justr0st/TempCtl-Duo/claude/tempctl-duo-spec.md

# TempCtl Duo — specification and working notes

Status: 2026-09-28 (third revision — all design decisions made). The first revision was written at the
end of the conversation that built TempCtl 1.2. Revisions 2–3 add everything agreed with Rost in a
claude.ai chat: the Duo goals and program model (9), the hardware — ESP32-S3 + 4.0" ST7796 as main
target and the CYD as second device (2, 2a, 2b), colours (6), the Web-GUI based on the 9.3 simulator
(7, `claude/web-sim/`), serial console (7a) and the Web Serial page / local app (7b). Every open point
was decided one by one; what is left is only for later (GitHub Pages — replaced by Cloudflare, 7b / 9.13 —,
SD logging, "Convert to Timeline") and hardware checks during bring-up (9.10).
2026-09-30: **steps 1–4 of 9.10 implemented** (S3 bring-up, per-board headers, three CYD variants,
identity; channel interface, two Modbus channels on one bus, `/duo/settings.json`; local channels
with thermocouple, SSR, PID and safety; autotune). All four envs compile and link in the cloud container.
Commits (Rost pushes): `7c34d2e` 1.0.0 = steps 1–3, then 1.0.1 = step 4. State: 9.10.1–9.10.4. **The 4" display
and the PMA controller are still being delivered** (Rost): their checks are deferred until each part
arrives; meanwhile test what the bare S3 board and the CYD allow. Next: step 5 (program types
Sequence + Timeline, one run engine for both channels).

Read this file first, then `README.md` (TempCtl hardware, wiring, PMA register background, build, web
API) and `ui/README.md`. Sections 3–8 describe the **TempCtl 1.2 code base that Duo starts from**; the
parts that change for Duo are marked "Duo:".

## 0. Isolation rules (read first)

TempCtl Duo is a copy of TempCtl (made 2026-09-28 from TempCtl commit `47995c9`, first own commit
`7c15cd0` "Start TempCtl Duo as a copy of TempCtl"). The original must stay untouched.

| | TempCtl (original — do not touch) | TempCtl Duo (work here) |
|---|---|---|
| Local clone on Rost's PC | `D:\Share\GitHub\TempCtl` | `D:\Share\GitHub\TempCtl-Duo` |
| In the Cowork device VM | `$HOME/mnt/Share/GitHub/TempCtl` | `$HOME/mnt/Share/GitHub/TempCtl-Duo` |
| GitHub | `justr0st/TempCtl` | `justr0st/TempCtl-Duo` (origin is set; Rost creates the empty repo and pushes) |
| Claude project notes | `claude/tempctl-firmware-notes.md` (original's history) | this file (+ copy `claude/tempctl-duo-spec.md` in the project) |

- Only read, edit, build-check and commit inside `TempCtl-Duo`. Never write to `TempCtl`, never commit
  there, never change its remote.
- Before any file transfer, check the target path contains `TempCtl-Duo`.
- Temporary transfer archives go to `D:\Share\claude-xfer-duo-*.tgz` and are deleted afterwards.
- Firmware name/version: `src/config.h` still says `FW_VERSION "1.2.0"` and the device calls itself
  "TempCtl" (web page title, AP name `TempCtl-XXXX`, host name `tempctl`). **Identity and versioning
  are decided (9.8)**: "TempCtl Duo", host `tempctl-duo`, AP `TempCtl-Duo-XXXX`, version starts at
  **1.0.0** and the patch number goes up with every commit that is pushed.

## 1. Working with Rost (user preferences and environment)

- User: Rost (GitHub `justr0st`, commit email `50486502+justr0st@users.noreply.github.com`).
- Answers short and direct; Rost usually tests on hardware and reports back ("works", a log, a photo).
- Ask before large design decisions (AskUserQuestion); otherwise make the reasonable choice and say so.
- Commit only when Rost asks. Commit messages: mention only the most significant changes. Leave
  `.vscode/settings.json` (his local editor settings) out unless he says otherwise. Rost pushes.
- This document (`claude/tempctl-duo-spec.md` in the repo) is the source of truth, updated with every commit
  (`docs/SPEC.md` only points to it). The claude.ai project copy is no longer updated (since 2026-11-02).
  Old untracked files go to `.old/` (ignored).
- Rost runs the LVGL Pro Editor and the GitHub side (secrets, Pages settings) himself.

### Tools and file handling (since 2026-11-02: Claude Code on Rost's PC)
Until 1.0.66 Claude worked from claude.ai through the Cowork device VM and a cloud container (file transfer
by tgz, `GIT_OPTIONAL_LOCKS=0`, no serial port, no `pio`). Since 2026-11-02 Claude Code runs directly on
Rost's Windows PC in the clone `D:\Share\GitHub\TempCtl-Duo`; the project instructions are in `CLAUDE.md`.
- Files are edited in place; `.gitattributes` (1.0.29) stores LF and checks out CRLF — no conversions.
- Firmware: PlatformIO on Windows (`pio run -e <env>`, section 8). Linux-only tools run in WSL (Debian).
- Serial ports on Rost's PC: S3 "UART" port (flash + log) COM4, S3 native "USB" port (serial console, `api`
  mode) COM9, CYD COM11 (`upload_port` / `monitor_port` in `platformio.ini`). **Flashing and the log monitor go
  through the board's USB port labelled "UART"** (USB-to-UART bridge → UART0). Claude may flash
  (`pio run -e <env> -t upload`) after asking Rost each time (Rost, 2026-11-02).
- Reading a log: not the interactive monitor, but a short pyserial script (PlatformIO's `penv`) with a time
  limit, port opened with DTR and RTS off (no CYD reset). Rost's monitor has `esp32_exception_decoder`;
  a backtrace from a script: `xtensa-*-elf-addr2line -pfiaC -e .pio/build/<env>/firmware.elf <addresses>`
  (the ELF must be the flashed build).
- The in-app browser may be used for web pages (design references, datasheets, the release page).

## 2. What the device is

TempCtl (the original) runs on an ESP32-2432S028R "Cheap Yellow Display" (ESP32, ILI9341 320×240,
XPT2046 resistive touch, RS485 on UART2 RX 35 / TX 22 / DE+RE 27). **Duo supports two boards**
(Rost, 2026-09-28): the new **ESP32-S3 board (main target)** below, and the **CYD as a second supported
device** (section 2b). Main target:

| Part | Duo hardware |
|---|---|
| MCU board | **ESP32-S3-DevKitC-1 v1.0, N16R8** (ESP32-S3-WROOM-1-N16R8: 16 MB quad flash, 8 MB octal PSRAM). v1.0 = on-board WS2812 on **GPIO48** (v1.1 has it on GPIO38). Rost believes his board is v1.0; **work on the assumption WS2812 = GPIO48** until he has tested it with `neopixelWrite(48, 0, 0, 40)` (blue = v1.0). |
| Display | **4.0" capacitive SPI module MSP4031** (lcdwiki "4.0inch Capacitive SPI Module ST7796"): ST7796S, 320×480 (used as 480×320 landscape, confirmed), 4-wire SPI, on-board level shifters (3.3 V logic OK), VCC 5 V recommended (backlight ≈ 103 mA), micro-SD slot on the same SPI bus, 14-pin header. |
| Touch | **FT6336U** capacitive controller on the display module, I²C (address 0x38), with CTP_RST and CTP_INT. |
| Bus | RS485 transceiver on UART1, **3.3 V part** (MAX3485 / SP3485); a 5 V MAX485 module would put 5 V on the RX pin. |
| Local channels | Thermocouple amplifiers **MAX31855** (preferred: fault bits, cold-junction readout) **or MAX6675** (selectable per channel), SSRs driven from GPIO through an NPN/logic MOSFET from 5 V. |

- Duo controls **two heaters of a BGA rework station: bottom (preheater underneath) and top**.
- Each channel is either a **Modbus RTU controller** (PMA KS 40-1 / 41-1 / 42-1 or generic register map;
  the controller does the PID, the ESP32 is the ramp/soak programmer) or a **local channel**
  (thermocouple + SSR, PID on the ESP32). See 9.
- Touch UI (LVGL 9.6) and a web UI (JSON API) with the same functions ("full parity").
- Example program for the BGA use case: "GPU desolder (LeadFree)" — 160 °C (ramp 60 s, hold 30 s),
  190 °C (40/40), 225 °C (30/20), 245 °C (20/40), total 4:40 (`programExample()` in
  `src/program_store.cpp`). Duo: three two-channel examples (9.9).

## 2a. Pinout (ESP32-S3-DevKitC-1 v1.0 N16R8) — agreed 2026-09-28

Unusable / kept free:
- **GPIO 35, 36, 37**: used by the octal PSRAM on N16R8 (not available).
- **GPIO 19 / 20** (native USB D−/D+ — the **control port**, 7a/7b) and **43 / 44** (UART0,
  USB-to-UART bridge port — flashing and log): kept free so
  **both USB ports stay usable** (Rost's requirement).
- **Strapping pins 0, 45, 46**: not used (GPIO45 high at boot selects 1.8 V flash voltage). GPIO 3 (strap
  only for the JTAG source when an eFuse selects it, not on these modules) is the monitor channel's CS
  since 1.0.60 (9.15).
- GPIO 26–32: flash/PSRAM, not on the headers.

| Function | GPIO | Header | Notes |
|---|---|---|---|
| Display SCK | 12 | J1 | FSPI IO_MUX pins (10–13) → high SPI clock possible |
| Display SDI (MOSI) | 11 | J1 | |
| Display SDO (MISO) | 13 | J1 | shared with the SD card |
| LCD_CS | 10 | J1 | |
| LCD_RS (D/C) | 9 | J1 | |
| LCD_RST | 14 | J1 | |
| LED (backlight) | 8 | J1 | LEDC PWM, dimming |
| SD_CS | 18 | J1 | driven high (card deselected); SD use optional (logs) |
| CTP_SDA | 16 | J1 | I²C 400 kHz |
| CTP_SCL | 15 | J1 | |
| CTP_RST | 17 | J1 | |
| CTP_INT | 7 | J1 | optional (skip I²C reads when not touched) |
| RS485 TX → DI | 1 | J3 | UART1 |
| RS485 RX ← RO | 2 | J3 | |
| RS485 DE + /RE | 42 | J3 | |
| Thermocouple SCK | 41 | J3 | own slow SPI bus (not the display bus) |
| Thermocouple SO (MISO) | 40 | J3 | |
| TC CS bottom | 39 | J3 | 10 kΩ pull-up |
| TC CS top | 38 | J3 | 10 kΩ pull-up; **on a v1.1 board swap 38 ↔ 48** |
| SSR bottom | 21 | J3 | 10 kΩ pull-down (off during reset/flash) |
| SSR top | 47 | J3 | 10 kΩ pull-down |
| Status LED (on-board WS2812) | 48 | — | status colours, see below |
| SSR supply relay | 4 | J1 | +5 V common of both SSR inputs; active-high DC SSR driven directly (1.0.38) |
| E-stop input | 5 | J1 | NC contact to GND, internal pull-up; `safety.estop`, off by default (1.0.38) |
| Alarm buzzer | 6 | J1 | LEDC channel 6, 2.7 kHz; `safety.sound` (1.0.38) |
| TC CS monitor channel | 3 | J1-13 | optional third converter, 10 kΩ pull-up; measured only (1.0.60, 9.15) |

**Status LED (decided)**: green = idle · blue = running · amber blinking = waiting for bottom / program
pause / action required · red blinking = fault · purple = AP mode. Priority when several apply: fault >
amber > purple > blue > green. Low brightness (≈ 20 %). **CYD: the on-board RGB LED (external WS2812 on IO17 in `cyd-2xlocal-2x485`) with the same
colours** (Rost, 2026-09-29; replaces "blue LED only"): PWM on LEDC channels 1–3, active low.

Wiring picture: `claude/wiring/s3-wiring.png` (2026-09-30; display pins drawn in J1 order, VCC on 5 V;
1.0.38: relay / E-stop / buzzer on J1-4/5/6 as net labels, SSR "+" inputs on "5V relay"). Generator:
`/home/claude/wire/gen_s3.py` (cloud only; render with `node shot.js <svg>`).
**SSR supply relay (decided 2026-10-13, Rost): only an active-high DC solid-state relay driven directly by
GPIO4** (input + = GPIO4, − = GND; output 5 V → OUT+, OUT− → both SSR "+" inputs; input ≤ 20 mA at 3.3 V,
output ≥ 0.5 A DC). No relay modules, no level setting, no optional (DNP) parts: the relay-variant sheet
`s3-relay-wiring.png`, `relay.activeLow` (settings, touch, serial, web) and the RGND / E-stop RC options
were removed. GPIO4 is an output, low, from `localCtrlEarlyInit()`.
Setting `safety.relay` (decided 2026-10-13, Rost; default on): a switch in web Settings › Safety (the note
block on the Channels page was removed), touch System, serial `safety.relay`. Off = no relay fitted: GPIO4
stays low, no relay state in live / info, no "SSR supply relay off" events (`localCtrlRelayEnable`,
`localCtrlRelayUsed`).
Schematic (2026-10-13): `hardware/s3-schematic/` — KiCad 7 project (A3, one sheet: DevKitC-1 with J1/J3 pin
numbers, display, RS485 + PMA terminals (RGND not connected), 2 × MAX31855 + CS pull-ups, 2 × BC337 SSR
drivers + SSRs, K1 DC SSR supply relay, E-stop SW1, buzzer BZ1 with R7 100 Ω), net labels between the
blocks, PDF / PNG. Written by a Python generator (`hardware/gen/`: no KiCad in the cloud — hand-written KiCad 7
file format, checked by reading it back with `verify.py`; ERC to be run in KiCad by Rost).
CYD schematics (2026-10-13): `hardware/cyd-schematic/` — one KiCad project per env (`TempCtl-Duo-CYD-A/B/C`
= `cyd-1xlocal-1x485` / `cyd-2xlocal` / `cyd-2xlocal-2x485`), same generator (`hardware/gen/make.py`). The
CYD is one symbol with its connectors (pin numbers P3-n, CN1-n, SD-n via the micro-SD breakout, P4-n, P1-n,
LED-R/G/B pads on C); RS485 + PMA (A, C), MAX31855s (C: 10 k pull-up on the IO4 CS), BC337 SSR drivers, SSR
+ inputs on 5 V from P1-1 VIN, speaker LS1 on P4 (all), WS2812 status LED on IO17 from 3V3 (C). No E-stop,
no supply relay. The CYD wiring pictures show the P4 speaker too.
Display on J1, all process I/O on J3 (separate cable bundles). All pins become `#define`s in the
per-board header (`src/board_s3.h`, section 3) — one place to change for a v1.1 board or a different
wiring.

## 2b. Second supported device: CYD (ESP32-2432S028R) — agreed 2026-09-28

The CYD stays supported with the same firmware features (two channels, both program types, web GUI),
built from the same sources with its own envs `cyd-1xlocal-1x485` / `cyd-2xlocal` / `cyd-2xlocal-2x485` (below).

- ESP32 (no PSRAM, 4 MB flash, ≈ 520 kB SRAM), ILI9341 **320×240**, XPT2046 **resistive** touch, RGB
  LED (active low: R 4, G 16, B 17), backlight GPIO21, SD slot on VSPI (CS 5, SCK 18, MISO 19,
  MOSI 23), RS485 unchanged: RX 35, TX 22, DE/RE 27 (UART2).
- **Free GPIOs** (checked 2026-09-29 against the schematic ESP32-2432S028 V0.1 and the
  randomnerdtutorials CYD pinout): connectors P3 = GND, IO35 (input only), IO22, IO21 (backlight, not
  usable); CN1 = GND, IO22, IO27 (10 k pull-up R18), 3V3 (IO22 on CN1 pin 3 is missing in schematic
  V0.1 but present on the board — checked by Rost); P1 = VIN, IO1/IO3 (UART0, shared with the
  CH340). **IO6–IO11 are not usable**: they are the WROOM-32 module's internal SPI flash; the empty U4
  footprint on the CYD is only an optional second flash chip on the same lines. **Only IO22, IO27, IO35 are free on connectors — RS485 uses all three.** Taken: IO0 BOOT
  button, IO4/16/17 RGB LED (status), IO26 speaker amplifier (SC8002B, P4), IO34 LDR, display
  2/12/13/14/15 (LCD reset = EN), touch 25/32/33/36/39, IO21 backlight (AO3402, pull-down). The SD slot
  pins IO5/18/19/23 are free (SD not used), reachable with a micro-SD breakout ("sniffer") adapter;
  they have 10 k pull-ups (R13, RN2) except IO18 (CLK) per the schematic — to be measured.
- **Three CYD variants, one env each (decided by Rost, 2026-09-29)** — the RGB LED is the status LED,
  so the old SSR pins 4/16 are gone, and there are too few pins for RS485 + two local channels.
  Pins fixed at compile time in `board_cyd.h` (`-D CYD_1XLOCAL_1X485` / `-D CYD_2XLOCAL` /
  `-D CYD_2XLOCAL_2X485`, with
  `HAS_RS485`, `LOCAL_CHANNELS_MAX`, `BOARD_VARIANT`); pictures `claude/wiring/cyd-wiring-a.png` / `-b.png` / `-c.png`:

  | Env | Channels | Pins |
  |---|---|---|
  | `cyd-1xlocal-1x485` (wiring A, Rost's preferred) | RS485 (one or two Modbus controllers on the bus) + **one** local channel, bottom or top | RS485 TX 22 (P3-2), RX 35 (P3-3), DE+/RE 27 (CN1-2); TC SCK 23, SO 19, CS 5 (`PIN_TC_CS_LOCAL`); SSR 18 (`PIN_SSR_LOCAL`) — SD slot pins |
  | `cyd-2xlocal` (wiring B) | two local channels, **no RS485** (Modbus not selectable) | TC SCK 23, SO 19; bottom CS 5 / SSR 18 (SD slot); top CS 27 (CN1-2) / SSR 22 (P3-2); IO35 free (input) |
  | `cyd-2xlocal-2x485` (wiring C, added 2026-09-29) | RS485 + two local channels — every channel local or Modbus. **On-board RGB LED removed** (frees IO4/16/17) | RS485 as in wiring A; TC SCK 23, SO 19; bottom CS 5 / SSR 18; top CS 4 (LED pad R, **external 10 k pull-up**, floating at boot) / SSR 16 (LED pad G); **status LED = external WS2812 on IO17** (LED pad B, powered from 3V3 so the 3.3 V data level is in spec) |

  SD slot pins through a micro-SD breakout adapter, no card inserted. IO18 has no pull-up (SSR off at
  boot); IO5/IO23/IO19 have 10 k pull-ups (fine for CS / SCK / SO); IO27's pull-up keeps CS high.
  Settings (step 2/3) must refuse channel types the variant can't wire (more local channels than
  `LOCAL_CHANNELS_MAX`, Modbus without `HAS_RS485`). The step-1 firmware of `cyd-2xlocal` still has the
  single-channel Modbus code: without RS485 every request fails at once ("no answer", LED red).
- Limits to respect: no PSRAM → chart history, web page buffers and LVGL buffers must fit in internal
  RAM (TempCtl 1.2 left 97 kB free with one channel; measure after adding the second channel);
  `huge_app.csv` (3 MB app) — the web page and fonts must fit next to the firmware.
- Touch UI: its **own set of 320×240 screens** next to the 480×320 set (see 6).

## 3. Build and toolchain

TempCtl 1.2 (current state of the Duo repo):
- PlatformIO, `espressif32@6.9.0` (Arduino-ESP32 2.0.17), board `esp32dev`, `huge_app.csv`
  partitions, env `cyd`.
- Libraries: `lvgl/lvgl@9.6.0`, `symlink://ui` (the exported UI code as a library, `ui/library.json`),
  TFT_eSPI 2.5.43 (configured by build flags), XPT2046_Touchscreen (git), ArduinoJson 7.
- Build flags: `-D LV_CONF_INCLUDE_SIMPLE -D LV_LVGL_H_INCLUDE_SIMPLE -I include`,
  `-D DISABLE_ALL_LIBRARY_WARNINGS=1` (TFT_eSPI TOUCH_CS warning), TFT pins/frequencies.
- `include/lv_conf.h`: from the LVGL 9.6 template; CLIB malloc/string/sprintf, 30 ms refresh,
  `LV_USE_OBJ_NAME`, `LV_USE_TRANSLATION`, printf log, dark default theme without grow, Montserrat
  12 + 14, asserts on with `include/lv_assert_custom.h` (`LV_ASSERT_HANDLER abort();` instead of
  LVGL's silent `while(1)`).
- `src/main.cpp`: loop task stack 16 kB on both boards since 1.0.55 (S3 was 24; `SET_LOOP_TASK_STACK_SIZE`), after setup
  `esp_task_wdt_init(15, true)` + `enableLoopWDT()` (a stuck loop restarts the board with a backtrace;
  the longest intended wait in the loop is a 5 s bus request from the touch UI).
- Measured on the CYD (1.2 on LVGL 9.6): flash ≈ 1.36 MB (before the web redesign, which
  added ≈ 17 kB); free heap 249 kB before UI, 158 kB after UI,
  97 kB after net/web/control (largest block 51 kB); loop stack ≈ 3 kB used in setup.

**Duo: planned build changes** (decided unless noted):
- New env `s3`: board `esp32-s3-devkitc-1`, stay on `espressif32@6.9.0` / Arduino 2.0.17 (same core as
  TempCtl), `board_build.arduino.memory_type = qio_opi`, `board_build.flash_size = 16MB`,
  `board_upload.flash_size = 16MB`, a 16 MB partition table (e.g. `default_16MB.csv` or a custom one
  with a larger LittleFS), `-D BOARD_HAS_PSRAM`.
- **CYD envs `cyd-1xlocal-1x485`, `cyd-2xlocal`, `cyd-2xlocal-2x485`** (2b; replace env `cyd`, share the section `[cyd]`
  in `platformio.ini`; the CYD is a second supported device). Board differences live in
  per-board headers (**decided**: `src/board_s3.h`, `src/board_cyd.h`, selected by the build flag
  `-D BOARD_S3` / `-D BOARD_CYD` in the env) — pins, display/touch driver, resolution, LED type, memory sizes;
  the rest of the code is shared.
- Upload and log monitor (decided): the **"UART" USB port** (USB-to-UART bridge, auto-reset via
  DTR/RTS). `ARDUINO_USB_CDC_ON_BOOT=0` → `Serial` = UART0 (GPIO 43/44), log + exception decoder.
- **Control port on the S3 = the native "USB" port** (Rost, 2026-09-28): the serial console (7a) and
  the Web Serial page (7b) use it, so opening it never resets the board. **Decided**: USB-OTG mode with
  TinyUSB CDC (`ARDUINO_USB_MODE=0`, `USBSerial` / `USBCDC`) and **`enableReboot(false)`**, so no
  DTR/RTS pattern or 1200-baud touch can restart the chip; flashing stays on the UART port. (The default
  USB Serial/JTAG mode can itself reset the chip on certain DTR/RTS states — avoid it for this port;
  verify on hardware.)
- **Drivers per board** (decided): S3 — display through LVGL's ST7796 driver (below), touch through
  our own FT6336U driver. CYD — display through **LVGL's ILI9341 driver** with the same SPI/DMA glue
  (so TFT_eSPI can be removed from both envs), touch keeps **XPT2046_Touchscreen** (resistive, with the
  existing calibration/mapping).
- **S3: no TFT_eSPI / XPT2046.** Display through **LVGL's own ST7796 driver**
  (`LV_USE_ST7796`, `lv_st7796_create()` with send-cmd / send-color callbacks on the ESP-IDF
  `spi_master` with DMA; `lv_display_flush_ready()` from the post-transaction callback; RGB565 byte swap
  with `lv_draw_sw_rgb565_swap()`; rotation via `lv_display_set_rotation()` → MADCTL).
  Draw buffers in internal DMA-capable RAM; large allocations (LVGL heap, chart history) may go to PSRAM.
- **Touch: own FT6336U driver** (Rost chose this, not a third-party library). LVGL has no built-in
  driver for I²C touch controllers on MCUs — only the `lv_indev` read callback. Plan
  (`src/touch_ft6336.*`, ≈ 40 lines + indev glue): reset pulse on CTP_RST (low ≥ 5 ms, then wait
  ≈ 300 ms), `Wire` on SDA 16 / SCL 15 at 400 kHz, read registers 0x02–0x06 in one transfer
  (0x02 TD_STATUS low nibble = touch count; 0x03 P1_XH bits 7:6 event flag, bits 3:0 X[11:8];
  0x04 P1_XL; 0x05 P1_YH bits 3:0 Y[11:8]; 0x06 P1_YL), map coordinates to the display rotation,
  optional CTP_INT to skip reads when not touched, **any I²C error → report "released"** (no stuck
  presses). Verify register details against the FT6336U datasheet / register table on lcdwiki.
- Verification toolchain in the cloud container must change to **xtensa-esp32s3** gcc + the S3 variant
  of arduino-esp32 2.0.17 (section 8).

## 4. Source layout (TempCtl 1.2 base)

| File | Role |
|---|---|
| `src/config.h` | pins, FW_VERSION, chart size (CHART_N 300, 1 s live samples) |
| `src/modbus_frame.h`, `modbus_rtu.*` | RTU framing/CRC, half-duplex bus with DE pin |
| `src/controller.*` | register access via the RegMap, value flags (sensor errors, off value) |
| `src/program.*` | pure C++ ramp/soak engine (`ProgramEngine`), host-testable |
| `src/program_store.*` | LittleFS `/progN.bin` (N = 0..9), header magic "PRG1", name 24 bytes |
| `src/settings.*` | `Settings` struct in NVS (namespace `tempctl`, key `cfg`), **version 4**; v3 and v2 migrated |
| `src/app_state.*` | shared state (`gSettings`, `gLive`, `gHist`, `gPrograms`, lock `Guard`), control task on core 0 (Modbus + engine, command queue `sendCmd`, `busRequest` for Tools) |
| `src/net.*` | Wi-Fi STA with AP fallback after 20 s, mDNS, asynchronous scan for the touch UI |
| `src/web.*`, `web_page.h` | WebServer + JSON API; single-page UI in PROGMEM |
| `src/ui.*` | touch UI logic (LVGL), binds to the exported widgets by name |
| `src/ui_gen.c/.h` | C bridge to the exported UI code (see 6) |
| `ui/` | LVGL Pro Editor project (XML) + exported C (`*_gen.c/.h`, `tempctl_ui*.c/.h`, `fonts/*_data.c`) |
| `test/host_test.cpp` | host tests for CRC and the engine: `g++ -std=c++17 -I../src host_test.cpp ../src/program.cpp` |

Data model: 10 programs × 100 steps; step = target (°C, float), rampSec, holdSec (uint32, max
9999 min); name ≤ 23 chars (`PROG_NAME_LEN` 24 is part of the file header). Run states
Idle/Running/Paused/Finished/Aborted ("stopped" in the API), phases Ramp/Hold.

Duo: new files planned — `src/channel.*` (channel interface + Modbus and local backends),
`src/tc_sensor.*` (MAX31855/MAX6675), `src/pid.*` + `src/autotune.*` (host-testable like
`program.cpp`), `src/board_s3.h` / `src/board_cyd.h`, `src/touch_ft6336.*` (S3), display glue for
ST7796 (S3) and ILI9341 (CYD), `src/console.*` (serial console + `api` mode, 7a/7b). `app_state` gets two channels and the
two-channel run engine (9.3).

## 5. Behaviour (TempCtl 1.2, per channel in Duo)

- **Program run**: the first ramp starts at the PV measured at start. Ramp mode "ESP32 writes setpoint
  steps" (min. step and min. seconds between writes, to spare the PMA EEPROM) or "controller ramps"
  (writes target + r.SP gradient). Optional guaranteed soak (hold time counts only inside ±band) —
  **removed in Duo** (9.3). End/stop action: keep SP, set end SP, or outputs off (C.Off). Front panel lock while running
  (L-R). Pause after link loss (s). Setpoint limits spMin/spMax.
  Duo: phases and timing follow 9.3; the Modbus-only options (ramp mode, C.Off, L-R) apply to Modbus
  channels; a local channel always
  follows the engine's setpoint directly (its PID gets the SP every cycle) and "outputs off" = SSR off.
- **Manual setpoint**: on/off switch. On = write SP and switch the outputs on (C.Off = 0); off =
  outputs off (C.Off = 1). Starting a program ends manual mode. Duo: one per channel, and a run ends
  manual mode only on channels that have phases/steps in the program (9.4).
- **Chart**: idle = rolling 5-min window, PV scrolls right-to-left, the selected program is shown
  dashed as a preview on its own time scale across the full width. Running = fixed axis over program
  total + max(10 %, 30 s); plan and PV grow from the left. Solid = active, dashed = not active. Series
  order PV, SP, program (LVGL draws the first series last → PV on top). Duo: two channels on one chart
  and one plan curve per channel (layout open, 9.7).
- **Step times** are stored in seconds; editors offer min or s per value.
- **Web UI parity**: Status (Main), Programs, System, Controller, Tools on both UIs.
- PMA KS 4x-1 register defaults ("1dP" column, value = register/10, DP1 offset in `settings.cpp`):
  PV 13294, SP.EF 13293, Ypid 13295, St.Cntr 5100, St.Ala 250, SP 11372, SP.LO 11292, SP.Hi 11293,
  r.SP 11295, C.Off 1086, L-R 1080; read fn 3, write fn 6, off raw −32000.

## 6. Touch UI (LVGL 9.6 + LVGL Pro Editor)

> **Changed 2026-10-02 (Rost, step 6): the new screens are hand-written LVGL C code** (`src/tui_*.cpp`),
> not LVGL Pro XML — the exporter can't run in the cloud, and C is leaner (helps the CYD's RAM). Previews
> are rendered on the PC (`test/ui_host`) for Rost's review. Order: **S3 first** (done in 1.0.19), then the
> lean 320×240 set for the CYD (done in 1.0.21; the exported TempCtl 1.2 screens below are no longer built,
> and **removed in 1.0.28**: `ui/`, `src/ui.cpp`, `src/ui_gen.*`, `src/program.*` — the text below about
> them is history).
> Look = the web page (Barlow / Barlow Semi Condensed via `tools/lv_font_gen.py`, the web palette, accent-
> derived channel colours, dark / light from the touch setting). The rest of this section describes the
> old exported UI (still used on the CYD).

- LVGL 9.5+ has no open-source XML loader; the UI is **C code exported by LVGL Pro Editor** from the
  XML in `ui/` ("Export C code", `project.xml` `lvgl_version="9.5.0"` — the editor offers at most 9.5;
  the export compiles fine with 9.6). XML and exported files are committed together. After XML changes
  Rost exports; simple string/number changes may be patched in both XML and `*_gen.c` by hand (a
  re-export produces the same).
- Duo: **two sets of screens** (Rost, 2026-09-28) — 480×320 (S3) and 320×240 (CYD, second supported
  device), as separate XML screens in the LVGL Pro project that share components, styles, fonts,
  translations and **the same widget names**, so `ui.cpp` binds to either set without changes (a widget
  that exists only in one set is looked up optionally). The build includes only the set of its board
  (per-board source filter or a flag in `ui_gen.c`), so the CYD doesn't carry the 480×320 screens.
  During hardware bring-up the old 320×240 UI may simply run in a corner of the 480×320 screen.
- `ui.cpp` must **not include the generated headers** (they pull `lvgl_private.h`, whose FT81x macros
  like `CMD_START` clash with `CmdType`). `src/ui_gen.c` includes them and forwards: `uiGenInit()`
  (fonts + `tempctl_ui_init("")` + palette, returns the permanent screen `gui`), popup create wrappers
  (`uiGenDialog/NumEditor/TextEditor/WifiList/WifiItem`), colours/palettes. A new component used from
  C needs a wrapper there.
- Fonts: `font_12/14/20/24/32/48` (Roboto / Roboto Slab, ranges incl. German, Cyrillic and °), `fontM_*`
  (Montserrat Medium), `font_icons_14` (Font Awesome). Exported font data is const (flash), so
  `UI_FONT_WITH_FALLBACK` makes RAM copies with LVGL's Montserrat as fallback (symbols) before init.
- Texts: all in `ui/translations.xml` ("en" only), `translation_tag` in XML, `T(tag)` / `trf(buf, n,
  tag, a1, a2, a3)` with `%1..%3` in C. Never braces in XML attribute values (the editor treats `{…}` as
  an expression). An empty text must be `" "` (the export turns `""` into "missing" → the tag shows).
- Widgets are found **by name** (`main_*`, `prog_*`, `chart*`, `sys_*`, `ctl_*`, popup names
  `num_*`, `text_*`, `dlg_*`, `scan_title/scan_list/scan_spinner/scan_cancel`, `wifi_item`); event
  handlers are attached in C (`UI_EVENTS`), none in XML. Popups are created on `lv_layer_top()` each time
  they open.
- **Colours — TempCtl 1.2 base**: 6 palettes (Default, Dracula, Solarized, Gruvbox, Catppuccin, One)
  × dark/light, stored in Settings (`themePalette`, `themeDark`); `color_*` in `ui/globals.xml` =
  Default dark = the editor preview, the others are constants `<palette>_<dark|light>_<role>` (14 roles:
  bg panel border text muted accent accent2 row_selected danger pv sp plan ok warn); `src/ui_gen.c`
  builds them (`PAL()`, `paletteLoad()`, `PALETTE_NAMES`) and recolours the styles listed in
  `STYLE_COLORS`; `ui.cpp` `applyTheme()` re-inits the LVGL default theme and sets chart series and
  table colours. **Rule: widgets get colours only through named styles**, never `style_…_color` on the
  widget.
- **Duo: no colour palettes any more — only the accent colour is selectable** (Rost, 2026-09-28).
  - One fixed base palette (the `color_*` constants in `globals.xml`); remove the other palette
    constants, `PAL()`/`paletteLoad()`/`PALETTE_NAMES`, the palette dropdown in Setup › System and
    `themePalette` / `themes[]` in settings and API.
  - The user picks the **accent colour** (Setup › System and web System page); **stored as an RGB
    value** (`accentColor`, decided) — the UI offers the 6 presets now, and a free colour picker can be
    added later without a settings change. The channel colours are always computed from the stored RGB
    (split-complementary + contrast rule, below), so any accent works. Applying it: recolour the named styles that use the accent role
    (`style_text_accent`, `style_border_accent`, … — the `STYLE_COLORS` mechanism reduced to the accent
    role) and pass it as the primary colour to `lv_theme_default_init()`, so switch/slider indicators,
    checkboxes and focus outlines follow the accent too.
  - Channel colours: each channel has its own PV / SP / plan colour roles (e.g. `pv_b sp_b plan_b`,
    `pv_t sp_t plan_t`), all derived from the accent (below).
  - **Accent = preset list** of the 6 former palette accents (decided). **Channel PV colours are
    split-complementary to the accent (agreed 2026-09-28, replaces "PV = complement")**: bottom PV =
    accent hue − 150°, top PV = accent hue + 150°, same HSL saturation/lightness as the accent (base
    values before the per-theme contrast adjustment below), computed in C when the accent is applied
    and by the same rule in the web page:

    | Accent | Hex | Bottom PV | Top PV |
    |---|---|---|---|
    | Blue | 2196F3 | F3E721 (57°) | F3212D (357°) |
    | Pink | D1449B | 44D1C0 (173°) | 55D144 (113°) |
    | Violet | 6C71C4 | 9DC46C (87°) | C4936C (27°) |
    | Orange | D65D0E | 0E23D6 (234°) | 0ED6C1 (174°) |
    | Mauve | 8839EF | 45EF39 (116°) | EFE339 (56°) |
    | Green | 50A14F | A14F79 (329°) | 774FA1 (269°) |

    The PV/SP roles therefore become accent-driven (recolour the PV/SP named styles, chart series and
    table colours with the accent). Known closeness to status colours (Rost accepted it after seeing the
    samples): Blue → bottom yellow / top red, Pink → top green, Violet → top orange, Mauve → green /
    yellow; Orange and Green are clean. Check on hardware; status colours may be adjusted if it confuses.
  - **SP colours (agreed): same hue as the channel's PV, lighter** — one hue per channel.
  - **Light theme uses darker variants (agreed)** for readability. Rule (agreed; same code on device
    and web): keep the hue and saturation, darken the lightness until the colour reaches a minimum
    contrast against the panel colour — **PV ≥ 4.5:1, SP ≥ 3:1** (WCAG luminance ratio); SP starts
    0.12 lighter than its PV. On the dark theme a colour is only lightened if it is below the same
    minimums. Computed once when the accent or the theme changes.
  - **Theme (decided)**: the touch UI keeps a **Dark / Light setting** (Setup › System, stored in
    Settings). The web page **follows the system theme** by default and has its own Dark / Light / Auto
    switch that the browser remembers (localStorage) — it does not follow the device setting.
  - **The same palette drives the Web-GUI** (Rost, 2026-09-28): accent, PV and SP colours of both
    channels are identical on touch and web (the settings API delivers them; section 7).
  - The rule "colours only through named styles" stays.
- Wi-Fi scan: the list popup opens immediately with a spinner until `netScanResult()` is ready; Cancel
  works during the scan.
- LVGL Pro Editor gotchas: no `.woff` fonts (use `.ttf`); avoid `send_draw_task_events` / `update_mode`
  in XML (table draw events are set in C); scale numbers + labels in one component abort the preview →
  `label_show="false"` in XML, switched on in C; a component with a 100 % root needs
  `<previews><preview width height/>`; local style props with part selectors are ignored → named styles
  with `selector=`; `#` at the start of a text is read as a constant; the editor reformats files it saves.
- Known harmless logs: two "Deprecated: lv_obj_set_flag/remove_flag" warnings at boot (the 9.5-style
  export), "LittleFS … progN.bin does not exist" (LittleFS.exists() in core 2.0.x).

## 7. Web UI

- **Look (decided 2026-10-14, Rost; version 1.0.40): frosted glass after his NVBHarvester tool**, worked out on a
  concept page (claude.ai artifact "TempCtl Duo Glass Concept") and moved into `web/index.html` as one CSS block at
  the end of the style (`html:root …` rules = class specificity, no class needed: the device / launcher copies
  rewrite the exact `<html lang="en">` tag) plus a few scripts. Layout, Barlow, accent and channel colours stay.
  - Backdrop: mesh gradient tinted by the accent + SVG grain (fixed, painted once). Sidebar and panels: translucent
    glass, `backdrop-filter: blur(22px) saturate(1.25)`, 18 px radius; only these blur (controls on them are plain
    translucent fills). `prefers-reduced-transparency: reduce` → no blur. Buttons and fields: pills / 12 px.
  - Logo (new colours from `logo/TempCtl.svg`, Rost 2026-10-13: light blue square #86C9FF, gear #0062D3,
    thermometer #FF5555): `web/icons/logo.svg`, `favicon.ico` (16/32/48), `apple-touch-icon.png` (180, square);
    54 px in the sidebar, no frame, soft blue glow.
  - Title bar: stays on top; behind it a copy of the backdrop (blurred), faded out at its bottom edge; its opacity
    follows the scroll (`--tf`: 0 at the top of the page, 1 when the first card reaches the top).
  - Channel cards: the channel colour as a glowing strip on the top edge. The "Manual" switch on the cards looks
    like the sidebar's power button (CSS only; off glass, on channel colour).
  - Output on (manual or program, live `outOn`): the card turns into the channel colour — 20 % tint over the glass,
    4 px edge in the lit channel colour, soft glow, no top strip; back to normal when the output is off (Rost,
    2026-10-14).
  - The backdrop's lower-left gradient follows the accent in dark mode too (was a fixed teal).
  - Channel colours: same rule (split-complementary, 4.5:1), now against the frosted card colour (#E4EBEF light,
    #1A2329 dark). Extra "lit" colours `--vB` / `--vT` (same hue, full saturation, only 1.6:1 in light mode) for
    strips, glows, meters, the tab arc and the sidebar dots, so the yellow stays vivid in light mode; text and
    chart lines keep the contrast-fitted colour.
  - Channels page tabs: css-tip "rounded tab" shapes (`shapeTabs()`): first tab flush with the card's left edge
    (".left" variant), the others curve out into the card's top edge; the inactive tab tucks under the selected
    one's foot, its fill lighter (dark) / darker (light), the card's top line runs on under it. The selected tab
    and the card share one frosted background (`.tabbg`, clipped to the union of both shapes: no seam); outlines
    are 1 px paths on the card border's pixel grid; the card's top edge is open under the selected tab
    (`--g0` / `--g1`). Reshaped on tab change, resize, fonts ready and card size changes (ResizeObserver).
  - Dropdown lists: solid theme colour for the options (the translucent field colour made them light).
- **Chart: every reading (decided 2026-10-14, Rost; version 1.0.41)**: the web chart draws each PV reading of the
  polling (250 ms … 10 s) instead of the 1-s / per-bin slots, live view and run chart. Device (`src/raw_hist.h`,
  host-tested): per channel a ring of (millis, PV) pairs, 2 words each (32-bit access: the CYD keeps it in its IRAM
  heap), one entry per poll that brought a new value (`ChannelLive.lastOkMs` changed; two Modbus controllers are
  read in turns), a gap entry (PV −32768) when a channel has no valid reading. S3 2 MB PSRAM = 131 072 per channel
  (36 h at 1 s, 9 h at 250 ms), CYD 600 per channel (10 min at 1 s; allocated before the live history, which gets
  that much less of the IRAM heap). Run time against millis: `RunAnchors` (start, pause, continue, jumps; linear in
  between), sent with the run chart (`ra`, `rn`). `GET /api/raw?a0=&a1=&win=&max=` (binary, see README). Page:
  `rawPull()` each poll (only readings after the newest it has; the whole window again when the window grows, e.g.
  a longer live period), `applyRaw()` puts them on the chart (live: seconds before the chart's `ms`; run: run time
  from the anchors, after a finished run nothing), older than the first kept reading the slots as before. More
  points than pixels: per pixel column first / lowest / highest / last (`thin()`), so no peak is lost; zoomed in,
  every reading. Over USB (Web Serial) the slots as before. Touch chart unchanged (slots). Tested in the mock:
  12 h at 250 ms = 167 000 readings, 19 requests, 52 ms to place and draw.
  - Cost: about +5 kB gzipped page (70 kB); no RAM or CPU change on the device; the blur is GPU work in the
    browser.
- `src/web_page.h` (≈ 54 kB, one PROGMEM raw string `R"HTML(…)HTML"` — must not contain `)HTML"`).
  Self-contained (works in AP mode): inline CSS/JS/SVG icons, system fonts, always dark.
- Look (after MoldControl by servomold / HMI Project, iF Design 2025): dark panels, pale cyan controls
  (`--acc #9FD9D5`), yellow for the active step (`--hi #F3C335`); sidebar with the page tiles in one
  column (always visible ≥ 860 px, slide-in panel with a menu button on phones) and link status, network
  info, clock and log download in its footer; top bar with title and jump buttons to the cards.
- Status page: chart with step boxes above it (active phase yellow + time marker), run bar (program
  select, Start/Resume, Pause, Next phase, Stop) under the chart, facts row whose **state cell is
  coloured by state** (running green, paused yellow, finished cyan, stopped red, manual orange), right
  column PV / SP / output (level meter) / **manual setpoint tile (stepper + switch, dark orange while
  manual is on)**. In-page `ask()` dialogs instead of `confirm()`; boolean settings are switches.
- API (`src/web.cpp`): GET `/`, `/api/status`, `/api/history`, `/api/log.csv`, `/api/programs`,
  `/api/program?i=`, `/api/settings`, `/api/mb/read`, `/api/params`; POST `/api/program`, `/api/select`,
  `/api/manual`, `/api/cmd` (start/pause/resume/stop/skip), `/api/settings`, `/api/wifi`,
  `/api/mb/write`, `/api/mb/findsp`, `/api/params`, `/api/action`. Settings JSON includes
  `themePalette`, `themeDark`, `themes[]` (Duo: replaced by the accent colour, see 6).
- **Duo: new Web-GUI design — the 9.3 run simulator is the starting point** (Rost, 2026-09-28). The
  MoldControl look described above is the TempCtl 1.2 page; Duo's page takes over the simulator's
  look and structure instead: `claude/web-sim/tempctl-duo-93-sim.html` in the repo (copy of the
  published simulator, ≈ 81 kB, ≈ 24 kB gzipped).
  - Taken over: light/dark following the system setting (theme tokens on `:root`), panels on a calm
    background, Barlow / Barlow Semi Condensed with tabular numbers; run panel with the state badge,
    run clock and remaining time, Start / Pause-Continue / Stop / Next phase; the chart with the two
    state lanes, phase labels + end times, pause markers, forecast (dashed), drag handles (target /
    ramp end / hold end), zoom / scroll; channel cards (PV, SP, output bar, status line, target ±1/±5
    + Set, Extend hold +10 s/+30 s/+1 min, manual switch + SP for a channel without phases); program
    editor (sequence table / phone cards, two timeline tables), Save / Discard / Undo / Redo; the
    "Action required" overlay; event log; the save-after-run dialog.
  - Dropped (simulation only): speed selector, Reset, the thermal model, the forecast of PV, the
    "How this reads 9.3" notes. The forecast of the setpoints stays (computed from the program as in
    the firmware engine).
  - Must change for the device:
    - **Works without internet (AP mode)**: no Google Fonts — the Barlow fonts are served by the
      device (woff2 subsets from LittleFS/PROGMEM, gzip, long cache) with a system-font fallback.
    - Data from the JSON API instead of the in-page engine; edits are sent as commands (run edits go
      to the control task, 9.3.4). The browser keeps only view state (zoom, drafts until saved,
      undo/redo stack) — Save writes the program to the device.
    - Served gzipped (`Content-Encoding: gzip`). Size: no problem on the S3 (16 MB flash); on the
      **CYD** (3 MB app partition, no PSRAM) page + Barlow subsets (≈ 24 kB + fonts) must fit next to
      the firmware and be served from flash without large RAM buffers — measure.
    - The other pages (Programs list, Channels/Controller, System, Tools — full parity with the touch
      UI) are added in the same visual language.
  - **Navigation: sidebar as in TempCtl 1.2** (Rost): page tiles in one column, always visible
    ≥ 860 px, slide-in panel with a menu button on phones; link status, network info, clock and log
    download in its footer — restyled in the simulator's look.
  - **One colour palette for touch and web** (Rost): accent and the PV/SP colours of both channels
    come from the device's palette (section 6: accent preset, split-complementary PV colours, lighter SP, contrast rule per theme). The web
    page reads the palette from the settings API and sets its CSS colour tokens from it, so a change of
    the accent on either UI shows on both. The simulator's fixed bottom blue / top orange are only
    placeholders.
- Duo: the API gets a channel dimension (status/history per channel, `/api/manual` and the skip command
  with a channel, program type (Sequence/Timeline), Sequence phases (Bottom/Top/Both, bottom Idle, "wait for bottom") or
  Timeline step lists, run edits (extend hold, 9.3.4), channel settings,
  PID/autotune/calibration endpoints). `/api/select` stays one program for the run. Status page layout: 9.7.

## 7a. Serial console (Duo, requested by Rost 2026-09-28)

Control over the serial port, on both boards (**S3: the native "USB" port** — control only, the log
stays on the "UART" port; **CYD: its only USB serial**, shared with the log),
**115200 8N1** (decided; same as the monitor in `platformio.ini`). Scope: **manual temperature
control, Wi-Fi setup, help** (Rost); status is added because the manual commands need feedback.

**Behaviour (decided — all serial proposals accepted by Rost, 2026-09-28):**
- **On boot** the device prints a short banner (name, FW version, board) and the **help text**, then a
  prompt `> `, on the control port (S3: also a one-line banner on the UART log port). `help` prints it
  again. Because the S3's USB CDC port only exists once the host has opened it, the S3 also prints the
  banner + help when a terminal opens the port (DTR goes active) — so the user always sees it.
- Line based: a command ends with CR or LF; commands and keys are case-insensitive, values are not.
  The device echoes typed characters and handles Backspace, so it works in PlatformIO's monitor and
  in a plain terminal. Parameters are `key=value`; a value with spaces is quoted: `s="My Net"`.
- Log output shares the port: a log line that arrives while the user is typing is printed on its own
  line and the prompt with the typed text is shown again.
- **Passwords are never echoed, logged or printed**: the password prompt shows `*` per character; an
  empty password means an open network (station) / is rejected for an AP (WPA2 needs 8–63 chars).
  A `pw=` given on the command line is not echoed back either.
- The reader is non-blocking in the loop task; waiting for a Wi-Fi connection does not block the loop
  (watchdog 15 s) — the result is printed when it arrives. Commands use the same code paths as the
  touch UI and the web page (`net.*`, `sendCmd`), so all three stay consistent.
- Errors are one line starting with `error:` (unknown command, missing parameter, value out of the
  setpoint limits, channel is running a program, …).

**Commands:**

| Command | Result |
|---|---|
| `help` | the command list below |
| `status` | per channel: PV, SP, output %, state (idle / manual / program phase); run state; Wi-Fi state |
| `manual b on sp=180` · `manual t sp=200` · `manual b off` | manual setpoint per channel (`b` = bottom, `t` = top): `on` = write SP and switch the outputs on, `sp=` alone changes the SP (turns manual on if needed), `off` = outputs off. Same rules as the touch/web manual switch: not allowed for a channel that is part of the running program (`error: bottom is running a program`) |
| `wifi scan` | numbered list of networks, strongest first: `1  MyNet  -52 dBm  WPA2  ch 6`; the list is kept for `n=` |
| `wifi connect s=<SSID> [pw=<PASSWORD>]` · `wifi connect n=<number> [pw=<PASSWORD>]` | without `pw=` the device asks `Password:` (masked). Then `Connecting to "MyNet"…` and the result: `connected, IP 192.168.1.23, RSSI -55 dBm` or `failed: wrong password / network not found / timeout`. On success the credentials are saved like on the touch/web Wi-Fi page |
| `wifi ap=<AP SSID> [pw=<PASSWORD>]` | without `pw=` the device asks `Password:` (masked, 8–63 chars). Starts the access point and prints `AP "TempCtl-Duo" started, IP 192.168.4.1`; saved as the AP settings |
| `wifi status` | mode (station / AP / off), SSID, IP, RSSI |
| `programs` | numbered list of the stored programs with type (sequence / timeline) and total time; the selected one is marked |
| `program n=<number>` | select a program for the next run |
| `show` | the selected (or running) program printed read-only: phases / steps with their values. **No editing of the program over serial** (Rost) |
| `start` · `pause` · `resume` · `stop` | run control, as the run bar on touch / web |
| `next` | next phase (Sequence only; `error:` for a Timeline, where it is disabled) |
| `continue` | continue after a program pause ("Action required"); `stop` ends the run instead |
| `resume run` | resume from the interrupted phase after "Run interrupted by a reset" (9.3.5) |
| `extend b\|t +<s>` · `target b\|t <C>` | the run edits of the touch status screen: extend the current hold, change the current (or kept) target — same rules as 9.3.4 (not table editing) |

- **Run events are printed** as they happen: phase changes, "waiting for bottom", end of run, faults.
  A program pause with the "Action required" option prints a highlighted block
  (`*** ACTION REQUIRED — phase 2: Place the IR head — type "continue" or "stop" ***`, with the
  pause's custom text if it has one), repeated every 30 s.
- After a run with changes the device asks on all interfaces; over serial: `run changed the program —
  type "save" or "discard"`.

**Help text printed on boot (draft):**
```
TempCtl Duo 1.0.0 (esp32-s3) - serial commands:
  help                         this list
  status                       temperatures, setpoints, outputs, run and Wi-Fi state
  manual b|t on sp=<C>         manual setpoint on (b = bottom, t = top)
  manual b|t sp=<C>            change the manual setpoint
  manual b|t off               outputs off
  wifi scan                    list networks (numbered)
  wifi connect s=<SSID> [pw=<PASSWORD>]
  wifi connect n=<number> [pw=<PASSWORD>]
  wifi ap=<SSID> [pw=<PASSWORD>]   start an access point
  wifi status                  current Wi-Fi state
  programs | program n=<n> | show   list, select, show programs
  api on | api off              machine (JSON lines) mode for the web page (7b)
  start | pause | resume | stop | next | continue   run control
  extend b|t +<s> | target b|t <C>   extend the running hold, change a target
  resume run                   resume after "Run interrupted by a reset"
Without pw= the password is asked for (hidden).
```

**Program control over serial: agreed (Rost), editing of program tables: not over serial.**

## 7b. Desktop page without install — Web Serial (agreed 2026-09-28)

A **static web page, no installation** (Rost), working in **Chrome / Edge** on the desktop (the Web
Serial API is not available in Firefox / Safari). Delivered for now by a portable launcher that
contains a tiny `localhost` server (below) — nothing is installed and no separate server program is
needed.

- **Two ways to connect:**
  1. **IP**: the user enters the device's address (or `tempctl-duo.local`) and the page simply **opens
     the device's own Web-GUI** (`http://<address>/`, new tab or same tab). Nothing else — the device
     serves its page, so no API check is needed.
  2. **Serial (Web Serial API)**: the page itself shows **the same Web-GUI** (look and functions of
     the device page, section 7) and talks to the device over the serial port. Only this path needs the
     **API compatibility check**.
- **One GUI source**: the device page and the serial page are built from the same source; all API
  access goes through one small JS transport layer (`fetch` on the device, serial JSON lines here).
- **How the page is delivered** — Web Serial needs a secure context: https, or `http://localhost`.
  **Now: the local app (2). GitHub Pages (1) is a planned feature for later** (Rost, 2026-09-28) —
  keep the page buildable as plain static files so it can be published there without changes.
  1. **GitHub Pages** (https) — *planned, later*. GitHub Free: Pages only from **public** repositories; from a private
     repository it needs GitHub Pro (personal account) or Team/Enterprise, and even then **the published
     site itself is public** (only Enterprise Cloud can restrict access). Options: make `TempCtl-Duo`
     public, get Pro, or (proposal) publish only the built page from a small **separate public repo**
     (e.g. `justr0st/tempctl-duo-web`, updated by a script/Action from the firmware repo) while the
     firmware repo stays private. The page contains no secrets — access to a device still needs the
     local serial-port permission or the device's own address. Optionally cached for offline use.
     **Alternative: Cloudflare Pages** (asked 2026-10-13, not decided): free plan, its Git integration
     also builds from a **private** GitHub repo (or Direct Upload of the built folder with `wrangler`);
     build command `python3 tools/build_site.py <out>`. Same limit as GitHub Pages: an https page reaches
     a device only via Web Serial (the device's http API is mixed content).
     **Chosen (Rost, 2026-10-14; 1.0.45, b16a94b): Cloudflare Workers static assets** (the dashboard's "Create application"
     now leads to Workers; Pages only via a side link). `wrangler.jsonc` (name `tempctl-duo`, assets `dist/`),
     Workers Builds on push to `main`: build `python3 tools/build_site.py dist --web` (no shell.html, `_headers`:
     nosniff, no-referrer, DENY framing, Permissions-Policy serial=(self); `/f/*` cached a year), deploy
     `npx wrangler deploy` → `https://tempctl-duo.<account subdomain>.workers.dev`. No device search / tabs there.
     Live since 2026-10-14: https://tempctl-duo.just-r0st.workers.dev/ (checked: page = repo's index.html, connect screen,
     fonts load, headers as in `_headers`, HTML / icons revalidated, fonts cached a year, shell.html not deployed).
     Rost (2026-10-14): Web Serial from the hosted page works.
     **Since 1.0.52** deployed by GitHub Actions together with the release files (9.13); Workers Builds is switched off.
  2. **Local app, no installation** — *the delivery for now*. **Decided: one Go executable**
     (`tempctl-duo.exe`, ≈ 6 MB, Windows first; macOS/Linux builds possible from the same source) with
     the page files embedded (`embed`), serving them on **`http://localhost:8765`** (fixed) and opening
     Edge or Chrome as an app window; if the port is taken it tells the user (a second instance just
     opens the window). Built by a script in the repo from the same page files as the device page;
     carries the project version (9.8). In short: a small portable launcher (one file, no runtime needed) that serves
     the same page on **`http://localhost:<fixed port>`** and opens it in Chrome/Edge as an app window
     (`--app=`). localhost counts as a secure context, and the **fixed port** keeps the origin the same,
     so the granted serial port is remembered and automatic reconnect works. Built from the same page
     files as the Pages version. (Opening the page straight from a file, `file://`, is not reliable for
     Web Serial and its remembered permissions — not the recommended way.)
  - Serial permissions belong to the origin: the Pages version and the local app each ask once.
  - Opening the device's `http://` page from the https page is a plain navigation, so there is no
    mixed-content problem.

**Serial session:**
- **Connect** (button → browser port picker): open the port at 115200 8N1, then send **`api on`**. The
  device answers with a hello line: `{"t":"hello","api":1,"fw":"1.0.12","board":"s3","name":"…"}`. The
  page compares `api` with the versions it supports; if incompatible it says so (and which firmware /
  page version is needed) and does not control the device. Then it loads the full state (status,
  programs, settings, chart history) and follows the status/event stream.
- **Disconnect** (UI button): send **`api off`**, then close the port. The device returns to the human
  console (7a).
- **Automatic reconnect without touching the run**: if the cable is unplugged, the tab is closed or
  the browser crashes, **the device keeps running the program**; losing the serial client never changes
  the run. The page reopens a previously granted port automatically — on page load
  (`navigator.serial.getPorts()`, matching USB vendor/product id) and when the device is plugged in
  again (`navigator.serial` `connect` event) — sends `api on` again, re-reads the full state and continues
  where the run is now. An "Action required" pause or a pending "save run changes?" question is shown
  again after reconnecting.
- **Device side of `api` mode**: JSON lines, one object per line — requests with an `id`
  (`{"id":7,"m":"GET","p":"/api/status"}`), responses with the same `id`, pushed messages with a type
  (`status` ~1/s, `event`, `log`); the same endpoints and JSON as the HTTP API (7). Plain log output is
  wrapped as `{"t":"log",…}` while in api mode. If no request arrives for **15 s** (decided; the page sends a
  keep-alive **every 5 s**), the device drops back to the console by itself — so a closed page never
  leaves the port stuck in api mode, and the next `api on` just starts a new session.
- **Auto-reset** (decided): **S3 → the page uses the native USB port** (control port, section 3;
  TinyUSB CDC with reboot disabled), so opening the port cannot reset the board. **CYD → as described**:
  its only USB serial has the DTR/RTS auto-reset circuit; the page sets `dataTerminalReady` /
  `requestToSend` to the non-reset state right after opening (`port.setSignals`) — test during
  bring-up; if the CYD still resets on open, a hardware change (disable auto-reset during operation)
  is the fallback. In any case the device reports **"run interrupted by a reset"** (9.3.5).

## 8. Verification approach (Rost's PC: PlatformIO on Windows + WSL)

Commands and the WSL setup: `docs/wiki/Development.md`. (Until 1.0.66 the checks ran in a cloud container
without `pio`: own `build-check.py` with the toolchains from GitHub, all rebuilt in `/tmp` after a reset.)
- **Firmware**: `pio run -e <env>` for `s3`, `cyd-1xlocal-1x485`, `cyd-2xlocal`, `cyd-2xlocal-2x485` (all four
  after changes in shared code). An incremental build only recompiles changed files: for a warning check of
  everything, `pio run -e <env> -t clean` first. Report the CYD app slot use (`Flash:` line).
- **Host tests** (WSL Debian): `test/host_test.cpp` with `-fsanitize=address,undefined` — programs, run
  engine, settings, PID, autotune (first-order + dead-time heater model), runaway, thermocouple frames
  (MAX31855 fault bits, MAX6675 open bit), calibration, Modbus framing, image check, release manifest.
  New pure logic gets tests here.
- **Serial console**: `test/console_host` (`conhost` CYD, `conhost_s3`), ASan/UBSan.
- **Touch UI**: `test/ui_host` — LVGL 9.6 on the PC with the project's `lv_conf.h` and shims; screenshots of
  every screen, 480×320 (`uihost`) and 320×240 (`uihost_cyd`), dark and light (`UIHOST_THEME=light`); modes
  `monkey` (random taps, ASan), `stepper`, `chan`, `lowmem`; `MEM=1` heap per screen. For heap checks use
  `GLIBC_TUNABLES=glibc.malloc.tcache_count=0`. Lesson: host tests get zeroed stack memory —
  uninitialised-variable bugs only show on hardware.
- **Web page**: Playwright (headless Chromium) against the browser demo (`tools/build_site.py <dir> --web`,
  :8790): `test/web_*.js`; desktop 1366×820 and phone 390×844, no page errors, look at the screenshots.
- **Hardware**: Rost tests on the boards; say what was checked on the PC and what he needs to test.

Baseline 2026-11-02 (1.0.66, first run on Rost's PC): all four envs build without any warning; flash S3
33.8 %, CYD 93.6 % (`cyd-1xlocal-1x485`, `cyd-2xlocal`) / 94.1 % (`cyd-2xlocal-2x485`) of the app slot;
host_test, both console hosts and the UI host (both sizes, both themes, monkey 2000, stepper, chan, lowmem)
pass with ASan/UBSan. Playwright and the demo (wasi-sdk) are not set up in WSL yet.

## 9. TempCtl Duo — goals (agreed with Rost 2026-09-28)

### 9.1 Channels
- Two temperature channels: **Bottom** (preheater underneath) and **Top** (top heater).
- For **each channel** Rost selects the type in the settings:
  - **A. Modbus**: one Modbus RTU controller per channel (PMA KS 4x-1 preset or generic register map),
    each with its own slave address and register map. Both Modbus channels share the one RS485 bus
    (common baud/parity); the control task polls them alternately.
  - **B. Local**: thermocouple (MAX31855 or MAX6675, selectable) + SSR output on the ESP32, **PID on the
    ESP32**, with **calibration**.
- Any combination is allowed (Modbus + Modbus, local + local, mixed).
- Engine, chart, UI and web API talk to a common channel interface (read PV/SP/output/status, write SP,
  outputs on/off, fault state); they don't care about the backend.

### 9.2 Local channel details
- Sensor: MAX31855 (32-bit frame, 0.25 °C, fault bits OC/SCG/SCV, cold-junction temperature) or MAX6675
  (16-bit, 0.25 °C, open-input bit D2, ≥ 220 ms between conversions → read every 250 ms).
- Calibration: two-point (offset + gain), e.g. two reference points raw → true; defaults 0 / 1.
- PID: manual parameters (Kp, Ki, Kd; anti-windup; output 0–100 %, optional max output limit) **plus
  autotune** (relay method around a user setpoint with hysteresis, result as proposed Kp/Ki/Kd that
  the user accepts or discards). **Tuning rule: Tyreus–Luyben** for both heaters (decided after
  comparing it with Ziegler–Nichols in simulation: no overshoot, ZN overshot 9–13 °C):
  Kp = Ku / 2.2, Ti = 2.2 · Pu, Td = Pu / 6.3 (Ku = 4d / (π·a) from the relay swing). Relay 0 / 100 %
  output, hysteresis ±0.5 °C, several cycles; details (amplitude limit, max test time) in
  implementation.
- Output: time-proportional SSR drive — the SSR is on for the output share of every **window**
  (e.g. 40 % of 1 s = 0.4 s on, 0.6 s off). **Default window 1 s for both channels, settable per
  channel** (decided). With a zero-cross SSR on 50 Hz mains that gives 1 % steps (100 half-waves per
  second).
- **Max temperature (SSR cut-off) default: 400 °C for both channels** (decided; settable per channel).
  The setpoint limits (spMax) are kept at least 10 °C below the cut-off (enforced when saving settings).
- Safety (**agreed**): SSR off on sensor fault or stale reading, above a configurable max temperature,
  when the control task stops updating the output, during boot (pin low until control starts; hardware
  10 kΩ pull-down), after a watchdog reset.
- **Thermal runaway detection (agreed)**: available per channel with an enable switch; it is only active
  for the channel's **selected type**, and each type has its own runaway settings (switching a channel
  between Modbus and Local uses that type's settings):
  - Local: uses the ESP32's own PID output and PV; on a fault the SSR goes off.
  - Modbus: uses the controller's output (Ypid, register 13295 on the PMA) and PV; on a fault the ESP32
    switches the controller's outputs off (C.Off = 1).
  - Checks (decided, like 3D-printer firmware): *heating failed* — output ≥ X % for T s but PV rose
    less than ΔT; *runaway while holding* — PV leaves SP ± band for longer than T s after it was
    reached.
  - **All values incl. the timing are settings in the firmware** (Rost), per channel and per channel
    type, editable on touch and web (Channels page) and stored in Settings: min output %, heating
    period s, min rise °C, hold band °C, hold period s, enable.
  - **Defaults (decided)**: heating failed = output ≥ 80 % for **120 s** (**bottom channel 300 s**)
    with less than **5 °C** rise; runaway while holding = PV more than **±15 °C** from SP for **60 s**;
    enabled.
  - Bottom SP jumps (9.3) keep the bottom output at 100 % for a long time while the board heats
    slowly → generous "heating failed" defaults for the bottom channel. The local PID must avoid
    derivative kick and windup on setpoint jumps (derivative on measurement, clamped integrator).
  - A runaway fault stops the run (both channels, end action "outputs off" on the faulted channel),
    shows an alarm on screen and web, and must be acknowledged.

### 9.2a Protections (decided 2026-10-13, Rost picked from a list; version 1.0.38)
CFG = a setting, on by default unless noted. Channel ones live in the channel's Protection subsection
(web Channels, touch Channels, serial `b./t.<type>.runaway.*`), general ones on the Settings page
(web Settings › Safety, touch System, serial `safety.*`).
- **Heating while off** (stuck SSR / controller), CFG, `runaway.offEnable/offRise/offSec`, default 10 °C
  in 60 s: outputs off but the PV rises offRise within offSec (rise counted from the lowest reading; a new
  window after offSec). Starts 120 s after the outputs went off (heat still flowing) and pauses while the
  other channel heats (its heat reaches this sensor — e.g. the top TC on the board while the bottom
  heats). Modbus: only after this device wrote "outputs off" (`offKnown_`). Fault `FAULT_OFFHEAT`
  (latched; local: SSR relay off).
- **Reading frozen**, CFG, `runaway.frozenEnable/frozenSec`, default 120 s: outputs on and the unfiltered
  reading (local: converter value before the median; Modbus: PV) did not change at all. `FAULT_FROZEN`.
- **Converter too hot** (local, MAX31855 cold junction), CFG `local.cjEnable/cjMax`, default 70 °C:
  latched while heating (`FAULT_CJHOT`); outputs can't be switched on above it; Acknowledge refused until
  5 °C below.
- **Forgotten manual mode**, CFG off by default, `safety.manualIdle/manualIdleMin` (30 min): manual mode
  ends after that long without user activity (touch press, web POST, serial command, any `sendCmd`
  except the settings notification); counted from the later of activity and manual-on (also the kept
  setpoint after a run); a message + "action" beeps 1 min before.
- **Start temperature**: warning only (no setting): at Start, a used channel within 10 °C of (or above)
  its first target → "Warning: <ch> starts at X °C, near or above its first target Y °C".
- **E-stop input**, CFG off by default, `safety.estop`, S3 GPIO5, NC contact to GND (pull-up), read every
  50 ms (active after 2 readings, released after 10). Active: SSR timer and local task force the SSRs
  off, relay off ("SSR supply relay off: E-stop"), control task stops the run (no end action), manual /
  autotune off, Modbus outputs off; start / resume / manual / autotune refused while open. Not a latched
  fault: released = "Emergency stop released", outputs stay off until switched on again. Web: banner on
  the Dashboard + channel badges; touch: tile text + blinking badge. CYD: none (no free pin).
- **Alarm sound**, CFG `safety.sound`: S3 GPIO6, CYD IO26 (speaker amplifier P4 — Rost asked for IO35,
  which is input only). LEDC channel 6 (timer 3), 2.7 kHz, esp_timer 50 ms patterns: fault / E-stop 3
  long beeps every 3 s; "Action required" pause + manual-idle warning 2 short beeps every 10 s; run
  finished 3 short beeps once. Any user activity mutes the current level until it clears or a higher one
  comes. Test beep: `POST /api/beep`, touch switch on.
- **Chip temperature** (S3 only), CFG `safety.chipWarn/chipMaxC` (80 °C): `temperatureRead()` every 30 s
  (only while enabled), warning event above, "back to" 5 °C below; live `safety.chipC`.
- Module `safety.*` (E-stop, buzzer, activity, chip temperature); `GuardMonitor` in `runaway.*` (host
  tested: testGuard).

### 9.3 Programs — two program types (agreed 2026-09-28)
Replaces two earlier drafts ("one program per channel from a shared pool" and "parallel channel
sequences with 'wait for previous phases' barriers"). Chosen after comparing the models on charts.

- **One program drives both channels.** All programs are in one pool; the program list shows the type
  next to the name. The run uses one program.
- **Limits (decided), the same on both boards** so programs can move between S3 and CYD: **20
  programs**, up to **100 phases** (Sequence) or **100 steps per channel** (Timeline), **names up to 31
  characters** (JSON files, 9.3.5: typically 1–3 kB per program, ≤ ≈ 250 kB for 20 maximal programs —
  fits the CYD's LittleFS partition too).
- **Two program types**: **Sequence** (9.3.1) and **Timeline** (9.3.2).

#### 9.3.1 Sequence
- **Phases run strictly one after another.** Each phase has a **channel selector**:

  | Phase type | Bottom | Top | Phase duration |
  |---|---|---|---|
  | `Bottom` | target, ramp, hold | keeps its previous state | bottom ramp + hold (+ wait, below) |
  | `Top` | keeps its previous state | target, ramp, hold | top ramp + hold |
  | `Both` | **target only — the SP jumps** at the phase start (the PCB's thermal mass smooths it), **or `Idle`** | target, ramp, hold | (wait, below +) top ramp + hold |
  | `Pause` | keeps its previous state | keeps its previous state | until Continue (below) |

  - "Keeps its previous state" = holds its last target, or stays off if it has none yet or was set Idle.
  - `Idle` = the channel's outputs are off (SSR off / C.Off = 1) until a later phase gives it a target.
    Only the bottom can be Idle inside a `Both` phase (top Idle + bottom target is just a `Bottom`
    phase).
  - A `Bottom` phase with ramp 0 is a jump too.
  - **`Pause` phase** (agreed): both channels keep their setpoints from the previous phase; timers stop
    and the program waits for **Continue**. Option per phase: **show a big "Action required" message**
    on the device screen (and the web page) with a **Continue program** and a **Stop program** button.
    **Optional custom text per pause** (decided), up to **40 characters**, shown under the "Action
    required" title (e.g. "Place the IR head", "Check flux"); also printed over serial and shown in the
    event log. Available for Pause steps in Timelines too.
    Without the message the pause shows in the status ("Program pause") and the run bar's button reads
    Continue. "Next phase" = Continue. Kept setpoints can still be changed during the pause (9.3.4).
- **"Wait for bottom to reach target"** — per-phase switch, available in `Bottom` and `Both` phases
  (not in `Top` phases; add later if the top heater turns out to lag):
  - `Bottom` phase: the bottom SP ramps as programmed; after the ramp the **hold timer starts only when
    the bottom PV is within the band** of the target.
  - `Both` phase: the bottom SP jumps; the **top ramp starts only when the bottom PV is within the
    band** (meanwhile the top keeps its previous state).
  - Band: **one global setting** ("bottom reached" band, **default ±5 °C**, decided); phases only have
    the on/off switch.
  - While waiting, status and chart show "Waiting for bottom"; "Next phase" skips the wait (see below).
- **"Next phase"** (decided, replaces the per-channel skip chosen for the parallel draft): one button
  that moves **one stage further — ramp → hold → next phase — and never stops at a "wait for bottom"**:
  - `Bottom` phase with wait: during the ramp → straight to the hold (the wait is skipped); during the
    wait → the hold starts.
  - `Both` phase with wait: during the wait → the top ramp starts; during the top ramp → hold.
  - During a hold → next phase. In a `Pause` phase, Next = Continue.

#### 9.3.2 Timeline
- **Two independent step lists, one per channel, started at the same time.** Each channel has its own
  steps (target, ramp, hold — as in TempCtl), so ramps and holds of the two channels happen at
  independent points in time (e.g. the bottom runs ahead into its next step while the top is still in
  an earlier one).
- Purely time-based: **no "wait for bottom"** (it would shift only one channel and break the time
  alignment between the channels, which is the point of a Timeline).
- **`Idle` steps** (outputs off for a given time) are available in both step lists (agreed).
- Up to 100 steps per channel. A channel with no steps is controlled manually (9.3.5).
- **`Pause` steps** (agreed) are available in both step lists: when a channel reaches one, the **whole
  run pauses** (both channels' timers stop, both keep their setpoints — a channel in the middle of a
  ramp holds its current SP) until Continue; same "Action required" option as in Sequences. Continue
  moves past all pause steps reached at that moment.
- **"Next phase" is disabled** for Timeline programs (Rost). Pause / Resume / Stop act on both channels.
- The run ends when both step lists are done; **a channel that finishes earlier keeps its last target
  until then** (decided) — to switch it off earlier, the program ends that channel's list with an
  explicit `Idle` step. Then both apply their end actions.

#### 9.3.3 Editors
- **Device (touch)**: table editing for both types.
  - Sequence: one row per phase with the type selector, the fields of that type and the wait switch.
  - Timeline: **two separate tables next to each other (Bottom | Top) with a visible separation**
    (not tabs). On 480×320 each table gets ≈ 230 px — compact columns (#, target, ramp, hold; times as
    m:ss), details in the number editor popup.
  - **CYD 320×240 (decided)**: Timeline = **one table with a Bottom / Top switch**; Sequence = compact
    one-line summary per phase, **tap → phase edit popup** with all fields.
- **Web**: the same tables **plus a graphical editor for both types** on the chart. This is a
  deliberate exception to "full parity": the device can edit everything, but only the web has the
  graphical editor.
  - **Three kinds of handles on the chart, for both program types** (agreed):
    - **hold end** (circle) — drag left/right: changes that hold time (Sequence: bottom hold in a
      `Bottom` phase, top hold in `Top` and `Both` phases);
    - **ramp end** (diamond) — drag left/right: changes that ramp time;
    - **target** (square, in the middle of the hold / plateau) — drag up/down: changes that target
      temperature (also the bottom jump target of a `Both` phase).
    Snapping to whole seconds and °C; later phases/steps move in time but keep their values. Where
    handles would overlap (hold 0), the target and hold-end handles are drawn offset with a leader line.
    The table next to the chart updates live, and table edits update the chart.
  - The preview uses the programmed times and treats every "wait for bottom" as satisfied at once, so
    outside a run a hold can be dragged back to the end of its ramp. **When no program is
    running, the channels are edited independently** — moving a point of one channel moves only that
    channel's later steps (agreed); during a run see 9.3.4.
- **"Convert to Timeline"** (web; done in 1.0.32): one way only, with a **warning that the conversion
  can't be reversed**. Decided 2026-10-12 (Rost): Sequences **with** "wait for bottom" convert too — the
  waits are dropped (the warning lists the phases; the Timeline runs on the programmed times, as the
  preview does); the dialog asks each time **Replace this program** (the draft in the same slot, Undo
  brings the Sequence back until saved) or **Create a new program** (first empty slot, "… (Timeline)",
  unsaved draft). Mapping: one clock phase by phase; a channel that keeps its state gets its last hold
  (or Idle) lengthened to the next phase that gives it a target; a Both phase's bottom jump = ramp-0
  step (Idle = idle step); a Pause phase = pause step in the bottom list (top if the bottom is unused).
- **Starting a run with unsaved changes** (decided): Start asks **"Save and start" / "Start without
  saving" / "Cancel"**. "Start without saving" sends the draft to the device as the run's copy; after the
  run the usual "save the run's changes?" question comes (9.3.4). Same on touch and web.
- **Outside a run, edits (table or chart) go to a draft** of the program (agreed): **Save program** and
  **Discard changes** buttons appear/enable as soon as anything changed; the program list marks programs
  with unsaved changes. **Undo / Redo** (buttons, and Ctrl+Z / Ctrl+Y on the web) cover all edits
  outside a run, including Discard. During a run these buttons are disabled (run edits go to the running
  copy and are offered for saving after the run, 9.3.4). Starting a run uses the draft as shown.
- **The table/editor panel resizes with the number of phases/steps** (no fixed height).
- **Phase end times on the chart** (agreed): each phase boundary is labelled with its time (Sequence:
  phase number + start time of the next phase; Timeline: the end time of each step next to the curve),
  plus the program end. Past boundaries show actual times, future ones the forecast; they update live
  during the run (waits, pauses, edits).
- **Pauses on the chart**: a thick vertical line with a pause symbol where the program pauses; while a
  pause lasted, the area is lightly hatched.
- **Chart zoom and scroll** (web, agreed): the chart always fits the screen width (no sideways page
  scrolling on phones). Zoom − / + / Fit buttons, a scroll slider when zoomed, Ctrl + mouse wheel zoom
  at the cursor, Shift + wheel or horizontal swipe to scroll, drag on the chart background to scroll,
  pinch to zoom on touch screens. During a run a zoomed view follows the current time. Handles keep
  working when zoomed.
- **Compact editor**: narrow table (one "Option" column for wait / "Action required", ✕ delete
  buttons); on narrow screens (< 720 px) each phase becomes a small card instead of a table row.

#### 9.3.4 Editing during a run
- The graphical editor (and the tables) can be **activated during a program run**, e.g. to **extend the
  current phase's hold when the solder joints are not liquid yet** or to **raise a target temperature**. **Later phases stay untouched** —
  their parameters don't change, they only move later in time.
- Rules:
  - Only the current and later phases/steps can be changed; finished ones are locked, except for a
    target the channel still keeps (below) (decided).
  - A hold cannot be shortened below the time already elapsed; dragging it to "now" ends the hold at
    once (decided). **Chart drags take effect only when the user releases the handle** (decided) —
    while dragging, only a preview (ghost line + value) is shown; nothing is sent to the device.
  - Timeline **during a run**: when one channel's timing changes (hold, ramp, or a ramp time that
    changes because of a target change), the other channel is shifted by the same time **only through
    its holds** (agreed): the first hold/idle at or after that moment gets longer, or holds/idles at or
    after it get shorter. Its ramps are never changed or paused. If it has no hold left, nothing is
    shifted. Outside a run the channels are edited independently (9.3.3).
  - During a run the current and finished ramps have no ramp-time handle / field (locked, confirmed by
    Rost — dragging would change the slope of a running ramp); future ramps can be changed.
  - Changes go to the control task as commands (not written directly into the running engine).
  - Changes apply to the **running copy** of the program; after the run the device/web asks whether to
    save them into the stored program (agreed).
- **Touch equivalent (agreed)**: "Extend hold" buttons (e.g. +10 s / +30 s / +1 min) on the device
  status screen while a hold is active, so extending doesn't depend on the web. Same rules as above.
- **Target temperatures can be changed during a run too (agreed)** — in the web tables, by dragging a
  point vertically in the graphical editor, and on the device. **Slopes are kept, times adapt** (agreed):
  - The **slope of a ramp** = |target − start value| / ramp time as the ramp starts (start value =
    previous target, or the measured PV for a first ramp / after Idle). A ramp time of 0 = a jump.
  - Current phase/step **in a ramp**: the ramp continues from the current SP to the new target **with
    the same slope**; the remaining ramp time is recalculated (if the new target is below the current SP
    of a rising ramp, it ramps down with the same slope).
  - Current phase/step **in a hold**: the SP **ramps to the new target with the slope set for this
    step** (a jump if the step had ramp 0); the **hold timer keeps running** meanwhile, so the ramp uses
    up part of the remaining hold (agreed).
  - `Both` phase (bottom jump): the bottom SP jumps to the new bottom target; a running "wait for bottom"
    uses the new target (agreed).
  - **Later phases/steps keep their targets**; the ramp that follows the changed target **keeps its
    slope and its duration is adjusted** (agreed), so later phases/steps move in time.
  - Timeline: a temperature change on one channel doesn't change the other channel's targets or ramps
    (agreed); a resulting **ramp-time change shifts both channels' later steps** by the same amount
    (longer ramp → both later, shorter → both earlier), like "extend hold", so the time alignment is kept
    (agreed).
  - **Kept targets are adjustable (agreed)**: a channel that keeps the target of an earlier phase (e.g.
    the bottom during `Top` phases), or a Timeline channel whose steps are done and which keeps its last
    target, can still get a new target. The SP moves there with the slope of the phase/step that set
    it (a jump for a bottom jump target); the change is stored in that phase/step of the running copy.
  - Setpoint limits (spMin/spMax) apply; Idle phases/steps have no temperature to change (agreed).
  - The recalculated ramp times are part of the running copy and are saved with it if Rost chooses to
    save the run's changes.
  - Touch: target control on the main screen tile (9.7: 480×320 stepper, 320×240 SP button → number
    editor) for the current (or kept) target.

#### 9.3.5 Common rules
- **Start values**: a channel's first ramp — and the first ramp after it was Idle — starts at the PV
  measured at that moment; later ramps start at the channel's previous target.
- **Idle at the start of the run**: a channel with no target yet has its **outputs off** (agreed).
- **"Run interrupted by a reset"** (agreed): the run state (program, phase/step, run time, running
  copy changed yes/no) is kept in RTC memory while a program runs and cleared when it ends normally.
  If the board restarts during a run (watchdog, brown-out, crash, a serial auto-reset …), it starts
  with **all outputs off** and shows **"Run interrupted by a reset"** with the reset reason, program,
  phase and time on touch, web and serial (the event log keeps it). **Never an automatic resume;
  instead a "Resume from the interrupted phase" button** (decided; touch, web, serial `resume run`):
  - Sequence: the interrupted phase starts again from its beginning (ramps from the measured PV as
    after Idle, full hold, "wait for bottom" as programmed).
  - Timeline (decided): both channels continue at the run time of the interruption — a channel that
    was in a ramp ramps from its measured PV to the step's target in the remaining ramp time, holds
    continue with their remaining time.
  - The running copy (with edits) is kept for this: written to flash (`/duo/run.json`) at start
    and after each run edit, so it survives a reset or power loss.
  - The offer stays until the user resumes, dismisses it, or starts/edits something else.
  A normal power-off/power-on during a run is reported and offered the same way when it can be
  detected (`/duo/run.json` still present at boot).
- **Channel without any phase/step** in the program: **controlled manually** during the run (manual
  switch and SP stay available on touch and web). A program needs at least one phase/step to start.
- **Guaranteed soak is removed** (Rost, 2026-09-28): hold times are plain times; "wait for bottom" in
  Sequences is the only PV-dependent timing.
- **Run control**: Start / Pause / Resume / Stop act on the whole run; "Next phase" see 9.3.1 / 9.3.2.
- **End**: after the program each channel applies its own end action (keep SP / end SP / outputs off).
  **Decided**: run control (Start / Pause / Resume / Stop / Next) and end actions don't touch a manually
  controlled channel; a runaway or sensor fault on it still switches its outputs off and stops the run.
- **Timing / chart preview**: total time and per-channel plan curves come from the programmed times and
  are exact, except for "wait for bottom" phases, pauses and edits during the run (the preview assumes
  no wait and no pause time; the time axis and the remaining time adjust during the run; the total is
  shown as "… + waits").
- **Implementation (decided)**: **one pure C++ run engine for both types** (replaces the single-channel
  `ProgramEngine`, host-testable). Internally both types become per-channel segment lists (ramp / hold /
  idle) plus **sync points**: a Timeline has none, a Sequence has one at every phase boundary, and
  "wait for bottom" is a sync point with a PV condition. Run edits = changing a hold duration and
  shifting later segments.
- **Program files: JSON** (decided, Rost): one file per program, **`/duo/progN.json`** (N = 0–19) on
  LittleFS, the **same JSON as the web API** uses for programs (so export/import and the web editor
  need no conversion). Sketch:
  ```json
  {"fmt":1,"name":"Lead-free BGA","type":"seq","phases":[
    {"kind":"B","wait":true,"b":{"t":150,"r":60,"h":60}},
    {"kind":"P","msg":true,"text":"Place the IR head"},
    {"kind":"BT","wait":true,"b":{"t":160},"t":{"t":150,"r":60,"h":20}},
    {"kind":"BT","b":{"idle":true},"t":{"t":150,"r":40,"h":0}}]}
  ```
  Timeline: `{"fmt":1,"name":…,"type":"tl","B":[{"t":150,"r":60,"h":150},{"idle":true,"h":60}],
  "T":[{"pause":true,"msg":true,"text":"…"},…]}`. `fmt` = file format version (for later changes);
  unknown keys are ignored, missing keys take defaults. **Safe save**: write `progN.tmp`, then rename.
  Size: typical program 1–3 kB, worst case (100 phases) ≈ 12 kB; parsing with ArduinoJson 7 needs a
  similar amount of RAM for a moment (check on the CYD, no PSRAM). The running copy is stored the same
  way (`/duo/run.json`).

### 9.4 Manual mode
- Manual setpoint switch **per channel** (as in TempCtl: on = SP + outputs on, off = outputs off).
  Starting a run ends manual mode only on channels that have phases in the program; a channel without
  phases stays manually controllable during the run (9.3).

### 9.5 Storage — clean start
- **Settings: JSON file `/duo/settings.json`** (decided, Rost) — the same JSON as the web API's
  settings, with a `fmt` version field; unknown keys ignored, missing keys take defaults (so new
  settings need no migration); safe save (temp file + rename). Programs: `/duo/progN.json` (9.3.5).
  Nothing from TempCtl (NVS namespace `tempctl`, `/progN.bin`) is read or migrated.
- **Wi-Fi passwords** are stored in the settings file but **never returned by the API** or printed
  (the API only reports "set / not set").
- The "run interrupted" data lives in `/duo/run.json` (exists only while a run is active) plus RTC
  memory for the reset reason.
- **Settings content (decided)**: common (RS485 baud/parity, Wi-Fi + AP, accent colour (RGB), touch
  theme, "bottom reached" band; no guaranteed-soak settings) + per channel (**name**, type, end action,
  setpoint limits; Modbus: address + register map (PMA preset or custom) + ramp options; local: sensor
  type, calibration, PID, SSR window, max output, max temperature (cut-off); runaway enable + limits
  stored per channel type).
- **Fixed IP (Rost, 2026-10-01)**: optional static address for the station (IP, mask, gateway, DNS) in
  the Wi-Fi settings, web and touch.
- **Polling interval (Rost, 2026-10-01; lower limit 2026-10-21, see 1.0.58)**: the polling interval (`bus.pollMs`,
  100 or 250–10000 ms by the channels: `pollMinMs`, default
  1000 ms) is a normal device setting, **editable on the touch UI and on the web GUI** (not only through
  `/api/config`). It sets how often the control task polls the channels (Modbus round robin; local
  channels every cycle) and so how often PV / SP / output are refreshed for the displays. Touch: Setup
  (step 6); web: settings page (step 7c). Show a hint that with two Modbus controllers each one is
  polled every 2 × the interval.
- **Channel names (decided)**: a free name per channel, **shown on all screens instead of
  "Bottom" / "Top"** (touch, web, serial output, program editor headings); defaults "Bottom" and "Top",
  up to 16 characters. The roles stay fixed: channel 1 is the lower heater that "wait for bottom" and
  the bottom jump in `Both` phases refer to (the UI uses the name there too, e.g. "Wait for
  Preheater"); serial commands keep `b` / `t` as short channel keys.

### 9.6 Hardware
- ESP32-S3-DevKitC-1 v1.0 N16R8 (WS2812 on GPIO48 and the touch confirmed by Rost), 4.0" ST7796 + FT6336U
  module, pinout in 2a; both USB ports usable: flashing + log monitor via the "UART" port, control
  (serial console, Web Serial page) via the native "USB" port.
- **CYD stays supported as a second device** (2b): envs `cyd-1xlocal-1x485` / `cyd-2xlocal` / `cyd-2xlocal-2x485`, 320×240, resistive touch, same features.
- Display through LVGL's ST7796 driver, touch through our own FT6336U driver (section 3).

### 9.7 Layout
- Orientation: **landscape 480×320** (S3) — confirmed by Rost; the CYD set is landscape 320×240 as in
  TempCtl.
- **Touch main screen shows both channels** (Rost): both PV/SP/output readouts, the chart with both
  channels + plans, and the per-channel manual controls on the main screen (both screen sets).
  First mockups (Design canvas "TempCtl Duo main screen", 2026-09-28): header with program, phase,
  state and time; full-width chart with both channels; two channel tiles (PV, SP, output bar, status,
  target control, Manual switch). 480×320: run buttons in the header, target as **− value + stepper;
  tapping the value opens the number entry popup** (decided).
  **320×240 (Rost): no ± buttons and no separate SP readout — one SP button showing the current SP
  that opens the numeric input popup (as in TempCtl 1.2)**; run buttons + menu in a bottom bar.
  Final pixel details are settled in the LVGL Pro Editor.
- **Web Status page (decided)**: the simulator's layout (run panel with chart and zoom bar, the two
  channel cards, program editor, event log) plus the sidebar (7) — no separate mockup.
- Channel colours: split-complementary to the accent, lighter SP, contrast rule per theme (section 6,
  agreed) — no fixed colours for channel 2.

### 9.8 Identity and versioning (decided 2026-09-28)
- Product name **"TempCtl Duo"** (screen, web title, serial banner), host name **`tempctl-duo`**
  (mDNS `tempctl-duo.local`), AP name **`TempCtl-Duo-XXXX`** (last MAC digits). LVGL Pro project name
  stays `tempctl_ui` (no churn in the exported file names).
- **Version: the whole TempCtl Duo project starts at 1.0.0** (Rost) — firmware, web page / local app
  share one version number. **Every commit that is pushed increases the patch number** (1.0.0 → 1.0.1
  → …); minor/major only when Rost says so. Kept in one place (**decided: `src/version.h`**, used by the
  firmware, the web page build and the local app) and bumped in the commit itself.
- The **API version** (`api` in the hello line, 7b) is a separate integer, raised only when the serial /
  HTTP API changes incompatibly.

### 9.9 Other points
- **Example programs on first start (decided): three**, taken from the 9.3 simulator (target °C /
  ramp s / hold s; created only when no program exists):
  1. **Lead-free BGA (Sequence)**: Bottom 150/60/60 + wait · Pause ("Action required") · Both: bottom
     160 (jump), top 150/60/20 + wait · Top 190/40/40 · Top 225/30/20 · Top 245/20/30 · Both: bottom Idle,
     top 150/40/0.
  2. **Leaded BGA (Sequence)**: Bottom 130/40/60 + wait · Both: bottom 140, top 130/50/20 + wait ·
     Top 170/40/30 · Top 205/30/20 · Top 220/15/30 · Both: bottom Idle, top 120/40/0.
  3. **Lead-free BGA (Timeline)**: bottom 150/60/150 · 165/30/150 · Idle 60; top Idle 120 · 150/40/20 ·
     190/40/30 · 225/30/20 · 245/20/30 · 150/40/0.
  Values are starting points, to be tuned on the real station.
- **SD run logs (S3, 1.0.32; decided 2026-10-12)**: one CSV per program run in `/runs` on the card,
  **every 1 s, full detail** (time_utc, run_s, where, per channel pv / sp / prog / out / state) plus a row
  per event during the run (kind, event); **web list on the System page** (Download / Delete) + the card
  in a PC. The CYD has none (its SD pins carry the thermocouples). Shared SPI bus: the screen check frees
  the bus every second, so the card is mounted only while used, under `lcdBusLock()` (the check skips
  that second: "busy (SD card)").

### 9.10 Proposed implementation order
1. **Bring-up on the S3**: new env, per-board headers (S3 + CYD), ST7796 via LVGL + DMA, own FT6336U
   driver, RS485 on UART1, WS2812 status; existing single-channel TempCtl UI running (in a corner) so
   the board, display, touch, Wi-Fi/web and Modbus can be tested on hardware first. The `cyd` env must
   keep building (ILI9341 via LVGL, XPT2046) — Rost tests both boards.
2. Channel interface; Modbus backend for two channels on one bus; settings in `/duo/settings.json`.
3. Local backend: thermocouple reading + calibration, SSR time-proportional output, safety cutoffs.
4. PID + autotune (host-tested first).
5. Program types Sequence + Timeline, program format + one run engine (9.3), host tests for phase
   timing, jumps, Idle, "wait for bottom" and run edits.
6. Touch UI redesign for 480×320 / two channels (XML in LVGL Pro Editor, Rost exports).
7. Web UI and API for two channels, starting from the 9.3 simulator page (7), including the graphical
   program editor for both types and editing during a run (9.3.3, 9.3.4).
8. Serial console (7a) — can come early (after step 2), it helps with bring-up and Wi-Fi setup;
   then the `api` mode and the Web Serial page (7b). Test the DTR/RTS auto-reset behaviour early.
9. Identity (9.8) — can be done in step 1 already (name, host, AP, version 1.0.0).
10. Later / planned: the page on GitHub Pages (7b, option 1) — done on Cloudflare instead (1.0.45), with the
    release files since 1.0.52 (9.13). (SD run logs and Convert to Timeline: done in 1.0.32.)

#### 9.10.1 State of step 1 (2026-09-29)
Implemented (both envs compile and link without warnings in our files; host tests pass):
- `platformio.ini`: envs `s3` (default; `esp32-s3-devkitc-1`, qio_opi, 16 MB, `default_16MB.csv`,
  `BOARD_HAS_PSRAM`, `board_build.extra_flags` = board flags with `ARDUINO_USB_MODE=0`,
  `ARDUINO_USB_CDC_ON_BOOT=0`) and `cyd`; TFT_eSPI removed, XPT2046 only in `cyd`. Both on COM6 (ask).
- `src/version.h` (PRODUCT_NAME, FW_VERSION 1.0.0, DEFAULT_HOSTNAME `tempctl-duo`, AP_NAME_PREFIX
  `TempCtl-Duo`, API_VERSION 1); `src/config.h` includes `board_s3.h` / `board_cyd.h` by `BOARD_S3` /
  `BOARD_CYD` (all pins of 2a / 2b, incl. the later TC/SSR pins, not used yet).
- `src/lcd.*`: LVGL `lv_st7796_create` / `lv_ili9341_create` on native portrait resolution with
  `LV_LCD_FLAG_MIRROR_Y` (+BGR), rotation 90° / 270° → MADCTL `MV|BGR` / `MV|MX|MY|BGR` = TFT_eSPI
  rotations 1 / 3. SPI2 via `spi_master`: commands polling, pixels one queued DMA transfer,
  `lv_display_flush_ready()` in `post_cb`, `lv_draw_rgb565_swap()` (the `_sw_` name is deprecated in
  9.6). Two draw buffers in internal DMA RAM (S3 480×32 lines = 30 kB each — an S3 SPI transfer is
  ≤ 32 kB; CYD 320×20). After LVGL's init a fix-up command list: ST7796 `B6 80 02 3B` (LVGL sets SS=1
  = mirrored), CYD the TFT_eSPI `ILI9341_2_DRIVER` power/VCOM/gamma/`B6 08 82 27` values. 40 MHz
  SPI on both. Backlight LEDC channel 0, switched on after the first frame. `LCD_INVERT 0` (MSP4031 is
  a TN panel per lcdwiki).
- `src/touch.h`, `touch_ft6336.cpp` (reset pulse, `Wire` 400 kHz with 20 ms timeout, regs 0x02–0x06,
  G_MODE 0, chip id 0xA3 printed at boot, I²C error → released; mapping `TOUCH_SWAP_XY 1`,
  `TOUCH_INVERT_Y 1` = x = raw y, y = 319 − raw x, derived for MADCTL MV with the panel's portrait
  touch axes — **unverified**; CTP_INT not used yet (`TOUCH_USE_INT 0`)), `touch_xpt2046.cpp` (old code).
- `src/status_led.*`: WS2812 via `neopixelWrite` (level 40/255) / CYD RGB LED via LEDC PWM (level
  120/255, 2026-09-29), colours and priority of 2a, called from the control task every 10 ms (fault = no Modbus answer, wait = paused, AP =
  `netApActive()`, running = program or manual).
- RS485 via `RS485_SERIAL` (Serial1 on 1/2/42 on the S3, Serial2 on the CYD).
- Identity: boot banner, web title/brand, `/api/status` `board`, AP name, host name default; NVS
  namespace `tempctl-duo` (clean start, no migration; step 2 replaces NVS by `/duo/settings.json`).
- S3 screen: the 320×240 tabview is resized to the top left corner; right of it a bring-up panel
  (version, board, heap, largest block, free PSRAM, touch up/down, raw and mapped coordinates) and a
  red dot on `lv_layer_sys()` at the touched point. Popups still use the full 480×320 layer.
- README updated (boards, pins, envs, identity); `docs/SPEC.md` is still the old first revision.

Without a display the S3 firmware runs normally (SPI writes go nowhere); a FT6336 that is missing at
boot is not accessed again (no I²C error log every 2 s; connect the display with the power off).
The status LED runs in its own small task (`statusled`, 20 ms) — in the control task the blinking was
irregular because Modbus timeouts without a controller block it for seconds.

**S3 bare board tested by Rost (2026-09-29, COM4)**: boots, PSRAM 8 386 279 bytes, free heap 287 kB
at start / 148 kB before net / 96 kB after (largest block 86 kB), no `ARDUINO_USB_MODE`
redefinition warnings, AP works (still the TempCtl 1.2 web page), FT6336 not found (expected), LED
blinked irregularly (fixed as above, re-test). Boot line "mode:DIO" is the ROM header, normal.

**Hardware checks — deferred per part (ask Rost for the serial log / a photo when each part arrives):**
- *Now — bare S3 board (no display, no PMA):* boots on the "UART" port with banner `TempCtl Duo
  1.0.0 (ESP32-S3)` and PSRAM ≈ 8 MB; `[lcd] 480x320 …`; `[touch] FT6336 NOT FOUND` (expected);
  WS2812 on GPIO48 blinks red (no Modbus answer — expected; confirms v1.0 board); Wi-Fi / AP
  `TempCtl-Duo-XXXX`, web page at `tempctl-duo.local`; free heap numbers in `[mem]`; no
  `ARDUINO_USB_MODE` redefinition warnings in the PlatformIO build.
- *Now — CYD:* picture not mirrored and colours right (ILI9341 fix-up list), touch as before,
  RGB LED blinking red without PMA (purple in AP mode), web page / identity; measure IO18 → 3.3 V
  (no pull-up expected) before wiring an SSR; free heap vs. TempCtl 1.2 (97 kB).
- *When the 4" display (MSP4031) arrives:* picture orientation (MADCTL), colours (`LCD_INVERT`, BGR),
  40 MHz SPI stable, backlight PWM; FT6336 chip id; touch mapping with the bring-up panel
  (`TOUCH_SWAP_XY` / `TOUCH_INVERT_*`), 180° rotation of picture and touch; then try CTP_INT
  (`TOUCH_USE_INT 1`).
- *When the thermocouple converters (MAX31855 / MAX6675) arrive* (not delivered yet, 2026-09-30):
  the step-3 test in 9.10.3 — readings and cold junction, calibration, PID + SSR duty on an LED, fault
  on a pulled thermocouple and `/api/ack`; later autotune (step 4) on the real heaters.
- *When the PMA controller arrives:* RS485 on UART1 (GPIO 1/2/42) with the PMA on both boards, LED
  turns green/blue, program run + manual setpoint as in TempCtl 1.2.

#### 9.10.2 State of step 2 (2026-09-29)
Decided with Rost: (a) until steps 5–7 the old single-channel touch UI, web page, program engine and
chart work on the **bottom channel** (`ENGINE_CH`); the top channel is polled, shown in `/api/status`
(`channels`) and the serial log, and configured through `/api/config`; (b) **channel type `off`**
(not used, not polled, no fault) in addition to `modbus` / `local`.
- `src/settings.h/.cpp` (pure C++, host-tested): `Settings` = common (bus, run, wifi, display, tools,
  selProgram) + `ChannelSettings ch[2]` (name, type, end action, SP limits, manual SP, `mb`: address,
  profile, RegMap, ramp options, lock, runaway; `loc`: sensor, calOffset/calGain, kp/ki/kd, window,
  maxOut, maxTemp, runaway). `settingsDefaults(s, BoardLimits)`: bottom Modbus addr 1, top Off
  (no RS485: both local); spMax 390; runaway defaults of 9.2 (bottom heatSec 300). `settingsValidate`:
  ranges, channel types the variant can't wire -> Off + message, same Modbus address on both channels ->
  error, local spMax <= maxTemp - 10. JSON: `settingsToJson(s, obj, forApi)` / `settingsFromJson` (merge,
  unknown keys ignored, wrong types rejected with the path, a new profile loads its register map;
  register addresses -1 = unused; enums as strings: type off/modbus/local, endAction keep/sp/off,
  profile pma/generic, rampMode host/controller, sensor max31855/max6675; accent "#RRGGBB";
  themeDark null = first-start default). Guaranteed soak (`run.guaranteedSoak/soakBand`) and
  `display.themePalette` are still in the file for the old engine/UI; they go with steps 5/6.
- `src/settings_store.*`: `/duo/settings.json` (pretty JSON, temp file + rename; unreadable file ->
  kept as `/duo/settings.bad`, defaults), `boardLimits()`, `serialConfigFor()`. NVS is no longer used.
  `storageBegin()` (program_store) mounts LittleFS and creates `/duo`.
- `src/channel.*`: `Channel` interface (poll, writeSp, setOutputs, canSwitchOff, spConfigured,
  modbus()); `ModbusChannel` (a `Controller` = slave address + RegMap on the shared `ModbusMaster`),
  `LocalChannel` stub ("not implemented yet (step 3)", outputs stay off), `OffChannel`; `ChannelSlot`
  picks the backend by type. `ChannelLive` = published values per channel.
- Control task (`app_state.cpp`): one bus (`modbusBusBegin`), local/off channels polled every cycle, the
  Modbus channels **round robin, one per cycle** (each every 2 x pollMs when both are Modbus); manual
  mode per channel (`CMD_MANUAL_*` with arg = channel, `setManualSp(v, ch)`); the engine + end action +
  controller ramp / lock on the bottom channel (Modbus extras only if it is Modbus); a channel type change
  switches that channel's manual mode off and stops a running program on the bottom channel. Link
  changes are logged once (`[ch] Top (modbus): link ok` / `... PV read: no response (timeout)`). Status
  LED fault = any channel that isn't Off without link. `gLive` keeps the TempCtl 1.2 flat fields as a
  mirror of the bottom channel + `ch[2]`.
- Web: `GET/POST /api/config` (whole document, passwords only as `passSet`/`apPassSet`), `channels` in
  `/api/status`, `ch` in `/api/manual` and in the bus tools / PMA parameters (`?ch=1` or `"ch":1`); the
  old `/api/settings` edits bottom + common and is validated.
- Host tests: settings defaults per variant, JSON round trip (file and API form), partial merge,
  error paths, variant rules; `-fsanitize=address,undefined` clean. All four envs build without
  warnings in our files.
- To test on the bare S3: boot log `[settings] no /duo/settings.json - defaults`, `channel 1: Bottom,
  modbus`, `channel 2: Top, off`, `[ch] Bottom (modbus): PV read: no response (timeout)` once;
  `http://tempctl-duo.local/api/config`; POST `{"channels":[null,{"type":"modbus"}]}` -> top polled too
  (address 2), second log line. **POST bodies need `Content-Type: application/json`**: curl's `-d`
  alone sends form encoding and the ESP32 WebServer then has no `plain` body ("Invalid JSON"). On Rost's
  Windows PC: PowerShell `Invoke-RestMethod -Method Post -Uri http://tempctl-duo.local/api/config
  -ContentType 'application/json' -Body '{"channels":[null,{"type":"modbus"}]}'`, or in cmd.exe
  `curl -X POST -H "Content-Type: application/json" -d "{\"channels\":[null,{\"type\":\"modbus\"}]}" URL`
  (PowerShell mangles the `\"` quoting of the cmd form).

#### 9.10.3 State of step 3 (2026-09-30)
- **The PID moved into step 3** (a local channel can't heat without it); step 4 is now autotune only.
- `src/tc_sensor.*` (pure, host-tested): `tcDecode31855` (14-bit TC 0.25 degC, 12-bit cold junction,
  OC/SCG/SCV) and `tcDecode6675` (12-bit, open bit D2); **no device** = frame all 0 / all 1 or reserved
  bits set (31855 D17/D3, 6675 D15/D1). SO has a pull-up, so a missing converter reads all ones.
- `src/pid.*` (pure): derivative on the measurement, low-pass Td/8 (>= 1 s) against the 0.25 degC steps,
  integrator clamped 0..outMax and frozen while saturated in the error's direction. Host test on a
  first-order + dead-time heater (gain 3 degC/%, tau 120 s, dead 8 s, quantised readings): kp 3, ki 0.03,
  kd 20 reaches 200 degC with < 1 degC overshoot. (kd 60 oscillated — autotune must keep Td sane.)
- `src/runaway.*` (pure): `RunawayMonitor` — heating failed (out >= minOut for heatSec with < minRise;
  the window restarts whenever the PV rose minRise) and hold runaway (only after a steady SP was reached,
  |PV - SP| <= min(2, holdBand); a SP move > 0.5 degC resets it); `ChannelFault` codes
  sensor / over temperature / heating failed / hold.
- `src/local_ctrl.*`: `localCtrlEarlyInit()` first in `setup()` (SSR pins low, TC CS high, SCK low, SO
  pull-up); task "local" (core 0, priority 4 above the control task, 250 ms): bit-banged frames (~4 us per
  bit) on the board's TC bus, calibration, faults latched **only while the outputs are on** (3 bad reads
  = sensor fault; PV > maxTemp = over temperature; runaway), PID, SSR duty; esp_timer 10 ms switches the
  SSR pins per window (`now % window < duty * window`) and turns them off if the duty isn't refreshed for
  1.5 s. Switching on is refused while faulted or above maxTemp. Ack refused without a fresh reading or
  above maxTemp - 5; after an ack the outputs stay off. Pins: S3 / CYD 2x variants per channel, CYD
  1x485 the one "LOCAL" pin set for whichever channel is local.
- Channels: `fault()` / `ack()` in the interface; `LocalChannel` = view of the local task (PV only when
  fresh, spEff = SP while on, out = PID %, coldC); `ModbusChannel` runs the same runaway check with Ypid
  (SP = SP.EF, else the last written SP) while its outputs are on and writes C.Off = 1 on a fault.
- Control task: a new fault is logged (`[ch] Bottom: FAULT heating failed - outputs off`), switches that
  channel's manual mode off and stops a running program (end action for the program's channel runs,
  a faulted channel's outputs stay off); manual on / program start are refused while a fault is latched;
  `CMD_ACK_FAULT`. Host SP stepping without minStep / minWriteSec on a local channel. LED fault also for a
  latched fault. `runMsg` 128 chars.
- Web: `channels[].fault` (text, "" = none) and `cold` (local), `POST /api/ack {"ch":n}`.
- Host tests added for thermocouple frames, PID, runaway; all envs build without warnings.
- To test (needs a MAX31855 / MAX6675 + thermocouple, an SSR driver or just an LED on the SSR pin):
  set a channel local (`{"channels":[null,{"type":"local"}]}` on the S3), check `channels[1].pv` and
  `cold`, manual on with `/api/manual {"ch":1,"on":true,"sp":50}`, watch the LED duty; pull the
  thermocouple -> `fault` "thermocouple open", `/api/ack` refused until it is back.

#### 9.10.4 State of step 4 (2026-09-30, version 1.0.1)
- `src/autotune.*` (pure, host-tested): `RelayAutotune` — heat-up at outMax until PV > sp + h, then relay
  bias +/- d with hysteresis h = 0.5 degC; after every cycle the bias is re-centred (Marlin) from the
  high/low times (bias limited to 10..90 % of outMax, d = distance to the nearer limit); 2 settling cycles,
  then 5 counted cycles, and a bias correction >= 2 % of outMax restarts the counting. Fails on period
  spread > 30 %, amplitude <= 1.2 h, time limit (30 min), PV > sp + maxOver, no reading, stop.
  Ku = 4d / (pi sqrt(a^2 - h^2)); Tyreus–Luyben: kp = Ku/2.2, ki = kp/(2.2 Pu), kd = kp Pu/6.3.
  Simulated heaters (gain 1.5–8 degC/%, tau 60–600 s, dead 3–40 s, 60–350 degC): all converge; the
  proposed PID reaches the SP from ambient with <= 0.1 degC overshoot (2.3 degC at 60 degC).
- `local_ctrl`: `localCtrlTuneStart/Stop/Get/Clear`; while tuning the relay drives the SSR (limited to
  maxOut), runaway only "heating failed" (hold check off), sensor / over-temperature faults latch and end
  the tune; "outputs off" ends it; start refused on a fault, without a reading, unless sp > PV + 10 and
  sp <= maxTemp - 15 (maxOver = min(40, maxTemp - sp - 5)).
- Control task: `CMD_TUNE_START` (local only, not while the program runs on that channel; switches its
  manual mode off), `CMD_TUNE_STOP`; manual on / program start refused while tuning; the end is logged
  (`[tune] Top: done: Ku 6.08, Pu 34 s -> kp ... (accept or discard)`); LED "running" while tuning.
- Web: `POST /api/autotune` start / stop / accept (kp/ki/kd -> settings, saved) / discard;
  `channels[].autotune` {state, sp, cycle, elapsed, msg, kp, ki, kd, ku, pu} in `/api/status`.
- To test with hardware (thermocouple + SSR + heater): `{"ch":1,"cmd":"start","sp":150}`, watch
  `channels[1].autotune`, then accept; afterwards a manual SP should settle without overshoot.

#### 9.10.5 State of step 5 (2026-09-30, version 1.0.2)
Decided with Rost before the step: the **old touch / web program editors become read-only** ("run
control only") until the new UIs; **order of the next steps: 5 → 7 → 6** (web page before touch UI).
- `src/duo_program.*` (pure, host-tested): `DuoProgram` (name 32, type, Sequence `SeqPhase ph[100]`
  {kind B/T/BT/P, wait, bIdle, msg, text, Seg b, Seg t} or Timeline `TlStep st[2][100]` {kind target /
  idle / pause, msg, text, Seg} in a union; Seg = {t, r, h}, times uint32 s <= 599940) ≈ 3.9 kB. Pause
  texts in a pool of **16 different texts per program** (40 characters each; decided by me, enough for
  real programs, keeps the struct small). JSON codec exactly as sketched in 9.3.5 (`fmt` 1; unknown keys
  ignored; r/h/wait/msg default; a missing target, wrong kind, > 100 phases / steps, name > 31 or text > 40
  bytes, fmt > 1 are errors with "Phase 3: Top target missing"-style messages using the channel names);
  `progCheckLimits` (spMin/spMax per channel); the three examples of 9.9.
- `src/run_engine.*` (pure, host-tested) replaces `ProgramEngine`. Per channel a setpoint generator
  (from → to over dur, or Idle = outputs off; slope kept for edits); Sequence stages Ramp → [Wait] → Hold,
  Pause; Timeline lanes Ramp → Hold, Idle, Pause, Done. Time advances **event by event** inside `tick()`,
  so results don't depend on the tick length (tested with 0.25 / 1 / 7.3 s). Program pause freezes the
  stage timers and the ramps that belong to a running stage; user pause freezes everything. Outputs per
  channel `ChOut` {inProgram, idle, moving, sp, target, rampLeft, gen}. Run edits `setHold` / `extendHold`
  / `setRamp` / `setTarget` (idx -1 = current / kept target) follow 9.3.4; Timeline shifts use the **old
  end time of the changed ramp/hold as "that moment"** (my reading of 9.3.4: things of the other channel
  before the change point stay aligned). `forecast()` runs a copy to the end (waits satisfied, pauses 0 s)
  and emits plan segments; `programPreview()` does the same from the start.
- `src/program_store.*`: `/duo/progN.json`, N = 0–19, safe save (`progN.tmp` + rename), summaries
  (name, type, items, uses, waits, planned total) kept in RAM; the examples are created when no program
  file exists. Nothing from TempCtl `/progN.bin` is read (9.5).
- Control task: one `RunEngine` drives both channels; per channel: outputs off while idle / on when it
  gets a target, host stepping or controller ramp (Modbus RAMP_CONTROLLER, per channel), end action per
  program channel (a faulted channel is skipped), ramp-register restore and front lock per Modbus channel;
  comm watchdog on the program's channels; manual mode and autotune refused only on the program's
  channels. Start checks: program not empty, used channels not Off / tuning / without SP register /
  without PV, setpoint limits, controller SP.LO/SP.HI. The running copy lives in the control task (web
  reads it under gLock); `CMD_RUN_EDIT` (sub hold / extend / ramp / target), `CMD_NEXT` (Continue in a
  program pause), `CMD_CONTINUE`, `CMD_SAVE_RUN` (writes the running copy into its slot). History and
  plan for both channels; the run chart doubles its span when the run gets longer than planned; the
  plan = the run's setpoints so far + the forecast.
- Settings: `guaranteedSoak` / `soakBand` removed (the old touch "soak band" field and the old page's
  `soakBand` now edit `bottomBand`).
- Web: `/api/programs` (20 slots), `/api/program` GET (Duo JSON + legacy `steps` view) / POST
  (`{"i":n,"program":{…}}` or `{"i":n,"delete":true}`), `/api/run` GET (run state + running copy) / POST
  (extend, hold, ramp, target, save, next, continue), `/api/status` `run` extended, `/api/history?both=1`,
  CSV with both channels. Old page: program editor locked with a note, "Next phase" becomes "Continue" in
  a program pause. Old touch UI: Program tab read-only (bottom channel as steps), Next = Continue.
- Done later: "Run interrupted by a reset" (1.0.18, see 9.10.8) and "Start without saving" (start from a
  draft sent by the web page).
- To test now (bare S3): `/api/programs` shows the 3 examples; `/api/program?i=0` returns the JSON;
  POST a changed program back (and a wrong one → error message); Start program 1 → "Cannot start: …
  uses Top, which is off" (default top = Off), with top set to `local` → "no valid temperature from …".
  Runs need a PV on the program's channels, so run tests wait for the thermocouple converters / PMA:
  then watch `/api/status` `run` (phase, stage, `progPause` after phase 1 → `{"cmd":"continue"}` on
  `/api/cmd`), `POST /api/run {"cmd":"extend","ch":0,"sec":30}` during a hold, `GET /api/run`.

#### 9.10.6 State of step 7a (2026-09-30, version 1.0.3)
Decided with Rost: **step 7 in sub-steps with a commit each** — 7a page base + Status page, 7b program
editor (tables + chart handles, drafts, undo/redo, run edits, start without saving), 7c the other pages
(Programs, Channels, System, Tools), 7d "run interrupted by a reset"; **the TempCtl 1.2 page stays at
`/old`** until 7c covers it, then it is removed.
- `web/index.html` = the new page (one file), built from the 9.3 simulator: sidebar (Status, links to
  `/old`, link status, network, clock, CSV download, theme Auto/Dark/Light in localStorage), run panel,
  chart (both channels: PV thick, SP thin, state lanes, phase lines + times, Timeline hold-end times, pause
  marks, forecast dashed, End; zoom/scroll/pinch as in the simulator; "Live" = the chosen period of the live history), channel cards
  (target ±1/±5 + Set, Extend hold +10 s/+30 s/+1 min, manual switch + SP when the channel isn't in the
  running program, fault + Acknowledge, "why" line), Action required overlay, save-after-run dialog,
  event log. Palette in JS by the spec 6 rule from `accent` (split-complementary ±150°, SP +0.12 L,
  contrast PV 4.5 / SP 3 against the panel; the accent itself ≥ 3:1).
- Preview of a stored program (no run shown) is computed in the page (`planProgram`, same rules as the
  firmware preview); during a run the forecast comes from the device (`/api/chart?v=run` → `fc`).
- Fonts: Barlow 400/500/600 + Barlow Semi Condensed 600 from google/fonts (OFL), subset with fontTools to
  Latin + Latin-1 + Latin Ext-A + a few symbols, woff2 (≈ 22 kB each, 90 kB in all).
- `tools/web_embed.py` (PlatformIO pre-script) → `src/web_assets.h` (gitignored): page gzip ≈ 17 kB.
  Flash: S3 30 %, CYD ≈ 64 % of the app partition. Static RAM +7 kB (event log 48 × 96 chars).
- Firmware: `RunEngine` reports transitions (`PlanEv`: phase / step start, ramp end, hold end, pause,
  continue, end, stop) during the run and in `forecast()`; `chState()` (off / ramp / hold / wait / jump /
  keep / halt / pause / done), `canExtend()`; forecast segments carry `src` and a ramp flag. Control task:
  run events and per-bin state lanes in the history, an engine copy for the web (forecast under gLock),
  **event log** (`logEvent`, ring of 48, also `[event]` on serial; every run message goes there).
  API: `/api/live`, `/api/chart?v=run|live`, `/api/log?since=`; `/` = new page, `/old` = old page,
  `/f/*.woff2` fonts.
- Tested: host tests (events, chState), page with a host mock of the API (engine-generated data):
  desktop/phone, dark/light, Sequence / Timeline / idle preview. Not on hardware yet.
- **1.0.4 (2026-10-01)**: Rost connected MAX31855 #1 + thermocouple to the S3 (bottom channel set to
  `local`): readings work, but the numbers were missing in the channel cards — **fix**: `setNum()` in
  `web.cpp` took a `JsonVariant`, and a `doc["key"]` proxy converted to `JsonVariant` does not create the
  member (ArduinoJson 7), so every number set that way was dropped (`/api/live`, `/api/status`, also on
  the old page); now it assigns through the proxy. The PV showed single-reading spikes of a few °C:
  **median of the last 3 readings** in the local task (≤ 250 ms delay); hardware hint: 10 nF across
  T+/T− at the converter, twisted thermocouple leads away from mains wiring. Event log: boot entry with
  the reset reason, channel link changes and autotune results go to the log too.

#### 9.10.7 State of step 7b (2026-10-01, version 1.0.5)
- Program editor on the Status page (from the simulator): Sequence table (wide) / cards (< 720 px) with
  type, targets, ramps, holds, bottom Idle, "Wait for <bottom name>", pause "Action required" + text;
  Timeline two tables (step / idle / pause); name field; Add / ✕; empty slot → New sequence / New
  timeline. Chart handles (target square, ramp-end diamond, hold-end circle; lifted with a leader line
  where they overlap; ghost + value while dragging, applied on release).
- Drafts per slot in the browser (normalised form, compared as device JSON), Save (`POST /api/program`,
  device validates incl. setpoint limits) / Discard / Undo / Redo (+ Ctrl+Z / Y), "– unsaved" in the
  program list. **Drafts live only in the page** (lost on reload) — enough for now.
- Start with unsaved changes: Save and start / **Start without saving** (`POST /api/run {"cmd":"start",
  "i":n,"program":…}` → control task `CMD_START` sub 1 starts that content; the slot stays as stored, run
  edits can be saved into it after the run) / Cancel.
- During a run the tables and handles edit the running copy through `/api/run` (target / ramp / hold);
  type, wait, pause options, add / delete are locked during a run (the engine has no structural edits).
- Status LED: fault breathing magenta was tried and taken back (1.0.6): red blinking again.
- 1.0.7: build fix for ArduinoJson 7.4 (its `MemberProxy` cannot be copied: helpers that write into
  `doc["x"]` take it by reference and use `.set()`). Checked with ArduinoJson 7.2.1 and 7.4.3.

#### 9.10.8 State of step 7c (2026-10-01, version 1.0.8)
- **The TempCtl 1.2 page (`/old`, `src/web_page.h`) and `/api/settings` are removed** (flash −44 kB in all on
  the S3); `/api/program` no longer sends the legacy `steps` view. `/api/status` stays (`/api/history` removed in 1.0.15)
  for scripts.
- The other pages are in the same page file, chosen by the address (`#/programs`, `#/channels`,
  `#/system`, `#/tools`, anything else = Status; my choice: one file keeps the drafts while switching
  pages and needs no extra request). Polling continues on every page (sidebar link, "Action required"
  overlay); the chart is only fetched / drawn on the Status page.
- **Programs**: list of the slots (type, channels in their colours, phases / steps, time, Selected /
  Running / unsaved badges); Open (selects the slot, opens the Status editor), Duplicate (stored version
  into the first empty slot, name + " (copy)"), Export (the program JSON = file format 9.3.5), Delete;
  empty slots collapsed into one row ("Show all slots") with New sequence / New timeline / Import into the
  first empty slot. During a run only the running program can be opened and nothing new created.
- **Channels**: card "Polling and bus" (`bus.pollMs` — 9.5 — with the 2 × hint, link-loss pause,
  "bottom reached" band, RS485 when the board has it); per channel (tabs with the channel names) one form:
  name, type, end action / end SP, SP limits; Modbus: address, controller type, "Load register defaults"
  (`"modbus":{"loadDefaults":true}` in `POST /api/config`), ramp mode (min step / min write time only for
  ESP32 steps), front lock, register map (collapsible); local: converter, calibration offset / gain with a
  **two-point helper** ("Now" takes the raw reading = (PV − offset) / gain; one point = offset only;
  points ≥ 5 °C apart), PID, SSR window, max. output, max. temperature; runaway limits of the selected type.
  Below: PID autotune (local; start / stop, progress, proposed vs current values, Accept / Discard) or
  the PMA parameter table + actions (Modbus). Changing the type during a run asks first.
- **Settings forms**: fields bound to `/api/config` paths; changed fields marked, out-of-range numbers
  block Save; Save posts only the changed keys and reports values the device adjusted; Revert; the save
  bar sticks to the bottom of the window while a channel form has changes. `cfgGen` in `/api/live`
  reloads the forms (unchanged ones) when the settings change elsewhere (touch, another browser).
- **System**: device info, Restart (`POST /api/restart`, refused during a run), Wi-Fi (network scan via
  `GET /api/wifiscan`, password "empty = keep", AP password, host name), display (accent presets, touch
  theme, brightness, rotation). The web theme stays the browser's own (sidebar).
- **Tools**: Modbus tools for a Modbus channel (find the SP address → "Use … as setpoint address", read,
  write); backup: settings download / restore (without passwords and `limits`), all programs as one file
  (`{"kind":"tempctl-duo-programs","programs":[{"i","program"}]}`) / restore into the same slots.
- `/api/config` GET has `limits` {rs485, localMax}; `/api/live` channels carry the full `autotune` object.
- Tested with the host mock (Playwright): every action posts what it should (partial config bodies,
  load defaults, params / actions with `ch`, Wi-Fi, restore), calibration maths, deep links, phone width.
  Page gzip ≈ 40 kB (was ≈ 24 kB); flash S3 29.6 %, CYD ≈ 63 % of the app partition. Not on hardware yet.
- **1.0.9 (Rost's first test of 1.0.8)**: (a) the program dropdown showed "(empty)" for slots not
  opened yet (labels came only from loaded drafts) → labels from the program list; (b) a shorter polling
  interval did not speed up the page → `/api/live` has `pollMs`, the page polls every
  clamp(pollMs, 250, 1000) ms and draws the newest PV on the chart (line from the last history point to
  a dot at "now"; the Live window moves smoothly, in a run the time marker follows `run.el`); the chart
  history itself is still fetched every 2 s (1 s bins live); (c) Wi-Fi: a new network/password was only
  joined after a restart — `WiFi.begin()` right after `WiFi.disconnect()` is cancelled by the late
  "assoc leave" disconnect event, which the Arduino core does not retry → `netApplyWifi()` disconnects
  and `netLoop()` calls `begin()` 1 s later; a station that stays disconnected is retried every 30 s
  (not during a scan).
- **1.0.10 (Rost)**: **fixed IP address** for the station: settings `wifi.staticIp`, `ip`, `subnet`,
  `gateway`, `dns1`, `dns2` (strings "a.b.c.d", "" = none; DNS empty = the gateway). Validation rejects a
  missing address, an invalid mask, network / broadcast address and a gateway outside the subnet (and
  falls back to DHCP) so a typo cannot lock the device out. Applied with `WiFi.config()` before every
  `WiFi.begin()` (DHCP = config with 0.0.0.0). Web System page: switch + fields (pre-filled from the
  current address), "Save and connect" posts them with the host name, then `/api/wifi`. **Show / hide
  button** (eye) inside both password fields. Touch Setup gets the same in step 6 (parity).
  ArduinoJson pinned to `^7.3.0` (before 7.3 a `const char*` was stored by pointer — found by the
  sanitizer in a new host test; Rost builds with 7.4.3, the cloud build now too).
- **1.0.11**: logo from `logo/` (Rost) as favicon (`/favicon.svg`, `/favicon.ico` 16/32/48,
  `/apple-touch-icon.png` 180 px, square for iOS) and next to the name in the sidebar; files in
  `web/icons/`, embedded by `tools/web_embed.py`. (The touch UI could show it in step 6.)
- **1.0.12 (Rost)**: icons regenerated from the edited logo; chart: state-lane names in the channel
  colours, a separator line under the lanes and more space above the temperature axis.
- **1.0.13 (Rost)**: light / dark **switch** (pill, knob with sun → moon icon, no glow / shadow /
  gradient) instead of the Auto / Dark / Light list — web theme in the sidebar (follows the system until
  switched; switching back to the system's mode returns to "follow") and the touch screen theme on the
  System page; theme changes **fade** (0.4 s colour transition, the chart keeps its elements);
  **thick brightness slider** (accent fill, value in %); **masonry tiles**: `.cards` grids give each
  tile a row span from its height (4 px rows), so short tiles move up next to tall ones (one column:
  normal flow).
- **1.0.14 (Rost)**: the Display settings apply **at once** (no Save / Revert): each change posts the
  changed key to `/api/config`; the brightness slider previews on the touch screen while dragged
  (`POST /api/brightness`, not saved, ≤ 1 per 120 ms) and saves on release. The UI loop already picks up
  brightness / rotation / theme changes from the settings.
- **1.0.15 — CYD out of memory at boot (Rost)**: 1.0.14 on `cyd-1xlocal-1x485` aborted in `webBegin()`
  (`operator new` failed while registering the routes); with `[mem]` logging the next try got to the end of
  `setup()` (49 kB free) but the RS485 UART driver could not be installed by the control task (it ran
  while the first screen was drawn and Wi-Fi was busy). Measured (1.0.15 diag): 242 kB at boot, 201 kB
  after settings/programs, 115 kB after the UI, 63 kB after Wi-Fi, 58 kB after web (TempCtl 1.2: 158 kB
  after UI, 97 kB at the end). Fixes: **control task (UART driver) starts right after `appInit()`**,
  before UI / Wi-Fi; CYD draw buffers 20 → 10 lines (−12.8 kB); chart history and the touch chart copy
  stored as **0.1 °C int16** (`Tenth`, −7.2 kB heap, −3.6 kB static); **`/api/history` removed** (old
  page only; −7.3 kB static). `[mem]` lines at boot stay (free, largest block, minimum).
  Second CYD try: boots (65 kB free at the end of `setup()`), but the page did not load: the "/"
  response stalled (`WiFiClient write(): errno 11` once per second) and the loop watchdog restarted the
  board. Now: assets are sent in 1436-byte pieces straight on the socket (non-blocking, a connection
  without progress for 5 s is dropped and logged with the heap numbers; no watchdog reset), Wi-Fi
  modem sleep off (`WiFi.setSleep(false)`), CYD: `[mem] running` once a minute.
  Third try: still stalled, now in the JSON answers (the open browser tab polls right after boot;
  `WiFiClient::write` again), touch dead while the loop hangs, watchdog reset. Now **every** response
  body uses the same non-blocking sender (`sendBody`), plus Wi-Fi events (connected / IP / RSSI,
  disconnect reason, AP start) and the RSSI once a minute in the log. Open question: why TCP sends
  stall on the CYD (memory, Wi-Fi link, or something on the board); the log of the next try decides.
  Fourth try (CYD runs its own AP, a PC joined it): no crash any more, but even the first bytes of a
  small answer (`/api/live`, headers) cannot be sent (EAGAIN from the start, 50 kB heap free at that
  moment) — TCP sends on the CYD's AP do not get out. Responses are now written completely on the socket
  (status line + headers too; `extraHeaders`), so nothing blocks the loop for more than 5 s.
  **Touch bug found**: the touch drivers report screen coordinates, but LVGL 9 rotates pointer input by
  the display rotation itself → rotated twice, off screen (`Y is 269 which is greater than ver. res`).
  `ui.cpp` now converts to the panel's native orientation first (`touchToNative`, checked for 0/90/180/
  270°). The same applies to the S3 (its touch tested by Rost 2026-10-28: works).
  Fifth try (touch works): Wi-Fi scan from the touch screen → LVGL "No memory" for a 320-byte glyph
  buffer → abort; joining Rost's network → `disconnected (reason 202)` (auth failed) again and again.
  **Finding: the `[mem]` numbers were misleading** — `ESP.getFreeHeap()` / `getMaxAllocHeap()` count the
  IRAM heap too (`MALLOC_CAP_INTERNAL`), which only takes 32-bit data and is useless for Wi-Fi, lwIP,
  LVGL; the "largest block 47092" that never changed is that IRAM block. Real DRAM left after `setup()`
  was only ≈ 18 kB, so Wi-Fi (TX/handshake), lwIP and LVGL ran out — the stalls, the scan crash and
  probably the auth failures. Now: `[mem]` shows DRAM (8-bit internal) free / largest / minimum and the
  IRAM free size, plus loop / control task stack reserve once a minute; **chart history values in the
  IRAM heap** on boards without PSRAM (`Tenth` = int32, accessed word by word only, no memset/memmove;
  −7.2 kB DRAM); the program buffer of the loop task (web, UI) is allocated per request
  (`ScratchProg`, −3.9 kB) and the "start without saving" buffer is freed after the start.
  S3: same code paths (PSRAM: history in normal RAM); worked as AP and on Rost's network with 1.0.14.
  Sixth try: boots, joins Rost's network at once, AP works. Real DRAM: 172 kB after settings, 86 kB
  after the UI (the TempCtl 1.2 touch UI takes 86 kB), 34–37 kB after Wi-Fi, 29–32 kB after web. Loading
  the page (4 font downloads of 22 kB in parallel, plus the API) drove DRAM down to < 1 kB → stalls, and a
  Wi-Fi scan list then crashed LVGL (out of memory). Measured stack use: loop ≈ 7.5 kB of 24, control
  ≈ 3 kB of 8. Now, on boards without PSRAM: loop stack 16 kB (−8 kB), control task 6 kB (−2 kB), one
  LVGL draw buffer instead of two (−6.4 kB), event log 32 entries (−1.7 kB), the selected program's
  preview loaded into a temporary buffer only when it has to be recomputed (selection / stored program
  changed, start PV moved ≥ 1 °C, or every 10 s; −3.9 kB on all boards; since 1.0.48: S3 keeps the parsed
  program in PSRAM and recomputes on a 1 °C move, CYD on a 5 °C move, no 10 s timer), and **the page without web fonts**
  (`/` = a variant without `@font-face` built by `tools/web_embed.py`, font routes not registered;
  system fonts). Step 6 should give the CYD a lean touch UI (the old one is the biggest user).
  **Result (Rost, 2026-10-02): CYD and S3 work** (page, page switching, touch, AP and Rost's network).
  CYD DRAM: 55 kB free after `setup()`, lowest seen 13 kB while the page was used; stack reserve loop
  8.9 kB of 16, control 3.1 kB of 6. Still tight: watch the `[mem] running` minimum; the lean CYD touch
  UI in step 6 is the real fix. Some `disconnected (reason 202)` while joining with the AP running.
  Committed as 1.0.15.
- **1.0.16 (Rost, video from the S3)**: the dot (newest reading, every poll) jumped up and down, the line
  did not show those peaks — a chart slot (live 1 s, run bins) kept only the reading at the moment it
  closed. Now every reading counts: lowest and highest per slot (`liveLo/liveHi`, `runLo/runHi`, in the
  IRAM block on the CYD; run compression keeps min / max), sent as `dlo` / `dhi` (0.1 °C below / above
  `pv`, 0 = none, keeps `/api/chart` small); the page draws each slot through both extremes (nearer one
  first). The visible dips are thermocouple noise (median-of-3 already in the local task): hardware hint
  stays 10 nF across T+/T−, twisted leads away from mains wiring.
- **1.0.17 (Rost: period setting, long history, export, auto scale)**: live history ring in RAM (lost on
  restart, no flash wear), one slot per second, 12 bytes for both channels: PV (last reading) and SP as
  int16 tenths, lowest / highest reading as one byte each below / above PV (0.1 °C up to 19.9 °C, then
  2 °C steps up to 130 °C, rounded outwards). No median of N: it would hide the peaks 1.0.16 made
  visible; last + min + max keeps them and is as compact. Size: S3 24 h (1 MB PSRAM); CYD only the
  IRAM-only heap (iram0.text ends at 0x400941DC → ~48 kB, the run rows take 14 kB; the old "IRAM free"
  also counted the D/IRAM part, which is DRAM): as many 5-min steps up to 1 h as leave 8 kB free —
  about 30 min (boot log `[hist] live history N min`; `[mem]` now prints IRAM-only free). The CYD has
  no cached view rows (computed from the ring per request); the S3 keeps 4 view rows, rebuilt once per
  slot. `display.liveMin` (5…1440, clamped to the history) = Live period for web and touch; the view is
  300 bins of k = period / 300 slots aligned to the slot count (complete bins don't change), newest
  partial (`sh`). Page: Period select (5, 10, 15, 30 min, 1, 2, 4, 8, 12, 24 h up to the history, plus
  the whole history), "N recorded" / "memory holds N", Export CSV; Live Y axis always 0 … highest value
  in view (incl. the newest reading) on a round step. `/api/history.csv` streams (no Content-Length,
  ends with the connection; ~4 MB / 86400 rows on the S3) time_s, uptime_s, per channel pv, min, max,
  sp; `/api/log.csv` without a run = the same.
- **1.0.18 = step 7d "Run interrupted by a reset"** (9.3.5). Engine: `RunPos position()` (run time;
  Sequence phase + stage; Timeline step, stage and seconds left per channel) and `resumeAt()` (host-tested):
  Sequence = the phase from its beginning, channels the phase starts begin at the measured PV, the other
  channel gets the target of the phases before it **at once** (jump; decided by me, Rost may change it);
  Timeline = at the run time, ramp from the measured PV in the time left, hold / idle with the time left,
  a pause asks for Continue again, a finished lane keeps its last target. Firmware: `/duo/run.json`
  (slot, run id, edited, saved controller gradients, running copy) at the start and after each run edit /
  save; `/duo/runpos.json` on every phase / step / stage change and every 60 s; RTC_NOINIT record (magic,
  run id, position, checksum) every cycle — exact after a reset, the flash position after a power loss
  ("about"). Files and record removed when the run ends. Boot: offer + log entry with the reset reason;
  outputs-off written to the program's channels. Resume (`POST /api/run {"cmd":"recover"}`) runs the
  start checks ("Cannot resume: …"), keeps the saved gradient to restore at the end; Dismiss
  (`"dismiss"`) = outputs off, gradient and front lock restored. Starting another program ends the offer
  (after a confirmation on the page; the old gradients carry over to the channels the new run takes).
  `/api/live` `run.intr`; the page shows a banner in the run panel (Resume from phase N / Resume at
  m:ss, Dismiss). Chart after a resume: history before the resume is gone (RAM), lanes empty there.
  Not yet: touch Resume / Dismiss buttons (step 6; the touch message line shows the offer), serial
  `resume run` (step 8).
  Rost's S3 test (2026-10-02): offer and "about" after a power loss OK; the page's event log missed the
  boot / interruption entries (it asked for entries after the old sequence number, the device had started
  again at 1) → the page now notices a restart (`logSeq` or `up` went back), marks it and reloads the log.
  Also in 1.0.18 (Rost): the history records a setpoint only while it is active (Modbus: run, manual,
  kept / set by the end action, until manual off or a fault; local: while the output is on); the Live
  legend switches PV / SP per channel (chart, Y scale, export; localStorage `lvis`); Export CSV =
  `/api/history.csv?pv=<mask>&sp=<mask>` (only those columns, rows without values left out).
- **1.0.19 = step 6 for the S3** (new touch UI, `src/tui_*.cpp`, see section 6 note): main screen as in
  the agreed mockup (header with program / phase / state / time and run buttons, chart of both channels
  with program ↔ live on tap, two channel tiles with PV, SP, output, status, target stepper (run target
  or manual SP, sent 0.7 s after the last tap), manual switch, "+ Hold" (+10 s / +30 s / +1 min / +5 min),
  Acknowledge), overlays on every screen ("Action required", "Run interrupted by a reset" with Resume /
  Later / Dismiss, "Save the run's changes?", messages), menu with Programs (list + table editor: Sequence
  one table, Timeline two tables; undo, save, start / start without saving, rename, delete; during a run
  run edits of targets and times), Channels (general, Modbus, thermocouple, PID + autotune, runaway, RS485
  bus; registers and two-point calibration stay web-only), Network (scan, password with eye, AP password,
  host name, fixed IP), Display (brightness, dark, accent presets, rotation, live period), System (polling
  interval, band, info, restart), Event log. `chartSnapshot(d, live)` gives the live view during a run too;
  `runProgramCopy()` for the editor. Montserrat 16 / 20 enabled (symbols). Host harness: 28 screenshots,
  random-tap test (ASan / UBSan clean). The old exported UI is not built on the S3 (`UI_V2`).
  Rost's review of the previews (2026-10-06): chart without a tile (on the screen background), the
  program / forecast curves dashed in the SP colour at 50 % opacity (even dashes along the whole curve);
  setting rows without tiles and closer together; accent ring no longer clipped; "Manual" label removed,
  the manual switch is now an on / off button (power symbol) filled with the channel's PV colour while on.
  First test on the S3 (2026-10-08): the screen stayed dark on Rost's clone DevKitC, whose 5 V pin sits
  behind a diode (the display's 5 V supply too low); bridged, the screen works. The touch chart lost points
  while moving (1.45 px per point, every 2nd point skipped, so peaks / noise changed from second to
  second): now gathered per pixel column (first / lowest / highest / last value), and the PV of each point
  carries its lowest / highest reading (`ChartData.lo/hi`, S3 only), so short peaks show like on the web.
- 1.0.18 + 1.0.19 tested on the S3 and CYD (2026-10-09, mostly OK; committed as 1.0.19). **Modbus is a beta
  feature from now on**: Rost has no Modbus controller, so everything Modbus / RS485 stays in the firmware but
  is labelled "beta" (touch: channel type, Modbus heading, RS485 tab; web: type, sections, Modbus tools) and is
  left out of the test lists until a controller is available.
- **1.0.20** (Rost's test results):
  - End action "keep setpoint" / "end setpoint": the channel goes on in **manual mode** with that setpoint
    (manual button on, stepper shows it; the button switches the outputs off).
  - Resume after a reset: ramps keep their **planned speed** = |target − previous target| / ramp time
    (first ramp: the speed saved with the position, `RunPos.slope`, runpos.json 4th value), from the measured
    temperature. Sequence: the ramp takes as long as that needs. Timeline: the hold after it takes up the
    difference (`Lane.hold0`), so later steps keep their run time and the channels stay in step (Rost's choice).
  - Restart reason: a requested restart (touch / web) leaves a note in RTC memory, the next boot logs
    "restart on the touch screen / from the web page"; the restart itself is orderly (outputs off, no more
    drawing, backlight off, 0.4 s, then restart). A panic now logs "crash, rst N" (ROM reset code). Rost saw
    "crash" after every restart on the S3: if it stays "crash while restarting", the serial log just before the
    ROM banner has the panic.
  - Touch: the header shows the selected program once another one is chosen after a run; stepper − / + held
    longer than 3 s steps by 5 °C (round values), back to 1 °C after release; the "Run interrupted" dialog
    closes when resumed / dismissed on the web page; messages on the main screen sit over the lower edge of
    the chart (the tile controls stay free), elsewhere at the bottom; tile status "Autotune 200 °C" /
    "Autotune done"; the keyboard has a close button (no change); the Display screen follows changes made on
    the web page.
  - Charts (web and touch): SP lines at 50 % with the area below them filled at 20 % (Rost: fill under SP,
    not PV); live periods 1 min … 24 h
    (`LIVE_PERIODS`, at most what the history holds: the CYD's "whole history" 35 min entry is gone, 30 min is
    its longest); display.liveMin 1…1440.
  - S3 internal RAM went down to about 3 kB free (Rost, touch System info): LVGL allocated every object,
    style and label text with malloc(), which keeps blocks under 4 kB in internal RAM, and the touch screens
    stay created once visited. LVGL now allocates in PSRAM (`LV_STDLIB_CUSTOM`, src/lv_mem_psram.c; internal
    only when PSRAM is full), the touch chart's snapshot too (6 kB). The live history and chart rows were in
    PSRAM already. The S3 also logs `[mem] running` once a minute now (+ PSRAM free).
  - Missing files are checked with stat() (no "does not exist, no permits for creation" errors at boot).
  - Open: CYD "[mem] running" minimum went down to 2.3 kB with the page open and weak Wi-Fi (free stays
    about 43 kB, so no leak); watch it, a lower peak for /api/chart may be needed. The old CYD screens log two
    LVGL "deprecated flag" warnings at boot (generated code, goes with step 6 for the CYD).
- 1.0.20 committed (2adf575, 2026-10-09). Rost: open / untested points (Modbus, run tests on the CYD, 1.0.20
  items) are revisited later; development goes on.
- **1.0.21 = step 6 for the CYD** (2026-10-09): the CYD runs the new touch UI too (`UI_V2` in board_cyd.h);
  one code for both sizes, `TUI_SMALL` (SCREEN_W < 400) in tui.h with size constants (`T_HDR`, `T_BTN`,
  `T_DLG_W`). 320×240 set as decided (9.7, 9.3.3):
  - main: header (program / where, badge, time; tap: program picker), chart 76 px, two tiles (name, status,
    PV, **one SP button** = the setpoint in force (ramping: the moving one) in the SP colour, else the one
    that would be applied; tap: number pad for the run target or the manual setpoint; output bar, "Out x %",
    manual button / + Hold / Acknowledge), **bottom bar: Menu, Run, Stop, Next**; messages over the chart.
  - editor: **Sequence = one line per phase** (# | type | "150° 1:00 / 1:00", "B 160° · T 150° …" | option),
    tap → the phase menu with its values first ("Preheater target: 150 °C" → number pad), then type, wait,
    insert / move / delete; during a run only the values. **Timeline = one table + channel switch** (buttons
    "Preheater · 3" / "IR head · 6").
  - popups, pages, lists, channel settings, network, display, system, log: compact sizes.
  - RAM: only the main screen stays; other screens are built when opened and deleted when left (with the
    editor's draft and undo steps, `progEditRelease()`); undo 2 steps on the CYD (a program is ~3.9 kB).
    The touch chart's copy has no lo/hi on the CYD (`CHART_LOHI` only with PSRAM, 2.4 kB). PC measurement
    (64-bit, so ESP32 needs less): main screen 43 kB, biggest other screen +73 kB (channels), back on main
    +23 kB (allocator / caches, not growing; malloc tracking shows no leak).
  - System info: "RAM x kB free (lowest y)" = the internal byte-addressable heap (was ESP.getFreeHeap(),
    which counts the CYD's IRAM-only heap too).
  - CYD flash image 1.77 MB (56 %, was 65 %: the old exported screens and their fonts are no longer linked).
    `ui/`, `src/ui.cpp`, `src/ui_gen.c` are not built any more (to be removed once Rost has the new UI
    running on the CYD).
- 1.0.21 tested by Rost on the CYD and committed (db87cbc, 2026-10-09): screens fine; lowest free RAM
  14 kB after adding steps to a program without saving and scrolling through the Channels screen.
- **1.0.22 = step 8, part 1: the serial console (7a)** (2026-10-09), `src/console.cpp`:
  - S3: native USB port, TinyUSB CDC (`USBCDC`, ARDUINO_USB_MODE=0), product name "TempCtl Duo"; banner +
    help when a terminal raises DTR, one line on the UART log ("serial console on the USB port"); writes
    only while DTR is set (tx timeout 20 ms, never stalls the loop). CYD: `Serial`, shared with the log.
  - All log output goes through `LogSerial` (`Serial.print*` replaced): on the shared port a log line first
    clears the typed line (`\r ESC[K`), the console shows "> " + the typed text again afterwards.
  - Commands as in 7a, with these choices: **`wifi ap [pw=]`** (the AP name is fixed, `TempCtl-Duo-XXXX`
    per 9.8, so no `ap=<SSID>`; a given `ap=` gets a note); `wifi connect` keeps the new network only
    after it connected (then saved), on failure the previous SSID / password are restored; results:
    wrong password (auth fail / handshake timeouts / MIC failure), network not found (2 × NO_AP_FOUND),
    timeout (25 s); scan list `n  SSID  rssi dBm  auth  ch n` (net.cpp keeps the details of the last scan,
    `netScanDetail`). Added **`dismiss run`** next to `resume run`, and `save` / `discard` answer the
    "run changed the program" question. `start` refuses while an interrupted run is offered (resume /
    dismiss first). `reboot` (also `restart`; refused during a run, like touch / web; logs "Restart
    requested from the serial console"). `api on|off` comes with 7b.
  - Events: S3 prints new event-log entries on the console port (the CYD's log already shows them);
    "Action required" block every 30 s; interrupted run once (again for a newly opened terminal).
  - RAM: command snapshot (LiveData + Settings) on the heap only while a command runs; scan list (800 B)
    from the first scan on. CYD static RAM +0.5 kB; S3 +12 kB (TinyUSB).
  - Fixed on the way: `millis() | 1` as "non-zero now" can be 1 ms ahead, so `millis() - t` wrapped (the
    requested restart sometimes skipped its 0.4 s; touch UI timers fired early) → explicit `if (!t) t = 1`
    / `tTickNow()`.
  - PC test `test/console_host` (shims for Print / Stream / WiFi, stubs for the app layer): scripted typing.
- CYD colours (Rost's photo, 2026-10-09): every colour had red and blue swapped (pink accent shown violet,
  blue as orange, the swatch row in the wrong colours; neutrals unaffected, so the old UI hid it too) →
  `LCD_BGR 0` in board_cyd.h (this panel is RGB; other CYD revisions may need 1). In 1.0.22.
- 1.0.22 tested by Rost (CYD colours fixed, console fine) and committed (bf9a2b3, 2026-10-09).
- **1.0.23 = more console commands** (2026-10-09, help previewed and agreed with Rost):
  - `help` in sections (STATUS, MANUAL CONTROL, PROGRAMS AND RUNS, AUTOTUNE, WI-FI, SETTINGS, DEVICE);
    `help <section>` prints one; `help settings` (also `help set` / `help get`) the full settings page:
    every key with its range / choices, one `e.g.` line per section. Unknown section → error + the list.
  - `watch` (one status line per second, any key stops), `info` (firmware, board, uptime, internal RAM
    free / lowest / largest block, PSRAM, live history length, network, web URL, programs), `log [n]`
    (last n event-log entries, default 20), `ack b|t` (CMD_ACK_FAULT).
  - `tune b|t start temp=<C>` (local channel, 50 … maxTemp − 20, not during a run, no fault), `stop`,
    `accept` (kp / ki / kd into the channel settings, saved) / `discard`; `tune b|t` prints its state;
    `status` shows the autotune state of a local channel.
  - `get [prefix]` / `set k=v …` (up to 8): the web API keys (settingsToJson / settingsFromJson /
    settingsValidate), `b.` / `t.` = channels[0/1], sections bus / run / wifi / display. Value checked per
    type first (number range, int, on/off, choice, IP, register address or empty, accent preset name or
    #RRGGBB, parity none|even|odd); any error → "nothing changed". Applied to a copy, validated, then
    taken over; each key is reported as stored, or "(adjusted: it depends on other settings)", e.g.
    spMax after a lower maxTemp. Saved + notified at once; Wi-Fi keys re-apply Wi-Fi. Modbus / bus keys
    hidden on boards without RS485 (except pollMs). Allowed during a run (like touch / web).
  - `factory reset yes`: settingsDefaults (Wi-Fi included, programs kept), save, restart; refused during
    a run; without `yes` only a warning.
  - `touch cal` (CYD only): overlay on the top layer with 4 crosses 24 px from the corners; the raw
    XPT2046 values are averaged while pressed; result extrapolated to the screen edges (clamped 0..4095),
    rejected if a raw span < 300; 60 s timeout; any key on the console cancels; saved + used at once
    (`touchSetCal`). UI harness: simulated taps give x 199 … 3850, y 3700 … 301 (expected 200 … 3850,
    3700 … 300).
  - `wifi forget`: clears SSID / password, saved, access point only (its name printed).
  - Builds: S3 flash 1.83 MB, static RAM 92.1 kB; CYD 57.5–57.8 % of the app partition, 79.0–79.5 kB.
  - Rost's test on CYD + S3 (2026-10-09): touch cal, set (spMax adjusted), info, factory reset, help
    settings, static IP fine. Fixed: `watch` stopped at once with a CR LF terminal (the LF counted as
    "any key"; the LF of CR LF is now dropped before the watch / calibration key checks); `set set k=v`
    ignored the stray word (now an error, also more than 8 pairs); Wi-Fi re-applied after the `set`
    report (its log lines no longer cut into it); the restart reason was cut to 19 characters ("factory
    res"; RTC note 48 now, magic RST2, reason worked out once); `factory reset` names the real AP;
    "access point started" logged once (mode + softAP both fire AP_START).
- 1.0.23 committed (5430930, 2026-10-09) after Rost's test.
- **1.0.24** (2026-10-09, Rost's requests):
  - Custom accent colour. Web: a 7th "Custom" choice whose circle holds an `<input type=color>` (rainbow
    circle until a custom colour is used, then that colour; the "Custom" text opens the picker too); saved
    on the picker's `change`. Touch: a 7th circle with a pen (outlined; filled with the colour when a
    custom one is active) opens "Custom colour": swatch + #RRGGBB, sliders Hue (scale of 6 two-colour
    gradient segments under a knob-only slider), Saturation, Brightness (20 … 100; darker is no usable
    accent), Cancel / OK. The colour stays exact if no slider is moved (HSV round trip is not exact).
    S3 setting hints now wrap (were cut at 280 px).
  - Screen restart without a device restart: web System → "Restart screen" (`POST /api/screen/restart`),
    serial `screen restart` (also `screen reset`). Done in the UI task: touch controller (FT6336: I2C bus
    recovery = up to 9 SCL clocks + STOP, reset pin, Wire set up again, chip id read; XPT2046: SPI + IRQ
    set up again), pending press dropped (`lv_indev_reset`), display controller: hardware reset (S3 pin
    14; CYD none) and LVGL's whole init sequence sent by a short-lived second LVGL display on the same SPI
    device, PANEL_FIXUP + invert, rotation set again (MADCTL), everything redrawn, brightness again. The
    console reports "display set up / touch controller answers / does NOT answer", or after 5 s "the
    screen task does not respond". Not on the touch screen itself.
  - Console: Up / Down keys recall the last commands (20, 1 kB ring; lines with `pw=` and password
    entries not kept; ESC [ A/B and ESC O A/B). A key that stops `watch` / cancels `touch cal` is used up
    whole (an arrow's sequence does not recall). A `pw=` value stays masked when the line is shown again
    after a log line (was shown in clear).
  - Builds: S3 static RAM 93.2 kB; CYD 80.1–80.6 kB (+1.1 kB: history).
- 1.0.24 committed (7ec0973, 2026-10-09, before Rost's test; he asked to commit).
- **1.0.25 = automatic screen check** (2026-10-09, Rost: "is it possible to detect an unresponsive screen?"):
  - Setting `display.screenCheck` (default on; web Display switch, touch Display row "Screen check",
    `set display.screenCheck=`). Every second in the UI task (`screenWatch`, tui.cpp; was 5 s).
  - Display: LCD MISO now used (S3 GPIO13 shared with the unused SD card; CYD GPIO12). `lcdCheck()` reads
    0Ah (power: bits 4 sleep out + 2 display on), 0Bh MADCTL (bits MY MX MV BGR vs the driver's
    madctl_reg), 0Ch (bits 2..0 = 5). Reads at 4 MHz half duplex: the display's SPI device is removed,
    a slow one (command phase 8 bits + 8 bits in, same CS) added for the reads, then the display's added
    again (devCfg kept). ILI9341: index register D9h = 10h before each read (TFT_eSPI readcommand8).
    The first read right after the init decides whether the status reads back at all (all three as set
    up); otherwise the display part stays off ("[lcd] status: ... check off").
  - Touch: FT6336 chip id read (`touchCheck`), must match the id found at boot; not found at boot = no
    check. XPT2046: -1 (cannot be asked).
  - Stuck press (both): pressed and moved <= 3 px for 60 s → touch restart (3 tries until a release).
  - Two failed checks in a row → restart of that part (display failure: display, plus touch if that
    failed too); max one automatic restart per 30 s; 3 in a row without a passing check → event "restarting
    did not help", stops until a check passes. Each restart: event "Screen restarted automatically: ...".
  - Console `screen check`: display values (power / MADCTL / format), touch state, on/off, automatic
    restarts so far. On the hardware: check the boot line "[lcd] status: ..." — if it says "check off",
    the read needs adjusting (dummy clock / D9 index quirk).
  - Rost's S3 boot log: "power 0xBC, MADCTL 0x78 (0x28 expected), pixel format 0xFF" = value | value << 1
    for all three (0x9C, 0x28, 0x55): the panel answers correctly, the hardware SPI sampled each bit while
    the line already changed to the next. → The status is read in software (~60 kHz): device removed,
    bus freed (spi_bus_free), pins as GPIOs, reads, then spi_bus_initialize + add device again. Sampling
    point chosen at boot from two (late in the high phase / late in the low phase): the one that reads
    the setup back; the boot line then shows "OK (sample n), check on" or both raw sets for diagnosis.
  - Verified on the hardware (Rost, 2026-10-09): S3 "power 9C, MADCTL 28, format 55: OK (sample 1)";
    CYD "power 9C, MADCTL 20, format 05: OK (sample 0)" (ILI9341 with the D9h index read works; its
    format reads 05). The two panels need different sampling points, so the boot-time choice stays.
  - Hidden serial command `screen check test` (not in the help): DISPOFF (28h) + SLPIN (10h) to the
    panel, resets the automatic-restart limits; refused when the check is off or the status is not
    readable. Expected: two failed checks → "Screen restarted automatically: display lost its setup".
  - Tested by Rost on S3 and CYD (2026-10-09): `screen check test` → power 08 → restarted, screen back.
    Then the interval 5 s → 1 s (Rost; cost ~1–2 ms per check: software read + SPI bus set up again,
    one I2C read; a hanging display is noticed after ~2 s).
- 1.0.25 committed (858126d, 2026-10-09) after Rost's test on both boards.
- **Step 8 part 2 = 7b, in three commits** (Rost: "continue with the development", 2026-10-09):
  1. **1.0.26 device `api` mode** — 2. 1.0.27 the page (connect screen + serial transport, same
  index.html) — 3. 1.0.28 the Go launcher. Simplification against 7b: no pushed `status`; the page
  polls `/api/live` over serial exactly as over HTTP (same page code; the polling is the keep-alive).
  - 1.0.26: console.cpp `api on` → `{"t":"hello","api":1,"fw","name","board","variant","host"}`; request
    lines `{"id","m":GET|POST|PING,"p":"/api/...?q","b":{}}` → `webApiRequest()` (web.cpp): SerialReq
    context, `reqHas/reqArg/parseBody/reqUri` read from it, `sendBody/sendStream` answer as JSON lines
    (`{"id","code","body":<raw JSON>}`; text: `{"id","code","type","chunk"}`… `{"id","end":true}`, 1 kB
    pieces with `apiFlush(8192)`); one route table (`ROUTES`) for HTTP and serial. Output queue (heap,
    grows, freed after big answers) written as the port takes it (`availableForWrite`); mutex because
    log lines come from other tasks. CYD: log lines in api mode → `{"t":"log","m"}` (dropped while
    > 8 kB queued, then "(n log lines dropped)"); S3: the log stays on the UART. `api off` or 15 s
    without a request → `{"t":"bye","why"}` and the human console. Request lines up to 16 kB (buffer
    grows, freed after). Buffers: S3 USB CDC RX 4 kB; CYD Serial RX 4 kB / TX 2 kB (was 256 / 0).
  - **Page (part 2)**: web/index.html gets a transport layer: `api()` uses `serReq()` when connected
    over USB (JSON lines; text answers assembled from chunks; per-request timeout ≥ 15 s, re-armed per
    chunk). Off the device (no `data-device` mark — web_embed.py marks the device's copy; the launcher
    marks its copy `data-launcher`) the page shows a connect screen: USB cable (`requestPort`, open
    115200 with DTR + RTS on: no CYD auto-reset, S3 sends only with DTR) or Wi-Fi (address → the
    device's page; remembered). "api on" up to 5 × (CYD may reset on open), hello's `api` checked
    against `API_OK = [1]`. Auto-connect on load to the remembered port (USB ids, until "Disconnect
    USB"); `navigator.serial` `connect` → reload (fresh state, also after a device restart); a non-JSON
    line while connected (CYD restarted) → "api on" again; a `bye` not asked for → "api on" again.
    PING every 5 s when idle. CSV links fetched over USB and saved as files. Playwright test with a
    simulated port answering from the mock server (mock/ser.js).
  - **Launcher (part 3)**: tools/launcher (Go, no dependencies): embeds the site (tools/build_site.py:
    device URL layout), serves `http://localhost:8765` (127.0.0.1 + ::1), `/launcher/id`,
    `/launcher/alive` (the page calls it every 5 s; ends 30 s after the last one, or 2 min without
    any), `/api/*` → 404. Port taken: our launcher → just open a window; else a message box. Opens
    Chrome (Program Files / LocalAppData) or Edge with `--app=`, else the default browser. build.sh:
    version from src/version.h, Windows exe with `-H windowsgui` (6.6 MB), `all` also macOS / Linux.
  - Rost's test (2026-10-09): console api OK (live, chart, CSV chunks, POST); launcher over USB "works
    perfectly". Added: `help api` (also `help json`): how to use the api mode, with examples. Device
    search (Rost chose it for "firewall prompt for network access"): launcher discover.go — legacy
    unicast mDNS PTR queries for `_tempctl._tcp` + `_http._tcp` from a UDP socket bound to each IPv4
    address (Windows asks once: "Allow access"), answers checked via GET /api/live (fw + run present),
    devices kept 30 s; `/launcher/devices` → {devices:[{host,ip,port,fw,board,variant,net}],searching};
    the connect screen (launcher only) lists them every 3 s, a click opens http://ip/. Firmware
    announces `_tempctl._tcp` port 80 with TXT fw / board / api (net.cpp). Tested with a fake responder.
  - Tabs (Rost, 2026-10-09, look of Windows Terminal tabs): web/shell.html = the launcher window at `/`
    (tab bar: icon USB / Wi-Fi / logo + status dot ok/lost, title, ×, middle click closes, "+" new tab;
    active tab in the page colour, separators between inactive ones; light / dark by the system).
    Each tab an iframe (`allow="serial"`): `/app?tab=<id>` (the page; USB session of its own, per-tab
    storage keys `tcd.usb.<id>` / `tcd.auto.<id>`) or the device's own page over Wi-Fi (checked first
    with a no-cors fetch; "does not answer" note, retried every 5 s). The pages report to the shell
    by postMessage `{tcd:1, open|usb|disconnect|state}`; the shell sends `{close}` (USB: api off).
    Tabs saved (`tcd.tabs`) and restored. A device's page shown in a tab has **Disconnect** (bottom
    left) → the tab goes back to the connect screen. Auto-connect tries all granted ports with the
    tab's USB ids (another tab may hold one). Keyboard shortcuts left out (Ctrl+T/W belong to the
    browser). Tested with Playwright: found device opened, USB tab, Disconnect, restore, close.
- Committed 2026-10-10: **1.0.26** (99410ae) serial api mode + help api; **1.0.27** (6e04872) Web Serial
  page, launcher, device search, tabs. Next 1.0.28. (Delete permission per session is needed for git.)
- **1.0.28 = old touch UI removed** (Rost chose it, 2026-10-10): `ui/` (LVGL Pro project, 3 MB), `src/ui.cpp`,
  `src/ui_gen.c/.h`, `src/program.*` (legacy TempCtl step view; its host test and `loadLegacyView` too),
  the `UI_V2` switch (board headers, `#ifdef` around tui_*), the old palette API (`uiPaletteNames/Count`),
  `symlink://ui` in platformio.ini, the ui/ lines in .gitignore, README 4a "old touch UI" and the layout
  lines. Kept: the legacy fields of `/api/status` (published API) and `Settings::themePalette` (in the
  JSON, unused). Flash and RAM unchanged (the linker had dropped the old UI already).
- 1.0.28 committed (23960da, 2026-10-10). Line endings: the repo mixes CRLF and LF files; writing a CRLF
  file back with LF shows it as fully rewritten (happened unnoticed in 1.0.22-1.0.25 for settings.cpp,
  lcd.cpp, tui_menu.cpp, web.cpp, index.html, app_state.cpp, console.cpp, net.cpp, tui.cpp, README;
  fixed before the 1.0.28 commit by amending).
- **1.0.29** (a8d0237, 2026-10-10, Rost agreed): `.gitattributes` — `* text=auto` (stored LF; Git for Windows
  checks out CRLF with its default core.autocrlf=true), `*.sh text eol=lf`, png / ico / woff2 / ttf / exe
  binary; 36 CRLF files renormalized (content unchanged: the diff ignoring CR is only .gitattributes and
  version.h). Since then line endings of written files no longer matter for commits. Note: some files
  in "Claude outputs/" are tracked (the wiring PNGs).
- Rost's retest (2026-10-11): OK — 1-min chart period, stepper acceleration, restart reason, end action →
  manual mode; the Wi-Fi "Scanning…" freeze (section 10) never seen since the fix → closed. Still to
  retest: resume keeps the ramp speed, dialog auto-close / toast position, autotune status; program runs
  on the CYD; CYD memory peak with the page open (2.3 kB once); Modbus (no controller yet).
- Rost (2026-10-11): dialogs / toasts OK. Found: manual screen restarts not logged; the **S3** showed a blank
  white screen in the morning with nothing in the log (manual restart from the web helped); wants a full
  scrollable, colour-coded log on the System page. Decided with Rost: the log holds **everything**
  (events + technical serial lines); **events survive restarts** (flash).
- **1.0.30** (2026-10-11):
  - src/syslog.*: kinds (0 technical, 1 event, 2 run, 3 warning, 4 error; `logClassify` by words);
    byte ring of all lines [len, kind, uptime, epoch, text] (S3 256 kB PSRAM ≈ 7000 lines, CYD 4 kB
    ≈ 50); LogPort::write tees every serial log line (logEvent's "[event]" lines are stored by logEvent
    with their kind); boot number in /duo/boot.txt; events saved to /duo/events.txt ("boot\tepoch\tup\t
    kind\ttext", from the event ring, at most every 30 s and before a requested restart; > 40 kB →
    newest 300 kept). Wall clock: NTP once on Wi-Fi (configTime UTC), else the page POSTs /api/time.
    Host test of the ring (eviction, order, cut at 199, byte limit, tee).
  - LogEntry + kind + epoch, LOG_LEN 96 → 120; `logRun()` for phase / step / end; say() → run if the text
    is about the program / run, else event. Touch Event log and serial `log` show the kinds (colours /
    "ERROR:" "warning:"). /api/log adds kind + epoch; /api/syslog, /api/eventlog.txt, POST /api/time;
    live: sysSeq, boot, time.
  - Web System page: Log panel (filters per kind, search, download; earlier starts from the file as
    sections; time = local wall time when known, else +uptime); Status page event log coloured.
  - Screen: manual restart (web / serial) → event "Screen restarted from … - before: display OK (regs
    9C 28 55 00), touch OK" (to learn what the white screen was); display check reads 0Dh too and
    compares 0Ah (all mode bits incl. booster), 0Ch, 0Dh with the values right after the init (MADCTL
    with the driver's current value) — a panel with the booster off (white, setup intact) is caught now.
  - RAM: CYD static +1.6 kB (LOG_LEN), heap −4 kB (ring); S3 ring in PSRAM.
  - Fix after Rost's test: the System log showed one text on every line (or "�"). ArduinoJson ≥ 7.3 keeps a
    `const char[]` as a pointer (taken for a string literal); syslogRead reuses (and frees) one SysLine,
    so all lines pointed to the last text / freed memory. Now `x.add(JsonString(l.text))` (copied). Rule:
    texts from reused or freed buffers go in as JsonString / String. Also: log texts cut to fit (120 / 199
    bytes, long serial lines split by the tee) no longer end in half a UTF-8 character (`utf8Fit`).
  - Rost's S3 showed "check off": the automatic screen check was switched off there, which is why the
    white screen was not restarted (System → Display "Restart a hanging screen by itself").
- **1.0.31** (2026-10-12): channel outputs on → highlighted tile. ChannelLive.outOn (Modbus: outputsOn_,
  local: PID on or autotune), /api/live + /api/channels `outOn`. Touch main screen: style tileOn[ch] —
  border 4 px in the PV colour, background lv_color_mix(PV, panel, 20 %), padding 3 px less so the content
  stays in place (LVGL counts the border into the content area). Web channel card `.chan.on`: 4 px border,
  color-mix 20 % background, padding 14/11/11. Checked: UI harness shots (both boards, dark / light),
  Playwright (card content at the same x on / off).
  Then: the orange inset ring of a manual card (.chan.man) is removed (the outputs-on style shows it);
  the web manual switch turns manual off at once (no "Switch off?" question), like the touch button.
- **1.0.32** (2026-10-12): Convert to Timeline (web, `seqToTl` in index.html) and SD run logs (S3).
  - Convert: checked against the page's preview model (400 random Sequences: same per-channel curves,
    same pause times, codec round trip) and the device's run engine (300 random Sequences without
    waits, both types simulated side by side: same setpoints / idle every 0.5 s, same end time); UI
    test: dialog, Replace + Undo, Create a new program.
  - src/sdlog.*: PSRAM double buffer 2 × 64 kB (≈ 15 min of rows if the card is not written),
    writer task flushes every 30 s / at the run end / at half full; IDF sdspi + FAT on SPI2_HOST
    (`esp_vfs_fat_sdspi_mount` with the display's bus; unmount removes only the SD device; CS driven high
    again), never formats; file names `YYYY-MM-DD_HHMMSS_<program>.csv` (UTC) or
    `start<N>_run<M>_<program>.csv`, `_2` … if taken. Web: `/api/sd`, `/api/sd/file?name=` (≤ 4 MB,
    copied to PSRAM first so the bus is free while it is sent), `POST /api/sd/delete`; live `sd`.
    Host test of the logger with a folder as the card (names, CSV widths / quoting, no card, list, load,
    delete, the running file protected, dropped rows reported). Static RAM: S3 +0.4 kB, CYD +0.1 kB.
  - To watch on the hardware: the SD card on the display's MISO (the screen check reads the display
    on the same line), UI stutter while the card is written (sdspi holds the bus during busy waits),
    a run start without a card (the probe takes the bus for a moment).
- **1.0.33** (2026-10-12, Rost's video): (1) "Run changed" was not closed on the touch screen when
  answered on the web — the web's "Keep the stored program" only closed its own dialog. New
  `CMD_DISCARD_RUN` (`/api/run {"cmd":"discard"}`, touch Discard, serial `discard`) marks the question
  answered (event "Run changes not saved …"); touch closes its dialog when `runEdited` goes false (or a
  run starts), the web closes `saveDlg` the same way, serial drops its pending question. (2) The chart's SP
  fill moved only with the history (every 2 s / one run bin): `chartHead()` now also takes the active SP
  from each `/api/live` poll (`headSp`: controller SP, else program / manual SP while the outputs are on)
  and extends the SP line + fill to it, like the PV head; the join distance is max(8 s, 2.5 bins).
- **1.0.34** (2026-10-12): Rost's S3 restarted by a watchdog when he stopped a run (1.0.33; no backtrace
  available, the RAM log is lost with the reset). Likely the new SD writer: the SDK's task watchdog also
  watches IDLE on core 0, the writer task had no core affinity (priority 1 > idle), and the sdspi driver
  waits for the card in polling loops without yielding (esp_timer); with no card the MISO line floats
  and noise can look like answers -> long busy retries. Fixes: writer pinned to core 1; internal
  pull-up on MISO before each mount (no card -> 0xFF -> fails at once); mount done step by step
  (sdspi_host_init_device, sdmmc_card_init, ff_diskio_register_sdmmc, esp_vfs_fat_register, f_mount) so
  every failure removes the SD device from the bus again (a device left on the bus would make the screen
  check's spi_bus_free fail); readRegs checks spi_bus_free and puts the LCD device back if another
  device is still there; the control task no longer writes the card (a run start waits up to 2 s for
  the writer to close the previous log). Diagnosis: src/crumbs.* - stage codes of the loop (UI, screen
  check, LVGL, LCD SPI wait, console, web + request path), the control task (cmd n, request, poll, cycle,
  waiting) and the SD card (bus wait, mount, read/write, unmount) in RTC memory; after a watchdog / crash
  the boot logs an Error event "task watchdog - loop: LCD SPI wait 15.0s; control: waiting 0.0s; SD:
  mount 15.2s". Reset reasons now "task watchdog" / "interrupt watchdog" / "watchdog".
- **1.0.35** (2026-10-13): the breadcrumbs caught it: "crash, rst 12 - loop: web /api/sd 0.1s; SD: mount
  0.1s" — the reset at the end of a run was the **web handler mounting the card in the loop task**
  (System page: the SD panel reloads its list when a run starts / ends; most likely a stack overflow:
  FATFS with long names + the SD driver on top of the loop's web / LVGL stack). Rost's files also showed
  rows lost: 1.0.33 file cut mid-row (reset during a write), 1.0.34 file row 0 then 32 s+ (the write at
  30 s failed and the swapped buffer was already gone). Now: **all card work in the SD task** (12 kB stack,
  core 1): web list / load / delete are requests to it (the web waits up to 8 s, "SD card busy - try
  again" otherwise; an abandoned request is cleaned up by the SD task); rows go from the double buffer
  into `pend` (192 kB PSRAM) which is emptied only when the card took it — a failed write is retried
  every 5 s (warning event once "SD card: writing the run log failed (…) - trying again", a warning row in
  the file if pend overflowed), at the run end 3 tries 1 s apart, then "SD card: the end of the run log
  could not be written". Mount: one retry when a card answered but failed; SD clock 10 MHz (shared lines
  with the display). Host test: failed write in the middle -> all 61 rows in order + one warning row;
  web requests through the SD task; end with a failing card gives up with the event.
- **1.0.36** (2026-10-13): 1.0.35 confirmed by Rost (runs logged completely, no crash at stop). Time zone
  (decided: CSV times **local without offset**, zone **from the browser + setting**): `Settings.tzName`
  ("Europe/Berlin" / "UTC+02:00" / "" = UTC; only the name is stored, `tzLookup()` gives the POSIX rule —
  75 zones with summer time rules in settings.cpp, plus UTC±hh[:mm] fixed); applied by `syslogLoop`
  (setenv TZ + tzset when it changes). Auto: the page POSTs `/api/time {zone, fixed}` once while
  `live.tz` is "" (the device takes it only while unset; event "Time zone set from the browser").
  Setting: web System › Clock (select from `/api/timezones` + the browser's offset), touch System › Time
  zone (two steps: region, then place; tChoice now up to 40 rows), serial `set time.zone=…`, `help time`
  lists the zones. SD CSV: column `time` = "2026-10-13 01:05:35" (local), file names local; the web shows
  file times as written. Host test: offsets of Berlin / London / Kyiv / New York / Sydney / Kolkata /
  fixed, the Berlin change on 25.10.2026, every list rule parsed by glibc, settings JSON. Static RAM:
  CYD +0.7 kB (tzName in ~10 Settings copies, the touch lists).
- **1.0.37** (2026-10-13, Rost's list): web pages **Settings** (was System, cog icon; `#/system` still
  works) and **Log** (SD run logs + system log); "RS485 bus" with the yellow beta badge (form groups take
  `beta:true`); title bar 60 px on every page, the jump buttons only when the Status page is one column
  (≤ 1100 px); after a run: **Export CSV** (`/api/log.csv`) + **Back to preview**; sidebar section on
  every page (program, state · time, play/pause + stop = the run bar's buttons; per channel PV · state and
  a manual on/off button; SSR relay state) between the pages and the footer, thin lines between; the two
  CSV links removed from the footer. Fault waiting for Acknowledge: blinking red warning badge on the top
  edge of the channel card (web) and tile (touch, 500 ms). **SSR supply relay** (decided: S3 GPIO 4,
  level selectable `relay.activeLow`, S3 only): local task, after each 250 ms step: on = some enabled
  local channel has outputs on / autotune, and no local channel has a fault; off at once on a fault
  (event "SSR supply relay off: <fault>"); the pin stays an input until the settings set the level
  (then level first, output second). Settings: web Channels › SSR supply relay, touch System, serial
  `set relay.activeLow=on`; live `relay`, config `limits.relay`.
- **1.0.38** (2026-10-13): protections of 9.2a; web **Dashboard** (was Status; `#/dashboard` works),
  Settings page jump buttons (Device / Wi-Fi / Safety / Display / Clock, one column only; a second row
  below the title on phones) and a Safety tile; Channels page: "All channels" tile (polling, link-loss
  pause, bottom band, SSR relay), the channel tile with **page tabs** (name, colour dot, type) attached
  to it, subsections apart with a thin line (`.seps`), PID autotune inside "PID control", the RS485 bus
  inside the tile of a Modbus channel (one shared bus), "Protection" subsection. Touch: Channels rows for
  the new checks, System rows (manual timeout, E-stop, sound, chip warning) and info (E-stop contact,
  chip temperature). Serial: `safety.*` keys, `info` safety line. SSR supply relay: only an active-high
  DC SSR on GPIO4 (`relay.activeLow` removed; the pin is low from the first line of setup); the S3
  schematic in `hardware/s3-schematic/`. Static RAM CYD 84.6 kB.
- **1.0.39** (2026-10-13): firmware update without USB (9.11): web upload (S3 + CYD), SD card (S3),
  image check, rollback; CYD OTA partition table; each board embeds only its own web page. CYD wiring pictures with
  the P4 speaker, CYD KiCad schematics (`hardware/cyd-schematic/`, generator moved to `hardware/gen/`).
  Door / lid switch and 5 V supply check dropped for good (Rost, 2026-10-13: not planned anymore).
  Web: drag and drop of firmware.bin; SSR supply relay switch `safety.relay` in Settings › Safety (the note
  block on the Channels page removed).
- **1.0.40** (2026-10-14): web page in the frosted-glass look (section 7, "Look"), new logo colours (web icons). Dashboard cards
  in the channel colour while the output is on. Touch menu: Programs, Channels, System and Event log use the web
  sidebar's line icons (`src/tui_icons.c`: A8 alpha maps, 24 px, drawn in the accent via the image recolour of
  `S_.acc`); Network and Display keep their LVGL symbols.
- **1.0.41** (2026-10-14): the web chart draws every reading of the polling (section 7, "Chart: every reading").
- **1.0.42** (2026-10-14, c083734): backup of settings + programs on the SD card (9.12); tested by Rost.
- Rost's hardware results (2026-10-14): S3 4" display 180° rotation of picture and touch OK; web firmware upload on
  the S3 OK (CYD not tried yet); touch menu icons OK on the S3; a run without an SD card runs normally (a couple of
  touch hiccups at the start = the card probe). **Open**: (1) with a card inserted, the touch stutters about once a
  second during a run — a held stepper never reaches the 5 °C steps (the press seems to be released each second);
  (2) "Check the SD card" for firmware.bin answers "SD card busy - try again" (likely: reading the whole 1.9 MB
  file through the image scanner takes longer than the 8 s the web / touch / serial wait).
- **1.0.43** (2026-10-14, 4e4510c, tested by Rost: SD check 0.5 s, gaps bridged): Rost: the stutter is only in the **bottom-left corner** of the
  panel, with or without card (probably the panel). (a) The SD firmware check runs in the SD task in the background
  (`sdlogFirmwareCheckStart` / `sdlogFirmwareCheckResult`; 16 kB DMA-RAM reads with open/read; log "[sd] firmware.bin
  checked: n kB in x s"); web `GET /api/ota/sd?start=1` then polls (`{"busy":true}`), touch toast + lv_timer poll,
  serial `fw sd` prints when done (`fwPoll`). (b) Touch drop-out statistics (release + press within 150 ms, by reason
  lift-up / no point / I2C error; logged once a minute, totals in serial `screen check`). (c) `TOUCH_USE_INT 1` on the S3
  with a run-time check (every 25th read regardless; 3 touches found with the line high → polling again). (d) KiCad 10
  ERC (Rost's reports): the only error "Output and Output connected" = the two MAX31855 SO pins on one line → SO and
  the display's SDO are `tri_state` now; the "doesn't match copy in library 'power'" warnings → the power symbols are
  in the project library (`TempCtlDuo:GND` …). `.gitignore`: KiCad `.history/`, backups, `.kicad_prl`, `*.rpt`.
- Rost (2026-10-14): ERC 0 errors / 0 warnings; INT line works; SD install and rollback (power pulled during the
  30 s probation) work; the SD check took ~30 s (whole file, display slow meanwhile). Touch log: only "no point"
  drop-outs (no lift-up, no I2C errors), all over the panel, most bottom-left → (e) gaps of up to 2 reads (~60 ms)
  are bridged (press kept at its last point; lift-up releases at once), stats now "bridged by length / longer";
  log wording avoids "error" (the line was classified as an Error). (f) `OTA_IMAGE_ID` in `.rodata_custom_desc`
  (right after esp_app_desc: address +0x100, file offset 288); the SD check stops at the first 16 kB block that
  has it, size = file size (`ImageScanner::setSize`); older images: whole file. Causes of the gaps to test:
  backlight PWM (5 kHz LEDC; brightness 100 % = steady), USB supply noise / no earth, SPI display traffic.
  Rost's check: 31 bridged gaps per minute at 50 % brightness, 19 at 100 % (none longer): the backlight PWM adds
  some, the rest is the panel / supply. Bridged fine. **1.0.46: backlight PWM 20 kHz** (`LEDC_PWM_HZ` in config.h;
  the CYD's RGB status LED shares channel 0's timer, so the same). Rost (20 kHz): 50 % 2–20 gaps / min (was 31); 100 %
  (255, steady) once 83–144, minutes later 1–5 → sporadic, supply / environment dependent; all bridged, none longer.
  SD card writes during a run: no screen hiccups (Rost).
- **1.0.44** (2026-10-14, 46bae3a, tested by Rost): **slide off to cancel** on the touch screen (Rost, 2026-10-14): a press released more than
  10 px (CYD 6 px) outside the widget it started on does nothing; `slideOffCancels()` in tui.cpp is an event
  callback on the touch indev (its events come before the widget's): RELEASED outside → `lv_indev_reset` (widget gets
  only INDEV_RESET: no RELEASED / CLICKED, so no switch toggle either); LONG_PRESSED(_REPEAT) outside →
  `lv_indev_stop_processing` (stepper repeats pause). Not for sliders, button matrix (keyboard / number pad),
  keyboard, text areas; scrolls cancel clicks already. UI host test `slide()`: slid away = no backup, 5 px = click.
- **1.0.45** (2026-10-14, b16a94b): hosted page on Cloudflare Workers static assets (7b, "Chosen").
- **1.0.46** (2026-10-14, 2811e83): backlight PWM 5 → 20 kHz; `docs/SPEC.md` = pointer to `claude/tempctl-duo-spec.md` (the repo
  copy of this document, updated with each commit); old untracked files moved to `.old/` (ignored).
- **1.0.47** (2026-10-14, e0450f7): web Settings › Display brightness label: 10 (the lowest) = "1 %", linear up to "99 %", "100 %"
  only at 255 (fully on, no PWM) — Rost; "100 %" at 254 had hidden that the backlight still switched.
- **1.0.48** (2026-10-15, 24b3add): fixes from the code review (Claude Docs "TempCtl Duo code review",
  b16a94b; Rost picked the order):
  - **Fix 2, atomic saves**: programs, run.json / runpos.json and settings rename the `.tmp` file over the old one
    (remove + rename only if that fails); at boot a `.tmp` that parses is renamed into place when its file is
    missing (`fsRecoverTmp`, log "[fs] … restored from … (a save was cut off)"), otherwise removed.
  - **Fix 1a, POST header**: every POST needs `X-TempCtl: 1` (403 otherwise; the page's `api()` and the
    firmware upload send it). Cross-site pages can't send it without a CORS preflight, which the device never
    answers. Scripts must add it (README §5). Serial api path unchanged.
  - **Fix 1b, Host check** (lenient, `src/host_check.h`, host-tested): empty, IPv4 / IPv6 literal, the host name,
    the Wi-Fi host name, or one of them + a local suffix (.local, .lan, .home, .home.arpa, .localdomain,
    .internal, .fritz.box, .box, .router, .intranet, .private); otherwise 403, each refused name logged once.
  - **Fix 3, watchdog**: `busRequest` waits in 1 s slices feeding the task watchdog; find-SP scans at most 20 s
    and answers `stoppedAt` (the page continues from there). `handleGetParams` still waits per parameter.
  - **P1** page clock text set once a minute; **P2** polling stops while the tab is hidden (visibilitychange);
    **P4** preview (above); **P8** local task copies only sensor type + CS under the lock; **P9** the top
    channel's SSR window is offset by half a window (no common switch-on instant).
  - **P10 / P5, CYD RAM** (≈ 5.9 kB less static DRAM): the main screen reads the UI tick's snapshot
    (`tuiLive()` / `tuiSettings()`) instead of own copies; program editor keeps only channel names + limits;
    `/api/config` GET/POST, `saveSettingsQuiet` use a heap copy for the time of the call (`ScratchSettings`);
    `/api/live` copies gLive to the heap and only the 9 settings it needs. Left: tui_chan `E`, tui_menu `nEdit`,
    control task `s` / `prev`, the snapshot.
  - **P5** `/api/chart`: numbers through a stack buffer (`jInt` / `jUns`; 0.1 °C from the integer, `jTenth`,
    same text as before, checked for −30000…30000 °C); live view: the rows are taken in one pass under gLock
    (4.8 kB heap, 503 when there is none) and formatted after it. Run view: still formatted under gLock
    (the forecast needs the engine; copying the rows would need ~10 kB on the CYD). Static fields in
    `/api/live` are not gated on cfgGen (small gain, page changes).
  - **P3** S3 live view kept incrementally: a new slot recomputes the newest bin, new bins shift the rows,
    bins reaching past the ring's oldest slot are recomputed (checked against a full rebuild in a host
    simulation: ring wrap, period changes, gaps). CYD: one pass over the history for all rows (was 8–12).
  - **P7** syslog: read cursor kept between calls, at most 64 records walked per critical section; ring copies
    with two memcpy; the serial tee takes its lock once per line. Host-simulated against a reference.
  - **R8** host test: increment before the call, missing initialisers; builds with `-Wall -Wextra` (README).
    **R9** `.vscode/settings.json` untracked (.gitignore), old `Claude outputs/*` moved to `.old/`.
- **1.0.49** (2026-10-15): the rest of the code review (Rost: "go on with the fixes"; his
  scripts don't POST to the device, so the X-TempCtl header needs nothing more):
  - **P10**: the channel settings field table (getters / setters were lambdas: with C++11 the table was built
    in RAM at start, 1.9 kB on the CYD) uses named functions now and stays in flash. Left: the touch edit
    copies `E` (tui_chan) and `nEdit` (tui_menu), 664 B each, kept for simplicity.
  - **P2**: `/api/live?a0=&a1=` also answers the new PV readings (up to 32 per channel, else `rawMore`); the
    page asks `/api/raw` only to fill the start and to catch up (e.g. after a hidden tab): one request per
    poll instead of two.
  - **P1**: the web chart's svg stays; its three parts (axes, run lanes / events, data) are replaced only when
    their text changed (a preview: nothing per poll; live: axes + data; run: data).
  - **Fix 3 (full)**: find-SP and reading the PMA parameters run as background jobs in the loop task
    (`busStart` / `busCheck`, web `job`, moved on in `webLoop`): POST /api/mb/findsp starts, GET asks;
    GET /api/params answers busy with progress until all are read; the page polls. Touch / console tools
    (`busRequest`) say "Bus tool busy" at once while a job holds the bus.
  - **P6**: Modbus waits for an answer with `vTaskDelay(1)` instead of busy-waiting; PV, SP.EF and output
    are read in one request when they lie within 8 registers (PMA 13293..13295); a controller answering that
    with an exception is read register by register from then on (until the settings change).
  - **R2**: the LiveData mirror of the bottom channel and the legacy run view are gone; `/api/status`
    computes its flat fields (same names and values) from `ch[ENGINE_CH]`, `seq` / `lane`, `run[]`.
    `run_engine.h` included once.
  - **R3**: log entries get their kind from the caller (`logEvent`, `logRun`, `logWarn`, `logError`,
    `logKind`, `say(kind, ...)`), no longer guessed from the text (a program called "Fault test" was an
    error); refusals ("Cannot start: ...") are warnings. The word list stays for serial log lines and
    reset reasons (`logAuto`).
  - **R7**: `include/lv_conf.h` holds only the settings that differ from LVGL's defaults (51 lines instead of
    2655); checked: all 636 LV_ macros evaluate the same for both boards, firmware sizes identical.
  - **Bug found by Rost in 1.0.48** (web Channels page full of JSON fragments as names and texts): ArduinoJson
    7.3+ keeps a `const char[]` - which a text field of a const struct is - as a pointer, like a string
    literal. 1.0.48's `/api/config` freed its settings copy before the answer was written, so the names
    pointed into reused memory. Fixed where documents are built (`settingsToJson`, `progToJson`, web
    answers): texts go in as `JsonString(...)` (copied). The same cause made **SD backups since 1.0.42 name
    every program like the last one** (`backupCreate` loads all programs through one buffer); the settings
    in them were fine. Host test `testJsonCopies` (a use-after-free without the fix).
  - Still open from the review: Fix 1 PIN (optional), P5 run-view chart under gLock / static live fields,
    R1 (split app_state.cpp), R4 (console command table), R5 (split the page), R6 (history comments).
  - Rost's tests of 1.0.48 / the 1.0.49 work (2026-10-15): live and run charts on the web smooth (also after
    switching tabs); log colours right; channel names on the touch fine (only the web showed the junk); SD
    backup redone and restored: works; Modbus "Controller type" loads its register defaults; reading the PMA
    parameters without a controller: the touch screen slows down a little while a request waits, fine after.
  - **Touch +/- setpoint jumped back** (Rost): after the value was sent, the tile showed the snapshot's old
    value until the control task took the new one over (next cycle), and a + / - in that time went on from
    the old value, so the new one was lost. Now the tile keeps showing (and stepping from) the value sent
    until the device reports it, at most 3 s (`Tile::sent`). UI host scenario `./uihost stepper` (device takes
    the value over 600 ms late): before the fix the old value showed 15 times and the second press was lost.
  - **Web "Last run" button** (Rost): on the Dashboard chart's program preview, when the device still has the
    selected program's last run (finished / stopped, until a restart or the next run): shows that run again
    (the counterpart of "Back to preview").
- **1.0.50** (2026-10-15, 890a207; Rost's list after 1.0.49, 1f8464a):
  - Web Channels page: the sticky Save / Revert bar reaches the card's edges in the glass style too (its
    padding is 16 / 18 px there, the bar's negative margins were for the plain style's 14 px).
  - Touch Channels screen: a save elsewhere (web, serial) shows within a second while nothing is being edited
    here and no keyboard / list is open (`eGen` = `settingsGen()` of the edit copy); with unsaved touch edits
    the copy is kept (Save then writes the touch values for the channels).
  - Touch Channels screen: the RS485 tab only while a channel is (as edited) a Modbus channel; on it when
    the last one is switched away: back to the first tab.
  - Touch Channels screen: rebuilt after every change, it keeps its scroll position now (opening the screen
    or switching tabs: from the top).
  - SD card: the mount is tried once more after any failure (before: only when the card had answered),
    serial "[sd] ... - trying once more" / "the card answered the second time" to see how often it helps.
  - UI host `./uihost chan`: reload after a web save, RS485 tab, scroll kept (without the fix: 564 -> 0).
- **1.0.51** (2026-10-19, 9a147d0; Rost):
  - Local channels, new settings (web Channels › Thermocouple / PID control, touch Channels, serial
    `b.local.*`): **`readMs`** thermocouple read interval 100 … 1000 ms (default 250; MAX6675 at least 250, its
    conversion time; clamped when saved); **`median`** on / off and **`medianN`** 3 / 5 / 7 / 9 readings (default on,
    3 = the earlier fixed filter); **`tuneMaxMin`** autotune time limit 10 … 240 min (default 70 = Rost's
    `maxSec = 4200` in autotune.h, which stays the struct default).
  - Local task: a 50 ms tick, each channel reads when its interval is due (own dt for PID / autotune / checks);
    "no reading" fault still after 3 bad readings but at least 750 ms of them; a reading counts as current
    for 1 s or 2.5 intervals. The control task, the displays and the history still take the value at the
    polling interval (`bus.pollMs`, 250 … 1000 ms), so a shorter read interval feeds the PID and the median
    filter, not more chart points.
  - Web channel card: the state badge says "Autotune" / "Autotune done" (it said "Idle"; the touch screen and
    the sidebar were right); during an autotune the channel's SP is its test temperature (web, touch, chart).
  - Web live chart: the time marks are times before now counted from the right edge ("now", −0:30, …), so they
    stay put while the curves move (they moved with the curves for up to 2 s and jumped back at each chart
    refresh); solid vertical grid lines at the marks, spaced by `tickStep()` (≥ 64 px, 5 s … 24 h steps) for the
    period and the width.
  - Tests: host (defaults, JSON, clamps), median of 3 … 9 against a sort (100 000 cases), UI host `chan`
    (+ shots 24c / 24d), mock: badge, fields, static marks at 1360 / 420 px and 5 / 60 min.
  - Rost's checks (2026-10-19): MAX31855 at 100 ms steady; the time limit ends the autotune ("time limit
    reached"); the web badge shows "Autotune". His history CSV: the bottom thermocouple (median off) jumps
    by up to 4 °C within a second (per-second spread median 0.4, p90 1.9 °C), the top one by 0.1 / 0.3 °C on
    the same board, also with the heater off: pick-up on the bottom sensor's wiring, not the converter.
    Hints given: 10 nF across T+ / T− at the MAX31855, twisted (shielded) leads away from mains / SSR / heater
    wiring, an insulated (ungrounded) junction, the shield grounded at the converter only. The autotune
    already uses the filtered PV (median when on).
  - Same round (1.0.51), web: **autotune controls** on the Dashboard channel card (a row
    "Autotune" with Stop autotune / Review the result… / Clear) and in the sidebar (the channel's button
    becomes stop ■ / review ✓ / clear ✕ while an autotune exists; the sidebar text: "Autotune" only while it
    runs, "Autotune done", else Idle / Manual). A finished autotune opens a **dialog** once per result while
    the Dashboard is shown: current and new Kp / Ki / Kd, Accept (`cmd accept`), Edit… (inputs; Save these
    values = POST /api/config with the values + `cmd discard`), Dismiss (`discard`), Later.
  - **Live view first** (web `view = 'live'`, touch `chartLive = true`); a run starting, opening a program
    (Programs page) or choosing one (Dashboard select, touch picker) switch to the program view.
  - **Hover** on the Dashboard chart: dotted line, a dot per curve, a box (live: clock time + time before now;
    run: run time; preview: plan values); mouse / pen, a finger on the live chart; the hover layer takes no
    pointer events (the program chart's handles stay draggable).
  - **CSV replay** page (third in the menu, `#/replay`): opens the device's CSVs (history / last run, SD run
    logs: time / time_s / run_s, `<ch>_pv/_sp/_min/_max/_plan/_prog/_out`, SD events as dotted marks) from a
    file, a drop, "Device history", "Last run" or Log › Replay; zoom (wheel, pinch, buttons, Shift + drag
    range, double click = all), pan, hover, legend toggles, Crop to view, Save CSV (the original lines of the
    range). CYD flash 92.1 % after this (the page grew ~9 kB).
- **1.0.52** (2026-10-20; Rost): **releases + online update** (9.13), more free internal RAM on the S3.
  - Rost's answers (2026-10-20): the autotune uses the channel's own filter settings — already so (it gets
    the same median-filtered, calibrated PV as the PID; nothing changed, README says it now). The S3's
    WS2812 on GPIO48 and its touch were confirmed by Rost earlier (9.6 updated). The hosted page stays on
    Cloudflare Workers (7b; GitHub Pages dropped). The desktop app gets release builds.
  - Decisions (Rost picked the proposals): install from the release page through the **web page on both
    boards** (the browser downloads, the normal upload installs) and **on the S3 also from the device
    itself** (touch, serial; the CYD has no RAM for TLS); builds on **GitHub Actions**; **every push to main**
    is a release; desktop app for **Windows, macOS and Linux**.
  - **Internal RAM on the S3** (Rost, 2026-10-20, after the TLS "Memory allocation failed" at 76 kB free; he picked
    the moves from Claude's list, not the loop-stack reduction):
    - `src/psram.h` `PSRAM_VAR(T, name)`: on PSRAM boards a reference to a zero-filled PSRAM block (constructor
      run for non-trivial types; arrays keep `sizeof`), elsewhere a plain static. Moved: event log ring (6.7 kB),
      the static Settings copies (control task's `prev`, backup ×3, touch snapshot / Channels edit / Network edit),
      touch LiveData snapshot, program summary lists (store, web, touch ×2), touch popup item lists, Wi-Fi scan
      lists (web, touch), console history. Not moved (hot or tiny): the control task's settings copy `s`, channel
      slots, `loc`, run anchors, gLive / gSettings. S3 static RAM 98.3 → 75.1 kB.
    - `heap_caps_malloc_extmem_enable(256)` first in setup (S3): malloc ≥ 256 B → PSRAM first (core: 4 kB). Safe
      because no IRAM ISR of ours touches heap memory; Wi-Fi, FreeRTOS, stacks, DMA ask for internal RAM
      explicitly; flash writes from PSRAM buffers (Update's 4 kB buffer, upload buffer) are bounced by the IDF.
    - Display draw buffers 2 × 32 → 2 × 20 lines (board_s3.h `LCD_BUF_LINES`): 2 × 18.75 kB (−22.5 kB). They stay
      in internal DMA RAM (SPI DMA from PSRAM would need a bounce copy).
    - Result (Rost): `[mem] running: DRAM free 149536, largest 139252, min 147980` (before: ~76 kB free, largest
      67 kB). Touch drawing still smooth; web upload and SD backup work.
  - Rost's tests: `tools/release_local.sh --no-app` (deployed with his wrangler login; Go not installed yet), the
    CYD's web page found and installed 1.0.52; the S3 first failed ("SSL - Memory allocation failed", fixed with
    mbedTLS in PSRAM, 9.13), then found and installed 1.0.52 from the touch screen.
- **1.0.53** (2026-10-20, 4f75037; after 1.0.52 = 703ccf4): `wrangler deploy --tag v<version> --message <commit subject, ≤ 100>`
  (workflow) / `"<version> local build from <commit>[ + uncommitted changes]"` (release_local.sh), so Cloudflare's
  deployment list no longer says only "Manually deployed" (Rost). The version is read with `tr -d '\r'` (a CRLF
  version.h on Windows; also in tools/launcher/build.sh).
- **1.0.54** (2026-10-20; Rost asked whether drawing can be faster, picked steps 1–3 now, the
  second core for drawing and a shorter refresh period next): 
  - **Frame rate meter** (lcd.cpp `lcdPerf`; ui.h `uiPerf`; serial `perf on|off`, touch Display › Frame rate meter,
    not saved): own measurement instead of LVGL's perf monitor (that one is created with every display, and
    `lcdReinit`'s short-lived second display would leave its timer behind): display events RENDER_START/READY
    (frame time), FLUSH_WAIT_START/FINISH (waiting for SPI), SPI busy time from queueing to the post callback,
    bytes sent, `lv_timer_get_idle()`; label on the system layer (bottom right, Montserrat 12) + `[perf]` line
    every second.
  - **SPI clock setting** `display.spiMhz` 20 / 40 / 80 (default 40; validate snaps < 30 → 20, < 60 → 40, else
    80): `lcdSetSpiMhz` removes and adds the SPI device with the new clock (fallback to the old one on an error),
    redraws; applied by the UI tick (tui.cpp) when the setting differs (a failed clock is not retried until the
    setting changes). Web Settings › Display select, touch Display › Display SPI clock (choice), serial
    `display.spiMhz=20|40|80`. Host test (default, JSON, snapping).
  - **No swap pass**: display colour format `LV_COLOR_FORMAT_RGB565_SWAPPED`; `sendColor` no longer calls
    `lv_draw_rgb565_swap` (LVGL's SW renderer blends straight into big-endian RGB565).
  - Tests: host, console host (perf, spiMhz set / refused value), UI host shots 12e/12f (both boards), Playwright
    `mock/spi.js` (select, POST), S3 + CYD builds.
  - **Rost's measurement (S3, 2026-10-20)**, `[perf]` lines:
    | state | SPI | FPS | LVGL CPU | frame (draw / wait) | SPI busy | data |
    |---|---|---|---|---|---|---|
    | Dashboard, nothing touched | 80 | 5 | 14–17 % | 17–22 ms (all draw) | 1–2 % | 160–210 kB/s |
    | still screen | 80 / 40 | 1 | 0 % | 8–10 ms | 0 % | ~20 kB/s |
    | busy (near full-screen redraws, ~250 kB per frame) | 80 | 14–15 | 94–95 % | 60–68 ms (draw 60–68, wait 0–1) | 36–41 % | 3.4–3.9 MB/s |
    | the same | 40 | 12–14 | 95–96 % | 68–73 ms (draw 66–70, wait 1–2) | 66–72 % | 3.2–3.5 MB/s |
    **Finding: the drawing (CPU) is the limit, not the SPI**: waiting for the transfer is ≤ 2 ms per frame even
    at 40 MHz, and 80 MHz gives only 13 → 14–15 FPS on busy screens (it halves the SPI load, which also leaves
    more of the bus to the SD card). LVGL draws ~3.7 MB/s; a 30 ms refresh period is far from reached (frames
    take 60–70 ms), so a shorter period would not help yet. 80 MHz ran without wrong pixels on Rost's wiring.
    Next candidates: drawing on both cores (LVGL OS = FreeRTOS, 2 SW draw units), the ESP32-S3 SIMD blend
    routines (esp_lvgl_port's assembly fill / blend for RGB565), cheaper styles on large areas (gradients,
    shadows, opacity). The idle Dashboard redraws 5 × per second (~35 kB each: the values, the live chart).
  - Seen in the same log: one "Screen restarted automatically: touch controller does not answer" while the
    LVGL loop was at 84–95 % CPU (the touch is I2C, not on the display SPI); to watch whether it comes back.
    `[mem] stack free: loop 18108` of 24 kB (S3): the loop uses ~6 kB.
  - **Faster drawing, round 2** (Rost picked: both cores, the S3 SIMD routines, the chart as a cached picture):
    - **Both cores** (S3, include/lv_conf.h): `LV_USE_OS LV_OS_FREERTOS`, `LV_DRAW_SW_DRAW_UNIT_CNT 2`,
      `LV_DRAW_THREAD_PRIO 1` (= tskIDLE + 1, the loop task's priority: below control 3 / local 4), stacks 2 × 8 kB.
      All LVGL calls stay in the loop task (other tasks only set flags: screen restart, OTA overlay); the draw
      threads only render during a refresh, which the loop waits for. CYD: unchanged (one unit, no OS).
    - **Chart cache** (S3, tui_chart.cpp `CHART_CACHE`): the chart is an `lv_canvas` with an RGB565 draw buffer
      (lv_malloc = PSRAM, 472 × 132 × 2 = 124 kB); `chartUpdate` (once a second) hashes (FNV-1a) the snapshot,
      view, size and theme colours and draws only when that changed: buffer filled with the screen background,
      `lv_canvas_init_layer` → the old drawing code (`render(layer, area)`) → `lv_canvas_finish_layer` (draws,
      waits, invalidates). On the screen only the picture is copied. A rebuilt main screen gets the buffer again
      (`cObj`); a new size makes a new buffer. CYD: drawn directly as before (no PSRAM).
    - **Back to RGB565 little endian + the swap in sendColor** (reverts the 1.0.54 "no swap pass"): the ESP32-S3
      SIMD fill / blend routines (next step) and the chart picture copy work on RGB565; the swap is ~0.1 ms per
      20-line part, measured frames take 60–70 ms.
    - **Rost's measurement** (S3, 80 MHz): idle Dashboard 12–15 ms per frame (before 17–22: the chart cache
      works); busy screens **slower**: 2–9 FPS, frames 74–107 ms (before 14–15 FPS, 60–68 ms), several seconds
      with frame times ~100 ms at 0 % LVGL CPU, touch and scrolling sluggish ("stops all the time").
      → **Both cores reverted** (LV_USE_OS none again): a frame is thousands of small draw tasks (glyph runs,
      fills, chart pieces); with draw threads every task is handed over and its completion signalled between
      tasks, which costs more than the drawing (and both cores then compete for PSRAM, where LVGL's objects
      and styles are). Kept: the chart cache, RGB565 + swap.
    - The same log again had "Screen restarted automatically: touch controller does not answer" (also seen in
      the first measurement, without the draw threads): to look into separately.
    - **Rost's measurement after the revert** (S3, 80 MHz, chart cache, one draw thread; "better now, no rapid CPU
      spikes, smoother"):
      | state | FPS | LVGL CPU | frame | SPI busy | data |
      |---|---|---|---|---|---|
      | Dashboard idle | 5 | **4–5 %** (before the cache 14–17 %) | **12–13 ms** (17–22) | 1–2 % | ~160 kB/s |
      | still screen | 1 | 0 % | 5–9 ms | 0 % | ~20 kB/s |
      | busy (near full-screen redraws) | 12–13 | 88–95 % | 55–74 ms | 29–36 % | 2.8–3.5 MB/s |
      | between (smaller redraws) | 2–8 | 0–60 % | 25–60 ms | 3–23 % | 0.3–2 MB/s |
      Busy screens are as before the cache (CPU-bound, ~13 FPS): the next step there is the SIMD fill / blend
      code. Some seconds show long frames (up to 132 ms) at "0 %" LVGL CPU: LVGL's idle figure is measured over
      its own 500 ms windows and read once a second here, so it is coarse for short bursts (not a stall: the
      UI felt smooth). RAM steady: DRAM 149.5 kB free (largest block 139 kB), PSRAM 4.36 MB free (the chart
      picture took ~124 kB), loop stack 17.8 kB unused. No touch restart in this log (2 short gaps bridged).
      The S3's own release check worked in the same run (`[ota] release page: 1.0.53 (2121 kB)`).
    - **Rost: a longer chart costs a lot of CPU**: idle Dashboard 2 FPS, frames 22–30 ms, but "LVGL CPU 81 %"; 0 %
      on a still screen, ~7 % with a static program chart. The CPU went into drawing the chart picture (inside
      an LVGL timer, not part of a display frame): LVGL made thousands of small draw tasks (round-ended line
      pieces, a 1 px rectangle per area column) and blended them into the picture in PSRAM column by column
      (each pixel another cache line): ~0.8 s per second. **Fix: own raster for the chart's data** (S3,
      tui_chart.cpp): pass 1 = grid + labels through LVGL into the picture (few tasks), pass 2 = areas, curves,
      "now" and plan-end lines straight into the RGB565 pixels: per curve the centre line's vertical extent in
      each column (all pieces), then one span per column widened by the line width (neighbour columns: steep
      parts keep their width), anti-aliased top / bottom, alpha blend (5-bit, 32-bit lane trick); dashes as
      before (standalone dashed lines: each dash stroked by itself); areas row by row (sequential memory).
      Looks as before (UI host shots compared), slightly cleaner joints (no doubled 50 % pieces). UI host
      `./uihost chartbench` (x86 -O2): 6.4 ms (all LVGL) → 0.31 ms (raster) per drawing of the live chart.
      The frame rate meter now adds "chart n x t ms" (drawings of the picture per second, `lcdPerfChart`).
    - **SIMD routines** (Rost cloned espressif/esp-bsp into `.old/esp-bsp`, commit f259a6a; esp_lvgl_port 2.9.0,
      Apache-2.0): `src/simd/` = `lv_color_blend_to_rgb565_esp32s3.S`, `lv_color_blend_to_argb8888_esp32s3.S`,
      `lv_rgb565_blend_normal_to_rgb565_esp32s3.S`, `lv_macro_memcpy.S` (unchanged but a `#if defined(BOARD_S3)`
      guard: empty objects on the CYD), their `LICENSE`, a README (origin, changes). esp_lvgl_port builds them
      only for LVGL 9.1 (its wrapper uses 9.1's `_lv_draw_sw_blend_*_dsc_t`): our own wrapper
      `src/simd/lv_blend_esp32s3.c` maps LVGL 9.6's `lv_draw_sw_blend_fill_dsc_t` / `..._image_dsc_t` to the
      assembly's `asm_dsc_t` (opa, dst_buf, dst_w, dst_h, dst_stride, src_buf, src_stride, mask_buf,
      mask_stride; fills pass `&dsc->color`, read as one aligned 32-bit word: static asserts for the offset and
      `lv_color_t` = blue, green, red). Hooks in `include/lv_blend_esp32s3.h` (`LV_DRAW_SW_ASM_CUSTOM_INCLUDE`,
      lv_conf.h, S3 only): `LV_DRAW_SW_COLOR_BLEND_TO_RGB565`, `..._TO_ARGB8888`,
      `LV_DRAW_SW_RGB565_BLEND_NORMAL_TO_RGB565`; LVGL calls them only without mask and at full opacity. The
      assembly checks alignment itself (16-byte stores, else 4-byte / byte paths; widths < 16 / < 8: plain
      code) and returns LV_RESULT_OK. Run-time switch `lvSimdOn` (serial `perf simd on|off`, ui.h `uiSimd`;
      the screen is drawn again) for comparing with the frame rate meter. Not runnable on the PC (Xtensa PIE):
      checked by the S3 build (symbols linked, `lv_draw_sw_blend_color_to_rgb565` calls `lvSimdFillRgb565`);
      Rost to compare `[perf]` with SIMD on / off and look for wrong pixels.
    - **Rost's measurement with SIMD** (S3, 80 MHz, chart raster; the log does not mark `perf simd on/off`):
      | state | FPS | LVGL CPU | frame | chart picture |
      |---|---|---|---|---|
      | Dashboard, long live chart | 5 | 4–11 % (before the raster 81 %) | 11–16 ms | 1 × 9.3–15 ms per second (grows as the chart fills) |
      | still screen | 1 | 0 % | 7–11 ms | – |
      | busy (near full-screen redraws) | 11–15 | 89–95 % | 61–74 ms | – |
      Busy screens are as before SIMD (12–15 FPS, 55–74 ms): solid fills and copies are not what costs on them —
      text (A4 glyphs blended), rounded corners / borders (masks) and anti-aliasing stay in LVGL's C code. No wrong
      pixels reported. RAM: DRAM 144.5 kB free (largest 131 kB; −5 kB: the raster's column arrays), PSRAM 4.36 MB.
      The chart raster works: "chart 1 x ~10–15 ms" instead of ~800 ms of CPU per second.
- **1.0.55** (2026-10-21; after 1.0.54 = 03a215f): **S3 loop task stack 24 → 16 kB** (Rost):
  his logs showed at most ~6 kB used (`[mem] stack free: loop 18436`); frees 8 kB of internal RAM. It stays
  in internal RAM (a PSRAM stack is not allowed by this core's sdkconfig, and the loop writes flash, when
  PSRAM cannot be read). New: an event "Loop task stack nearly used up: n bytes were left at the lowest"
  (once per start) when the minute's high-water mark is below 2 kB.
  Rost's check: `setup done: DRAM free 158332` (before 150416: +8 kB); after a minute `loop 10352` bytes
  free (~6 kB used), after scrolling, web use, SD reads and an online update check `loop 9664` (~6.7 kB used,
  9.4 kB margin); DRAM running 145–148.5 kB free (lowest 130 kB, largest block 123–127 kB), PSRAM 4.3 MB.
- **1.0.56 README rewrite** (2026-10-21; after 1.0.55 = 440468b; Rost: "edit or rewrite it
  according to the current development state"): README.md reordered and brought up to date — intro (two
  boards, channel types local / Modbus beta / off, status), 1 Hardware, 2 Build and flash (+ full image from the
  release page at 0x0), 3 Touch UI, 4 Serial console, 5 Web page, 6 USB / local app, 7 Releases, 8 Channels,
  programs and runs (manual setpoint written for both channel types; pause / end / reset), 9 Modbus controllers
  (beta: PMA interface, ramp modes, other controllers), 10 Web API, 11 Project layout (new files: simd,
  lv_mem_psram, raw_hist, syslog, crumbs, net, ca_roots, release_local.sh …), 12 Safety, Status. Dropped: the
  step notes and TempCtl 1.2 remarks, the bring-up panel, "(later)" pins, the setpoint-write counter; touch
  paths now "Menu › …"; CYD image 1.83 MB (93 %); the touch calibration note moved to the CYD hardware part.
- **1.0.57 wiki** (2026-10-21; after 1.0.56 = 12edb9e; Rost: "a structured Wiki with description / instructions /
  wiring illustrations and simulated screenshots for the Web-UI and touch interface, available from the Cloudflare
  page and the README"; decided: Markdown in the repo, pictures scripted and committed, new wiring diagrams,
  English only): see 9.14.
- **Channel tiles and program editor, layout "A"** (2026-10-21, for 1.0.58; after 1.0.57 = eea0e5f; Rost picked
  option A of three mockups, with changes): web page only.
  - Channel tab content (tabs and "All channels" unchanged): `mkForm(…, {cards:true})` renders one **card per group**
    (`.ccards` 2 columns, 1 below 900 px; group `c` = edge / title colour, `sub` = subtitle, `full`, `c2` = rows in
    two columns, `det` = collapsible full-width card) and **one row per setting** (`.crow`: name left, value right;
    the hint behind an (i) button, `.ci-i`, toggles a `.ch` line; the title attribute shows it on hover). Field extras:
    `j` joins the previous row, `pre` text before the input, `rl` row label, `rh` row hint, `btn` html after the input,
    `sent` sentence row (switch, bold name, values as a sentence). updForm hides a row when all its fields are hidden
    and marks it `chg`. The field model (keys, fill / read / dirty / partial save) is unchanged.
  - Cards: General (setpoint range lo … hi in one row), Modbus controller, RS485 bus (full, 2 columns), Register
    addresses (collapsible), Thermocouple (calibration × gain + offset in one row, *Two-point…* opens the helper
    below), PID control (Kp · Ki · Kd in one row), PID autotune (new group: time limit, test temperature, state,
    Start / Stop, result), Protection (full width, sentences: runaway as two lines under one switch — the firmware
    has one enable —, heating while off, reading frozen, converter too hot). New colour `--violet` (autotune).
  - Program editor: the values that can be changed are darker fields (radius 8, inset shadow; light theme: the
    light field colour), the step / phase type a dropdown (`select.k`, Idle muted, Pause amber), headers "Step
    type" (Timeline) / "Phase type" (Sequence); ramp and hold as **m:ss** text fields (`timeIn`, `parseT`: m:ss,
    h:mm:ss or seconds; invalid input is reset); new read-only **Ends** column (cumulative, waits / pauses
    not counted); delete × faint until the row is hovered (hover devices); tighter cells so the Sequence table
    fits 1280 px. Page +2.6 kB gzip; CYD 93.4 %.
  - Tests: Playwright on the wiki demo device (m:ss / seconds / h:mm:ss / invalid, type change, Timeline hold + Ends,
    channel save posts only the changed key, runaway off hides its rows, type off leaves General; phone 390 px no
    sideways scroll), the older mock tests itest / itest3 / itest4 pass. Wiki web pictures regenerated.
  - Rost (phone): *Save* of "All channels" stayed off after changes — the polling interval was 100 ms (min 250), but
    the out-of-range mark never showed (the glass input style and the amber "changed" rule were more specific than
    `.fld.bad input`). Now red with higher specificity (also the label / the card row), and the form's message names
    the values and their ranges ("Not saved — outside the allowed range: Polling interval: 250 … 10000 ms."); it goes
    away when they are fixed. All forms (also the auto-saving ones).
  - **Polling interval lower limit by the channels** (Rost: "limited by the lowest possible value for the current
    configuration"): `pollMinMs(s)` (settings.cpp) = 100 ms when every channel in use is local with a MAX31855
    (or off), else 250 ms (a MAX6675: up to 220 ms conversion; Modbus: bus time). `settingsValidate` raises
    `pollMs` to it without an error (so a channel change never fails because of it). Web: the field's min follows the
    saved channels (`pollMin()`, getter), a channel save that raised it says "The polling interval was raised to
    250 ms …"; touch: the number pad's lower limit, Channels save toast "Polling interval raised to 250 ms."; serial:
    `bus.pollMs` 100 … 10000, a `set` that raises it prints "bus.pollMs=250 (raised: …)". The control task's cycle
    follows it (100 ms works: 10 ms task delay); the web page still refreshes at 250 ms at most, the chart
    history stays per second, the raw PV history fills faster (3.6 h at 100 ms). Host test + console host test.
  - **Connect screen** (hosted page, local app; Rost: the wiki line was too subtle): own card "Manual and wiring"
    between Wi-Fi and Downloads (one line, quick links Getting started / Wiring S3 / Wiring CYD / Troubleshooting as
    pills, button "Open the wiki ↗", all to https://tempctl-duo.just-r0st.workers.dev/wiki/…, new tab) instead of the
    hint line; every card title has a line icon in the accent colour (USB, Wi-Fi waves, book, download arrow; the
    sidebar's stroke style). Wiki web pictures regenerated (all 44), Desktop-app.md mentions the two cards.
- **Touch "does not answer" restarts** (2026-10-22, for 1.0.59; after 1.0.58 = 391c840): Rost saw "Screen restarted
  automatically: touch controller does not answer" twice while the screen drew hard (LVGL 84–95 % CPU, SPI busy). The
  check read the chip id (0xA3) once a second and restarted after 2 failed seconds — one bad read per second was
  enough. Likely cause: the FT6336's I2C (400 kHz, module pull-ups) next to the display's SPI wires (40–80 MHz) in the
  same ribbon; only Wire uses I2C, all in the loop task, so no concurrency. Now (touch_ft6336.cpp): up to 3 reads 2 ms
  apart per check; a touch read that worked in the last 1.5 s also counts as an answer; every failed read is logged
  with its reason from Wire (`[touch] chip id check: …`: address / register not acknowledged, bus error, timeout,
  short read, wrong chip id) and counted (`screen check`: "chip id checks n: x needed a retry, y answered by a touch
  read, z no answer; failed reads: …"); the restart event names the reason ("touch controller does not answer
  (timeout)"). If the log shows many retries, next step: I2C at 100 kHz and / or shorter / separated wires.
- **Browser demo** (2026-10-22, for 1.0.59): Rost: a button on the hosted page for a demo in the browser, a simulated
  1100 W bottom + 450 W top heater warming a medium GPU board; start heaters and programs, edit programs, channel
  settings, accent colour, light / dark. Decisions (Rost): the firmware's own code as WebAssembly (not a JS mock);
  real time with speed-up 2× / 5× / 10×; settings and programs kept in the browser + "Reset demo"; web page only
  (no touch screen). Done: `demo/` (README.md there): `sim.cpp` = the board (clock, the tasks stepped every 10 ms,
  pins incl. MAX31855 / MAX6675 frames bit by bit, E-stop, relay, buzzer, LittleFS in memory, 4-body heat model:
  emitters, board, GPU zone; thermocouples bottom on the board, top on the GPU), `stubs.cpp` (Wi-Fi, display, SD,
  OTA, LED, console), `shim/` (Arduino, FreeRTOS one-thread stand-ins, ESP-IDF, LittleFS, WebServer),
  `board_demo.h` (`BOARD_DEMO`, no RS485). Firmware hooks without effect on the boards: `controlTaskBegin()` /
  `controlTaskStep()` and `localCtrlTick()` (the task loop bodies), `BOARD_DEMO` in config.h and web.cpp
  (`demo_assets.h` instead of web_assets.h). `demo.js` (WASI layer, stepping, speed, local storage, demo panel:
  speed, emitter / board / GPU temperatures and power, relay, buzzer with WebAudio, faults E-stop / thermocouple
  open, Reset) connects `web/index.html` with `data-demo` like a USB port (`serWrite` → `TCDemo.write`, answers to
  `serLine`). A reload = a power cycle (interrupted run → Resume; the bodies cool for the closed time); a restart
  from the page restarts the module. First start: PID values from an autotune of the model (B 8.7 / 0.040 / 134,
  T 5.7 / 0.053 / 44). Build: `demo/build.sh` with wasi-sdk 24 (release.yml downloads it) or system clang +
  wasi-sysroot + builtins; ~520 kB. `tools/build_site.py --web` puts it under `/demo/`. Connect screen: card
  "Try the demo"; wiki page Demo.md (+ sidebar, Home, Desktop-app), `tools/wiki/shots_demo.js` (make_shots.sh
  demo); README. Tested: a whole Lead-free BGA run at 10×, restart / reload / resume, E-stop, thermocouple open,
  autotune of both channels, phone layout of the panel.
- **Glass flicker + demo chart at 5× / 10×** (2026-10-23, for 1.0.59): Rost's screen records: a lighter / darker band
  in the active channel card and the whole sidebar about every 2 s, in step with a strip at the chart's left edge
  that came and went (the oldest live bin starts up to one bin after the left edge). Chrome then repainted around
  the chart and redrew the backdrop blur of the glass surfaces slightly differently. Now: the oldest point of each
  live line / SP area is held to the left edge (modelLive); `will-change:transform` on aside, .panel, .tabbg, the
  sidebar's children and .chartbox (own layers); setTxt() writes sidebar / footer texts only when they change.
  Demo: the live chart's head and the head-join distance scale with the speed (devRate(): device s per real s;
  `near` = max(8 × rate, 2.5 bins)); joinHead() fills points between the SP history and the newest SP (the live
  view breaks lines at gaps > M.gap); polling every pollMs / rate (min. 250 ms); the Demo button 2× larger,
  below the open sidebar on phones; the demo panel writes its texts only when open / changed.
  Then still darker rectangles in the sidebar on polls and when hovering the chart / editor fields (Chrome renders
  the live blur in tiles): on desktop (> 860 px) the sidebar no longer blurs live but paints a copy of the page
  background (mesh, fixed) under its glass tint - looks the same (the mesh is smooth); phones keep the blur.
- **1.0.60** (2026-10-26, 0619d8f; after 1.0.59 = f5e9234): Rost: the demo's title "TempCtl Duo DEMO"; the Demo button
  with a thicker outline and a big breathing glow; the top channel Idle in the program editor like the bottom.
  - Top Idle (Both phase): `SeqPhase.tIdle` (JSON `"t":{"idle":true}`); the top outputs go off and the bottom
    ramps, waits ("wait for bottom") and holds as in a Bottom phase (run_engine bDrives()); not both Idle
    (parse error). Web editor (table + phone cards: Idle box for both channels; choosing one clears the other;
    switching the top off gives the bottom the top's ramp / hold if it had none), touch editor (row menu
    "<top>: on - switch off", table "off"), console `prog`. Host test testTopIdle (parse / JSON round trip, plan,
    run, resume).
  - Fixed: the pause text field in the web editor did nothing (the branch had ended up inside a comment).
  - Demo: `<title>` and document.title "TempCtl Duo DEMO", a DEMO badge under the name in the sidebar (build_site);
    Demo button with a 3 px accent outline and a breathing glow under it (own element, opacity / scale animated,
    none with reduced motion).
  - Static error question (Rost: in the demo the PV stays a few degrees under the SP for minutes): not a
    simulation artefact - the Tyreus-Luyben autotune rule (Kp = Ku/2.2, Ti = 2.2 Pu, Td = Pu/6.3) has a very slow
    integral; after the heat-up at 100 % (integrator frozen, anti-windup) the P term alone stops some degrees
    short and the integral closes the gap with Ti (bottom 216 s, top 108 s). Demo model, manual 200 degC from
    cold: bottom 195 -> 199.5 degC took 400 s (TL), 24 s with Ti = 0.68 Pu (ki 0.13, overshoot 0.5 degC); top
    156 s -> 30 s (ki 0.17). ZN "no / some overshoot" overshot 4-6 degC. Rost chose a switch (below).
  - Autotune rule switch (Rost: choose "slow / no overshoot" or "faster", a switch in the autotune section, only
    before the start, greyed out while it runs): setting `local.tuneFast` (default off; JSON, console
    `set b.local.tuneFast=on`, touch field "Autotune result: faster" under PID control, web switch "Result: Slow, no
    overshoot / Faster" saved at once via /api/config). The rule is latched at the start (TuneConfig.fast,
    TuneResult.fast; live `autotune.fast`; event "autotune started at ... (faster)"; result message "..., faster").
    Faster = TL Kp and Td, Ti = 0.7 Pu. Host test (first-order heater, dead time 8 s): 199.5 degC after 284 s
    (slow) / 116 s (faster), peak 200.1 / 205.4 degC; demo model 0.5 degC overshoot. The demo's first start now
    uses the faster values (B 8.7 / 0.126 / 134, T 5.7 / 0.166 / 44) with the switch on.
  - Wiki pictures regenerated (touch + web: editor with the top Idle column, PID tab with the switch, sidebar).
  - Glass (again): Rost still saw a less transparent band at the bottom of active channel cards. On desktop
    (> 860 px) .panel, .chan.on, .tabbg and the inactive channel tabs now paint a copy of the page background
    (mesh, fixed) under their tint like the sidebar, no live backdrop blur; phones keep the blur.
- **1.0.61** (2026-10-27, 3a7c772; after 1.0.60 = 0619d8f): see 9.16 - Both phase with both channels Idle, Wi-Fi
  completely off, web page jump fixes, touch editor 0 °C = off, touch Channels / System layout from Rost's design.
- **1.0.62** (2026-10-28, 7bdc93c; after 1.0.61 = 3a7c772): see 9.17 - CYD out of memory on the Channels page fixed (the
  left page deleted first, shared styles, single-label value buttons, no row objects on the CYD, a free-RAM check
  before building a page). On the board: Channels page 51260 -> 37712 bytes (33944 free with it open).
- **1.0.63** (2026-10-28, 0194f61; after 1.0.62 = 7bdc93c): see 9.18 - setpoint margin below the cut-off as a general
  setting (run.spMargin), a cleared number pad entry is 0, the Modbus write limits paired on the S3.
- **1.0.64** (2026-10-28, 41aadd2; after 1.0.63 = 0194f61): see 9.19 - web page: reorder phases / steps by dragging (and
  Alt+Up / Down), chart handles on a touch screen move after a short hold (a swipe scrolls the page).
- **1.0.65** (2026-10-28, 352a605; after 1.0.64 = 41aadd2): see 9.20, 9.21 - README shortened (features, screenshots,
  wiring), its reference parts moved to the wiki (Web API, How it works inside), schematic PDFs linked, MIT License.
- **1.0.66** (2026-10-28, e058da2; after 1.0.65 = 352a605): see 9.22 - release page on GitHub Pages
  (https://justr0st.github.io/TempCtl-Duo/, relative paths), a GitHub release per new version, Cloudflare kept
  for the transition.
- **1.0.67** (2026-11-03; after 1.0.66 = e058da2): see 9.23 - feed-forward on the local channels (phase A):
  setpoint preview from the run engine, heater model (K, tau, dead time) from the autotune, settings
  `local.ff/ffK/ffTau/ffDead` on touch / web / serial, `ff` / `i` in `/api/live` and the SD run log. First work
  with Claude Code on Rost's PC (sections 1, 8: local PlatformIO + WSL; COM ports in platformio.ini).
- **1.0.68** (2026-11-13; after 1.0.67 = 113d315): see 9.24 - 9.29 - review
  findings fixed (fault badge, cut header texts, phone chart labels, one Start / Pause button on the web page),
  bad-reading rules with one thermocouple filter class, control-task heartbeat, optional pins (GPIO 4 / 5 / 6 on
  the S3) with a cooling fan, buzzer tones / volume / key beep, fan option per phase and step, run report, QR
  codes on the touch Network page, tests and gates in GitHub Actions, the fastest read and poll intervals as
  fresh-install defaults; Wi-Fi off no longer crashes at boot, the access point closes after the station connects,
  the touch QR button follows the connection; the web dashboard's event log has a fixed height (320 px, own
  scroll: the page no longer grows while log lines arrive; found by web_jumps in CI); two files split (9.29). Rost tested on the S3: Wi-Fi, QR, optional
  pin functions, buzzer tones / volume, bad readings (a reattach spike still gets through: next version).
  Wiki: fan wiring diagram (s3-fan), optional-pin defaults marked in the relay / E-stop / buzzer diagrams,
  "Connect only what you need" in the S3 and CYD hardware pages.
- Next: Rost set up the GitHub secrets and disconnected Workers Builds (2026-10-20); the first release run follows the push.
  Open: the older untested points (Modbus beta, runs on the CYD, ...).
- Tested with the host mock (Playwright): table edit → unsaved → undo / redo, target and hold drags,
  add phase, save (POST body checked), start without saving, new Timeline in an empty slot with a pause
  text, phone width (no sideways scrolling).

Keep the conventions (full web/touch parity, colours via named styles) unless Rost decides otherwise
(the LVGL Pro ones — translations.xml, widgets bound by name, exported code — ended with the old UI).

### 9.11 Firmware update without USB (decided 2026-10-13, Rost; version 1.0.39)
Decisions: web upload on S3 **and** CYD (CYD gets an OTA partition table), SD card update on the S3 with a
button + confirmation, self-test + rollback.
- Module `ota.*`: one stream API for both sources (`otaBegin(src,total)` / `otaWrite` / `otaEnd` /
  `otaAbort`, Arduino `Update` into the next OTA slot), status for web / touch (`otaStatus`), the
  conditions `otaCanStart` (second slot present, no run active or paused, no channel outputs on — manual,
  autotune —, not already busy / on probation).
- Image check (`ota_image.*`, pure, host-tested): ESP image magic 0xE9, chip id at byte 12 (0 ESP32,
  9 ESP32-S3, `BOARD_CHIP`), and the id string `TCDUO-IMAGE|<BOARD_ID>|<version>|end` (`OTA_IMAGE_ID` in
  ota.cpp, logged at boot so the linker keeps it; `BOARD_ID` = env name in board_*.h). Found while the
  image streams (across chunk borders); an image for another env is refused (header / chip at once,
  the id at the end before `Update.end`). The web page does the same checks on the file before uploading.
- Web: `POST /api/ota?size=` multipart (WebServer upload callback in the loop task; the whole upload runs
  inside one `handleClient()`: `esp_task_wdt_reset()` per chunk, touch overlay refreshed via
  `uiOtaRefresh()` every 300 ms); answer `{ok, version}`, restart 2 s later (`otaLoop` →
  `appRequestRestart`). `GET /api/ota` (info), live `ota` while running / on probation. Upload only when
  the page is served by the device (not over Web Serial). The file comes from "Choose firmware file…" or
  by drag and drop onto the dashed box around it (highlighted while dragging; several files → the first
  `.bin`; ignored while an update runs; a file dropped elsewhere on the page is not opened by the browser).
- SD (S3): `/firmware.bin` in the card root. `GET /api/ota/sd` = SD task request RQ_FWCHECK (reads the
  whole file through the scanner, ~3 s); `POST /api/ota/sd` starts `installFirmware()` in the SD task (card
  mounted under `lcdBusLock` for the whole install, ~20–30 s; the display keeps drawing, the screen check
  waits), then renames it `firmware.done`. Touch System › Firmware update › SD card (check + dialog),
  serial `fw`, `fw sd`, `fw sd install yes`.
- Rollback: the core's sdkconfig has `CONFIG_APP_ROLLBACK_ENABLE`; `extern "C" verifyRollbackLater()`
  returns true, so a new image stays PENDING_VERIFY until `otaLoop` marks it valid (30 s after the start
  and > 10 control cycles). `/duo/ota.json` {from, to, src} written at the end of an update: the new
  firmware logs "Firmware updated from A to B - checking it for 30 s" (note kept until confirmed), the old
  one after a rollback "Firmware update to B failed: it did not start correctly, A runs again".
- CYD flash: `partitions_cyd_ota.csv` (nvs, otadata, app0/app1 0x1E0000 each, spiffs 0x30000 = 192 kB,
  no coredump). The first USB upload with it erases LittleFS (settings, programs: back up first). To fit,
  `tools/web_embed.py` compiles only each board's own page (`#ifdef BOARD_HAS_PSRAM`: page with fonts +
  font files on the S3; `#ifndef`: the page without fonts, served at `/`, on the CYD); CYD image ≈ 1.77 MB
  (90 % of a slot), S3 1.92 MB of 6.25 MB.
- Touch: full-screen overlay (lv_layer_sys) while running / written: version, source, %, bar.

### 9.12 Backup on the SD card (decided 2026-10-14, Rost; version 1.0.42)
Decisions (Rost picked the proposals): web, touch and serial; list + restore (settings, programs or both) +
delete on the web; only by hand (no automatic backups); S3 only (the CYD's SD pins carry the thermocouples).
- One file per backup: `/backup/<local yyyy-mm-dd_hhmmss>.json` (`_2` … if taken; without a clock
  `start<boot>_<n>.json`), `{"fmt":1,"kind":"tempctl-duo-backup","fw","board","host","time","settings":{as GET
  /api/config without limits and passSet},"programs":[{"i","program"}]}` (the used slots). Same pieces as the
  web's backup files, so the web file restore takes a backup file too (settings: its `settings`). Wi-Fi
  passwords are not in it; restoring keeps the stored ones.
- `src/backup.*` (S3 only, `HAS_SD` in config.h; stubs elsewhere): `backupCreate` (JSON built in the calling
  task, PSRAM buffer handed to the SD task: request `RQ_BACKUP`, which frees it in any case), `backupInfo`
  (time, fw, settings, program count, slot list + mask), `backupRestore(name, BACKUP_SETTINGS|PROGRAMS)`:
  refused during a run; settings first (`settingsFromJson` + `settingsValidate` on a copy, as POST
  /api/config; changed network settings → "used after a restart"), then each program checked
  (`progFromJson` with the channel names, `progCheckLimits` against the restored limits) and saved into its
  slot; slots not in the backup stay. Result text + event "Restored from the SD card backup/…". One backup
  operation at a time (`Busy`). `backupLabel()` (header, host-tested) makes "2026-10-14 15:30:12".
- `sdlog`: list / load / delete take a folder (`SdDir`: `SD_RUNS` *.csv, `SD_BACKUPS` *.json).
- Web: `GET/POST /api/backup`, `GET /api/backup/info`, `POST /api/backup/restore`, `POST /api/backup/delete`,
  `GET /api/backup/file`; Tools › Backup › "SD card" (shown when live `sd` exists): Back up to SD card,
  Refresh, list newest first (Restore… / Download / Delete); Restore… reads the info and asks with
  "Restore both" / "Settings only" / "Programs only" / Cancel, then reloads settings / programs (drafts of
  the restored slots dropped).
- Touch System: "Backup to SD card" (Back up → toast with the name) and "Restore from SD card" (Choose… →
  list of up to 40 backups → "Restore what?" → confirmation with date, firmware and slots → result dialog).
- Serial: `backup sd`, `backup sd list`, `backup sd restore n=<n> [settings|programs] [yes]` (without yes:
  what it holds), `backup sd delete n=<n> yes`; `help backup`. CYD: "no SD slot".
- Tests: host (backupLabel), console host S3 build (`BOARD=s3 test/console_host/build.sh`), UI host shots
  14e–14i, mock + Playwright (`mock/backup.js`).

### 9.13 Releases and online update (decided 2026-10-20, Rost; version 1.0.52)
Decisions: see the 1.0.52 entry in 9.10. Pieces:
- **Workflow** `.github/workflows/release.yml` (push to main, docs-only pushes skipped, also by hand;
  one job, ~10–15 min): `pip install platformio esptool==4.8.1`, cache `~/.platformio` + `.pio/libdeps`;
  `pio run` for the four envs; per env `art/fw/<env>/firmware.bin` and `full.bin` = `esptool merge_bin`
  (S3: esp32s3, qio / 80m / 16MB, bootloader at 0x0; CYD: esp32, dio / 40m / 4MB, 0x1000; then 0x8000
  partitions, 0xe000 boot_app0, 0x10000 firmware); `tools/launcher/build.sh all` → `art/app/`;
  `tools/build_site.py dist --web` + `tools/release.py dist art`; upload artifact (14 days); `npx wrangler@4
  deploy` with the secrets `CLOUDFLARE_API_TOKEN` (template "Edit Cloudflare Workers") and
  `CLOUDFLARE_ACCOUNT_ID`. Workers Builds (1.0.45) must be disconnected, else it deploys without `/dl/`.
  Not run in the cloud container (no PlatformIO / network there): release.py and the launcher build were
  tested with fake images; the first real run is Rost's.
  `tools/release_local.sh [--no-app] [--dry]` (asked by Rost 2026-10-20: test without commit / push): the same
  steps on his PC (Git Bash in the PIO terminal; PIO's python + its tool-esptoolpy for merge_bin; Go only for the
  app; `npx wrangler@4 deploy` with his `wrangler login`); `release.py --no-app` = firmware only.
- **`tools/release.py`**: `dist/dl/tempctl-duo-<v>-<env>.bin`, `…-<env>-full.bin`, `…-windows-x64.exe`,
  `…-macos-arm64.zip` / `-x64.zip` (one file "TempCtl Duo", mode 755), `…-linux-x64.tar.gz` (`tempctl-duo`,
  755); `dist/dl/manifest.json` {version, date (UTC), commit, firmware: {env: {url, size, md5, sha256, full:
  {…}}}, app: [{os, arch, url, size, md5, sha256}]}. Refuses an image without `TCDUO-IMAGE|<env>|<version>|end`
  or with the wrong chip. `_headers`: `/dl/*` → `Access-Control-Allow-Origin: *`, `Cache-Control: no-cache`.
  Only the newest release is online (each deploy replaces the files).
- **`src/release.*`** (pure, host-tested): `RELEASE_HOST` = tempctl-duo.just-r0st.workers.dev,
  `versionCompare` (numeric per dot part), `releaseParse(json, board)` → version, date, host + path (relative
  url or https only), size (≥ 64 kB), md5 (32 hex, lower case).
- **Web page** (both boards, Settings › Device › Firmware update): "Check for updates" (also by itself when
  Settings is shown, at most every 10 min): fetches `REL_BASE/dl/manifest.json` (`REL_BASE` = '' on the hosted
  page itself) → "Firmware X (date) is available (n kB)" + Install / "X is the newest release" / "The newest
  release is X; this device runs Y" / unreachable. Install: confirm → download with progress (fetch stream) →
  same checks as a chosen file (`fwInspect` / `fwProblem`) + size + version = manifest → `fwUpload(file, r,
  md5)` → `POST /api/ota?size=&md5=` (device: `otaSetMd5` → `Update.setMD5`, checked by `Update.end`). Over
  USB (Web Serial): only a download link (upload is Wi-Fi only). No hash in the browser (`crypto.subtle`
  needs a secure context; the device page is http).
- **Connect screen** (hosted page, local app): "Downloads" panel from the manifest: app buttons (Windows,
  macOS Apple silicon / Intel, Linux; size), "Firmware for the boards" (Update / Full image per env) and notes
  (unsigned app: SmartScreen / Gatekeeper). The launcher marks its page `data-version`; the panel says when
  the release has a newer app.
- **S3 device** (`HAS_NET_OTA` = `BOARD_HAS_PSRAM`, config.h): `src/ota_net.*`, a task per job (12 kB stack,
  priority 1, core 1): check = HTTPClient + WiFiClientSecure (`setCACert(CA_ROOTS)`: 18 roots from certifi,
  `tools/gen_ca_roots.py` → `src/ca_roots.h`: ISRG X1/X2, GTS R1/R3/R4, GlobalSign R46/E46, SSL.com ×4,
  Certum Trusted Network CA, USERTrust ×2, Sectigo R46/E46, DigiCert G2/G3 — Cloudflare's Universal SSL CAs +
  backups; no date check in this mbedTLS build, so no clock needed), GET manifest (≤ 16 kB) → `NetOtaInfo`
  {phase idle / checking / checked / failed / downloading, newer, latest, date, size, msg}; install = the
  checked release only if newer and `otaCanStart`: `otaBegin(OTA_NET, size)` + `otaSetMd5`, GET the image,
  4 kB reads into `otaWrite` (size must match; 20 s without data or a closed connection → abort), `otaEnd`
  → the usual restart + probation. Needs Wi-Fi as station (not AP). **Memory** (Rost's first test: "SSL - Memory
  allocation failed (-0x7F00)", 76 kB internal free, largest block 67 kB): mbedTLS needs ~70 kB per session (16 kB
  in + 16 kB out, handshake, the parsed roots) and this core allocates it internally (`CONFIG_MBEDTLS_INTERNAL_MEM_ALLOC`);
  so the netota task switches mbedTLS to PSRAM-first (`mbedtls_platform_set_calloc_free`, internal as fallback,
  `heap_caps_free`) for the job and back to the core's pair afterwards (`esp_mbedtls_mem_calloc/free`, named by
  asm label: esp_mem.h has no extern "C"). Errors name the stage (DNS with the server, TLS text + code from
  `lastError`, HTTP code); the log line adds the internal RAM before the connect. OTA source "net": log "download from the
  release page", touch overlay "Download:", ota.json src "net". S3 image +~240 kB (TLS), 33 % of its slot; CYD 93.0 % (cyd-2xlocal-2x485; the page grew ~2.5 kB).
- **Touch** System: row "OTA update" — S3: Check → toast "Asking the release page…" → dialog "Install
  firmware X?" (size, build date, current version; Cancel / Install) or a toast (newest / older / can't start /
  error); CYD: the row only names the web page's button. UI host shots 14j (S3 dialog), 14e0-system-online (CYD).
- **Serial**: `fw net` (alias `fw check`) → result line when there; `fw net install yes` (progress every 10 s);
  `fw` names `fw net` on the S3. Console host test both builds.
- Tests: host (versionCompare, releaseParse incl. bad input), console host, UI host, Playwright `mock/rel.js`
  (auto check, install through the browser with md5 in the POST, newest / older / unreachable, hosted
  downloads incl. phone width), the older ota / fwsd / backup / raw / itest tests, all four envs build.

### 9.14 Wiki (decided 2026-10-21, Rost; version 1.0.57)
- **Pages** `docs/wiki/*.md` (GitHub renders them; README links `docs/wiki/Home.md`), page list + groups in
  `docs/wiki/_Sidebar.md`: Home, Getting started, Hardware S3 / CYD, Touch screen, Web page, Programs and runs,
  Channels (PID, autotune), Safety, Updates and backups, Desktop app and USB, Serial console, Troubleshooting,
  Modbus (beta), For developers. Pictures in `docs/wiki/img/{wiring,touch,web}`; theme-aware with
  `<picture><source media="(prefers-color-scheme: dark)" srcset="…-dark…"><img src="…-light…"></picture>`; the SVG
  diagrams switch colours by themselves (`@media (prefers-color-scheme:dark)` inside the SVG).
- **Hosted**: `tools/wiki_site.py` (no packages: own Markdown subset — headings with ids, lists, tables incl. `\|`,
  code, quotes with Note / Warning / Tip / Safety styles, images, links `Page.md#x` → `Page.html#x`, raw HTML
  blocks) writes `<site>/wiki/*.html` + `img/`, sidebar with groups and the current page's sections, prev / next;
  page look = the web page's palette and Barlow fonts (`/f/`). Called by `tools/build_site.py --web` only (not the
  launcher: +5 MB). `_headers`: `/wiki/img/*` cached a day. The release workflow no longer ignores `docs/**` and
  `**.md` (only README.md, docs/SPEC.md, claude, hardware, logo, .vscode), so wiki changes deploy.
- **Links**: web page sidebar "Help (wiki) ↗" (https://tempctl-duo.just-r0st.workers.dev/wiki/, new tab) and a line
  on the connect screen; README top + hardware sections + project layout.
- **Pictures** — `tools/wiki/make_shots.sh [wiring|touch|web]` (Linux / WSL: g++, Python + Pillow, Node +
  Playwright, LVGL / ArduinoJson sources for the UI host):
  - `tools/wiki/wiring.py` → 9 SVGs: overview (block diagram), s3-display / thermocouples / ssr / rs485 / safety,
    cyd-a / b / c. Board pins left, module middle, field device right, straight wires coloured by function; pins
    copied from board_*.h and hardware/gen (keep in step).
  - Touch: the UI host (test/ui_host) renders all shots; new `UIHOST_THEME=light` renders them light into
    `shots_light/`, `shots_cyd_light/`; host demo names now Bottom / Top, the log line uses FW_VERSION, a 6 s wait
    before the log shot lets the update toasts go. `tools/wiki/touch_png.py` picks 37 screens, 2× nearest-neighbour
    + a dark frame → `img/touch/<name>-<dark|light>.png`, `cyd-…` for the CYD (134 files, ~3.4 MB).
  - Web: `tools/wiki/mock/server.py` = demo device (port 8770): settings / example programs / time zones from the
    firmware code via `tools/wiki/demo_run.cpp` (`config`, `examples`, `zones`); runs from the real run engine
    (`demo_run <example> <run time> [continue after s]`: heater model per channel, deterministic noise; /api/chart
    v=run as chartJson incl. lanes, events, merged forecast, histCompress; /api/live run + channel fields; rows for an
    SD-log-style CSV). Scenes by `POST /demo/scene`: idle, manual, run, run-early, pause, run-tl, done, intr, tune,
    fault, modbus. `tools/wiki/shots_web.js` (Playwright, 1280 wide, phone 390 @2x, Europe/Berlin): 22 shots × dark /
    light (dashboard run / phone / manual live / cards / action / interrupted / done / autotune / fault, sidebar,
    editor seq / tl / chart, programs, channels local / modbus, log, settings + update available (manifest routed to a
    fake newer release), tools, CSV replay of the demo run log, connect screen with downloads) → WebP q82 (~2 MB).

### 9.15 Monitor channel (decided 2026-10-26, Rost; version 1.0.60)

Rost: "a third temperature monitoring channel. No power output … just the temperature monitoring. Add the third
tab to the channels without changing the look of the tabs. Channel color = accent." Answers: shown in the chart
(not as a Dashboard card / touch tile) with its value next to its name in the chart legend; on touch its value
numerically at the bottom right of the chart; **no alarm**; **S3 only, CS on GPIO 3**.
- Hardware: a third MAX31855 / MAX6675 on the shared SCK 41 / SO 40, CS **GPIO 3** (J1-13, 10 kΩ pull-up);
  `PIN_TC_CS_MON` in board_s3.h / board_demo.h → `HAS_MONITOR` (config.h). CYD: none (no free pin).
- Settings `monitor` (always in the JSON; `BoardLimits.monitor`, `limits.monitor` in /api/config; a board without
  it keeps it off, without an error: an S3 backup restores on a CYD): `on` (default off), `name` ("Monitor", 16 chars), `sensor`, `calOffset`, `calGain`, `readMs`
  (100 … 1000, default 1000; MAX6675 ≥ 250), `median`, `medianN`.
- Reading: the local task reads it after the channels at its own interval (`localCtrlMonConfigure / Get`); no
  fault latching, no effect on outputs, runaway checks or the relay. `gLive.mon` (on, name, valid, pv, rawC, coldC,
  tcFault).
- History: `HIST_CH` = channels + monitor (S3 3, CYD 2), `CH_MON` its index. Live ring: a 4th word per slot (PV |
  lowest | highest byte, no SP; 24 h = 1.38 MB PSRAM); the live view / run rows (`runPv/Lo/Hi`) have a 3rd row;
  its own every-reading ring (same size as a channel's, 1 MB). chartJson: a 3rd `pv` / `dlo` / `dhi` row and `mon`
  (name) while it is on. /api/raw + live raw: `a2` → format 2 (header + n2). CSV: `monitor_pv/_min/_max` (history,
  `pv` mask bit 2), `monitor_pv` (last run, SD run log after `top_state`).
- Web: chart line in the accent colour (live: a legend button with name + current value, toggles the line and the
  CSV columns; program view: a legend entry with the value), hover row; Channels: a third tab (same tab shape,
  `--c` = accent, "monitor" / "off") with General (on, name) and Thermocouple (converter, interval, filter,
  calibration + two-point) cards and a live line (PV, raw, cold junction or the converter's error); CSV replay
  reads `monitor_*`. /api/live → `mon` {name, pv, raw, cold, err}. Sidebar (Rost, 2026-10-26): a third row
  under the channels with its name (accent) and "<PV> · Monitor" (or the converter's error, red), no button.
- Page width (2026-10-26): `html{scrollbar-gutter:stable}` + scrollbar track in `--bg-base`: the shorter monitor tab
  no longer drops the scrollbar, which re-flowed the auto-fill forms (text jumping when switching tabs).
- Channel tabs (2026-10-26): an inactive tab's right foot always tucks under its right neighbour (no gap between two
  inactive tabs).
- Touch: the name + reading at the bottom right of the chart (accent, on a backing; hidden while off); Channels:
  a *Monitor* tab (four tabs: 76 px each on the S3, "RS485" without "(beta)").
- Serial: `monitor.*` keys (`get monitor`), `status` line `mon`. Demo: on from the first start, "Board edge" =
  ambient + 0.55 × the board's rise.

### 9.16 1.0.61 (decided 2026-10-27, Rost)

- **Both phase with both channels Idle**: "I need to be able to set both channels to idle on Both step type."
  Both outputs off for the bottom's hold time (`f.bIdle && f.tIdle`, time in `b.h`; JSON
  `"b":{"idle":true,"h":90},"t":{"idle":true}`; wait not possible). Engine: startPhase sets both idle, goes straight
  to Hold (bDrives: holdOf = b.h, extend hold on the bottom). Web editor: the Idle boxes no longer clear each other;
  both on: the bottom's Hold field is the phase's time ("Both off for" on the phone cards); plan / forecast flat off,
  hold-end handle; Timeline conversion: idle steps. Touch editor: the toggles no longer exclusive, table: hold in the
  bottom's hold column, row menu "Both off for"; console `show`. Host test testBothIdle.
- **Wi-Fi completely off** (`wifi.enabled`, default on; Settings.wifiOn): "no AP and no network ... WiFi scan should
  be also disabled when it's off." net.cpp: radioStop() (mDNS end, scan stopped, AP off, disconnect, WIFI_OFF),
  radioStart() as at boot; netApplyWifi() switches; netLoop does nothing while off; netScanStart / netStartAp refuse;
  netInfo "Wi-Fi off"; netEnabled(). Web: a switch at the top of Settings › Wi-Fi (confirm: the page loses its
  connection; the rest hidden while off), POST /api/config applies a change after the answer, /api/wifiscan
  {"err":"Wi-Fi is switched off"}. Touch: Network screen switch (applied at once; the other rows and Save hidden
  while off). Serial: `wifi off` / `wifi on`, `set wifi.enabled=…`; scan / connect / ap refused while off.
- **Page jumping** (Rost's screen record: the Dashboard moved up and down while editing a program): an edit replaced
  the live chart by the program preview (previewDraft) until the next poll brought the live chart back - different
  chart and legend heights. previewDraft now only in the program view. `test/web_jumps.js` (Playwright on the demo)
  samples every panel's position: also fixed the phone's run time line ("6:00 + waits left · …" wrapped with some
  numbers: one line with an ellipsis now), the editor's "Unsaved changes" (its space is kept) and the phone's
  channel card state text (two lines reserved). Only the event log still grows (the last panel).
- **Touch editor: 0 degC = off** (Rost): in a Both phase and a Timeline step a target of 0 switches the channel off
  (Both: bIdle / tIdle, top off gives the bottom the top's ramp / hold if it had none; Timeline: an off step); tapping
  "off" opens the number pad (title "(0 = off)", lower limit 0) and a temperature switches it on again. 320x240: row
  menu "<channel> target: off". Not during a run. UI host test `./uihost editoff`.
- Touch reference pictures (Rost, for a UI reorganization): `./uihost tall` renders whole settings pages as one tall
  picture (header + all body rows, scrolled and stitched): channels (local, Modbus, monitor, RS485), system,
  network, display.
- **Touch Channels / System layout from Rost's Claude Design** (canvas "TempCtl Duo touch screens", 2026-10-27;
  "The channel settings obviously should be applied to all channels"). Rost's answers: pairs on the S3 only (CYD:
  one value per row, but the new texts, order, headings and spacing), touch only (web unchanged), the autotune
  Start in the accent colour, the median count greyed out (not hidden) while the filter is off.
  tui_chan.cpp: Field got trailing layout members (lay L_JOIN / L_BEFORE / L_GAP10 / L_GAP20 / L_TRIM / L_COL, w,
  rl, rh, pre, en). S3: selectors 200 px; "Setpoint range" 0 °C .. 390 °C (90 px each, whole values without .0,
  hint "Local: max = Tcutoff − 10 °C"); calibration offset (80) + "Gain" (110); median: count (150) then switch;
  autotune text "Find PID values:\n…", "▶ Start" (btnPri, 110 px); "Autotune result: faster" (new hint); Kp / Ki /
  Kd in one row (80 px each, right-aligned label + unit columns, Kp unit "% out. per °C"); heading "Thermal
  protection" (instead of "Thermal runaway protection") above "Converter too hot"; "Heating failed: output over"
  [80] … for [110]; "Holding: PV/SP difference over" ± [80] … for [110]; "… PV rises by" [80] … within [110];
  gaps 10 / 20 px (CYD half, none right under a heading). Monitor tab: no note (the Name hint "Measure only. Chart,
  CSV and logs. CS on GPIO 3"), "Converter enabled". System (tui_menu.cpp): groups with 20 px (CYD 10) above:
  polling + band; "OTA update" (hint "The newest FW from the release page (Internet over Wi-Fi)") + firmware
  update; backup + restore; time zone; manual mode timeout + safety. UI host: chan test checks the greyed count;
  wiki screenshots scroll to labels (scrollToLabel) instead of fixed offsets.

### 9.17 CYD out of memory on the Channels page (Rost's crash log 2026-10-28; after 1.0.61)

CYD 2x local, 1.0.61: `lv_obj_class_create_obj: Assertion obj != NULL failed. Out of memory` in tLabel <
row < build < chanShow < tShow (menu item), 105 s after boot (after web: 77.9 kB free, largest 73.7 kB). Not
new in 1.0.61 (1.0.60's Channels page is the same size, UI host). The page holds ~200 objects; the menu was
deleted only afterwards (lv_obj_delete_async), so both were in RAM while the page was built.
- tShow (TUI_SMALL): the screen being left is deleted first (synchronously: LVGL 9 allows it while its own
  event runs), then the next one is built.
- Shared styles instead of local ones (tui_widgets.cpp): label fonts (fontStyle), tRow / tCol (boxStyle: flex
  flow, gap, size), button and switch sizes (setSize), S_.btn has the flex centring, tStyleGrow /
  tStyleFullWidth; the settings rows (tui_chan row / labelCol, tui_menu settingRow) one static style. UI host
  (64-bit): Channels page 61.9 kB / 1188 blocks -> 52.6 kB / 890 blocks; screenshots unchanged.
- Guard: a page is built only with buildCost (measured RAM of its last build, first time 40 kB) + 12 kB free;
  otherwise main screen + message "Not enough free memory for this page (N kB). Close the web page and try
  again."; serial `[mem] <page> page: N bytes (M free)` after every build. UI host `./uihost_cyd lowmem`.
- Rost's log with that build (2026-10-28): pages on the CYD: menu 7.1 kB, programs 30.4, channels 51.3 (20.4 kB
  left free; lowest while running 14.4), network 19.5, display 16.1, system 12.6, log 1.9; UI host (64-bit)
  within 3 % of these. And LVGL's warning "the active screen was deleted" on every switch.
- Then: tShow loads the main screen before deleting the one being left (no warning; nothing drawn in between).
  Channels page smaller: tValueButton (the value buttons are one label with the button styles, clickable, one
  line with "...": half the objects; pixel-identical), a label without hint gets no column object, and on the
  CYD no object per row: label (column) and control straight into the page body, a flex ROW_WRAP whose labels
  start a new track (lv_obj_set_flex_in_new_track); pad_left 4 on the label (a margin is not counted for a
  growing flex item), margin_right 4 on the control, margin top / bottom 1 (the row's padding); gap rows:
  margin_top on both. UI host: Channels 52.6 -> 39.6 kB (608 blocks); screenshots identical (the last one of
  the page 2 px lower). Chan test finds a row's switch on both layouts (switchOf).
- On the board (Rost, CYD 2x local): `[mem] channels page: 37712 bytes (33944 free)`.
- Left: 87 labels each get a spec_attr (LVGL's label sets an ext draw size of font height / 4).
- UI host: `./uihost_mem memleak <screen> x` (allocations by caller, MEMBY=1/2); editoff test S3 only.

### 9.18 After 1.0.62 (Rost's test results 2026-10-28)

Tested by Rost and working: Both phase with both channels Idle, Wi-Fi completely off, touch editor 0 °C = off,
the redesigned Channels / System screens on the S3, the S3 touch screen in general. The web page keeps its
layout (Rost: "good already").
- **Number pad**: a cleared value shows 0 but OK said "Allowed: …"; now an empty entry is 0 (then the usual
  range check). UI host `./uihost numclear`.
- **Setpoint margin below the cut-off** as a general setting (Rost: "make it a general setting"; it was the
  fixed 10 degC of 9.2): `run.spMargin`, 0 … 100 degC, default 10. settingsValidate lowers a local channel's
  spMax to maxTemp − spMargin (a smaller margin later does not raise it again). Web: *All channels* tile
  ("Setpoint margin below the cut-off"); touch: System, first group (number pad 0 … 100, validated, saved at
  once); serial `set run.spMargin=…`; the Channels hints show the value. Host test testSpMargin, console host.
- **Modbus write limits paired on the S3**: "Between writes at least" [0.5 °C] and [5 s] (minStep 80 px +
  minWriteSec); CYD two rows as before.

### 9.19 Reorder phases / steps on the web page (Rost 2026-10-28: "like Spotify songs in the queue")

Until now only the touch editor could move rows (row menu Move up / down). Web: a grip (⋮⋮, `button.grip
[data-grip]`, 6-dot SVG) at the start of every row - Sequence table, its phone cards (< 720 px), each
Timeline channel's table - not during a run, not with one row. Pointer events (mouse, touch, pen; the
browser's own drag and drop has no touch): `touch-action:none` on the grip only (the page still scrolls
elsewhere), a drag starts after 4 px; the row follows the pointer (translateY), the rows it passes slide
by its height + gap (transition .16 s), the drop index is where the pointer is (tall phone cards), near the
window edge (56 px) the page scrolls; Esc / pointercancel cancel. The move is one edit (beginEdit / splice /
afterEdit: undo / redo, "Unsaved changes", preview). Keyboard: Alt+Up / Alt+Down on the grip (keeps the
focus). updateEditor does not rebuild while a row is dragged (`rowDrag`). Names rowDragAt / rowDragGo /
rowDragEnd (the chart handles already have drag / dragEnd). No firmware change.
Test: `test/web_reorder.js` (Playwright on the demo, 1280 px mouse and 390 px touch: drag 1 -> 3, unsaved,
undo, Esc, Alt+Down, Timeline 3 -> 1, no grips while running); web_jumps unchanged.
- **Chart handles on touch (Rost, done the same day)**: on the phone, dragging a chart handle (program view)
  scrolled the page. Now (touch and pen): a hold of 350 ms on a handle starts the edit (navigator.vibrate(12),
  the ghost with the value at once); moved more than 8 px before that: a swipe (the page scrolls, the chart
  pans sideways as before); a second finger cancels (zoom). The finger may be up to 24 px off: the handle under
  it, else the nearest. While held: touchmove prevented (non-passive listener on #chartbox; the page stays),
  contextmenu prevented; `.chartbox [data-h]{touch-action:none}` removed (a swipe starting on a handle
  scrolls too), `-webkit-touch-callout:none`. Mouse: drag at once as before. Editor hint "(touch screen:
  hold a point briefly, then drag)". Test `test/web_chart_hold.js` (390 px touch: swipe scrolls and changes
  nothing; hold + drag changes the target, the page stays; 1280 px mouse).

### 9.20 README shortened, its reference parts moved to the wiki (Rost 2026-10-28)

Rost: "rewrite README.md to a much shorter, pleasant for a human to read project description with some nice
simplified wirings and screenshots of main features. List the main features ... close to the title"; new title
"TempCtl Duo: two-channel programmable temperature controller (ESP32-S3 / ESP32 CYD)" (wiki Home: the same
wording). README (912 -> ~100 lines): title, short description, S3 touch picture, main features, links (wiki,
demo, release page), status, screenshot table (web Dashboard / editor / channels, touch editor / PID, CYD),
hardware (two boards, overview.svg, s3-thermocouples.svg, s3-ssr.svg, links to the wiki pages and the KiCad
PDFs), getting started in 4 steps, documentation table, built with. Everything only the README had went to the
wiki: new pages **Web API** (`Web-API.md`: request checks, endpoint table, serial API mode) and **How it works
inside** (`Internals.md`: touch UI files / CYD RAM / slide off / drawing and SPI speed / screen check / touch
gaps / INT line, web page build and assets / chart data / live history / refresh, system and SD run logs,
LittleFS files, backup format, image check / HTTPS / rollback / CYD partition, status); **For developers**
(`Development.md`) now has the host test command, the web tests, the full release pipeline with its setup and
the project layout. Sidebar: both new pages under Maintenance. The user-facing parts were already on the wiki
pages. KiCad PDFs linked: Hardware-S3 (intro + Reference), Hardware-CYD (table column + each wiring section) as
repository paths `../../hardware/<folder>/<name>.pdf` (GitHub); `tools/wiki_site.py` copies
`hardware/**/*.pdf` to `/wiki/hw/` and rewrites such links (the hosted wiki). Code messages that pointed at
README sections now name the wiki pages (console `help api`, OTA "no second firmware slot").
Note: the S3 KiCad schematic (1.0.43) does not have the monitor channel's third converter (GPIO 3) yet.

### 9.21 License (Rost 2026-10-28: MIT)

`LICENSE`: MIT, "Copyright (c) 2026 Rost (justr0st)" — firmware, web page, tools, documentation, schematics.
`THIRD-PARTY-NOTICES.md`: the parts with their own licences (Espressif SIMD `src/simd/` Apache-2.0 with
`src/simd/LICENSE`; `src/simd/lv_blend_esp32s3.c` / `include/lv_blend_esp32s3.h` follow esp_lvgl_port's blend
header: SPDX `Apache-2.0` lines added; Barlow fonts OFL 1.1; LVGL (+ Montserrat OFL), ArduinoJson,
XPT2046_Touchscreen MIT with the MIT text; Arduino core LGPL-2.1 (statically linked: the source is public, the
firmware can be rebuilt with a changed core); ESP-IDF Apache-2.0 and others; demo wasi-libc / libc++; Go stdlib
BSD-3). Apache-2.0 is permissive: no need to put the project under it (discussed with Rost). README "License",
wiki For developers "License". `tools/build_site.py` copies both files to `/LICENSE.txt` and
`/THIRD-PARTY-NOTICES.txt` (hosted page and desktop app), linked in the Downloads panel.

### 9.22 Release page on GitHub Pages, GitHub releases (Rost 2026-10-28)

Rost makes the repository public (history kept: nothing secret in it, checked) and moves the release page from
Cloudflare to GitHub Pages as a project page: **https://justr0st.github.io/TempCtl-Duo/**. Every push builds as
before; a new version (no tag `v<FW_VERSION>` yet) also becomes a **GitHub release** with the firmware images and
the desktop apps (notes: the commit subjects since the previous release tag + what the files are); a push without
a version change only updates the page (Rost asked whether automatic or manual: automatic, keyed to the
version, as every commit here bumps it).
- Paths: the page, the wiki and the demo use relative paths (`f/…`, `favicon.svg`, `LICENSE.txt`; wiki
  `../favicon.svg`, `../f/`, `../`, `../demo/`; the demo page's own copy is rewritten to `../` by build_site.py),
  so the same `dist/` works under `/TempCtl-Duo/` (GitHub) and at a root (device, launcher, Cloudflare).
- Release base: web `REL_BASE = 'https://justr0st.github.io/TempCtl-Duo'` (always absolute; the hosted page, the
  device's page, the desktop app); firmware `RELEASE_HOST "justr0st.github.io"`, `RELEASE_BASE "/TempCtl-Duo"`,
  manifest `RELEASE_BASE "/dl/manifest.json"`; a manifest url `/dl/…` is under RELEASE_BASE (releaseParse; host
  test). The manifest itself is unchanged, so devices with 1.0.65 or older reading it on Cloudflare (root) work.
- `src/ca_roots.h` unchanged: it already has DigiCert Global Root G2 / G3 and the Sectigo / USERTrust roots
  (GitHub Pages) and ISRG (a custom domain). DigiCert Global Root CA (G1) is no longer in certifi 2026.04.22.
  To verify on the first S3 online update from GitHub.
- release.yml: permissions contents / pages write + id-token; environment github-pages;
  upload-pages-artifact@v3 + deploy-pages@v4; `gh release create` (once per version); Cloudflare deploy kept
  for the transition while its secrets exist (`HAS_CF`). GitHub Pages: CORS `*` on every file (the device's page
  reads the manifest and images from there), `_headers` ignored, 10 min cache.
- Checked: the site under `/TempCtl-Duo/` (local server, github.io requests mapped to it): page (Downloads from the
  manifest, licence links), wiki, demo: every request found, fonts loaded, 44 same-site links exist; at a root
  the same. web_reorder / web_chart_hold ok.
- Rost, once: repository public, *Settings › Pages › Source: GitHub Actions*; later delete the Cloudflare secrets.

### 9.23 Ramp tracking: feed-forward on the local channels (decided 2026-11-03, Rost; phase A in 1.0.67)
Status: **phase A implemented in 1.0.67** (plan `claude/plans/2026-11-03-feed-forward-phase-a.md`), not tested on
the station yet. Rost approved this section; his four decisions are at its end, the implementation notes after
them. Phase B waits for the station logs.

**Problem.** A local channel's PID only sees the error SP(t) − PV(t). During a ramp the PV lags behind
(the integrator first has to build up the ramp power), and at the end of a ramp the PV overshoots (the
integrator has to unwind the ramp power it built up, which it can't do quickly: it is clamped at 0). The
heaters' dead time (θ, IR head + board + thermocouple) makes both worse. The PID gains from autotune are
tuned for holds, not for ramps.

**Idea.** The program already knows the setpoint course ahead. A model of the heater turns it into the
output the heater needs, and the PID only corrects what the model gets wrong:
`out = FF + P + I + D`, with
- `FF = holdPower(SPa) + rampPower(SPa')`
- `SPa` = the setpoint θ seconds ahead, SP(t + θ); `SPa'` = its slope (°C/s) at that moment
- `holdPower(T) = (T − 25 °C) / K`: the output that holds T (K = °C per % at steady state)
- `rampPower(r) = τ · r / K`: the extra output for a ramp of r °C/s (τ = the heater's time constant)

Looking θ ahead means the ramp power starts θ before the ramp and drops θ before its end. That removes most
of the lag and the overshoot. A first-order heater with dead time is what `test/host_test.cpp` already uses
for autotune, so the maths can be tested there.

**Scope.**
- Local channels only. A Modbus controller runs its own PID, and we can't add to its output.
- Phase A (proposed for 1.0.67):
  - the setpoint preview;
  - feed-forward (hold + ramp power);
  - the integrator allowed below 0;
  - the model from autotune;
  - settings with full parity;
  - FF and the integrator in the run log.
- Phase B, **only after Rost's station logs from phase A** (the logs show whether it is needed):
  - a bottom→top decoupling term (the top channel's holding power is lower while the bottom heats the board:
    `holdPower_top = (SP_top − 25 − c · (PV_bottom − 25)) / K_top`, with c = coupling 0…1);
  - a gain correction from the first settled hold of a run (the integrator's value there is the model's error
    in holding power; K is corrected for the rest of the run, logged, not saved).
- Not planned: MPC (2×2 model with constraints). Only if the phase A/B logs show that feed-forward is not
  enough.

**Phase A in detail**
1. **Setpoint preview (run engine).** A new function `RunEngine::preview(ch, sec, sp, rate)` (const): a copy of
   the engine without its event sink, ticked `sec` seconds forward with the PVs frozen. It gives that moment's
   setpoint and slope.
   - A "wait for bottom" is not satisfied in the preview, and a program pause stops it. So the preview never
     runs ahead of what the real run will do.
   - A ramp that begins within θ: its ramp power starts early, which is what we want.
   - Manual mode and channels that are not in a program: the preview = SP and the slope is 0, so there is
     only hold power. That also helps manual setpoints: the integrator no longer has to build the hold power.
   - The control task calls it every cycle and hands SPa / SPa' to the local task next to SP
     (`localCtrlSetSp(ch, sp, spAhead, rate)`).
   - Pure C++, host-tested: preview across ramp → hold, hold → ramp, Wait, Pause, run edits, Timeline lanes.
2. **Feed-forward (`local_ctrl.cpp` `step()`, `pid.*`).**
   - `Pid::update()` gets a feed-forward input. The P, I and D terms stay on SP(t), so the PV is still
     expected to follow the setpoint shown and charted.
   - The integrator is clamped to −outMax…+outMax instead of 0…outMax, so it can take back an overestimated
     FF. The total stays clamped to 0…maxOut.
   - Anti-windup stays as it is, on the total.
   - FF is used only where the PID runs today: outputs on, fresh reading, no fault, not autotuning.
   - Switching FF on or off during a run is bumpless: the integrator is shifted by −FF (on) or +FF (off),
     so the output doesn't jump; after that the FF follows the setpoint course as intended.
3. **Model (K, τ, θ) from autotune.**
   - The relay test already measures the holding power at the test temperature (the re-centred relay bias):
     `K = (Ttest − 25) / bias`.
   - From Ku and Pu, with ω = 2π / Pu and a first-order + dead-time model:
     - `ωτ = sqrt((K · Ku)² − 1)`
     - `θ = (π − atan(ωτ)) / ω`
   - Autotune shows K, τ and θ next to the proposed PID, and **Accept** takes both.
   - If K · Ku ≤ 1 (no first-order + dead-time fit), autotune proposes the PID only and says why.
   - The values can also be typed in (range-checked in `settingsValidate`).
4. **Settings** per local channel, in the `local` object:
   - `ff` on / off;
   - `ffK` (°C/%, 0.1…20);
   - `ffTau` (s, 5…3600);
   - `ffDead` (s, 0…120);
   - stored in `/duo/settings.json`; missing keys = FF off.
   - Shown as "Feed-forward" in the channel's PID section, with friendly labels: "°C per % output",
     "time constant", "dead time".
   - Parity: touch Channels (S3 and CYD), web Channels, serial `b.local.ff*` / `t.local.ff*`, `/api/config`.
   - `/api/live` and the run log (SD, S3) get the FF part and the integrator of the output, so Rost's logs
     show what the model does. API_VERSION unchanged (new keys only).
5. **Safety unchanged.** FF only adds to the PID output. maxOut, the cut-off, runaway / heating failed, heating
   while off, reading frozen, the E-stop and the SSR timeout all work on the total output, as today. FF off =
   exactly today's behaviour.
6. **Tests.**
   - Host test on the heater model (gain 3 °C/%, τ 120 s, θ 8 s): a ramp from 25 to 200 °C at 0.5 °C/s, then a
     5 min hold. Lag during the ramp and overshoot at its end, with and without FF, both recorded here.
   - Targets with FF: lag below 3 °C after the first θ, overshoot below 2 °C.
   - A wrong model (K ±30 %) still settles on the hold, without a fault.
   - Model from autotune on the same heater: within ±20 % of the true K, τ, θ.
   - Browser demo: `demo/sim.cpp` uses the same control code and has the bottom → top coupling, so the effect is
     visible there.
   - Rost tests on the station: a run with FF off, then on, with the same program, and the SD run logs of both.

**Decided (Rost, 2026-11-03)**
1. FF is **off** after the update until switched on per channel. Accepting an autotune result fills the model
   but does not switch FF on.
2. The model is entered as **K / τ / θ** (autotune fills them in; friendly labels in the UI).
3. **Phase B only after the phase A logs** (FF off / on runs on the station, SD run logs).
4. The ambient for the model is **fixed at 25 °C**.

**Implementation notes (1.0.67, Claude's choices during the implementation)**
- **Derivative with FF on**: the first host run showed the D term (on the measurement) braking every ramp
  (kd 20 × 0.5 °C/s = −10 %); the integrator made up for it and overshot at the ramp's end (2.6 °C). With FF on,
  D now acts on (PV rate − the setpoint's ramp rate at this moment): `Pid::update(p, sp, pv, dt, ff, spRate)`;
  a setpoint jump still gives no kick (the rate is the ramp's slope, not the SP difference). The control task
  hands the local task the preview **and** the current ramp rate:
  `localCtrlSetPreview(ch, spAhead, rateAhead, rateNow)` (spAhead NaN = none: manual / no run).
- Preview: `RunEngine::preview(ch, sec, sp, rate)` = a copy of the engine ticked ahead with the PVs frozen
  (no events). Older than 2.5 control cycles (`bus.pollMs`, handed over with the preview; at least 2 s) → the
  channel's own SP, no ramp power (`ffInput`, `ffMaxAgeMs`; a fixed 2 s dropped the preview between two updates
  at a slow poll interval — found in the final review).
- FF is used as at most maxOut (`clampFf`; a slow heater's ramp power can be several 100 %): the integrator
  (−maxOut…+maxOut) can then always take it back — bumpless switching on during a ramp, a too-low K stays
  correctable (final review).
- SD log: header and the empty fields of event rows are `SDLOG_HEADER` / `SDLOG_GAP_*` in sdlog.h, host-tested
  against each other (the first version left the event rows 4 columns short — final review).
- Integrator −maxOut…+maxOut only while FF is on; FF off = the old PID exactly (`ff` NaN). On / off while the PID
  runs: the integrator is shifted by ∓FF (`Pid::shiftIntegral`), not on the first step after a reset
  (`Pid::running()`), so FF is there from the start.
- Model from the relay test: `fopdtFromRelay()` (autotune.cpp); the autotune message ends with "heater model" /
  "no heater model" (the values don't fit into its 64 characters; the UIs show them from the result).
  Accept on touch, web and serial goes through one helper, `settingsTakeTune()`; the web "Edit…" path also
  saves the model.
- `/api/live` channels: `ff` (null = off / not running) and `i` (the integrator, whenever the PID runs: FF off
  runs need it for the comparison); SD run log columns `bottom_ff, bottom_i` after `bottom_out`, the same for top
  (the web CSV replay reads columns by name).
- Touch: plain labels (the fonts have no Greek letters); the CYD Channels page needs ≈ 8.7 kB more heap in the
  64-bit host build (less on the ESP32): check the `[mem]` line there.
- Host results (heater gain 3 °C/%, tau 120 s, dead time 8 s; ramp 25 → 200 °C at 0.5 °C/s, then hold):
  PID alone lag 8.9 °C / overshoot 3.4 °C; with FF (true model) 0.5 / 0.1 °C; with the model the autotune measured
  (K 3.00, tau 97 s, dead 8.7 s) 1.3 / 1.0 °C. K ±30 % wrong: still settles. Demo model (autotune on demo/sim.cpp):
  bottom K 3.05, tau 984 s, dead 25 s; top K 2.39, tau 273 s, dead 12.5 s (FF off in the demo).

### 9.24 Review 2026-11-12: findings, bad readings, heartbeat (Rost; version 1.0.68)

Rost asked for a review (UI, UX, performance, code quality) and picked from its lists.

- **Fixed findings.** Touch: the fault badge sits in the tile's top left corner (it covered the status text
  and the chart's time labels), the channel name moves right of it, a fault text scrolls when it is too long;
  the header's program and subtitle labels take the room left of the badge (subtitle without the program type:
  "7 phases · 7:00 + waits", stage "pause"); the Channels tabs share the header width, a long name gets the
  small font; the backlight really goes off before a restart. Web: on a narrow chart the phase labels have
  three short rows above the plot (no start times), the lane names are whole, the last time label and "End"
  stay inside; the chart key (what the marks mean) folds away, closed on a phone; Start and Pause are one
  button (as on the touch screen); the phone header's page links fit. `sendBody`: a connection without
  progress is dropped after 2 s (was 5 s: the loop task waits that long).
- **Not changed.** No label for the tile's stepper (no room), Save on the Channels page (it is in the fixed
  header already), no access lock (Rost: not needed), no live-data stream (polling has no connection state to
  lose: more robust on a weak network).
- **Bad readings** (`src/tc_filter.h`, pure, host-tested; used by the local channels and the monitor). A bad
  reading is a converter fault or a jump of more than `local.jumpMax` (default 25 degC, 0 = not checked) from
  the last accepted reading. The first ones are held back and the output stays as it was: as many as the
  median window, 2 without the median, at most 3 s worth of readings. After the hold a valid reading is the
  new level (the median starts again, the PID's derivative starts from it). Bad readings for `local.badSec`
  (default 3 s, 1 ... 30) while heating: sensor fault. A held-back reading above the cut-off switches the
  power off for that step (the cut-off is not weakened by the hold).
- **Heartbeat.** The control task reports to the local task every pass (and inside its long bus requests). A
  heating local channel without a report for 10 s gets the fault "control task stopped" (`FAULT_CONTROL`):
  before, it kept its last setpoint for good.
- **Fresh-install defaults.** `local.readMs` 100 and `bus.pollMs` 100: the fastest; validation raises them
  where a MAX6675 (250 ms) or Modbus needs more. `settingsLoad` validates the defaults too. Stored settings
  keep their values.
- **Wi-Fi fixes.** With `wifi.enabled` off the lwIP tcpip task never starts, so `server.begin()` asserted ("Invalid mbox") and
  the device boot-looped. The web server now starts in `webLoop()` once Wi-Fi is on and the mode is not OFF (also
  when Wi-Fi is switched on later). The access point closes 8 s after the station got an IP (`staIpAt` set by the
  event task, acted on in `netLoop()`; the delay lets a phone on the AP load the page with the new address). The
  20 s fallback now counts from the last moment the station was connected, so it can reopen the AP after a long loss.

### 9.25 Optional pins and the cooling fan (Rost 2026-11-12; version 1.0.68)

- **Optional pins** (`src/io_pins.*`, setting `io.fn`, one name per pin). S3: GPIO 4, 5, 6 with the functions
  off, relay, estop, buzzer, fan, fanPwm, fanTach; defaults relay / estop / buzzer (the wiring until 1.0.67).
  A function is on one pin at most (fan / fanPwm: one fan output); validation rejects the rest with a
  message. The CYD has no free output pin: no optional pins, the buzzer stays on the speaker.
  From boot until the settings are applied every optional pin is an input with pull-down. A pin that changes
  its function gives the old one up first (output low, LEDC and interrupt detached). The "wired" checks
  (E-stop, sound, relay) now mean "a pin has this function": the UIs show those settings accordingly.
- **Fan** (`src/fan.*`, rule in `src/fan_rule.h`, pure, host-tested). On / off output (active high) or 25 kHz
  PWM (LEDC channel 4, `fan.speed` 20 ... 100 %); optional speed input (2 pulses per turn, rpm once a second;
  a warning when the fan is on for 5 s below 100 rpm). Rule: on while the running phase / step has the fan
  option; after a run (`fan.afterRun`) until the hottest reading of all channels and the monitor is below
  `fan.offBelow` (default 60 degC), at most `fan.maxMin` (30 min); it ends at once when a new run starts or
  manual mode / an autotune heats. No manual fan switch (Rost may ask for one).
  Wiring note: a 4-wire fan pulls its PWM wire up to 5 V itself; through a transistor the PWM is inverted
  (not handled: an "invert" setting if Rost needs it).
- **Fan option** of a phase / step: `"fan": true` in the program JSON (any phase kind, any step kind; in
  padding bytes, the program's size is unchanged), `RunEngine::fanWanted()`. The editors show it only when a
  fan output is configured and keep the flag otherwise.
- Parity: touch System page (pins, fan), web Settings › Safety, console `io.fn0..2`, `fan.*`; fan state in
  the chart's corner label, a chip on the dashboard, a status line; `/api/live` `fan {on, rpm}`, config
  `limits.ioGpio`, `limits.fan`.

### 9.26 Buzzer: tones, volume, key beep (Rost 2026-11-12; version 1.0.68)

- Sounds are note lists (Hz, ms) on a 10 ms tick; the E-stop is sampled every 50 ms as before. Alarm 2700 Hz
  (3 long, every 3 s), action required 2000 Hz (2 short, every 10 s), finished 2093 / 2637 / 3136 Hz, key
  3000 Hz 20 ms, confirm 2349 → 3136 Hz, refused 440 Hz 160 ms, test 2700 Hz 200 ms.
- `safety.volume` 1 ... 5 = PWM duty 2 / 6 / 16 / 48 / 128 of 255; the alarm always plays at 5.
  `safety.keyBeep` (default on): a beep on a completed tap. One-shots never interrupt an alarm; the test beep
  plays even with sound off (the settings page tests before it saves).
- Touch: key beep from the touch input's release on the pressed widget; an error toast plays "refused", a
  successful save "confirm".

### 9.27 Run report, QR codes (Rost 2026-11-12; version 1.0.68)

- **Run report** (`src/run_stats.h`, pure, host-tested): per channel the highest PV and its run time, the
  largest deviation from the setpoint in holds (counted from 5 s into a hold), the steepest rise over 5 s;
  the monitor's highest PV. No "time above" (Rost: not needed). Written to the event log at the end of a run
  (so also into the SD run file as event rows), `/api/live` `report`, web "Last run" block, touch: tap the
  Finished / Stopped badge, console `report`. A resumed run reports the part after the resume.
- **QR codes** (LVGL's QR widget) on the touch Network page: the device address on Wi-Fi; in access-point
  mode a Wi-Fi join code and the address (side by side on the S3, one at a time on the CYD). Built when the
  popup opens, deleted when it closes.

### 9.28 Tests and gates in GitHub Actions (Rost 2026-11-12; version 1.0.68)

- `release.yml` has a `tests` job that the release needs; it also runs on pull requests, which never publish.
  Steps: host tests (`tools/ci/host_tests.sh`), touch UI host self-checks and random taps
  (`tools/ci/ui_tests.sh`), the wiki's touch pictures against the UI host (`tools/wiki/check_shots.py`: a UI
  change without regenerated pictures fails, an unintended layout change shows as a diff picture), the web
  page tests (Playwright against the browser demo, `tools/ci/web_tests.sh`).
- Flash size gate (`tools/ci/size_gate.py`) after the firmware build: a CYD image above 97 % of its app slot
  stops the release. 1.0.68 is at about 96 %: the next larger feature needs room first (candidates: QR codes
  off on the CYD, the Modbus tools on the 2x-local wiring).

### 9.29 Two files split (review 2026-11-12; version 1.0.68; the plans R1 and R5)

No behaviour change.

- `src/app_state.cpp` → `app_state.cpp` (run control, control cycle, public API), `app_hist.cpp` (live / run /
  raw history, plan curves, chart JSON and CSV), `app_log.cpp` (event log); `app_internal.h` is private to
  these three.
- The web page's source is `web/src/` (`index.html` with include lines, `css/`, 25 script parts in one global
  scope, joined in the order of the include lines; `web/src/README.md`). `tools/web_join.py` writes
  `web/index.html`, which is now generated and ignored by git; `web_embed.py` (every firmware build),
  `build_site.py` and the mock device join first. The first join was byte-identical to the page before.

## 10. Open items carried over from TempCtl

- (Closed 2026-10-11: not seen again since the assert handler / loop watchdog fix.) Sporadic freeze once seen on the Wi-Fi "Scanning…" screen (not reproduced). The assert handler and
  loop watchdog now turn a freeze into a restart with a backtrace; ask for the log if it happens.
  Suspect: Arduino WiFi scan timeout (`_scanTimeout` = 20 × 300 ms) → our retry calls
  `scanNetworks`/`scanDelete` while the old hardware scan finishes (race with `_scanDone` in the event
  task).
- (TempCtl optional item "palette-driven colours for LVGL theme parts" is obsolete in Duo: palettes are
  dropped; the accent goes into `lv_theme_default_init()` as the primary colour.)
- Program names longer than 23 characters: decided for Duo — up to 31 characters (9.3).
