justr0st/TempCtl-Duo/docs/wiki/Development.md

# For developers

PlatformIO, Arduino-ESP32 2.0.17 (`espressif32@6.9.0`), LVGL 9.6. The design notes with the reasons behind the
decisions are in `claude/tempctl-duo-spec.md`; how the touch UI, the screen check and the storage work is on
[How it works inside](Internals.md), the HTTP API on [Web API](Web-API.md).

## Build

Environments: `s3`, `cyd-1xlocal-1x485`, `cyd-2xlocal`, `cyd-2xlocal-2x485` (`pio run -e s3 -t upload`; check
`upload_port` / `monitor_port` in `platformio.ini`). `tools/web_embed.py` gzips the web page into
`src/web_assets.h` before each build (PlatformIO runs it; by hand: `python tools/web_embed.py`).

An incremental build only recompiles changed files; for a warning check of everything run
`pio run -e <env> -t clean` first.

## Tests without a board

They run on Linux; on Windows in WSL (Debian), once:

```bash
sudo apt-get install -y build-essential git curl ca-certificates python3 python3-pil
mkdir -p ~/deps && cd ~/deps
git clone --depth 1 --branch v9.6.0 https://github.com/lvgl/lvgl lvgl
git clone --depth 1 --branch v7.4.3 https://github.com/bblanchon/ArduinoJson AJ743
```

The build scripts look for LVGL and ArduinoJson in `/tmp` (lost when WSL restarts); point them at `~/deps`:
`export LVGL=~/deps/lvgl AJ=~/deps/AJ743/src`, then run the commands below from the repository
(`/mnt/d/...`). Keep both versions the same as the firmware's (`.pio/libdeps/<env>/*/library.json`).

| What | How |
|---|---|
| Programs, run engine, settings, PID, autotune, runaway, Modbus framing, image check, release manifest | `g++ -std=c++17 -Wall -Wextra -fsanitize=address,undefined -Isrc -I$AJ test/host_test.cpp src/duo_program.cpp src/run_engine.cpp src/settings.cpp src/tc_sensor.cpp src/pid.cpp src/runaway.cpp src/autotune.cpp src/ota_image.cpp src/release.cpp && ./a.out` |
| Touch screens | `test/ui_host/build.sh` builds the screens for the PC and renders screenshots (`./uihost`; `BOARD=cyd` for the 320×240 set; `./uihost monkey` random taps under AddressSanitizer; more modes in [How it works inside](Internals.md#touch-ui)) |
| Serial console | `test/console_host/build.sh` + `./conhost`: types a script of commands and prints the output |
| Web page | Playwright against the browser demo (`tools/build_site.py <dir> --web`, served on :8790): `test/web_jumps.js` (layout jumps), `test/web_reorder.js` (reorder by drag), `test/web_chart_hold.js` (chart handles on touch) |
| Browser demo | `demo/build.sh` (wasi-sdk): the firmware's control code as WebAssembly, `demo/README.md` |

## Tests and gates in GitHub Actions

`.github/workflows/release.yml` has a **`tests`** job that the release job needs: nothing is published when it
fails. It also runs on pull requests, which never publish. Its steps, in order:

| Step | Runs | Fails when |
|---|---|---|
| Host tests | `tools/ci/host_tests.sh`: `test/host_test.cpp` with the pure sources, AddressSanitizer / UBSan | a test or a sanitizer reports |
| Touch UI host | `tools/ci/ui_tests.sh`: builds both boards' UI host, then `stepper`, `chan`, `lowmem` and 4000 random taps (`monkey`) per board | a self-check fails or the sanitizer reports |
| Wiki touch pictures | `python3 tools/wiki/check_shots.py`: renders the UI host's screens and compares them pixel by pixel with `docs/wiki/img/touch/*.png` | a picture differs, is missing or is not made any more; the differences are kept as a run artifact (`touch-picture-diff`) |
| Web page tests | `tools/ci/web_tests.sh`: Playwright against the browser demo: `web_jumps`, `web_reorder`, `web_chart_hold` | a `FAIL` line, a layout jump or a page error |

After the firmware build of the release job, the **flash size gate** (`tools/ci/size_gate.py`) stops the release
when a CYD image fills **more than 97 %** of its app slot (a table is in the run's summary; the S3's slot is
not gated). The CYD is at about 96 % in 1.0.68: before the next larger feature, make room.

**Wiki touch pictures must be regenerated after every UI change**, otherwise the check fails: run
`tools/wiki/make_shots.sh touch` (WSL, with `LVGL` and `AJ` set as above) and commit the changed
`docs/wiki/img/touch/*.png`. A new screen's picture is added to `PICK` in `tools/wiki/touch_png.py`.
`python3 tools/wiki/check_shots.py --write <dir>` (same environment) saves `.new.png` and `.diff.png`
(differences in red) of every differing picture; an unintended layout change shows up there.

## Releases (GitHub Actions → GitHub Pages and Releases)

Every push to `main` (pushes that change only `README.md`, `claude/`, `hardware/`, `logo/` are skipped; *Actions ›
Release › Run workflow* starts one by hand) runs `.github/workflows/release.yml`:

1. PlatformIO builds the four envs; per env the update image (`firmware.bin`) and a full image for the
   first USB flash (`esptool merge_bin`: bootloader, partition table, boot_app0, firmware; write it at
   address 0x0).
2. `demo/build.sh` with the wasi-sdk: the browser demo (the firmware's control code as WebAssembly, `demo/README.md`).
   `tools/launcher/build.sh all`: the desktop app for Windows, macOS (Apple silicon, Intel; zipped) and
   Linux (tar.gz).
3. `tools/build_site.py dist --web` (the page, the wiki under `wiki/`, the demo under `demo/`, the licence files),
   then `tools/release.py dist art`: the files go to `dist/dl/` with the version in their names, plus
   `dist/dl/manifest.json` (version, date, commit; per board url, size, MD5, SHA-256; the app files). It stops if
   an image does not carry its env and this version. The files are also kept 14 days as a run artifact.
4. **GitHub Pages**: `dist/` becomes the release page <https://justr0st.github.io/TempCtl-Duo/> (a project page:
   every path in the page, the wiki and the demo is relative, so the same files work under `/TempCtl-Duo/` and
   at a site's root). The device's page and the S3 read `/TempCtl-Duo/dl/manifest.json` there (`REL_BASE` in
   `web/src/js/64-system-page.js`, `RELEASE_HOST` / `RELEASE_BASE` in `src/release.h`; a manifest url `/dl/…` is under that
   base). GitHub Pages lets any site read the files (CORS), as the device's own page needs; it caches them for
   10 min.
5. **GitHub release**: a version that has no tag `v<version>` yet (FW_VERSION in `src/version.h`) becomes a
   release with the firmware images and the desktop apps; its notes list the commits since the previous release
   tag. A push without a version change only updates the page.
6. **Cloudflare (transition)**: while the secrets `CLOUDFLARE_API_TOKEN` and `CLOUDFLARE_ACCOUNT_ID` exist, the
   same `dist/` also goes to <https://tempctl-duo.just-r0st.workers.dev> (`wrangler deploy`), where devices and
   desktop apps with 1.0.65 or older look for updates. Delete the secrets to stop it once those are updated.

Setup, once: the repository public, *Settings › Pages › Source: GitHub Actions*. The S3 trusts the roots in
`src/ca_roots.h` for its own download (`tools/gen_ca_roots.py`: GitHub's DigiCert / Sectigo chains, Let's
Encrypt for a custom domain, the Cloudflare chains).

**Without commit / push** (a test release from the PC to Cloudflare, your own Cloudflare login): in the
PlatformIO terminal, Git Bash: `bash tools/release_local.sh` (needs Node.js for `npx wrangler`, the first time
`npx wrangler login`; Go for the desktop app, else `--no-app`; `--dry` builds `dist/` only).

## Project layout

```
platformio.ini            environments s3, cyd-1xlocal-1x485, cyd-2xlocal, cyd-2xlocal-2x485; libraries
partitions_cyd_ota.csv    CYD flash layout: two firmware slots (OTA) + 192 kB file system
include/lv_conf.h         LVGL 9.6 configuration (only what differs from LVGL's defaults)
include/lv_blend_esp32s3.h, src/simd/  S3: Espressif's SIMD fills / copies for LVGL (Apache-2.0, esp-bsp)
include/lv_assert_custom.h  LVGL assert: backtrace + restart instead of a frozen screen
src/main.cpp              start-up, loop (S3 loop stack 16 kB, a warning in the log below 2 kB free)
src/version.h             product name, version, host / AP name
src/config.h              selects the board header, chart size
src/board_s3.h, board_cyd.h  pins, display, touch and LED per board
src/lcd.*                 display: LVGL's ST7796 / ILI9341 driver on ESP-IDF spi_master with DMA, frame rate meter
src/lv_mem_psram.c        S3: LVGL's memory in PSRAM
src/touch.h, touch_ft6336.cpp, touch_xpt2046.cpp  touch drivers (own FT6336U driver / XPT2046_Touchscreen)
src/status_led.*          status LED (WS2812 / single LED)
src/duo_program.*         programs (Sequence / Timeline): model, JSON, limits, examples (pure C++, unit-tested)
src/run_engine.*          one run engine for both types and channels, run edits, plan forecast (pure C++, unit-tested)
src/program_store.*       20 programs as JSON files on LittleFS
src/modbus_frame.h        Modbus RTU framing + CRC (pure C++, unit-tested)
src/modbus_rtu.*          half-duplex Modbus master (UART1 on the S3, UART2 on the CYD)
src/controller.*          register access of one controller on the shared bus, PMA parameter/action tables
src/settings.*            settings of both channels: defaults, validation, JSON (pure C++, unit-tested)
src/settings_store.*      /duo/settings.json on LittleFS (safe save)
src/channel.*             channel interface: Modbus backend (+ runaway check), local, off
src/local_ctrl.*          local channels: task reading the thermocouples, PID, SSR time proportioning, safety
src/tc_sensor.*, pid.*, runaway.*, autotune.*  MAX31855/MAX6675 decoding, PID, runaway check, relay autotune
                          (pure C++, unit-tested)
src/app_state.*           control task: polling both channels, run engine, manual setpoint per channel (public API:
                          app_state.h, also for the two files below)
src/app_hist.cpp          chart history: live ring, run rows, every reading, plan preview, /api/chart, live CSV
src/app_log.cpp           event log (logEvent, logRun, logWarn, ...)
src/app_internal.h        what these three files share (private to them)
src/raw_hist.h            every PV reading for the web chart (pure C++, unit-tested)
src/syslog.*              system log (RAM ring) + events saved to flash
src/crumbs.*              breadcrumbs for watchdog resets and crashes
src/net.*                 Wi-Fi, access point, mDNS
src/tui*.cpp, tui.h, ui.h touch UI of both boards (480×320 S3, 320×240 CYD)
src/fonts/                touch UI fonts (tools/lv_font_gen.py from tools/fonts/*.ttf)
src/web.*, host_check.h    HTTP server, JSON API, request checks
src/safety.*              E-stop input, alarm sound, user activity, chip temperature
src/ota.*, ota_image.*    firmware update (web upload, SD card), image check (pure C++, unit-tested), rollback
src/psram.h               PSRAM_VAR: large static variables in PSRAM on the S3 (plain statics on the CYD)
src/ota_net.*, release.*  release page: manifest (pure C++, unit-tested), S3 download over HTTPS
src/ca_roots.h            root certificates for it (tools/gen_ca_roots.py)
src/sdlog.*               SD card (S3): run logs, firmware.bin, backup files
src/backup.*              backup of settings + programs on the SD card (S3), restore
hardware/s3-schematic/    KiCad schematic of the S3 device (+ PDF / PNG)
hardware/cyd-schematic/   KiCad schematics of the three CYD wirings (+ PDF / PNG)
hardware/gen/             generator of both (Python 3: python3 make.py ..)
web/src/, tools/web_join.py  web page sources (HTML with include lines, css/, js/; web/src/README.md) → web/index.html
                          (generated, not in git: every tool below that needs the page joins it first)
web/, tools/web_embed.py  web page + fonts → src/web_assets.h (generated before each build)
tools/build_site.py       the same page as static files (device URL layout), for the launcher / the hosted page
wrangler.jsonc            the hosted page on Cloudflare (transition; dist/, built by build_site.py --web)
tools/release.py          release files + dl/manifest.json for the hosted page
tools/release_local.sh    the same release from a PC, without commit / push
docs/wiki/                the wiki (Markdown, _Sidebar.md = page list; img/: wiring SVGs, touch PNGs, web WebPs)
tools/wiki_site.py        the wiki as HTML pages for the hosted page (/wiki/, called by build_site.py --web)
tools/wiki/               the wiki pictures: make_shots.sh (all), wiring.py, touch_png.py, shots_web.js +
                          mock/server.py (demo device), demo_run.cpp (runs from the firmware's run engine)
demo/                     browser demo: the firmware's control code + simulated hardware (sim.cpp) as WebAssembly
                          (build.sh), demo.js connects the page to it; README.md
.github/workflows/        release.yml: builds firmware + desktop app, deploys page and files to GitHub Pages, GitHub releases
tools/launcher/           local app: Go launcher (build.sh → dist/tempctl-duo-<version>.exe)
test/ui_host/             touch UI preview on a PC (screenshots, random-tap test)
test/console_host/        serial console on a PC (scripted commands -> output)
src/console.*             serial console, LogSerial (log lines that don't break typed input)
test/host_test.cpp        g++ -std=c++17 -Wall -Wextra -Isrc -I<ArduinoJson>/src test/host_test.cpp src/duo_program.cpp src/run_engine.cpp src/settings.cpp src/tc_sensor.cpp src/pid.cpp src/runaway.cpp src/autotune.cpp src/ota_image.cpp src/release.cpp && ./a.out
```

## License

The project is under the **MIT License** (`LICENSE` in the repository); the third-party parts keep their own
licences, listed in `THIRD-PARTY-NOTICES.md`: Espressif's SIMD assembly in `src/simd/` and the two files that
follow its blend header (Apache-2.0, marked with SPDX lines), the Barlow fonts (SIL OFL 1.1), LVGL,
ArduinoJson and XPT2046_Touchscreen (MIT), the Arduino core (LGPL-2.1) and ESP-IDF (Apache-2.0 and others).
New third-party code: keep its notices, add it to `THIRD-PARTY-NOTICES.md`. The hosted page and the desktop
app serve both files as `/LICENSE.txt` and `/THIRD-PARTY-NOTICES.txt` (`tools/build_site.py`), linked under
Downloads.

## This wiki

- Pages: `docs/wiki/*.md` (GitHub shows them as they are), the page list: `docs/wiki/_Sidebar.md`.
- On the hosted page: `tools/wiki_site.py` turns them into `/wiki/*.html` (no packages: a small Markdown
  converter; links `Page.md` become `Page.html`).
- Pictures: `docs/wiki/img/` — regenerate them after a UI or wiring change with **`tools/wiki/make_shots.sh`**:

| Part | Made by |
|---|---|
| `img/wiring/*.svg` | `tools/wiki/wiring.py` (pins from `src/board_*.h`; keep them in step) |
| `img/touch/*.png` | the UI host (`test/ui_host`) in dark and light (`UIHOST_THEME=light`), framed by `tools/wiki/touch_png.py` |
| `img/web/*.webp` | `tools/wiki/shots_web.js` (Playwright) against a demo device, `tools/wiki/mock/server.py`, whose runs come from the firmware's own run engine (`tools/wiki/demo_run.cpp`) |

Theme-aware pictures use `<picture>` with a dark source; SVG diagrams follow the viewer's colour scheme by
themselves.
