justr0st/TempCtl-Duo/docs/wiki/Touch-screen.md

# Touch screen

The device's own screen does everything the web page does: run programs, edit them, set up channels, network,
display and safety. The pictures show the S3 (480×320); the CYD has the same screens in a compact form
([below](#cyd-320240)).

**Touch rule:** a press counts where it is released. Slide your finger off a button (more than about 10 px)
and nothing happens — a safe way to cancel a press.

## Main screen

<picture><source media="(prefers-color-scheme: dark)" srcset="img/touch/03-running-dark.png">Main screen during a run</picture>

- **Header**: the program (tap it to choose the program for the next run), the phase or steps, the state
  (Idle, Running, Paused …), run time and remaining time, and the run buttons: **Start / Pause / Continue**,
  **Stop**, **Next phase**.
- **Chart** of both channels: temperatures (solid), setpoints, the rest of the program (dashed). Tap it to
  switch between the **program view** and the **live view** (the last minutes; period under *Display*).
  With the [monitor channel](Channels.md#monitor-channel-s3) on (S3), its name and reading are at the bottom
  right of the chart, in the accent colour.
- **One tile per channel**: the temperature (PV), the setpoint (SP), the output bar, what the channel does
  (Ramp to 225 °C, Keeps 160 °C, Idle …). While its outputs are on, the tile gets a border and a tint in the
  channel colour.
- **Target stepper** `− value +`: during a run it changes the current (or kept) target of that channel;
  outside a run it is the **manual setpoint**. Hold + / − to repeat; tap the value for the number pad.
- A **fault badge** sits in the tile's top left corner (the channel name next to it; a long fault text
  scrolls). While the [cooling fan](Hardware-S3.md#optional-pins-and-the-cooling-fan) runs, *Fan* (with the rpm
  when there is a speed input) shows at the bottom right of the chart, where the monitor reading is.
- **Finished / Stopped badge**: tap it for the **run report** ([Programs](Programs.md#run-report)).

<picture><source media="(prefers-color-scheme: dark)" srcset="img/touch/31b-run-report-dark.png">Run report</picture>

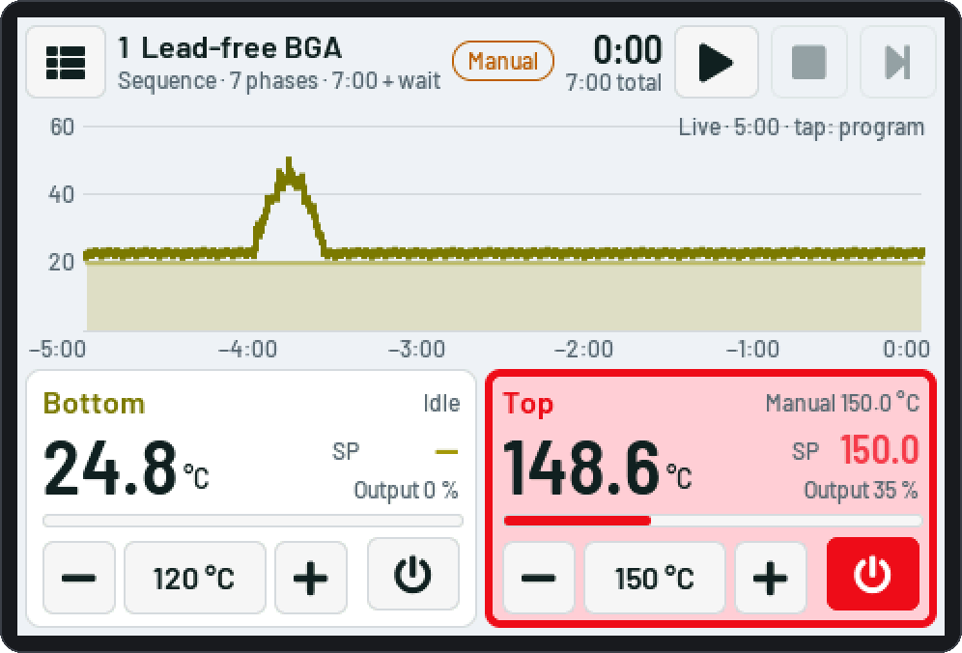
[picture p15: docs/wiki/img/touch/01-idle-light.png]
Main screen, idle
<picture><source media="(prefers-color-scheme: dark)" srcset="img/touch/01-idle-dark.png"></picture>

Outside a run each tile has the **manual on / off** button (filled in the channel colour while on): the
channel heats to the manual setpoint until you switch it off ([Programs](Programs.md#manual-setpoint)).

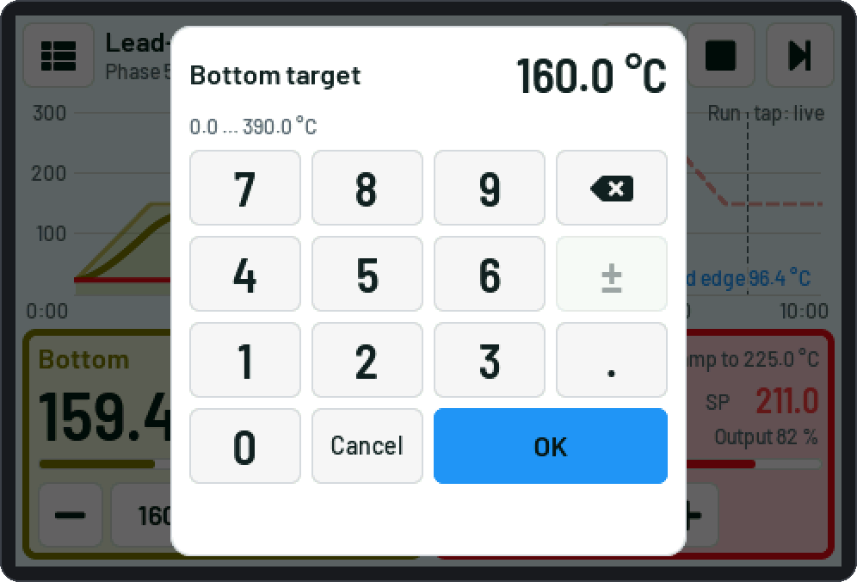
[picture p16: docs/wiki/img/touch/05-numpad-light.png]
Number pad for a target
<picture><source media="(prefers-color-scheme: dark)" srcset="img/touch/05-numpad-dark.png"></picture>

### Messages and overlays

| Picture | When |
|---|---|
| <picture><source media="(prefers-color-scheme: dark)" srcset="img/touch/06-action-dark.png">Action required</picture> | **Action required**: a Pause phase asks you to do something (place the board, lift the part …). *Continue* goes on, *Stop* ends the run. The alarm sounds two short beeps every 10 s until then. |
| <picture><source media="(prefers-color-scheme: dark)" srcset="img/touch/09-interrupted-dark.png">Run interrupted by a reset</picture> | **Run interrupted by a reset** (power loss, watchdog, crash): *Resume*, *Later* (the red "Interrupted" badge opens it again) or *Dismiss*. The device never resumes by itself. |
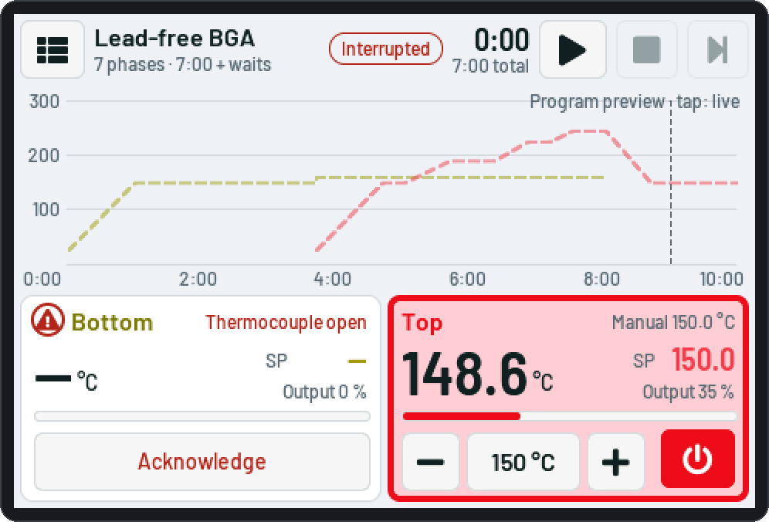
[picture p17: docs/wiki/img/touch/10-fault-light.png]
Channel fault
| <picture><source media="(prefers-color-scheme: dark)" srcset="img/touch/10-fault-dark.png"></picture> | **Fault** on a channel (no reading, runaway, over temperature …): outputs off, run stopped, the tile shows the reason and *Acknowledge*. |
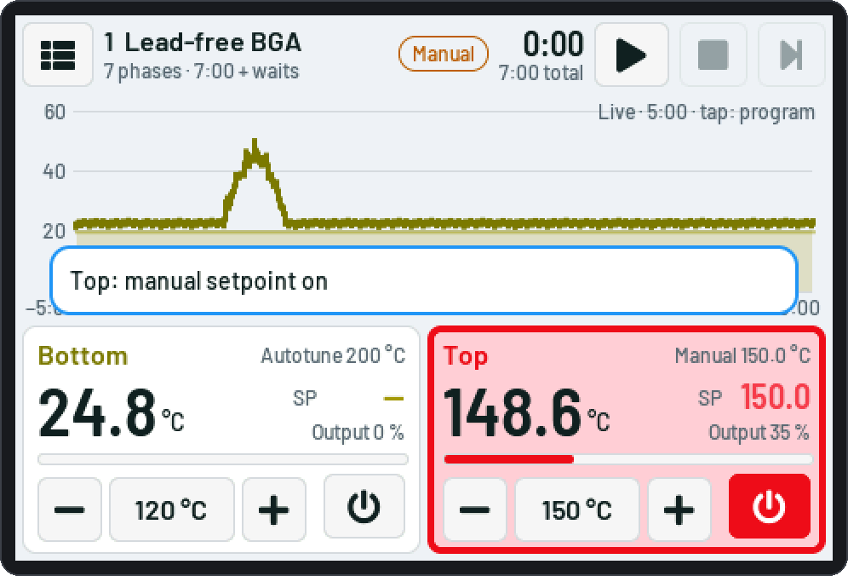
[picture p18: docs/wiki/img/touch/01b-tune-toast-light.png]
Autotune status and a message
| <picture><source media="(prefers-color-scheme: dark)" srcset="img/touch/01b-tune-toast-dark.png"></picture> | Short messages appear at the bottom; an autotune shows its progress in the tile. |

After a run with changes (run edits), the screen asks **"Save the run's changes?"** into the program.

## Menu

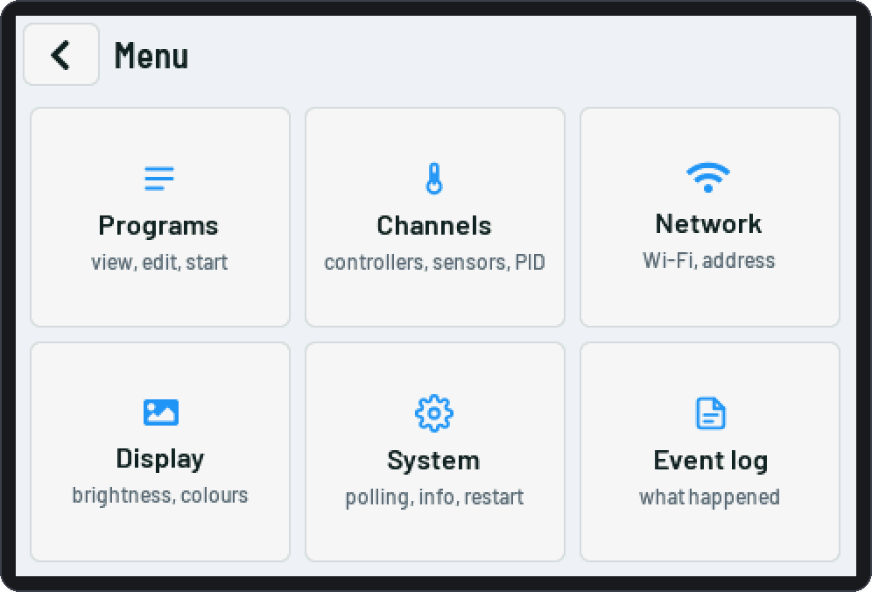
[picture p19: docs/wiki/img/touch/11-menu-light.png]
Menu
<picture><source media="(prefers-color-scheme: dark)" srcset="img/touch/11-menu-dark.png"></picture>

## Programs

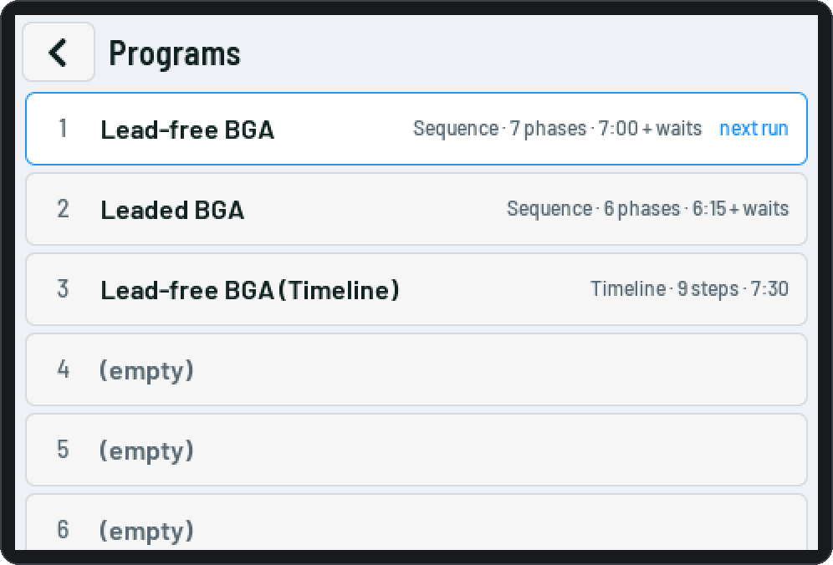
[picture p20: docs/wiki/img/touch/19-programs-light.png]
Program list
<picture><source media="(prefers-color-scheme: dark)" srcset="img/touch/19-programs-dark.png"></picture>

The 20 program slots. Tap a program to open it in the editor; an empty slot creates a new Sequence or
Timeline.

**Sequence editor** — one table, one row per phase:

<picture><source media="(prefers-color-scheme: dark)" srcset="img/touch/20-edit-seq-dark.png">Sequence editor</picture>

- Tap a value (target °C, ramp, hold) to change it with the number pad. In a **Both** phase and in a Timeline step a
  target of **0** switches that channel **off** for the phase / step; tap *off* and enter a temperature to switch it
  on again.
- Tap **#** or **Type** for the row menu: phase type (Bottom, Top, Both, Pause), *wait for bottom*, the pause
  text, *Fan*, insert, move, delete. The **Option** column shows *Wait*, *Action* and *Fan*; *Fan* (the cooling
  fan runs in this phase, [Programs](Programs.md#fan)) appears only when a fan output is configured.

<picture><source media="(prefers-color-scheme: dark)" srcset="img/touch/20c-edit-seq-fan-dark.png">Sequence editor with the Fan option</picture>
- The ☰ menu: Undo, Save, Start, Rename, Discard, Delete.

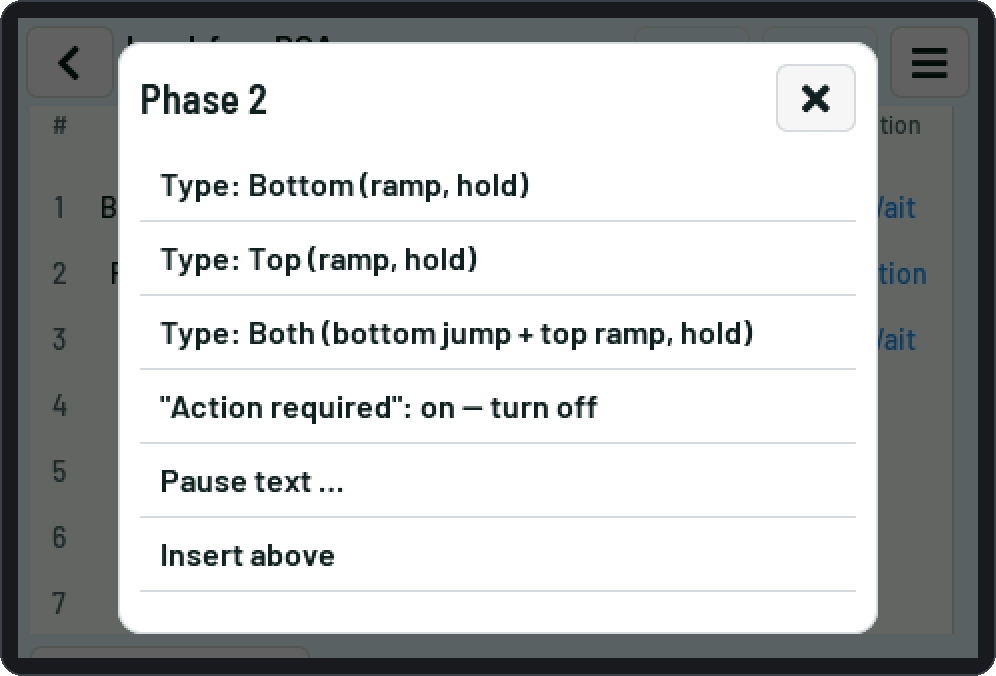
[picture p21: docs/wiki/img/touch/21-rowmenu-light.png]
Row menu of a phase
<picture><source media="(prefers-color-scheme: dark)" srcset="img/touch/21-rowmenu-dark.png"></picture>

**Timeline editor** — the two step lists side by side:

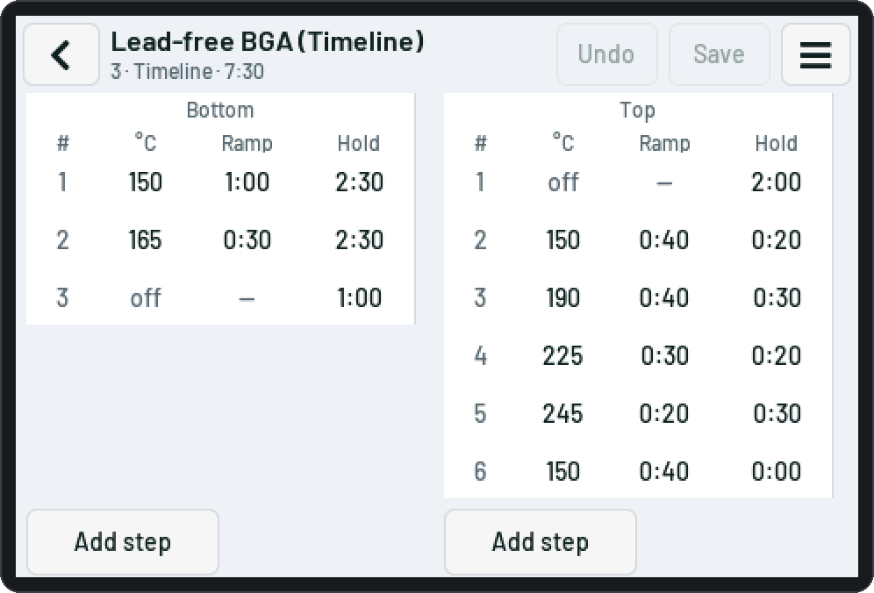
[picture p22: docs/wiki/img/touch/22-edit-tl-light.png]
Timeline editor
<picture><source media="(prefers-color-scheme: dark)" srcset="img/touch/22-edit-tl-dark.png"></picture>

During a run the editor shows the **running copy**: finished phases are locked, targets and times of the rest
can be changed (run edits).

## Channels

One tab per channel, on the S3 one for the monitor channel (*Monitor*: on / off, name, converter, calibration,
read interval, filter) and one for the RS485 bus (beta, only with a Modbus channel). *Save* stores the changes,
with the same checks as the web page. On the 480 × 320 screen related values share a row (setpoint range,
calibration offset and gain, Kp / Ki / Kd, the protection values with their time); the 320 × 240 screen has one
value per row. With the median filter off its reading count stays in place, greyed out. A local channel's
thermocouple part also has *Largest change per reading* and *Sensor fault after*
([Channels](Channels.md#thermocouple)); the channel tabs share the header's width.

| | |
|---|---|
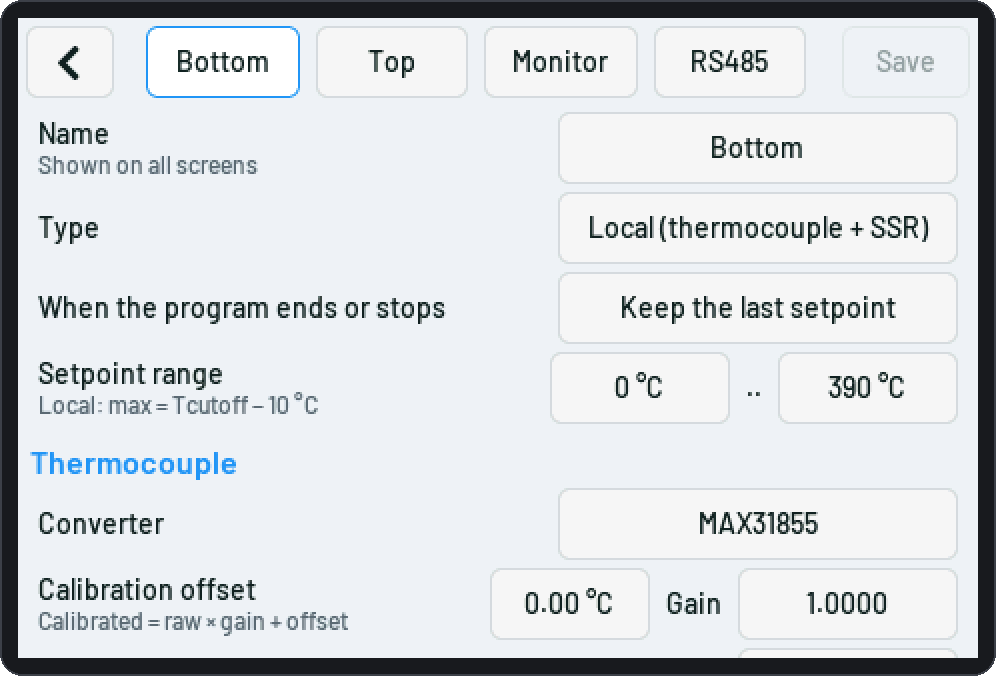
[picture p23: docs/wiki/img/touch/24-chan-local-light.png]
Local channel
| <picture><source media="(prefers-color-scheme: dark)" srcset="img/touch/24-chan-local-dark.png"></picture> | <picture><source media="(prefers-color-scheme: dark)" srcset="img/touch/27-chan-pid-dark.png">PID and autotune</picture> |
| Name, type, end action, setpoint limits, thermocouple converter, filter | PID values and the **autotune** (test temperature, Start) |
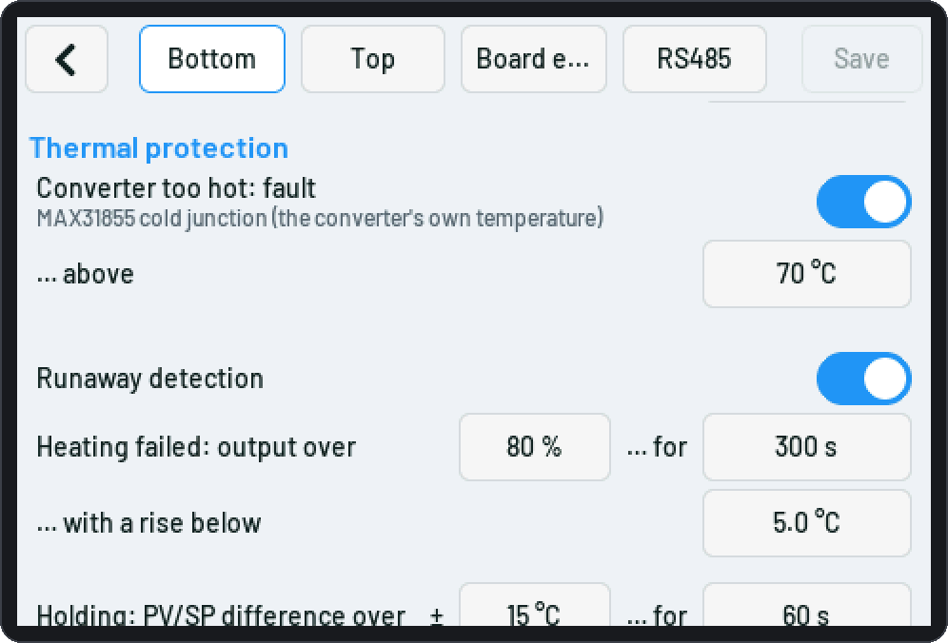
[picture p24: docs/wiki/img/touch/28-chan-runaway-light.png]
Protection settings
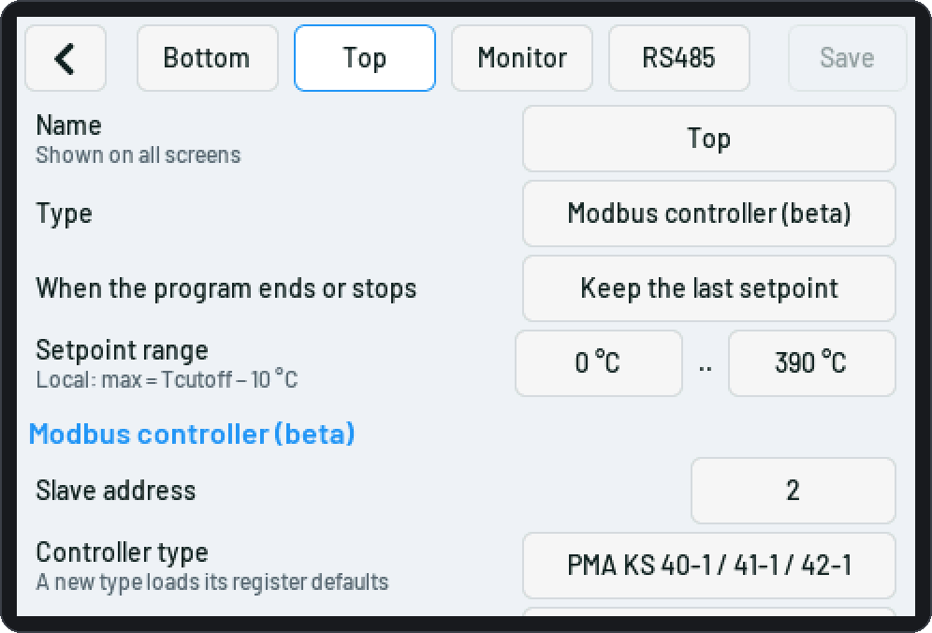
[picture p25: docs/wiki/img/touch/25-chan-modbus-light.png]
Modbus channel
| <picture><source media="(prefers-color-scheme: dark)" srcset="img/touch/28-chan-runaway-dark.png"></picture> | <picture><source media="(prefers-color-scheme: dark)" srcset="img/touch/25-chan-modbus-dark.png"></picture> |
| Thermal protection: converter too hot, runaway, heating while off, frozen reading | A Modbus channel (beta): address, controller type, setpoint ramps |

Register addresses and the two-point calibration are on the web page.

## Network

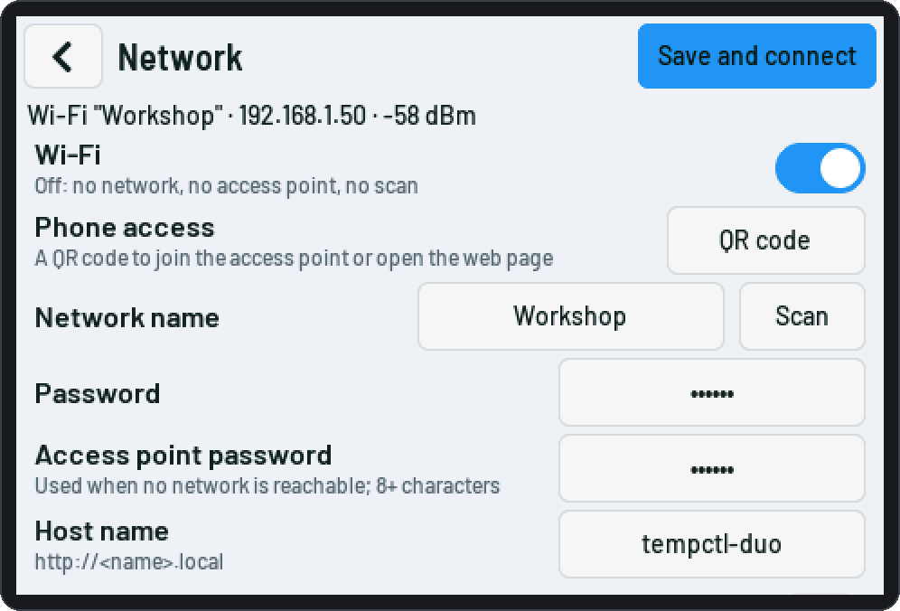
[picture p26: docs/wiki/img/touch/13-network-light.png]
Network settings
<picture><source media="(prefers-color-scheme: dark)" srcset="img/touch/13-network-dark.png"></picture>

**Wi-Fi** on / off (off: no network, no access point, no scan; applied at once), network name (tap: scan and
pick), password, access point password, host name (`http://<name>.local`), fixed IP address, and **Phone
access › QR code**: on a Wi-Fi network a code with the device's address; in access point mode a code that joins
the Wi-Fi and one with the address (side by side on the S3, one after the other on the CYD: *Next*). Scan it
with a phone's camera. The code is made when the window opens; without a network the button does nothing.

| | |
|---|---|
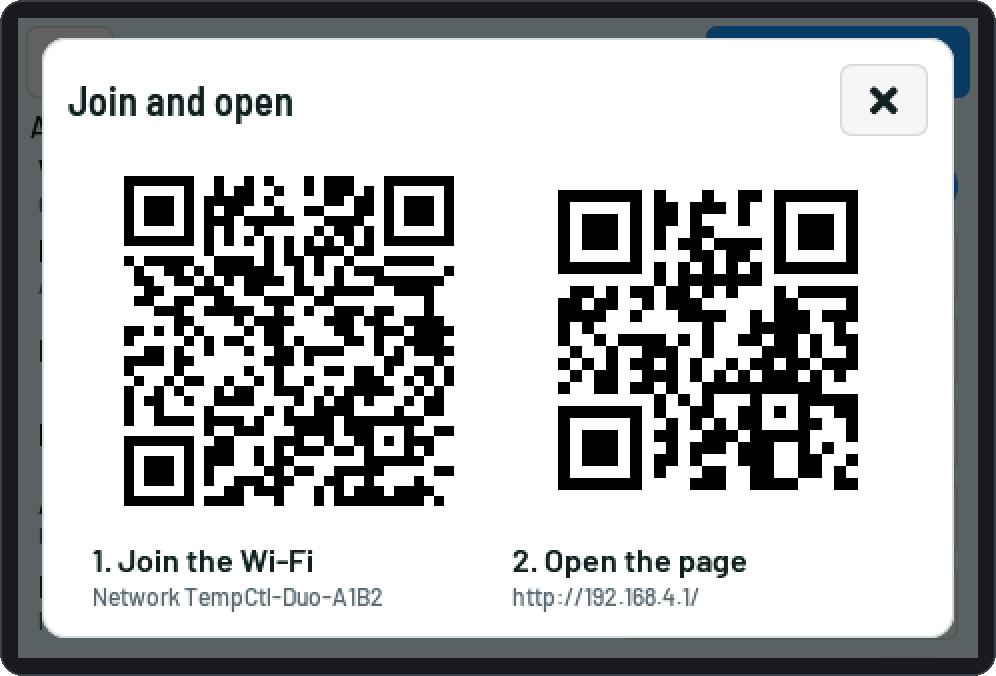
[picture p27: docs/wiki/img/touch/13c-qr-ap-light.png]
QR codes in access point mode
| <picture><source media="(prefers-color-scheme: dark)" srcset="img/touch/13b-qr-station-dark.png">QR code of the device address</picture> | <picture><source media="(prefers-color-scheme: dark)" srcset="img/touch/13c-qr-ap-dark.png"></picture> |
| On a Wi-Fi network: the address of the page | Access point mode: join the Wi-Fi, then open the page |

The on-screen keyboard:

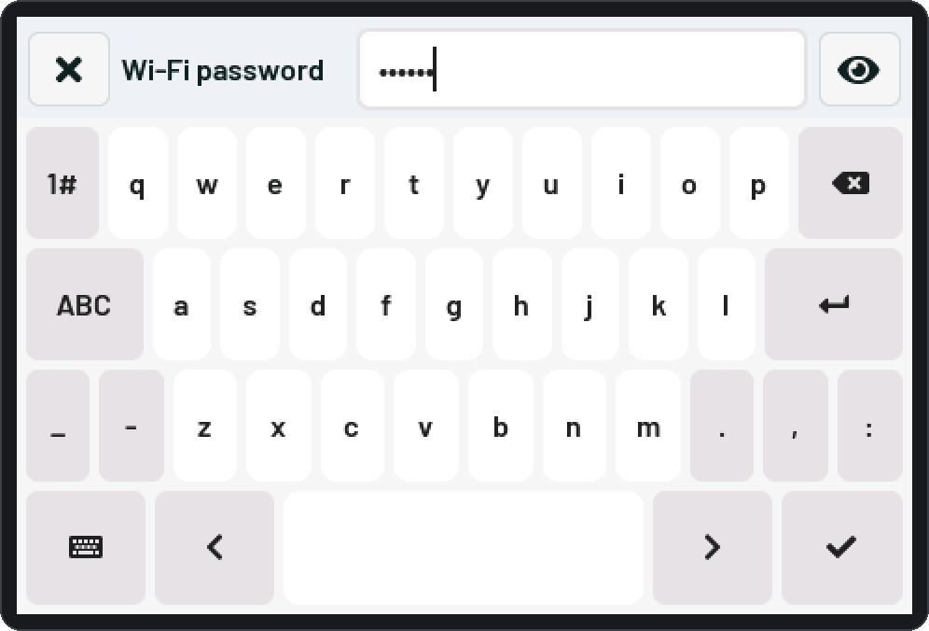
[picture p28: docs/wiki/img/touch/16-keyboard-light.png]
Keyboard
<picture><source media="(prefers-color-scheme: dark)" srcset="img/touch/16-keyboard-dark.png"></picture>

## Display

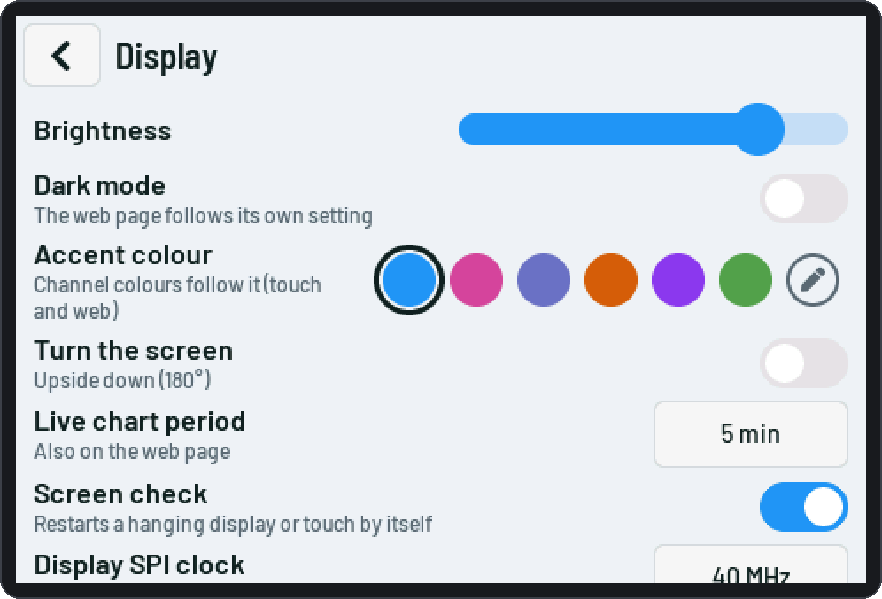
[picture p29: docs/wiki/img/touch/12-display-light.png]
Display settings
<picture><source media="(prefers-color-scheme: dark)" srcset="img/touch/12-display-dark.png"></picture>

Brightness, dark mode, **accent colour** (six presets or any colour; the channel colours follow it, on the
web page too), upside down, live chart period, the automatic **screen check**, the **display SPI clock**
(20 / 40 / 80 MHz) and the **frame rate meter** ([Troubleshooting](Troubleshooting.md#display-speed)).

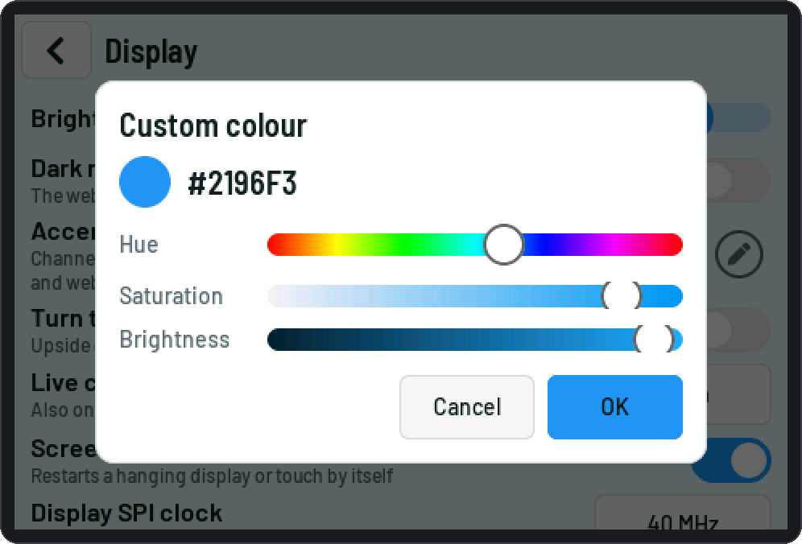
[picture p30: docs/wiki/img/touch/12b-accent-picker-light.png]
Accent colour picker
<picture><source media="(prefers-color-scheme: dark)" srcset="img/touch/12b-accent-picker-dark.png"></picture>

## System

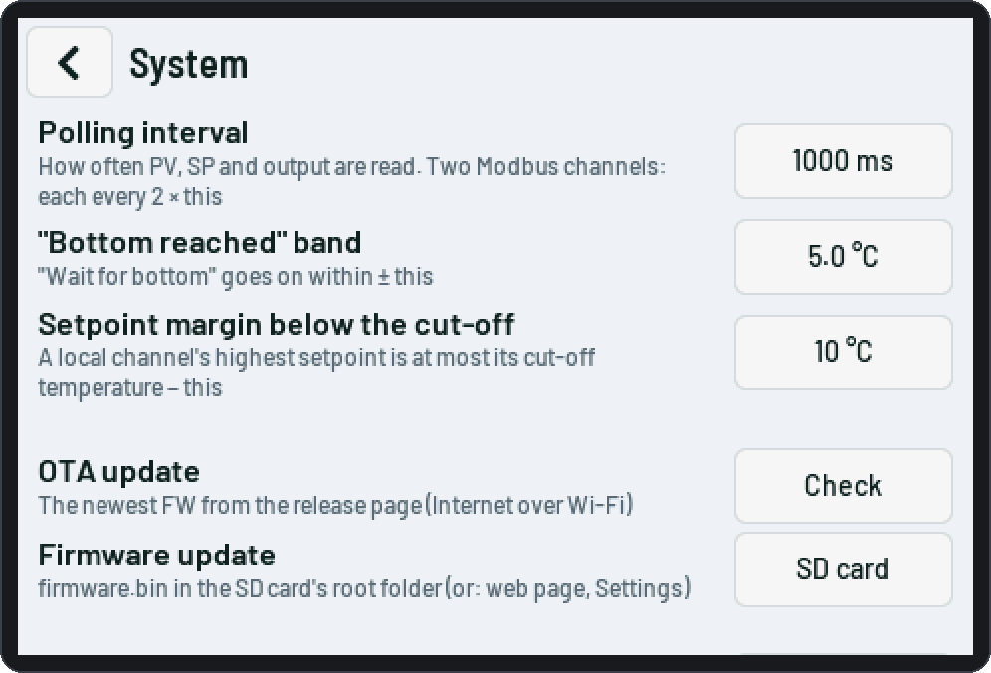
[picture p31: docs/wiki/img/touch/14-system-light.png]
System settings
<picture><source media="(prefers-color-scheme: dark)" srcset="img/touch/14-system-dark.png"></picture>

In groups: polling interval, "bottom reached" band and the setpoint margin below the cut-off; **OTA update** (S3: the newest release over Wi-Fi) and
**Firmware update** from the SD card; **Backup to SD card** and **Restore from SD card**; time zone; the safety
settings (manual mode timeout, E-stop input, SSR supply relay, alarm sound with **sound volume** 1 … 5 and
**key beep**, chip temperature warning); on the S3 the **optional pins** (what GPIO 4, 5, 6 do) and the
**cooling fan** (run after a program, until every channel is below, at most, PWM speed; shown when a fan output is
set); device info and restart. E-stop, relay and sound rows appear only when a pin has that function.

| | |
|---|---|
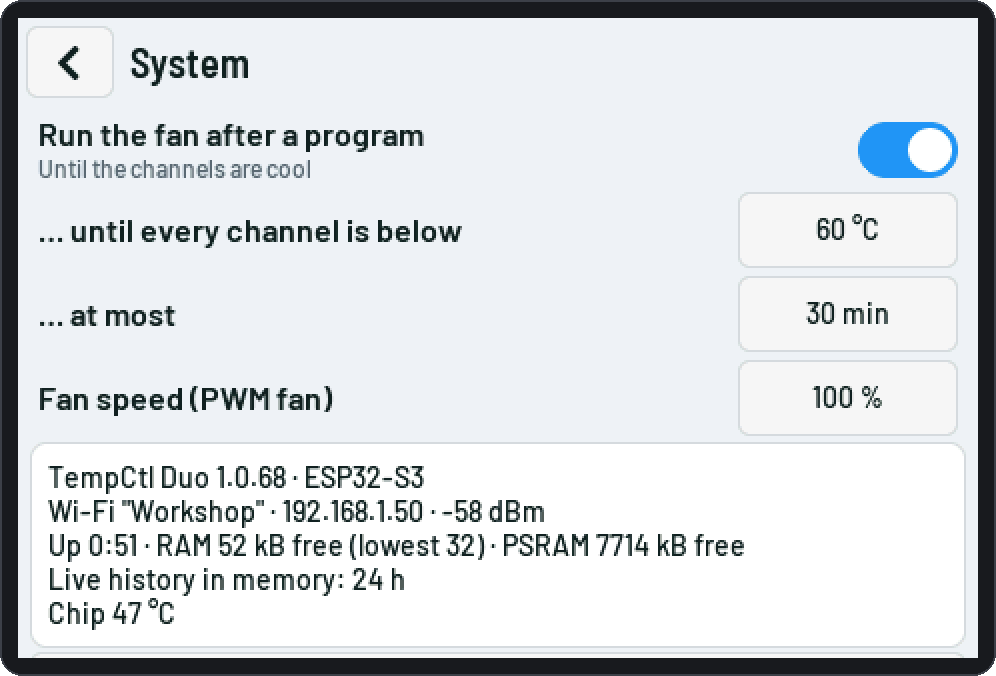
[picture p32: docs/wiki/img/touch/14l-system-fan-light.png]
Cooling fan settings
| <picture><source media="(prefers-color-scheme: dark)" srcset="img/touch/14k-system-sound-pins-dark.png">Sound volume and optional pins</picture> | <picture><source media="(prefers-color-scheme: dark)" srcset="img/touch/14l-system-fan-dark.png"></picture> |
| Sound volume, key beep, optional pins | Cooling fan |

| | |
|---|---|
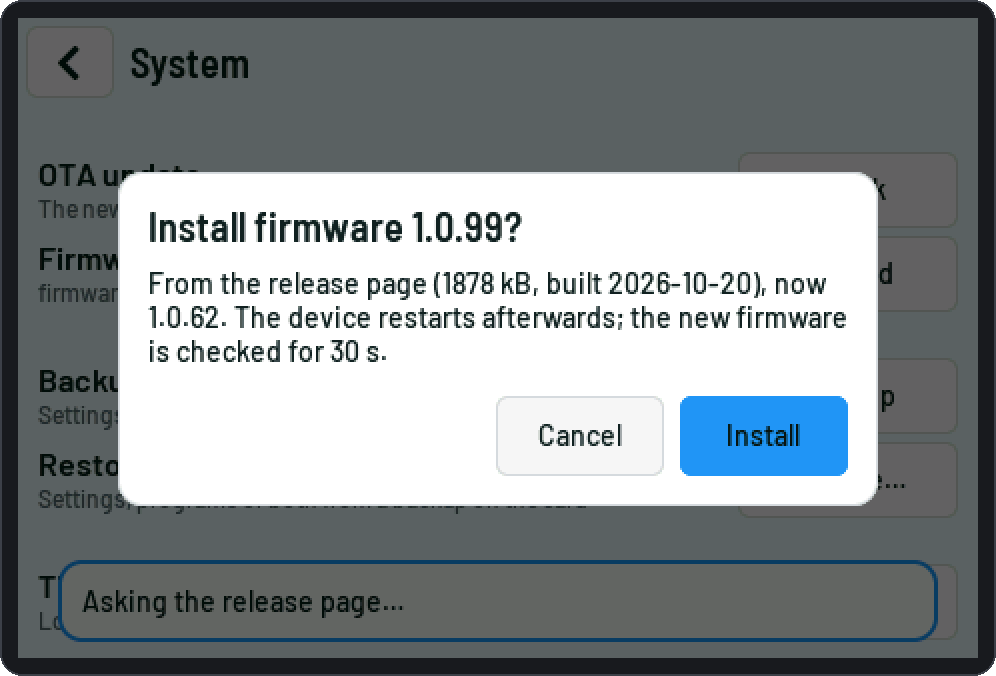
[picture p33: docs/wiki/img/touch/14j-online-update-light.png]
OTA update dialog
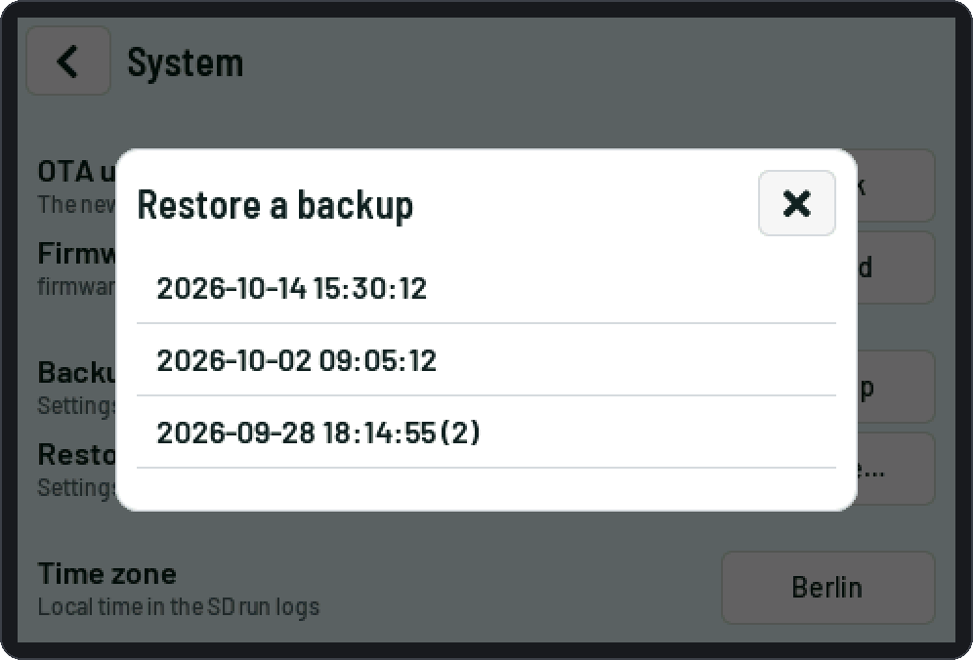
[picture p34: docs/wiki/img/touch/14f-restore-list-light.png]
Restore from the SD card
| <picture><source media="(prefers-color-scheme: dark)" srcset="img/touch/14j-online-update-dark.png"></picture> | <picture><source media="(prefers-color-scheme: dark)" srcset="img/touch/14f-restore-list-dark.png"></picture> |
| OTA update: a newer release was found | Restore: the backups on the SD card, newest first |
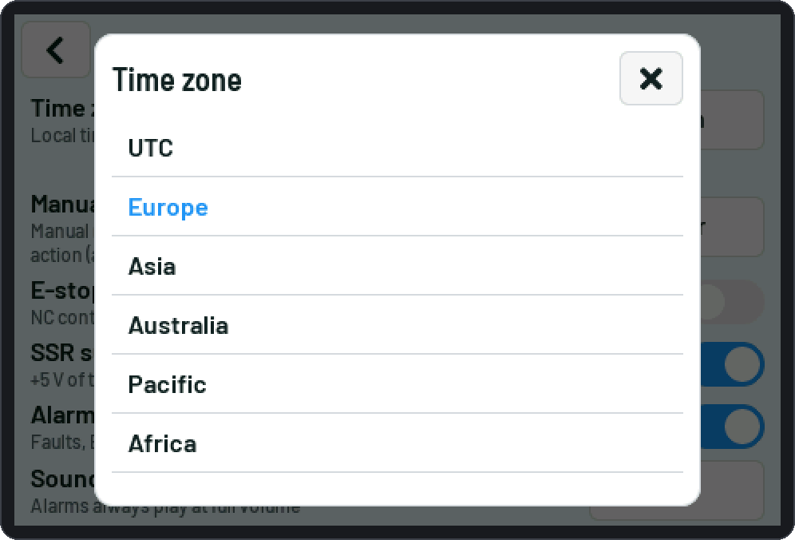
[picture p35: docs/wiki/img/touch/14b-tz-regions-light.png]
Time zone
| <picture><source media="(prefers-color-scheme: dark)" srcset="img/touch/14b-tz-regions-dark.png"></picture> | <picture><source media="(prefers-color-scheme: dark)" srcset="img/touch/14d-system-safety-dark.png">Safety settings</picture> |
| Time zone: region, then place | Safety settings ([Safety](Safety.md)) |

During a firmware update the whole screen shows the progress — don't switch off:

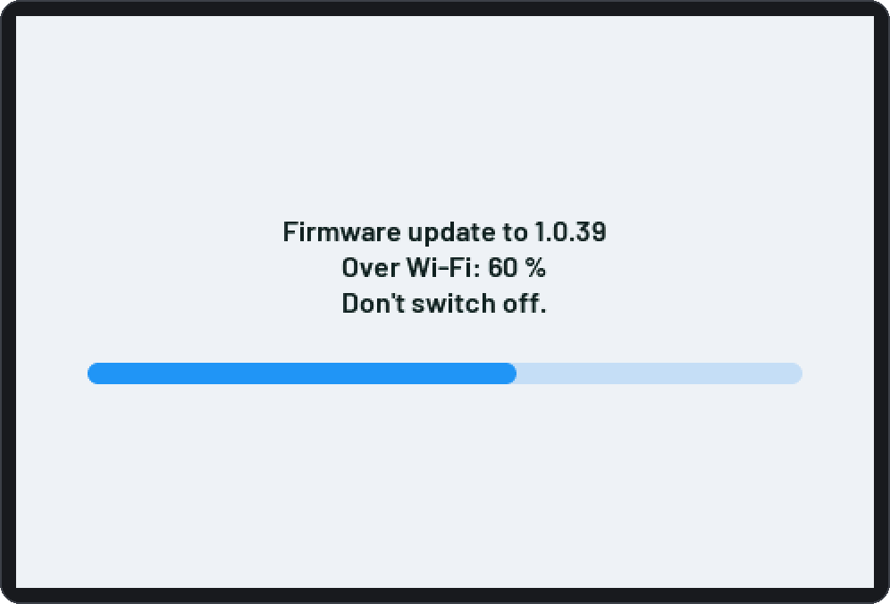
[picture p36: docs/wiki/img/touch/30-ota-light.png]
Firmware update in progress
<picture><source media="(prefers-color-scheme: dark)" srcset="img/touch/30-ota-dark.png"></picture>

## Event log

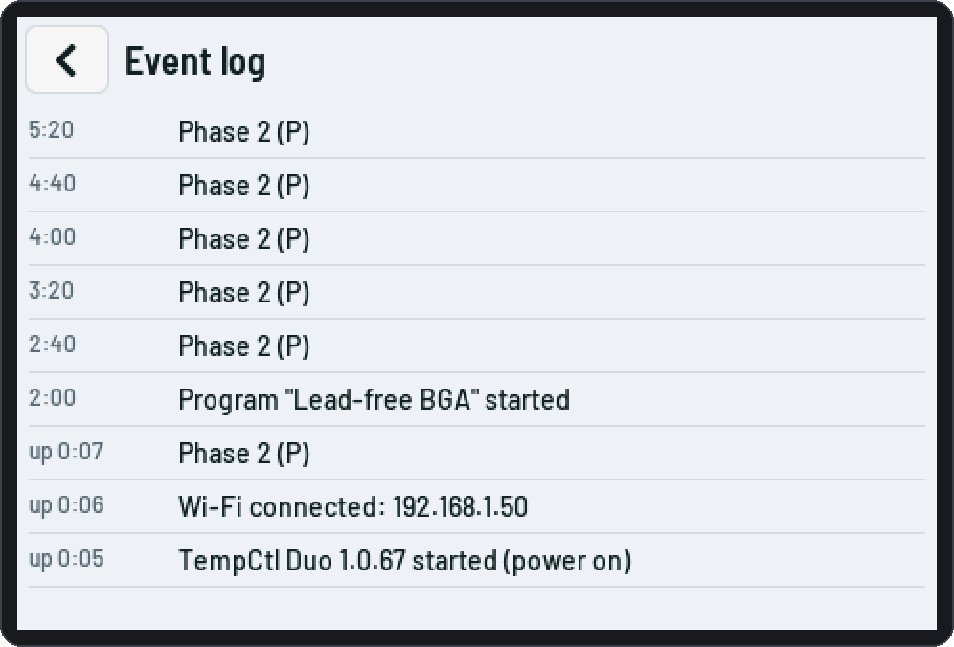
[picture p37: docs/wiki/img/touch/15-log-light.png]
Event log
<picture><source media="(prefers-color-scheme: dark)" srcset="img/touch/15-log-dark.png"></picture>

## CYD (320×240)

The CYD has the same screens as a compact set: the run buttons and the menu move to a bottom bar, each tile has
one SP button (tap: number pad) instead of the stepper, the Sequence editor shows one line per phase (tap: the
phase menu) and the Timeline editor one table with a channel switch above it.

| | |
|---|---|
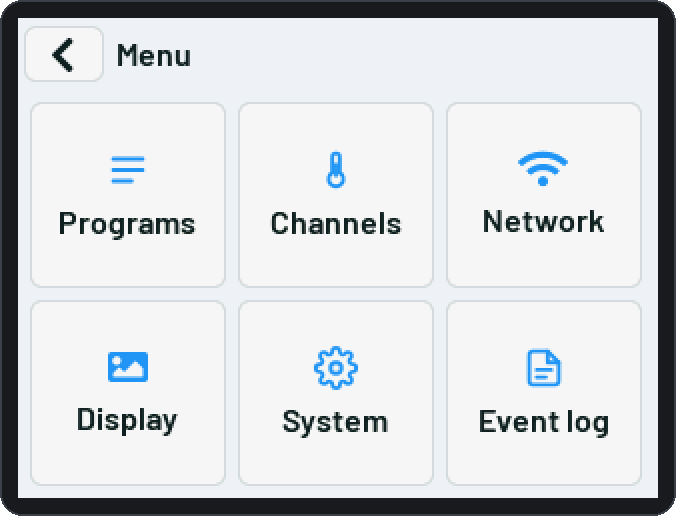
[picture p38: docs/wiki/img/touch/cyd-11-menu-light.png]
CYD menu
| <picture><source media="(prefers-color-scheme: dark)" srcset="img/touch/cyd-03-running-dark.png">CYD main screen</picture> | <picture><source media="(prefers-color-scheme: dark)" srcset="img/touch/cyd-11-menu-dark.png"></picture> |
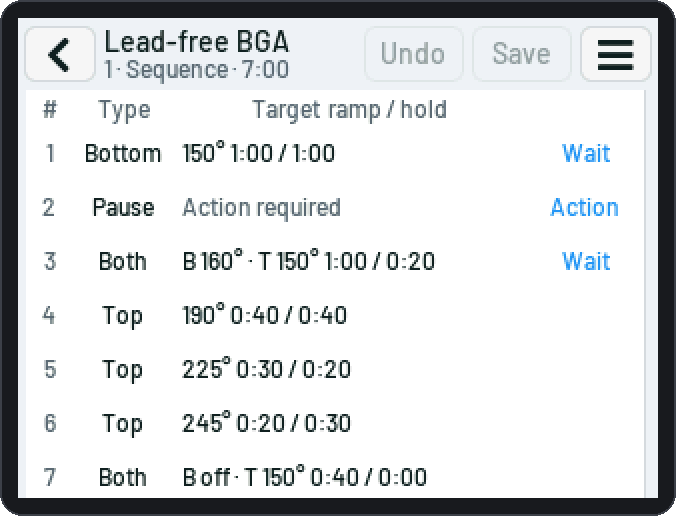
[picture p39: docs/wiki/img/touch/cyd-20-edit-seq-light.png]
CYD Sequence editor
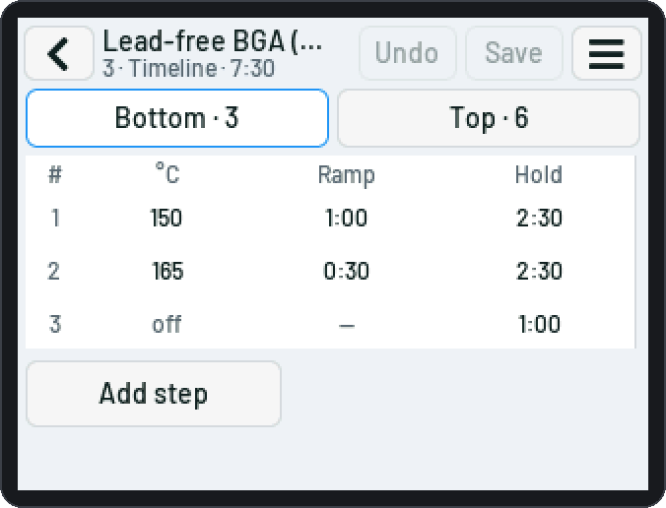
[picture p40: docs/wiki/img/touch/cyd-22-edit-tl-light.png]
CYD Timeline editor
| <picture><source media="(prefers-color-scheme: dark)" srcset="img/touch/cyd-20-edit-seq-dark.png"></picture> | <picture><source media="(prefers-color-scheme: dark)" srcset="img/touch/cyd-22-edit-tl-dark.png"></picture> |
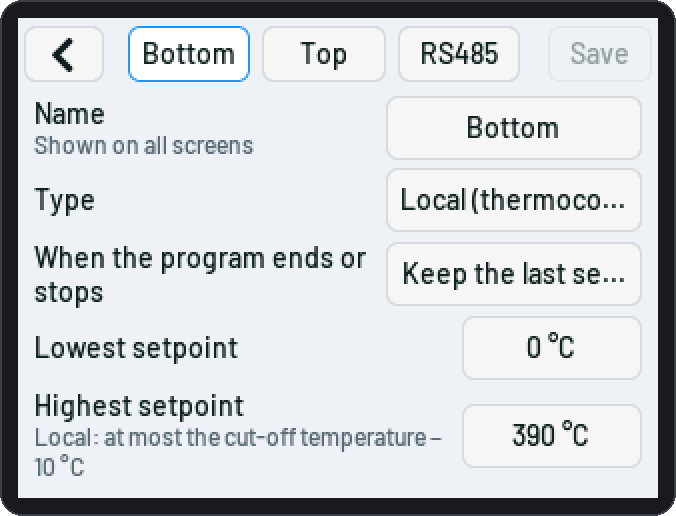
[picture p41: docs/wiki/img/touch/cyd-24-chan-local-light.png]
CYD channel settings
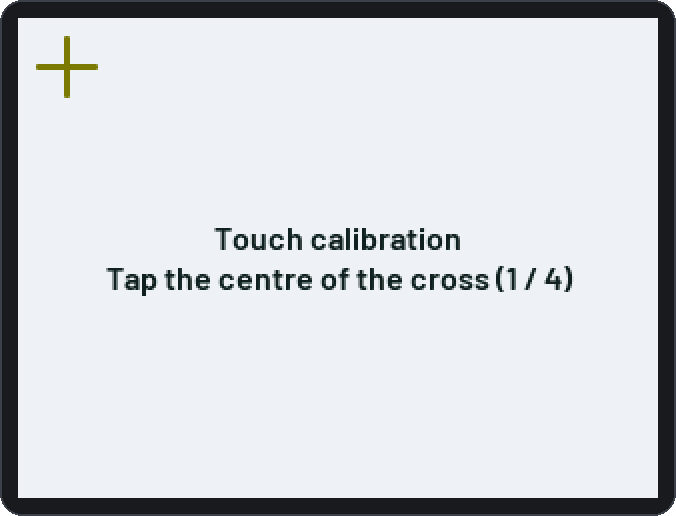
[picture p42: docs/wiki/img/touch/cyd-29-touch-cal-light.png]
CYD touch calibration
| <picture><source media="(prefers-color-scheme: dark)" srcset="img/touch/cyd-24-chan-local-dark.png"></picture> | <picture><source media="(prefers-color-scheme: dark)" srcset="img/touch/cyd-29-touch-cal-dark.png"></picture> |
