justr0st/TempCtl-Duo/docs/wiki/_Sidebar.md

### Start
- [Home](Home.md)
- [Getting started](Getting-started.md)
- [Browser demo](Demo.md)

### Hardware
- [ESP32-S3 board](Hardware-S3.md)
- [CYD board](Hardware-CYD.md)

### Using it
- [Touch screen](Touch-screen.md)
- [Web page](Web-page.md)
- [Programs and runs](Programs.md)
- [Channels, PID and autotune](Channels.md)
- [Safety and protections](Safety.md)

### Maintenance
- [Updates and backups](Updates-and-backups.md)
- [Desktop app and USB](Desktop-app.md)
- [Serial console](Serial-console.md)
- [Troubleshooting](Troubleshooting.md)
- [Modbus controllers (beta)](Modbus.md)
- [For developers](Development.md)
- [Web API](Web-API.md)
- [How it works inside](Internals.md)
