justr0st/TempCtl-Duo/Claude outputs/tempctl-lvgl9-xml-screens.png

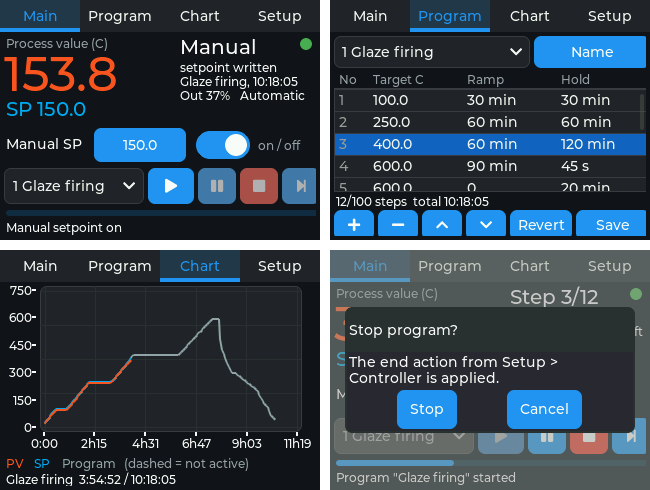
Claude outputs/tempctl-lvgl9-xml-screens.png
