justr0st/TempCtl-Duo/Claude outputs/tempctl-touch-screens.png

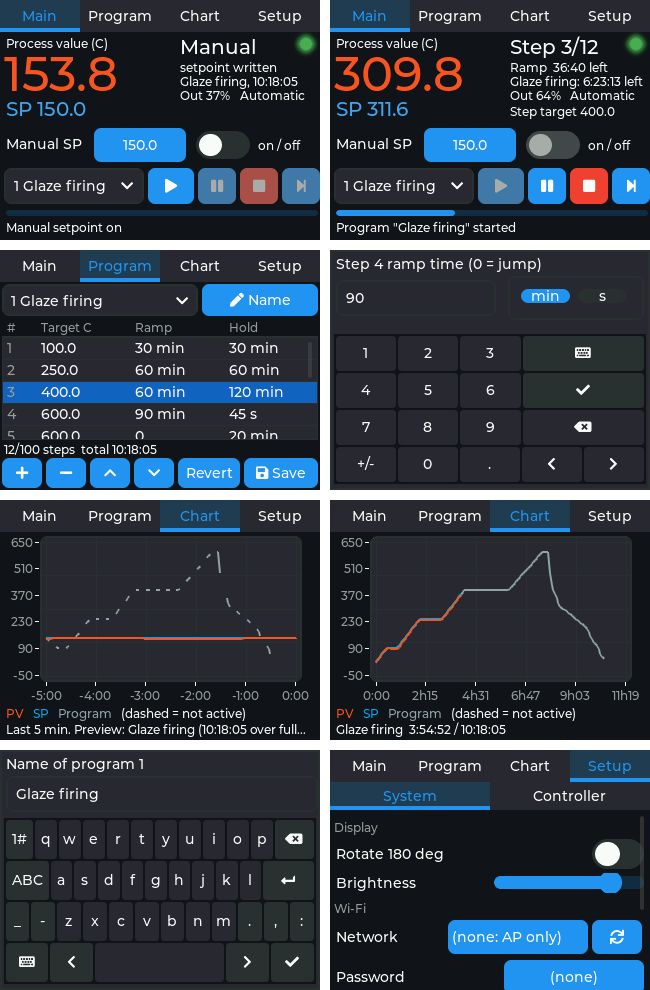
Claude outputs/tempctl-touch-screens.png
