justr0st/TempCtl-Duo/Claude outputs/ui-screens/02_chart_idle.png

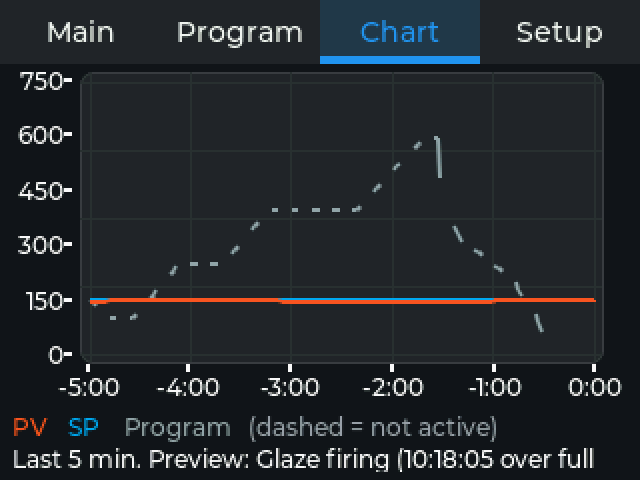
Claude outputs/ui-screens/02_chart_idle.png
