justr0st/TempCtl-Duo/Claude outputs/ui-screens/03_program_selected.png

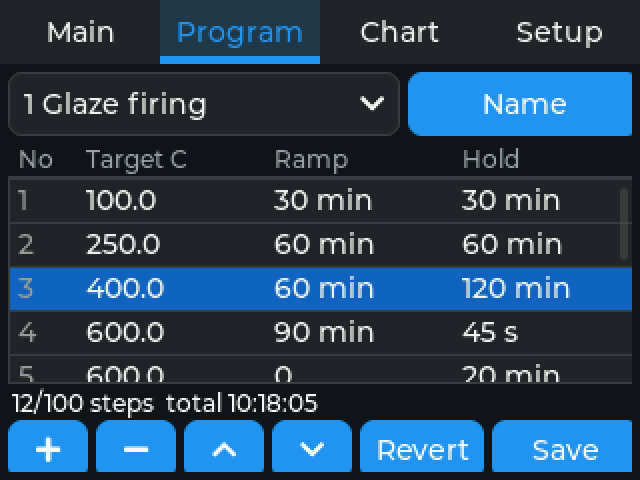
Claude outputs/ui-screens/03_program_selected.png
