justr0st/TempCtl-Duo/Claude outputs/ui-screens/04_time_editor.png

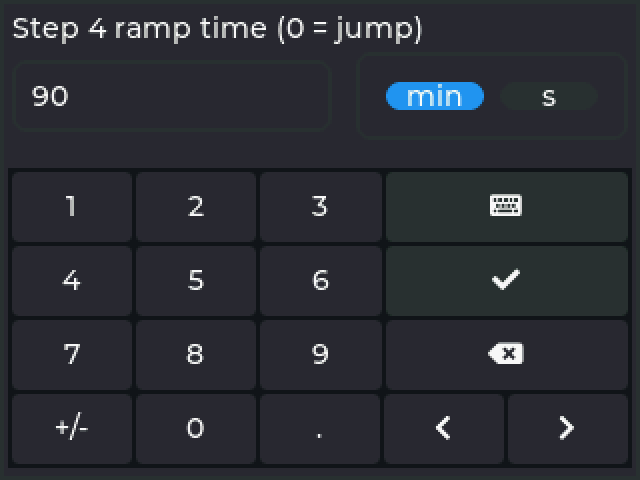
Claude outputs/ui-screens/04_time_editor.png
