justr0st/TempCtl-Duo/Claude outputs/ui-screens/06_name_keyboard.png

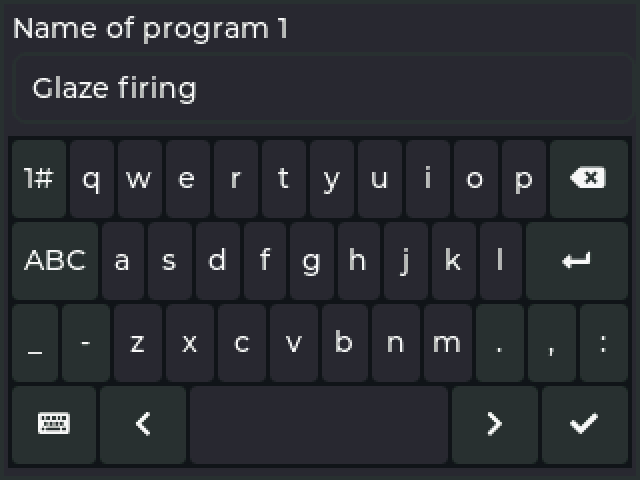
Claude outputs/ui-screens/06_name_keyboard.png
