justr0st/TempCtl-Duo/Claude outputs/ui-screens/07_program_dropdown.png

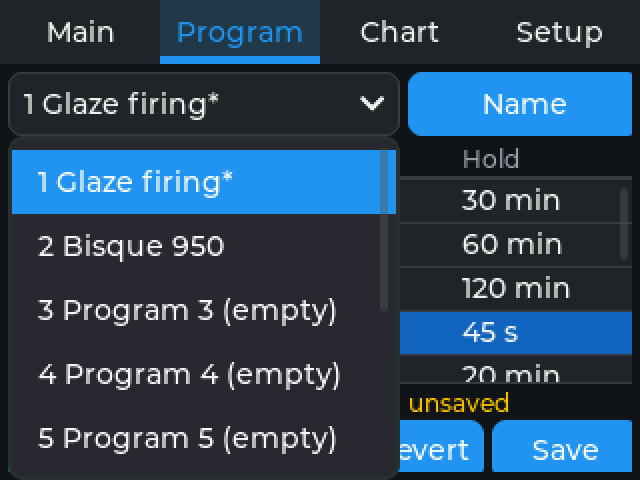
Claude outputs/ui-screens/07_program_dropdown.png
