justr0st/TempCtl-Duo/Claude outputs/ui-screens/08_main_running.png

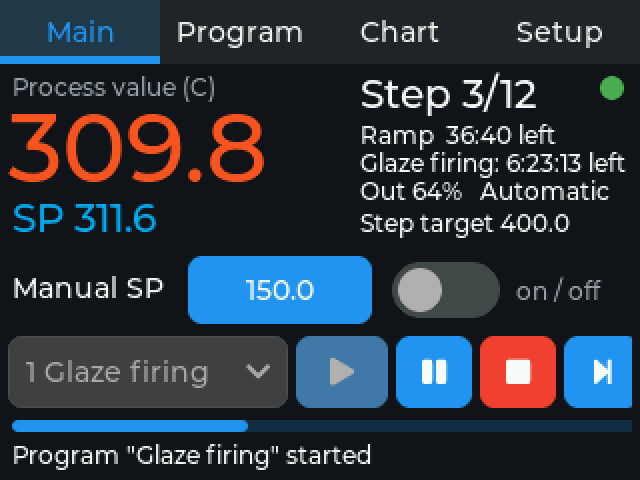
Claude outputs/ui-screens/08_main_running.png
