justr0st/TempCtl-Duo/Claude outputs/ui-screens/09_chart_running.png

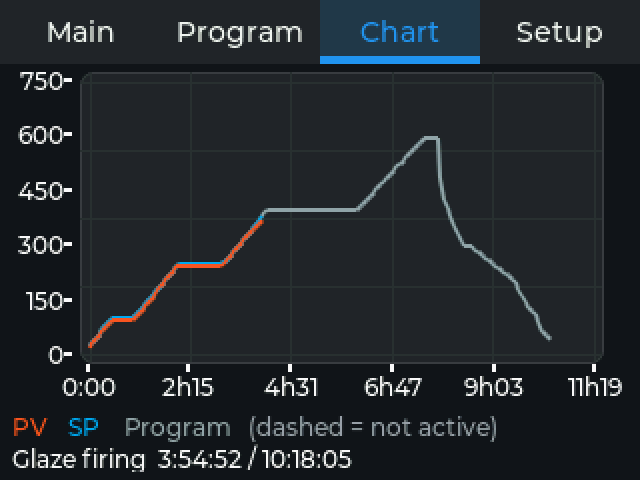
Claude outputs/ui-screens/09_chart_running.png
