justr0st/TempCtl-Duo/Claude outputs/ui-screens/12_stop_confirm.png

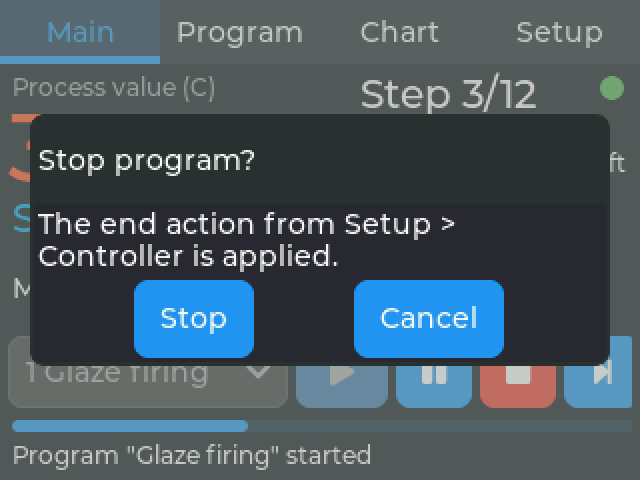
Claude outputs/ui-screens/12_stop_confirm.png
