justr0st/TempCtl-Duo/Claude outputs/ui-screens/tempctl-ui-overview.png

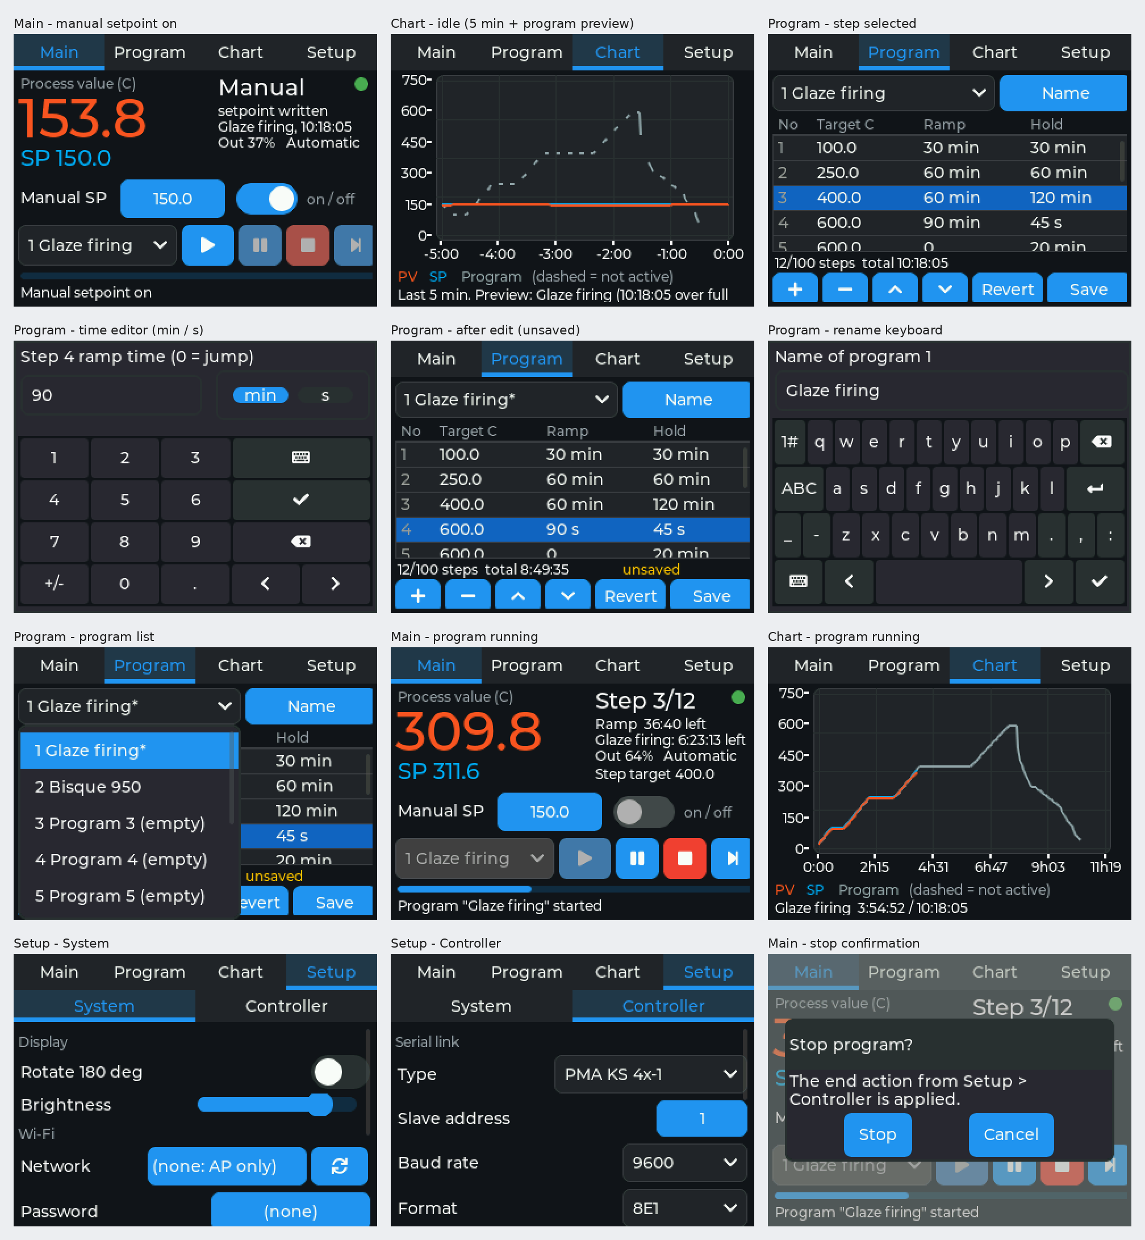
Claude outputs/ui-screens/tempctl-ui-overview.png
