justr0st/TempCtl-Duo/claude/wiring/cyd-schematic-p1-annotated.png

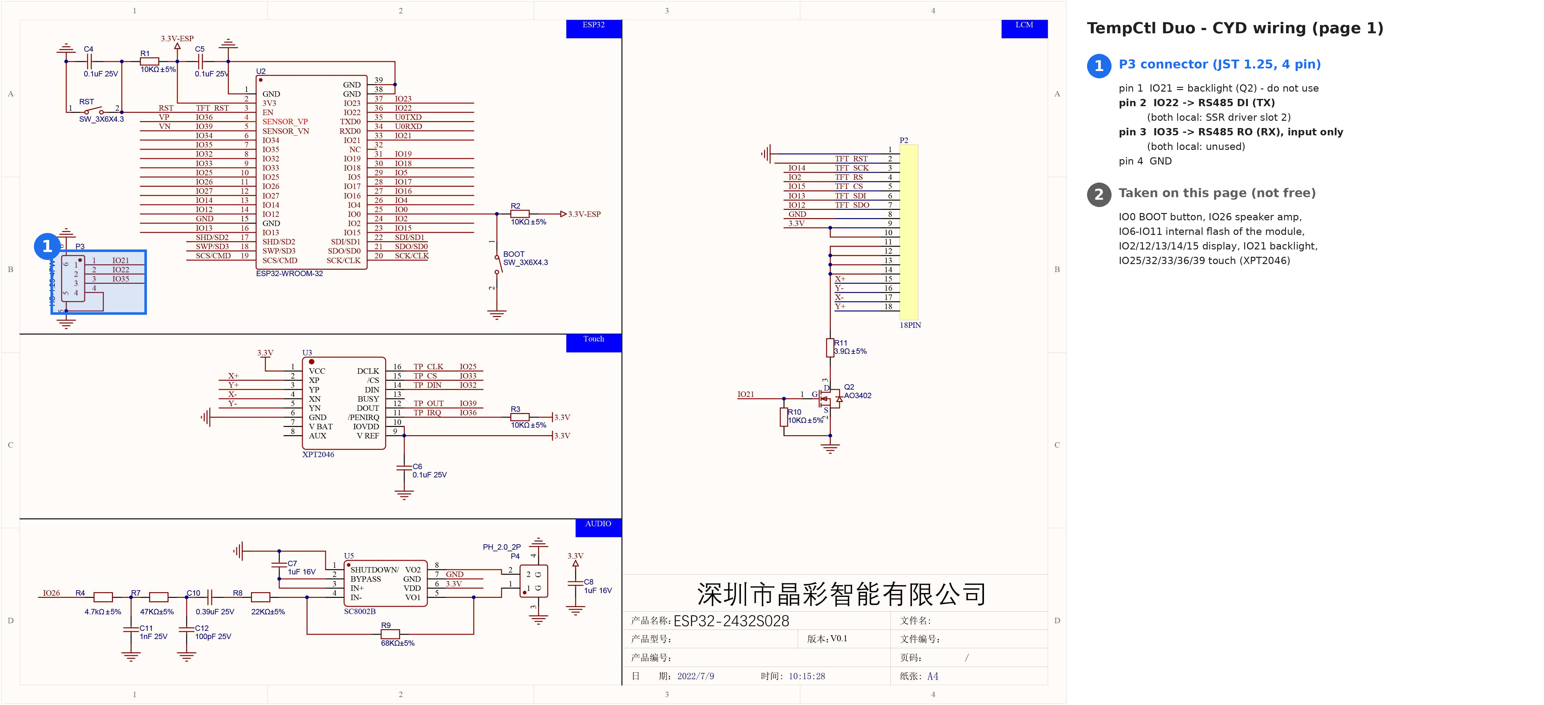
claude/wiring/cyd-schematic-p1-annotated.png
