justr0st/TempCtl-Duo/claude/wiring/cyd-schematic-p2-annotated.png

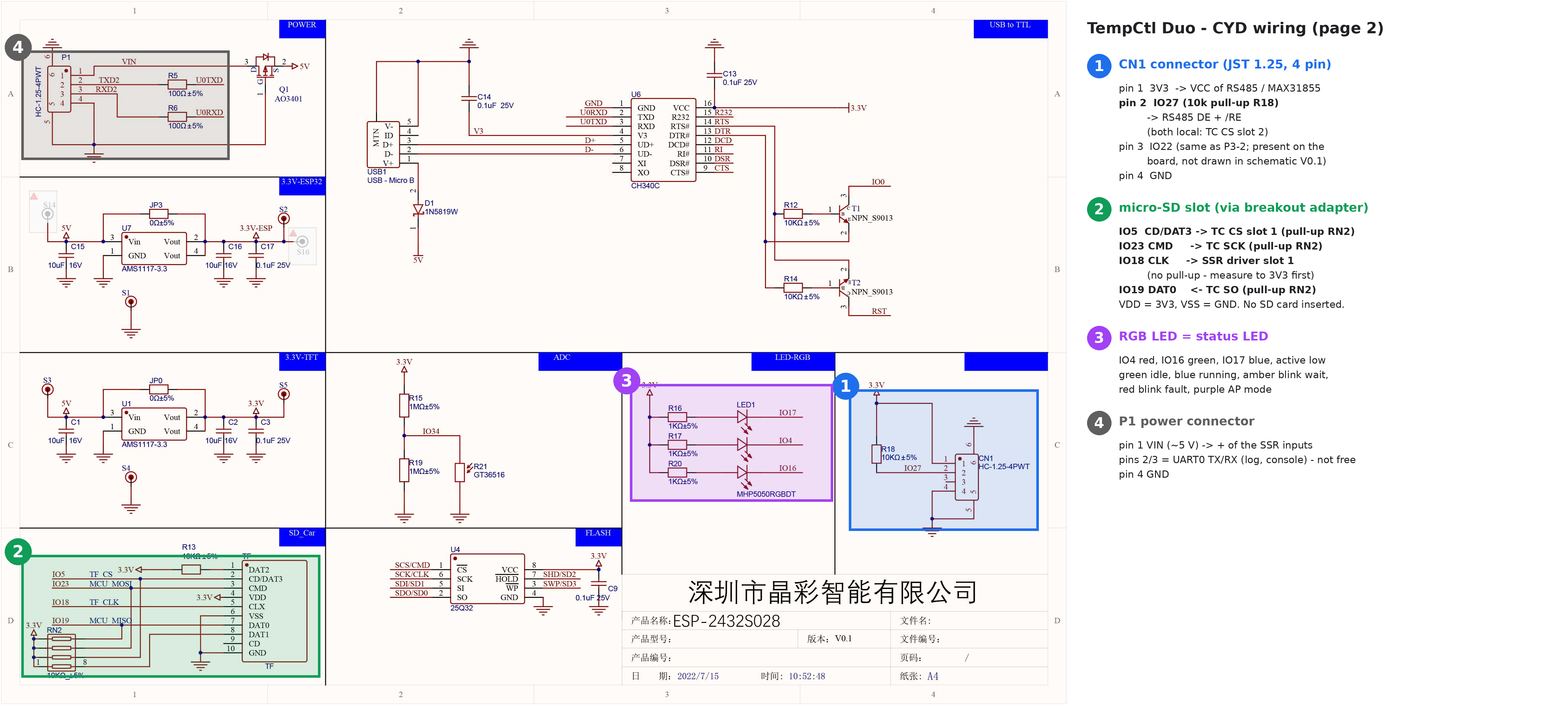
claude/wiring/cyd-schematic-p2-annotated.png
