justr0st/TempCtl-Duo/docs/wiki/img/touch/01-idle-dark.png

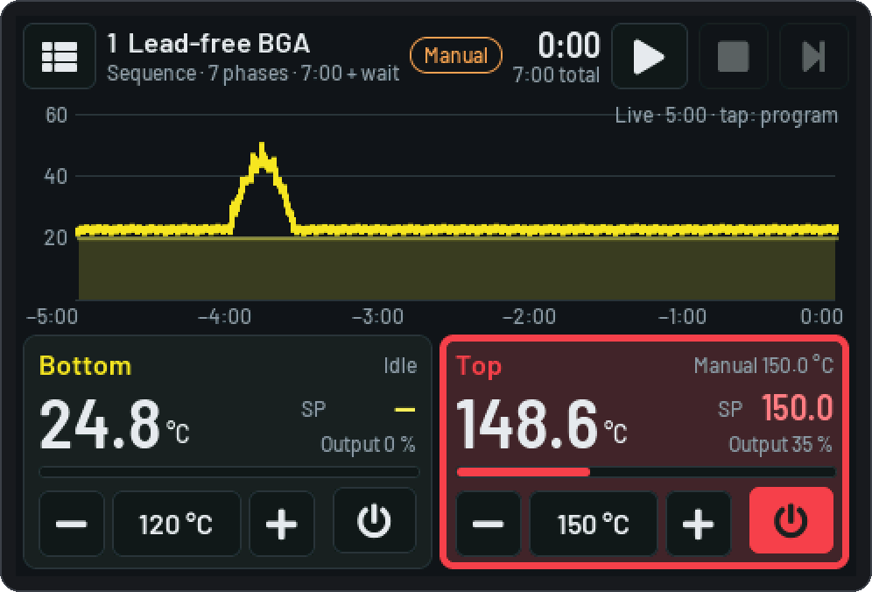
docs/wiki/img/touch/01-idle-dark.png
