justr0st/TempCtl-Duo/docs/wiki/img/touch/02-picker-dark.png

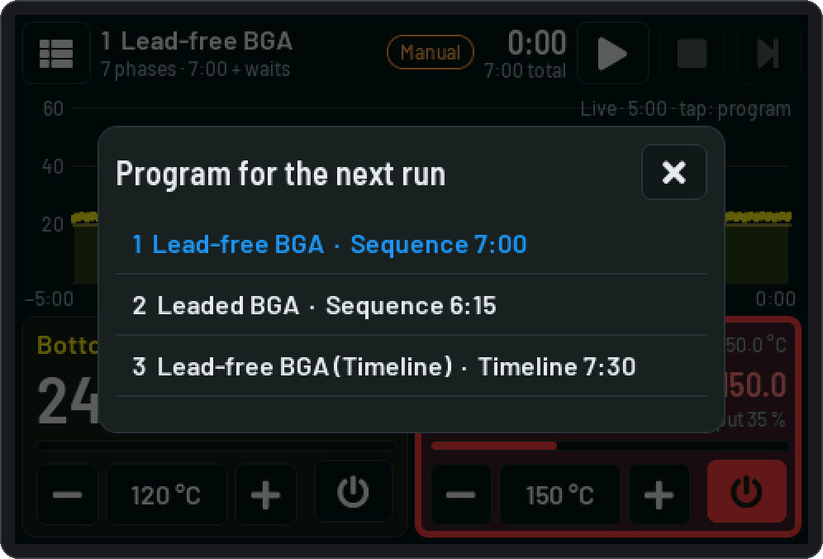
docs/wiki/img/touch/02-picker-dark.png
