justr0st/TempCtl-Duo/docs/wiki/img/touch/03-running-dark.png

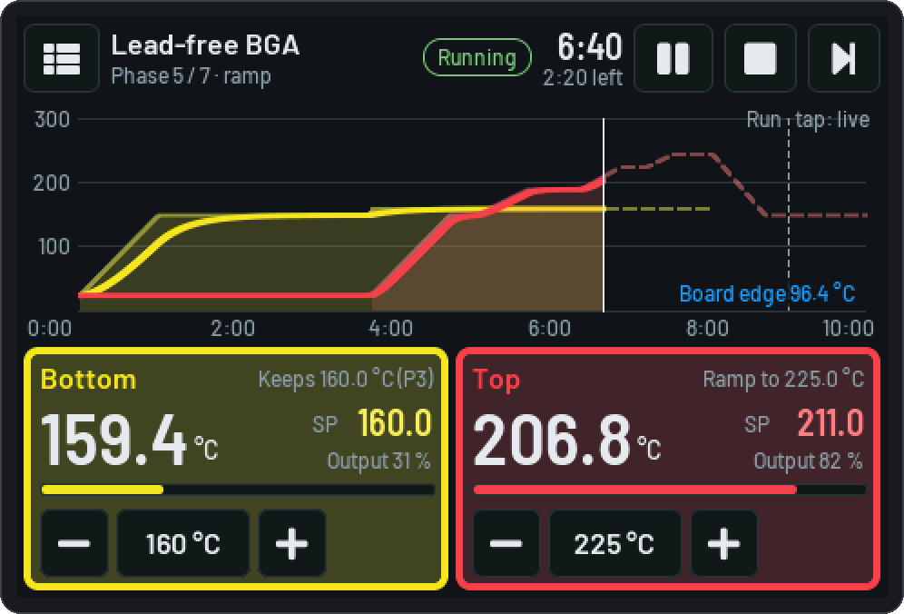
docs/wiki/img/touch/03-running-dark.png
