justr0st/TempCtl-Duo/docs/wiki/img/touch/07-live-dark.png

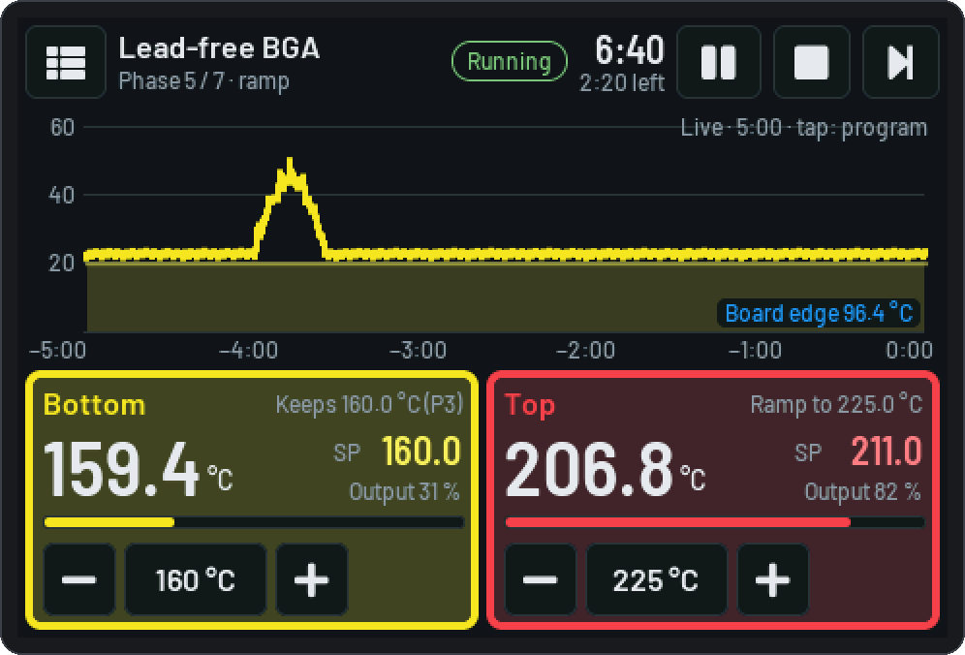
docs/wiki/img/touch/07-live-dark.png
