justr0st/TempCtl-Duo/docs/wiki/img/touch/07-live-light.png

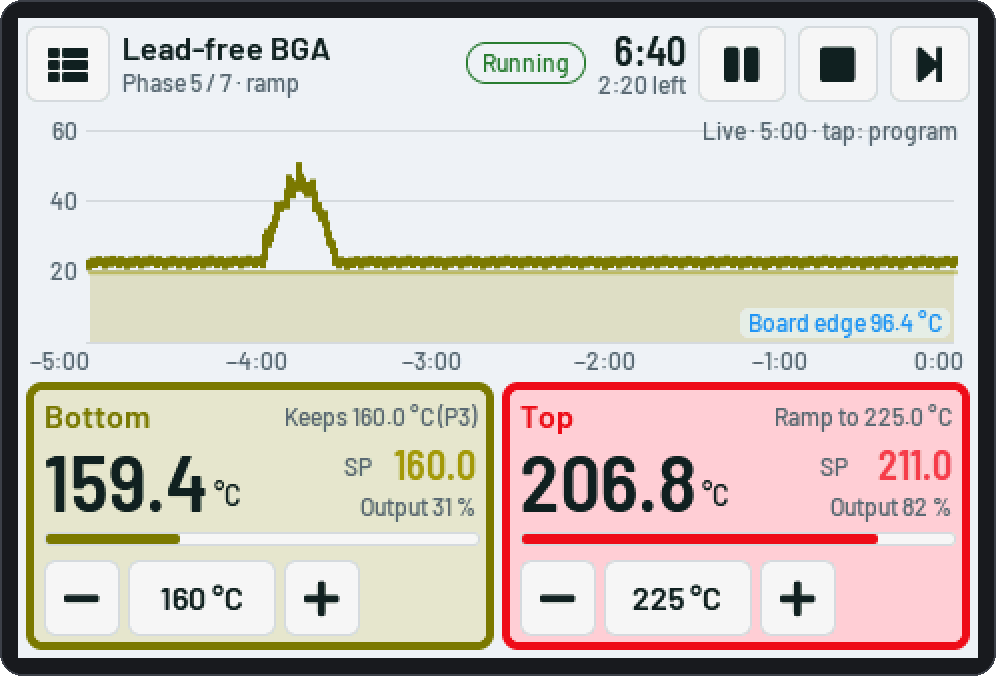
docs/wiki/img/touch/07-live-light.png
