justr0st/TempCtl-Duo/docs/wiki/img/touch/09-interrupted-dark.png

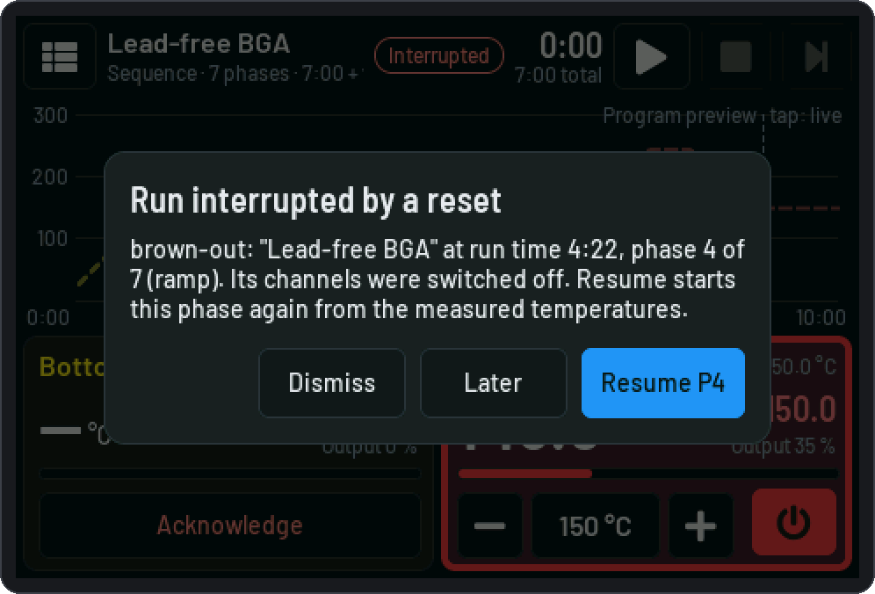
docs/wiki/img/touch/09-interrupted-dark.png
