justr0st/TempCtl-Duo/docs/wiki/img/touch/10-fault-dark.png

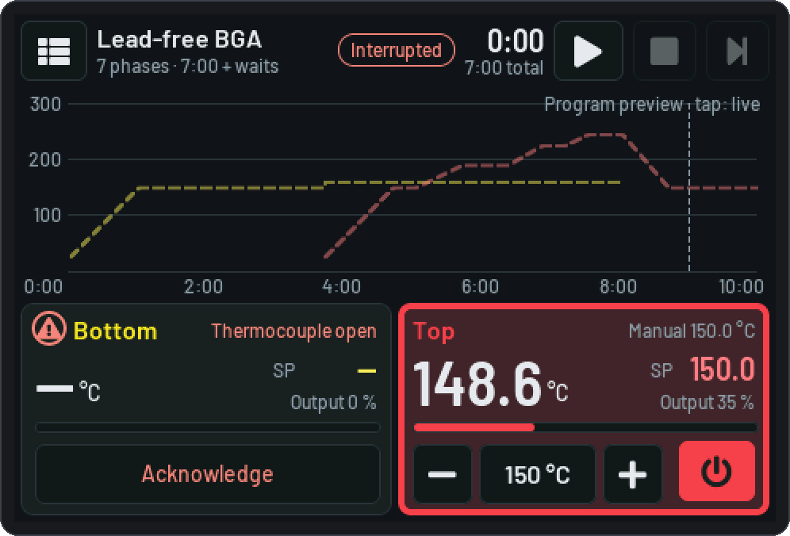
docs/wiki/img/touch/10-fault-dark.png
