justr0st/TempCtl-Duo/docs/wiki/img/touch/11-menu-dark.png

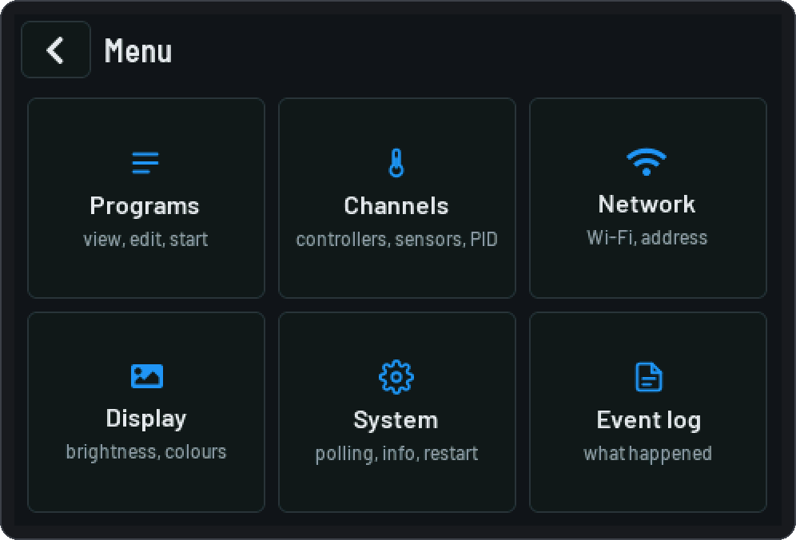
docs/wiki/img/touch/11-menu-dark.png
