justr0st/TempCtl-Duo/docs/wiki/img/touch/12b-accent-picker-dark.png

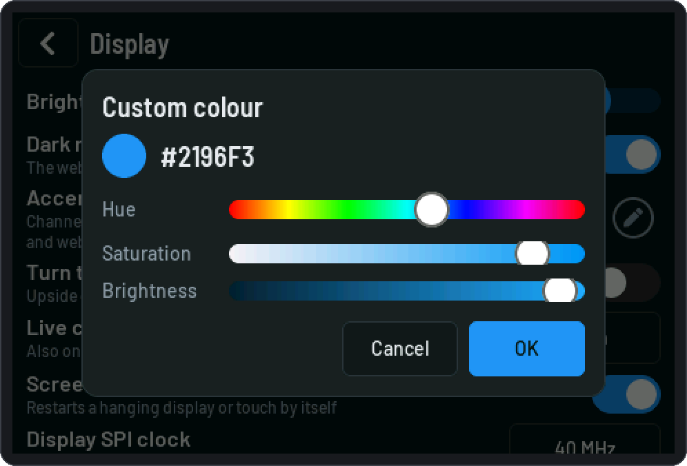
docs/wiki/img/touch/12b-accent-picker-dark.png
