justr0st/TempCtl-Duo/docs/wiki/img/touch/12e-display-spi-light.png

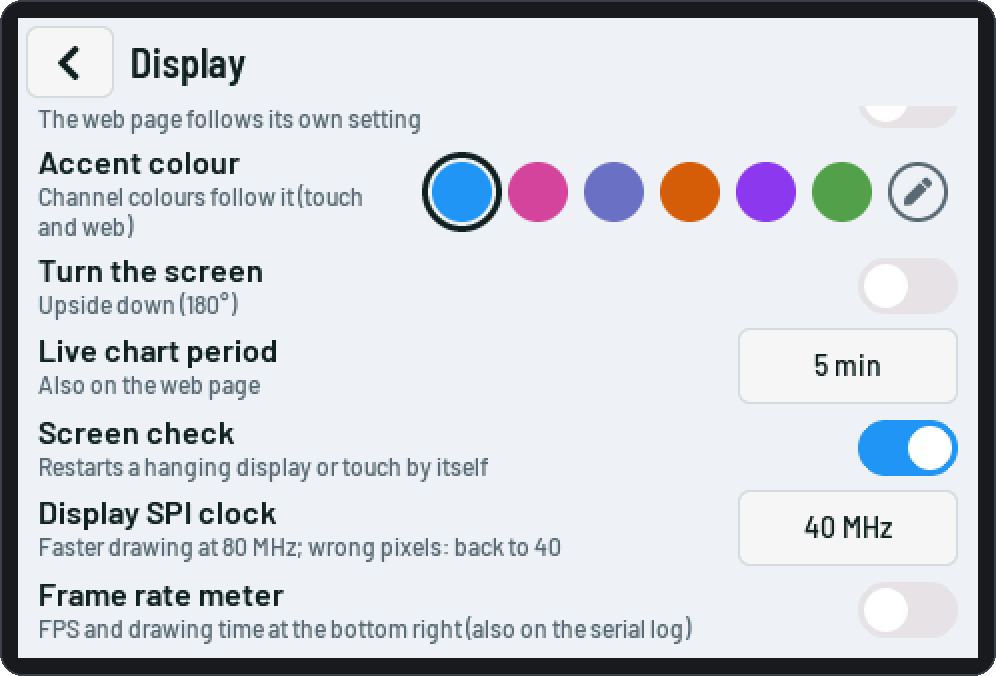
docs/wiki/img/touch/12e-display-spi-light.png
