justr0st/TempCtl-Duo/docs/wiki/img/touch/13-network-dark.png

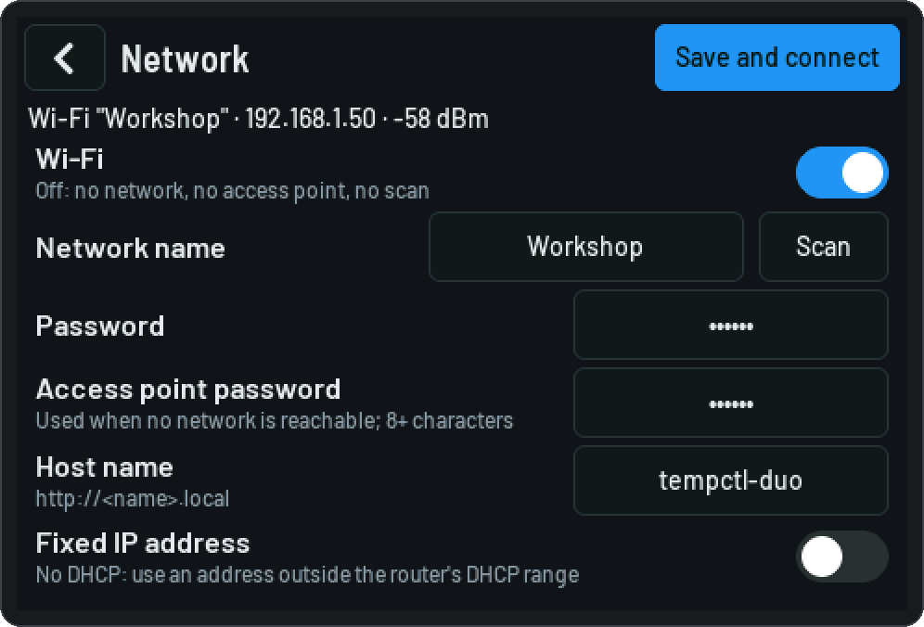
docs/wiki/img/touch/13-network-dark.png
