justr0st/TempCtl-Duo/docs/wiki/img/touch/14b-tz-regions-dark.png

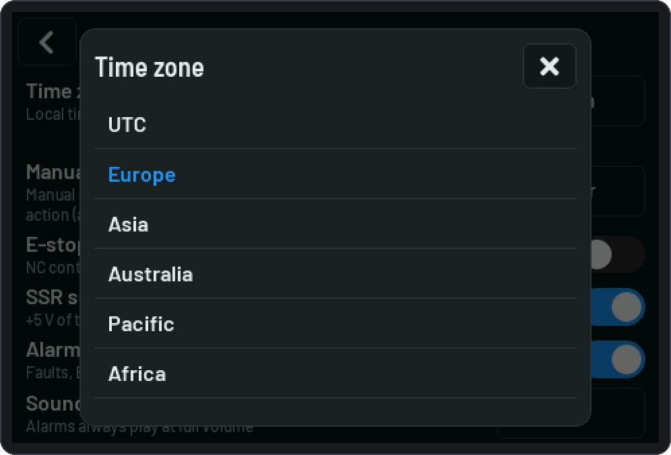
docs/wiki/img/touch/14b-tz-regions-dark.png
