justr0st/TempCtl-Duo/docs/wiki/img/touch/14d-system-safety-dark.png

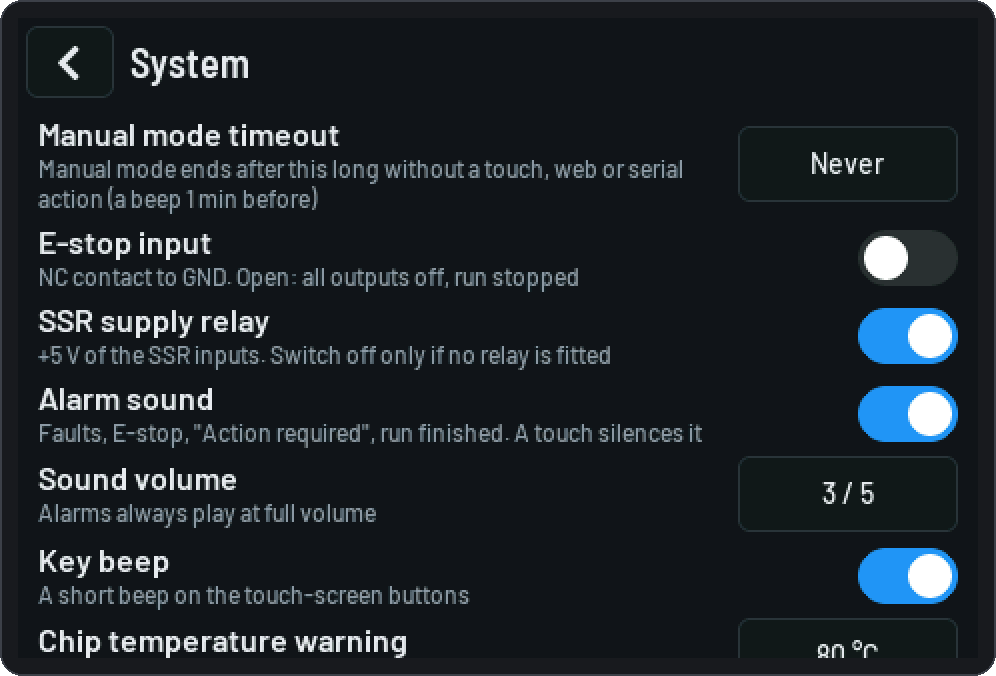
docs/wiki/img/touch/14d-system-safety-dark.png
