justr0st/TempCtl-Duo/docs/wiki/img/touch/14e0-system-backup-dark.png

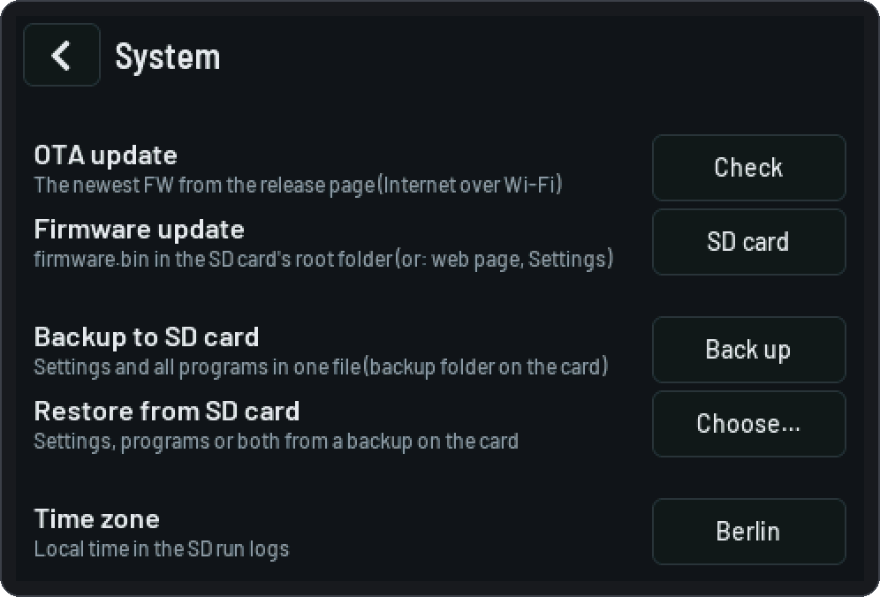
docs/wiki/img/touch/14e0-system-backup-dark.png
