justr0st/TempCtl-Duo/docs/wiki/img/touch/14f-restore-list-dark.png

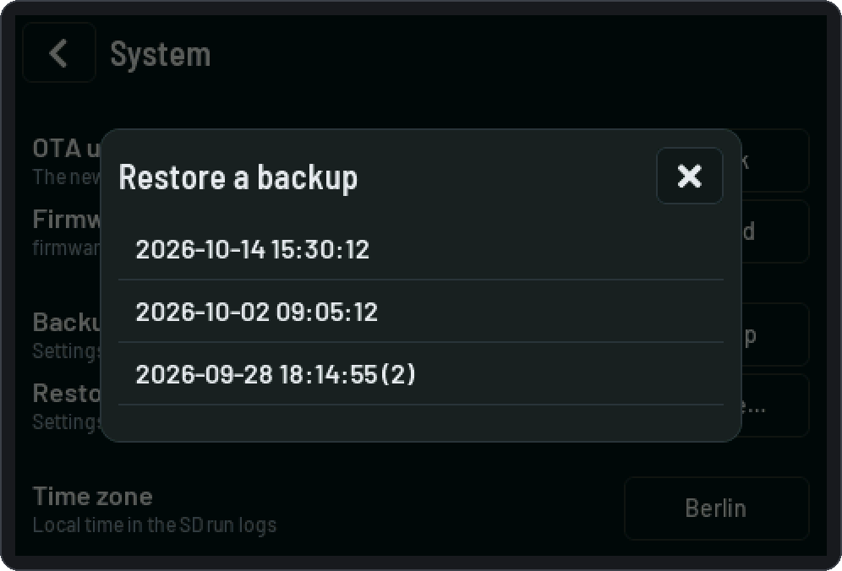
docs/wiki/img/touch/14f-restore-list-dark.png
