justr0st/TempCtl-Duo/docs/wiki/img/touch/14j-online-update-dark.png

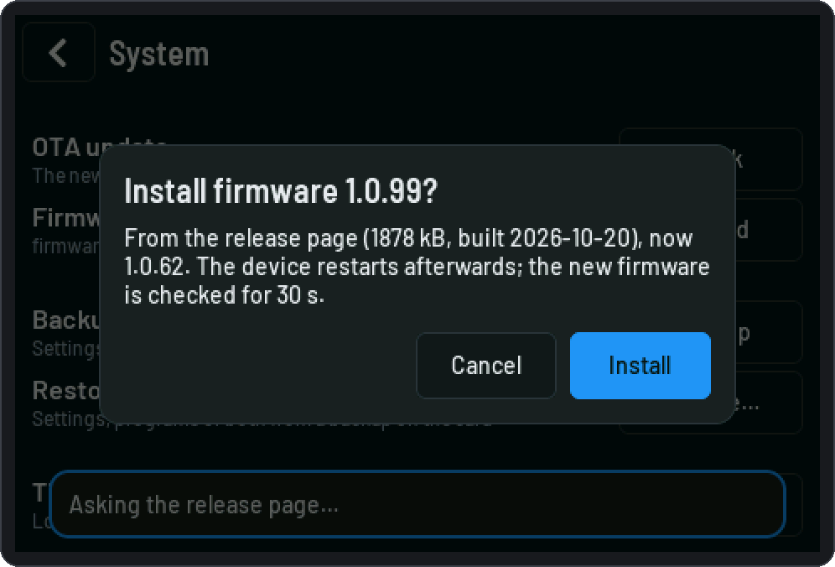
docs/wiki/img/touch/14j-online-update-dark.png
