justr0st/TempCtl-Duo/docs/wiki/img/touch/14k-system-sound-pins-dark.png

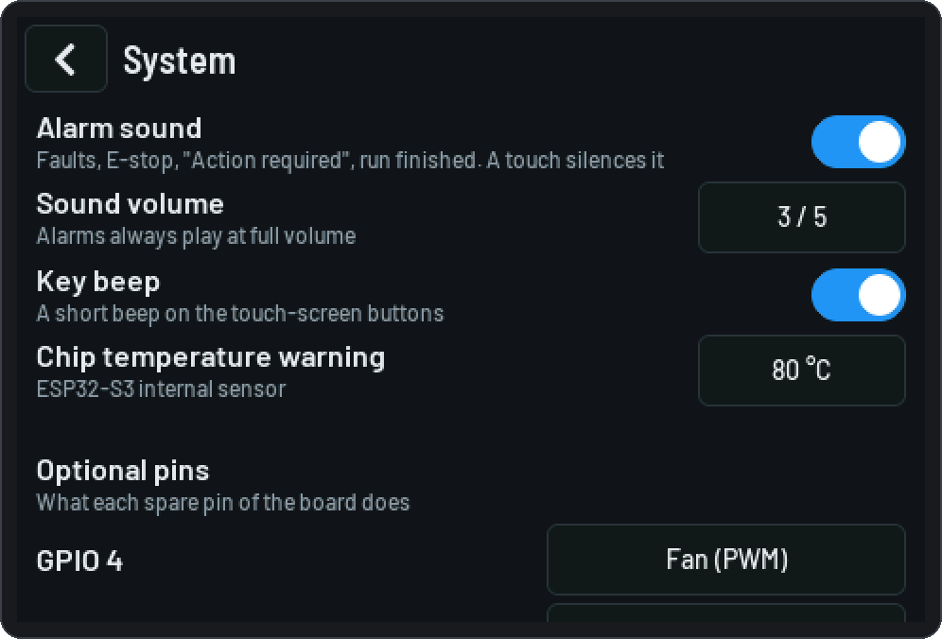
docs/wiki/img/touch/14k-system-sound-pins-dark.png
