justr0st/TempCtl-Duo/docs/wiki/img/touch/15-log-dark.png

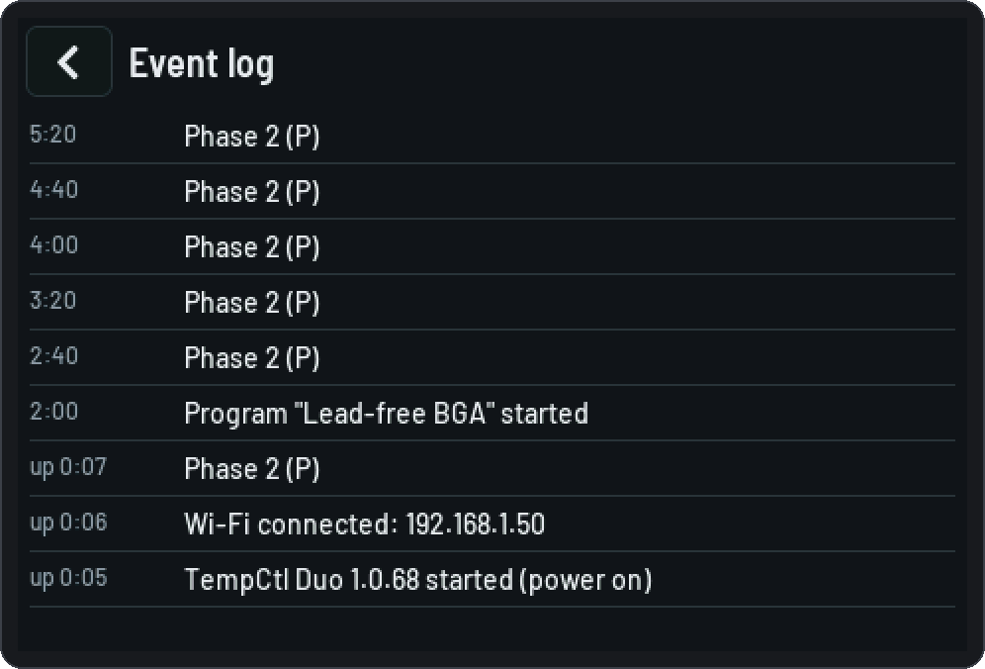
docs/wiki/img/touch/15-log-dark.png
