justr0st/TempCtl-Duo/docs/wiki/img/touch/16-keyboard-dark.png

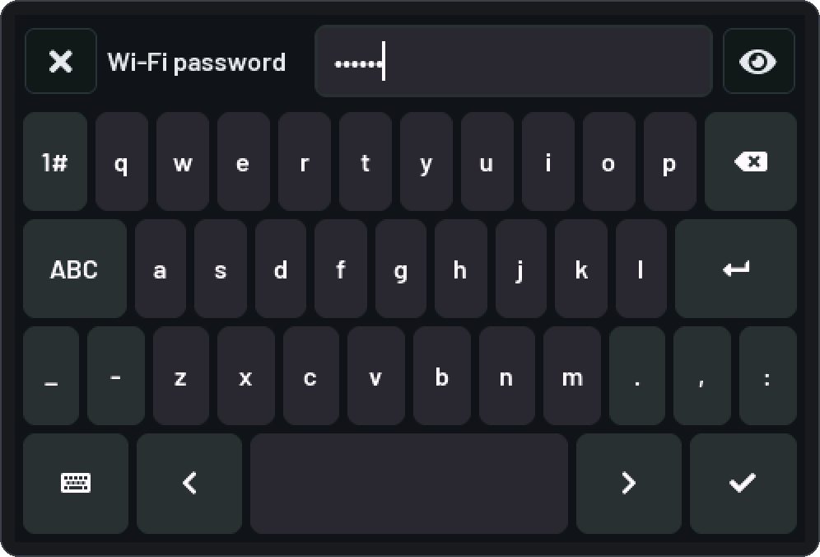
docs/wiki/img/touch/16-keyboard-dark.png
