justr0st/TempCtl-Duo/docs/wiki/img/touch/20-edit-seq-dark.png

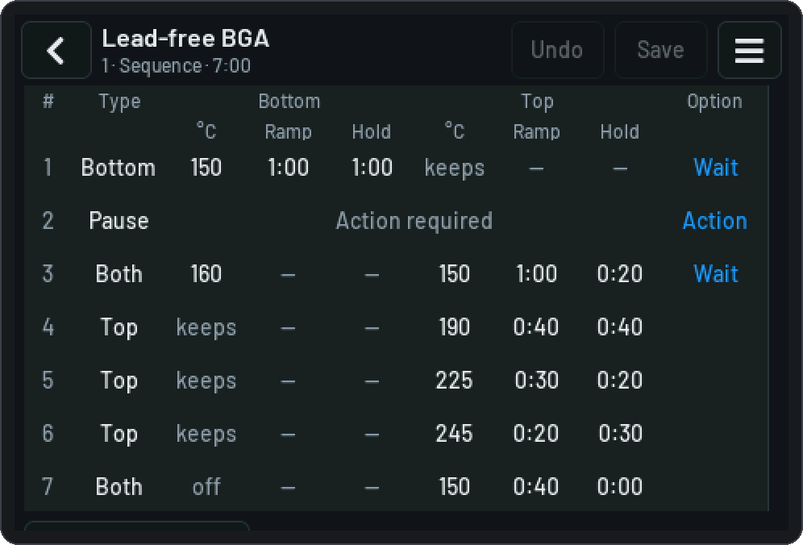
docs/wiki/img/touch/20-edit-seq-dark.png
