justr0st/TempCtl-Duo/docs/wiki/img/touch/21-rowmenu-dark.png

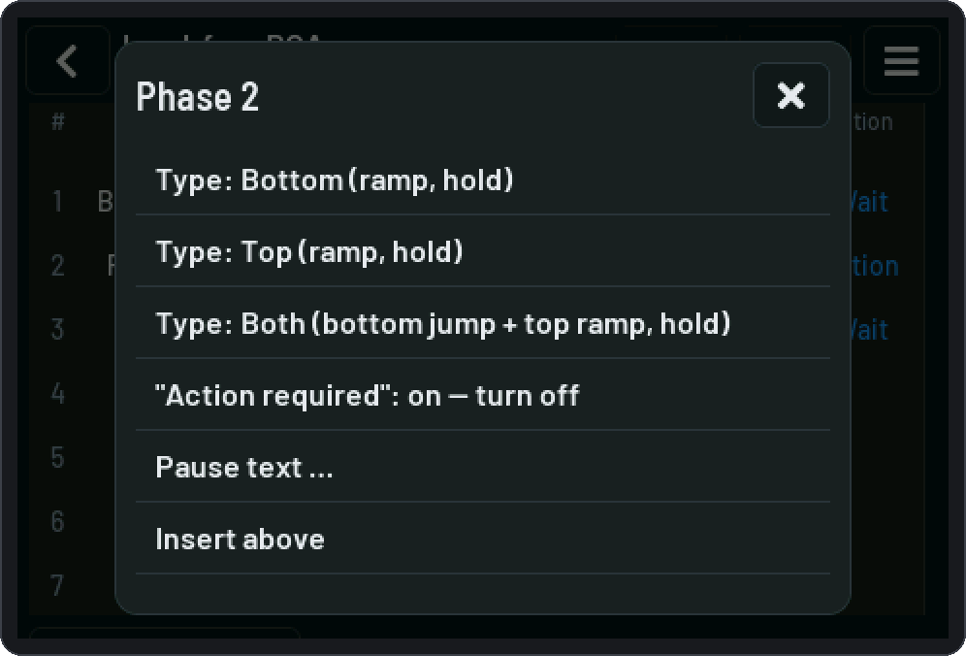
docs/wiki/img/touch/21-rowmenu-dark.png
