justr0st/TempCtl-Duo/docs/wiki/img/touch/22-edit-tl-dark.png

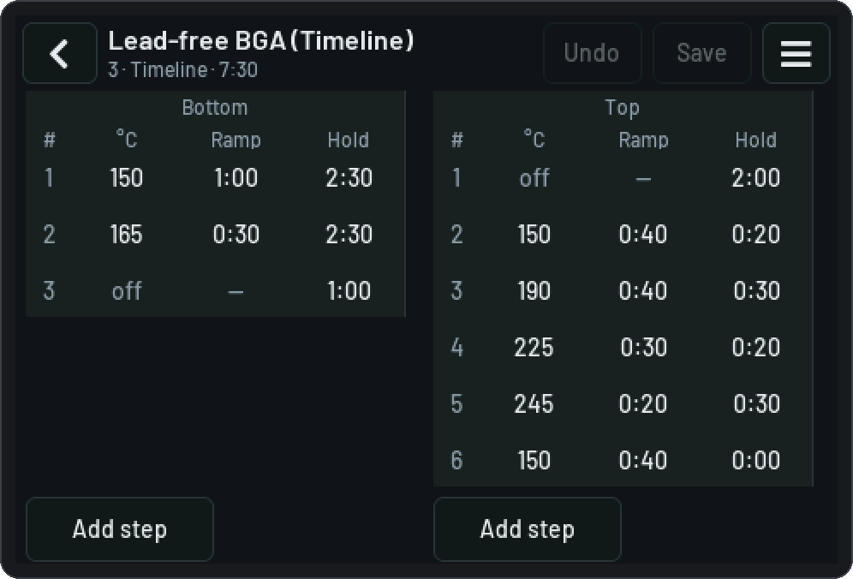
docs/wiki/img/touch/22-edit-tl-dark.png
