justr0st/TempCtl-Duo/docs/wiki/img/touch/26-chan-bus-dark.png

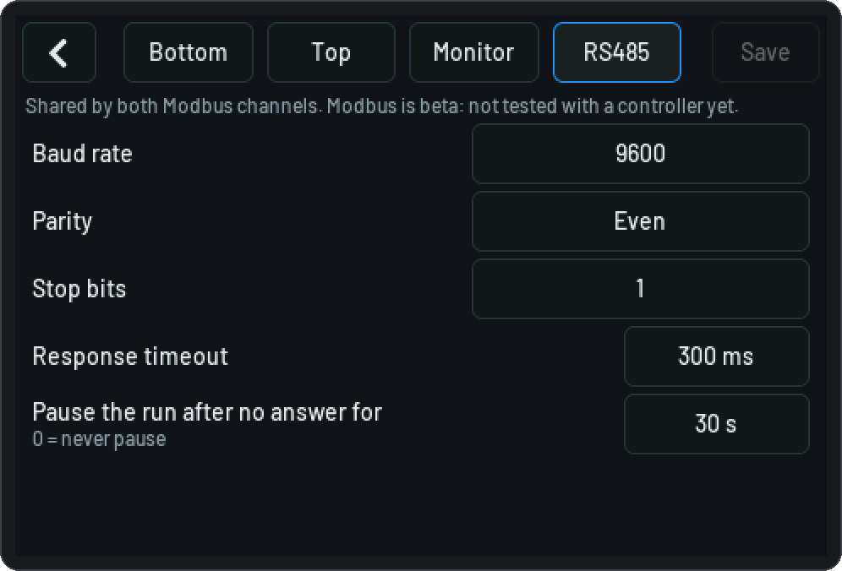
docs/wiki/img/touch/26-chan-bus-dark.png
