justr0st/TempCtl-Duo/docs/wiki/img/touch/26-chan-bus-light.png

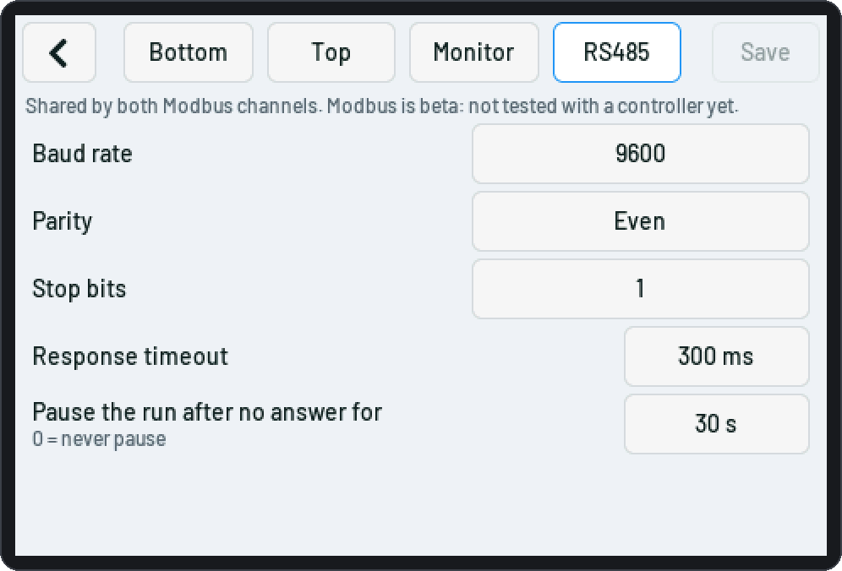
docs/wiki/img/touch/26-chan-bus-light.png
