justr0st/TempCtl-Duo/docs/wiki/img/touch/27-chan-pid-dark.png

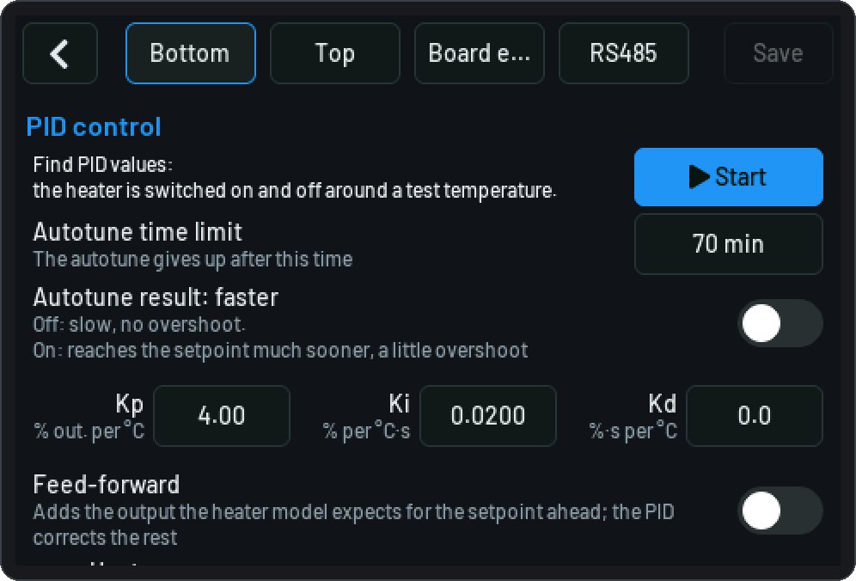
docs/wiki/img/touch/27-chan-pid-dark.png
