justr0st/TempCtl-Duo/docs/wiki/img/touch/28-chan-runaway-dark.png

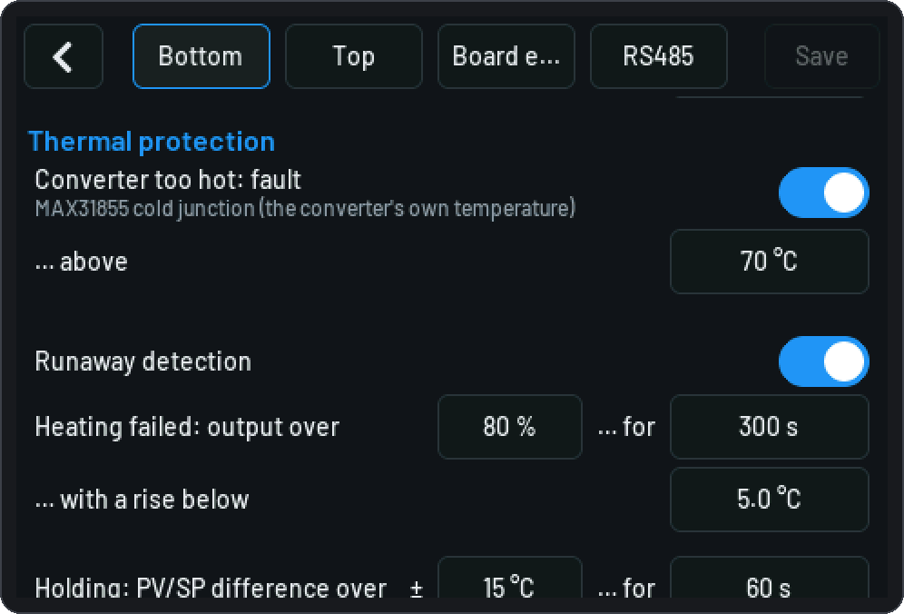
docs/wiki/img/touch/28-chan-runaway-dark.png
