justr0st/TempCtl-Duo/docs/wiki/img/touch/31b-run-report-dark.png

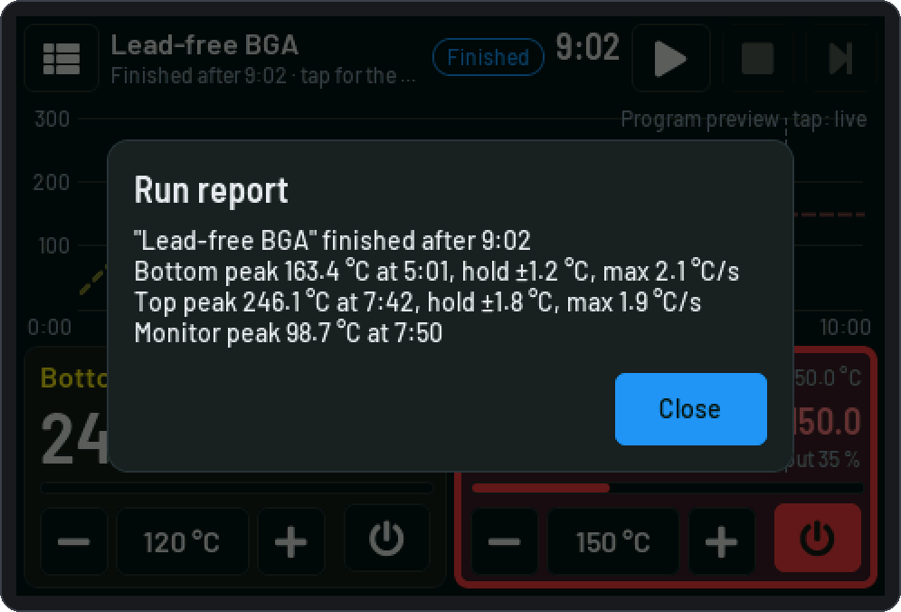
docs/wiki/img/touch/31b-run-report-dark.png
