justr0st/TempCtl-Duo/docs/wiki/img/touch/cyd-01-idle-light.png

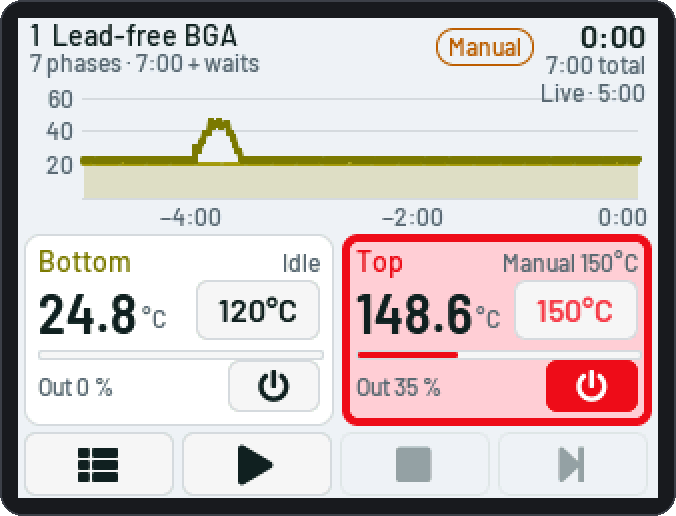
docs/wiki/img/touch/cyd-01-idle-light.png
