justr0st/TempCtl-Duo/docs/wiki/img/touch/cyd-02-picker-light.png

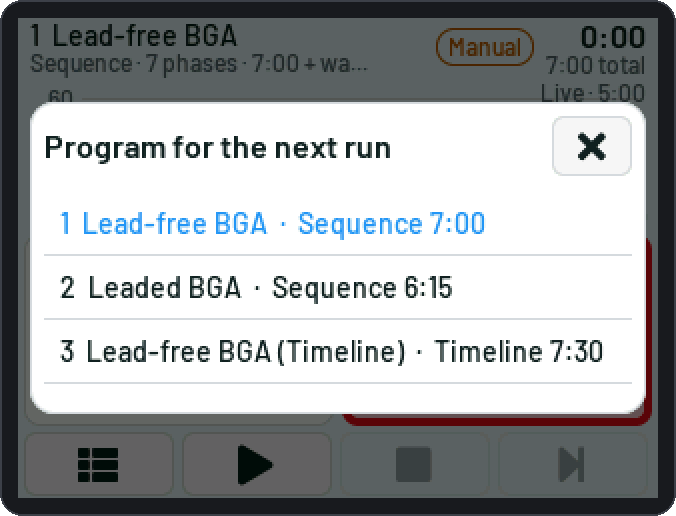
docs/wiki/img/touch/cyd-02-picker-light.png
