justr0st/TempCtl-Duo/docs/wiki/img/touch/cyd-03-running-dark.png

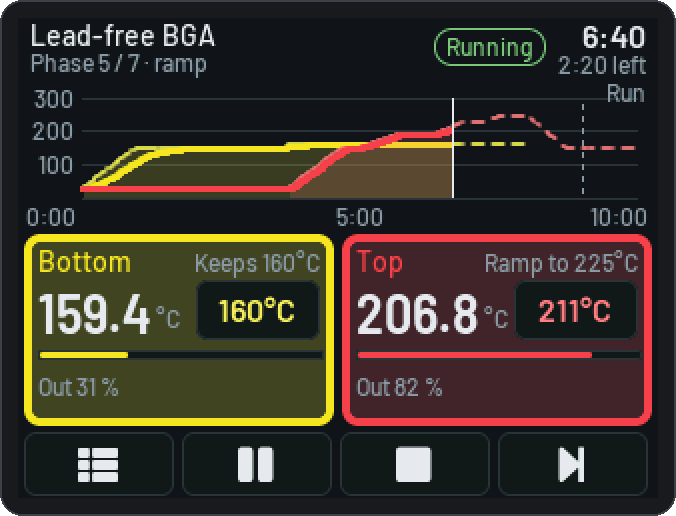
docs/wiki/img/touch/cyd-03-running-dark.png
