justr0st/TempCtl-Duo/docs/wiki/img/touch/cyd-04-stepper-light.png

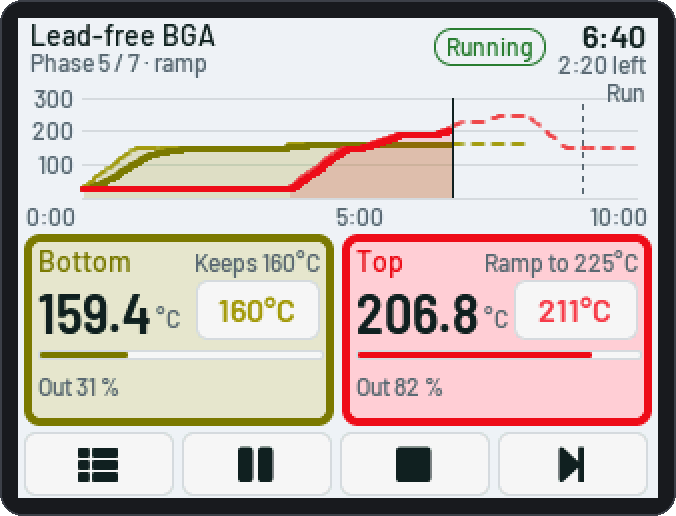
docs/wiki/img/touch/cyd-04-stepper-light.png
