justr0st/TempCtl-Duo/docs/wiki/img/touch/cyd-05-numpad-dark.png

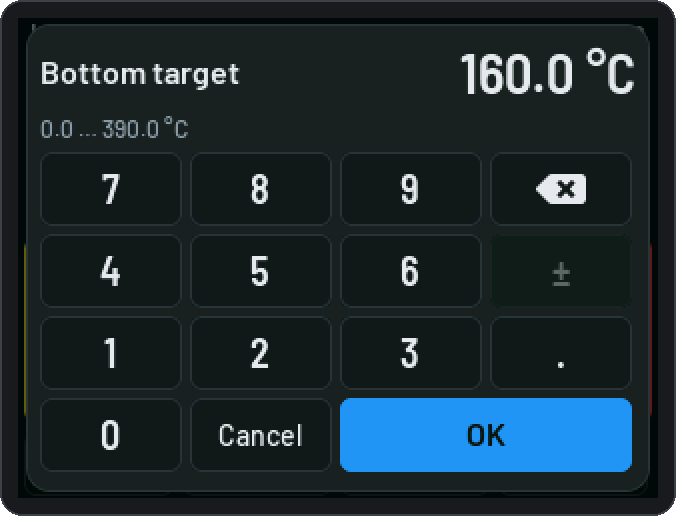
docs/wiki/img/touch/cyd-05-numpad-dark.png
