justr0st/TempCtl-Duo/docs/wiki/img/touch/cyd-06-action-dark.png

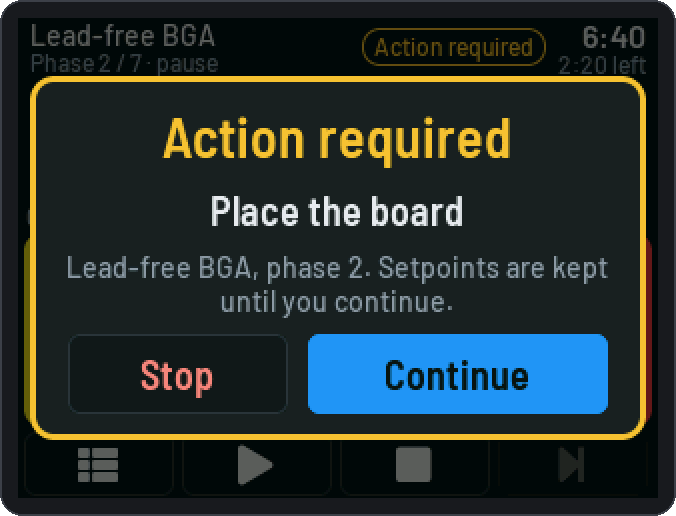
docs/wiki/img/touch/cyd-06-action-dark.png
