justr0st/TempCtl-Duo/docs/wiki/img/touch/cyd-09-interrupted-dark.png

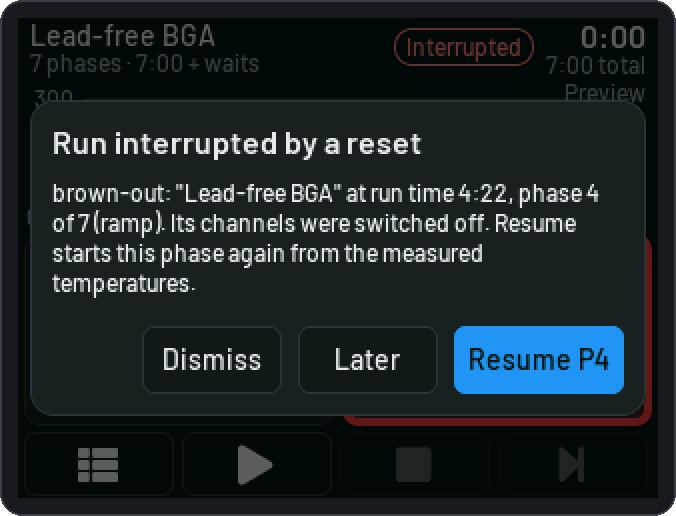
docs/wiki/img/touch/cyd-09-interrupted-dark.png
