justr0st/TempCtl-Duo/docs/wiki/img/touch/cyd-09-interrupted-light.png

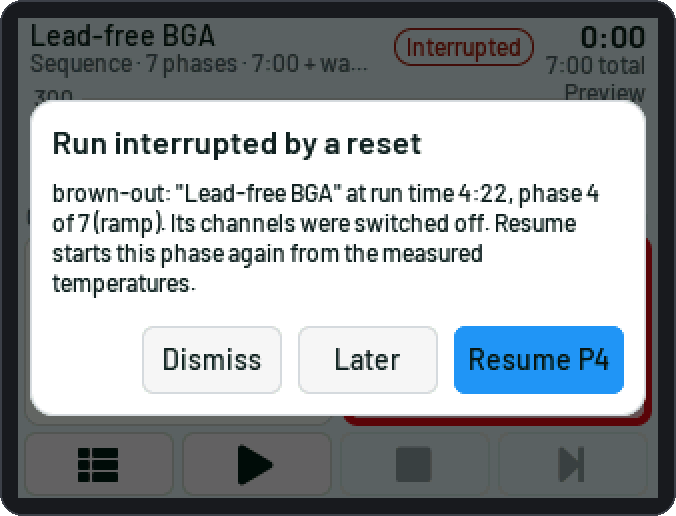
docs/wiki/img/touch/cyd-09-interrupted-light.png
