justr0st/TempCtl-Duo/docs/wiki/img/touch/cyd-10-fault-dark.png

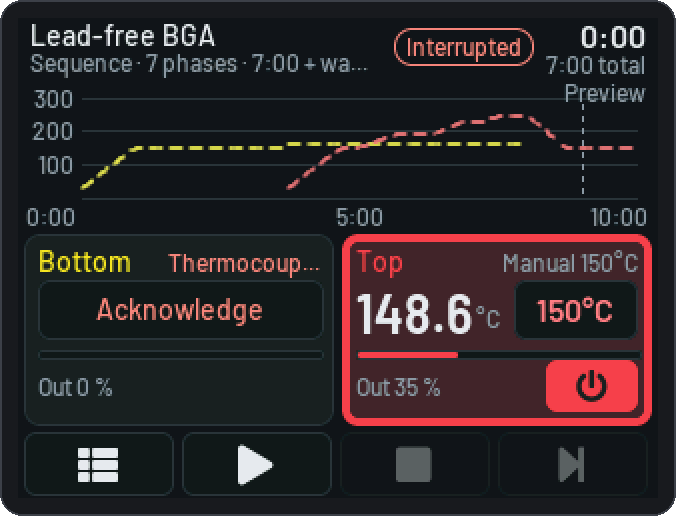
docs/wiki/img/touch/cyd-10-fault-dark.png
