justr0st/TempCtl-Duo/docs/wiki/img/touch/cyd-10-fault-light.png

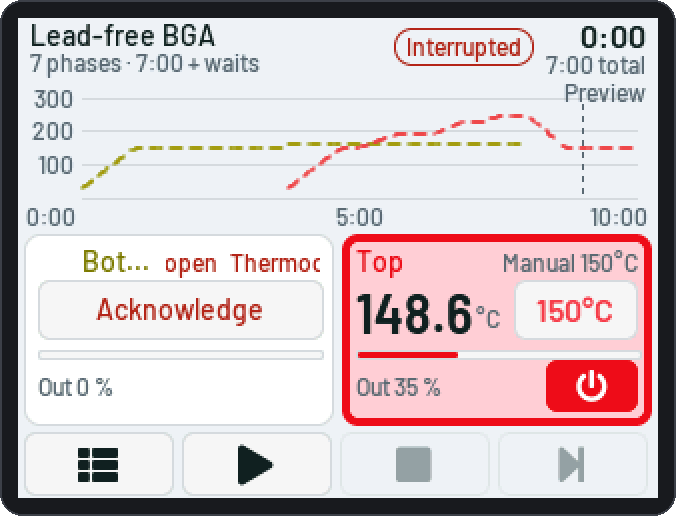
docs/wiki/img/touch/cyd-10-fault-light.png
