justr0st/TempCtl-Duo/docs/wiki/img/touch/cyd-11-menu-dark.png

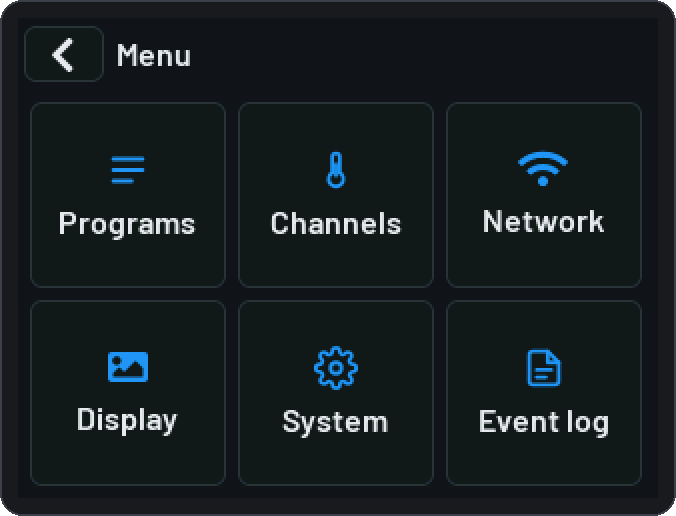
docs/wiki/img/touch/cyd-11-menu-dark.png
