justr0st/TempCtl-Duo/docs/wiki/img/touch/cyd-12-display-dark.png

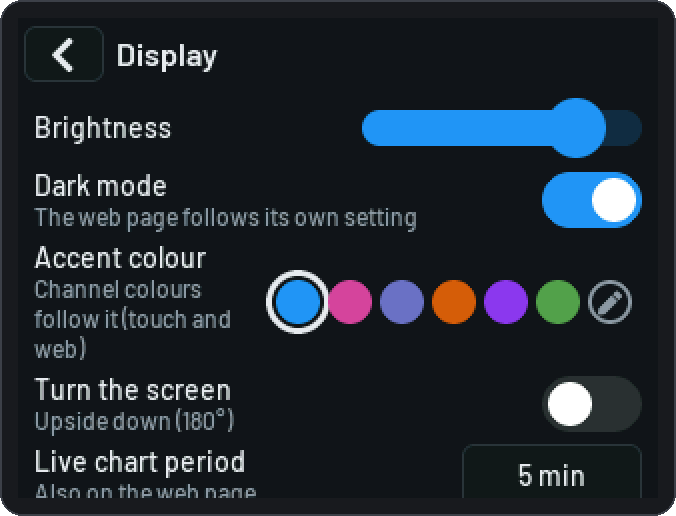
docs/wiki/img/touch/cyd-12-display-dark.png
