justr0st/TempCtl-Duo/docs/wiki/img/touch/cyd-12-display-light.png

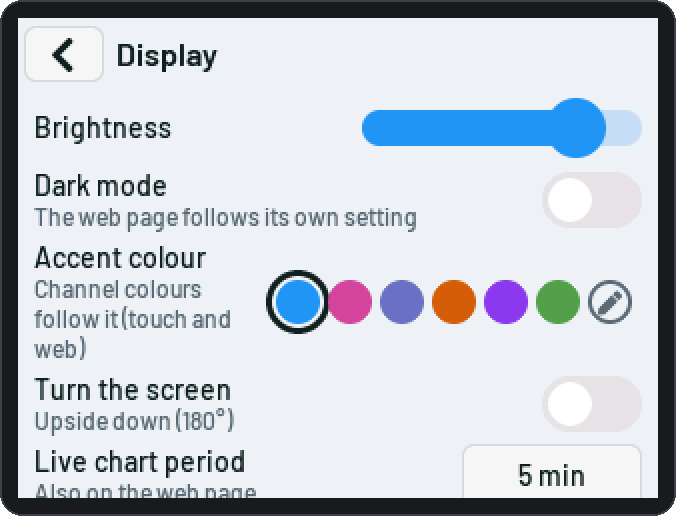
docs/wiki/img/touch/cyd-12-display-light.png
