justr0st/TempCtl-Duo/docs/wiki/img/touch/cyd-12b-accent-picker-dark.png

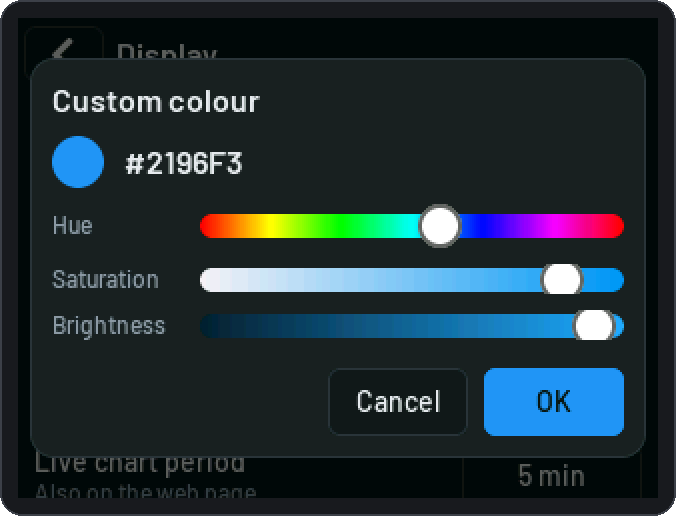
docs/wiki/img/touch/cyd-12b-accent-picker-dark.png
