justr0st/TempCtl-Duo/docs/wiki/img/touch/cyd-12b-accent-picker-light.png

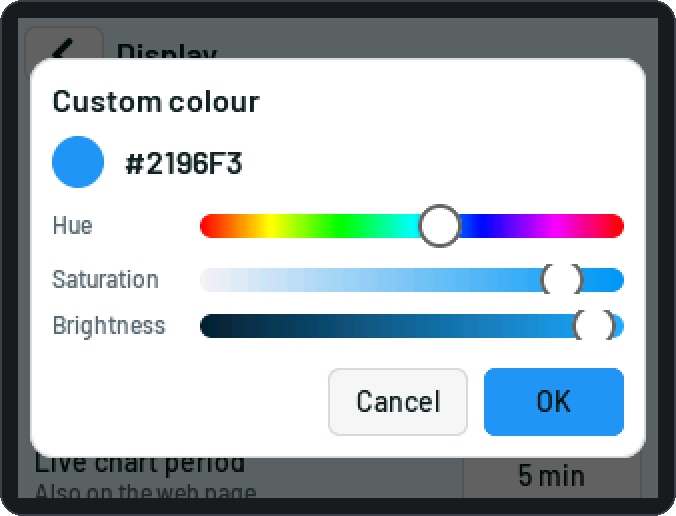
docs/wiki/img/touch/cyd-12b-accent-picker-light.png
