justr0st/TempCtl-Duo/docs/wiki/img/touch/cyd-13-network-dark.png

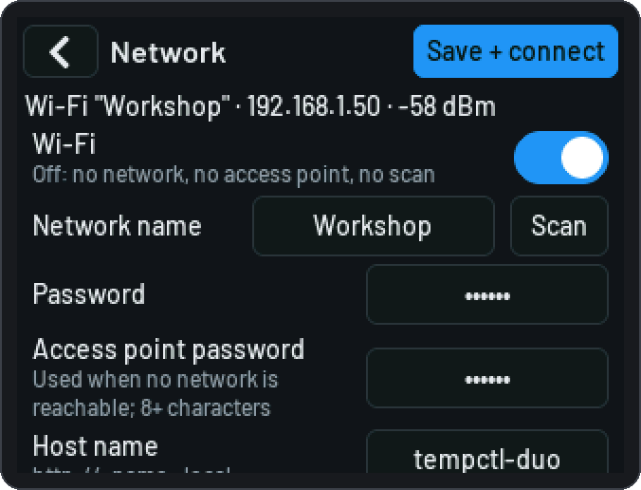
docs/wiki/img/touch/cyd-13-network-dark.png
