justr0st/TempCtl-Duo/docs/wiki/img/touch/cyd-13-network-light.png

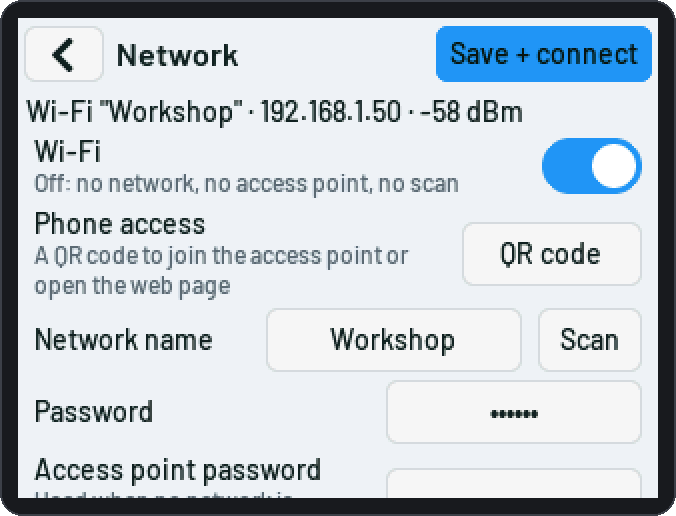
docs/wiki/img/touch/cyd-13-network-light.png
