justr0st/TempCtl-Duo/docs/wiki/img/touch/cyd-13b-qr-station-dark.png

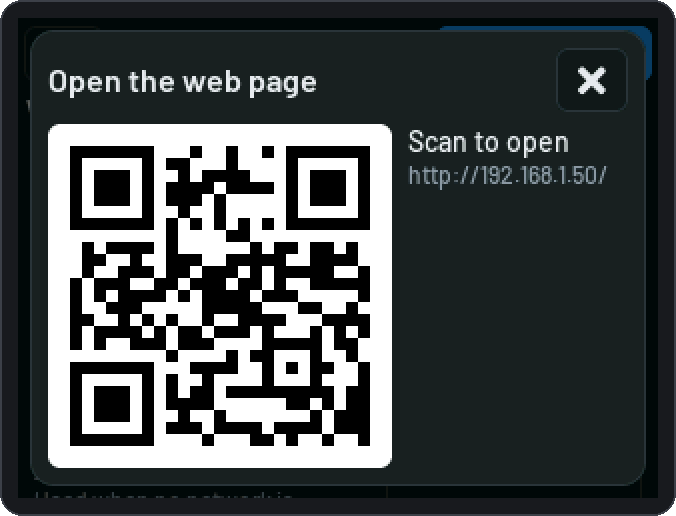
docs/wiki/img/touch/cyd-13b-qr-station-dark.png
