justr0st/TempCtl-Duo/docs/wiki/img/touch/cyd-13c-qr-ap-light.png

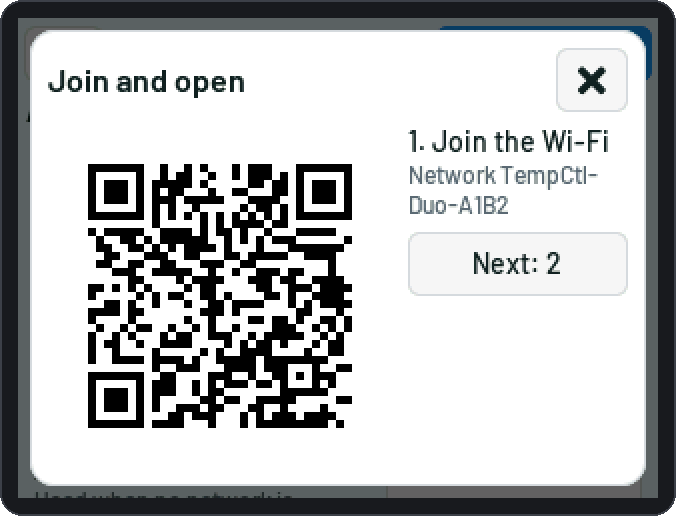
docs/wiki/img/touch/cyd-13c-qr-ap-light.png
