justr0st/TempCtl-Duo/docs/wiki/img/touch/cyd-14-system-dark.png

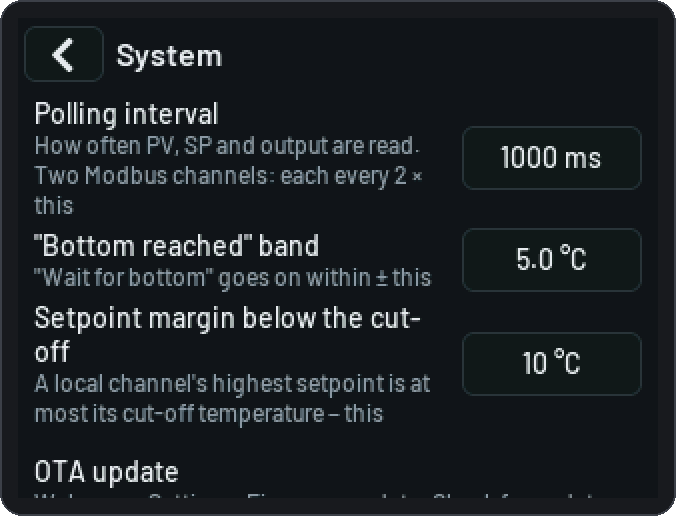
docs/wiki/img/touch/cyd-14-system-dark.png
