justr0st/TempCtl-Duo/docs/wiki/img/touch/cyd-14-system-light.png

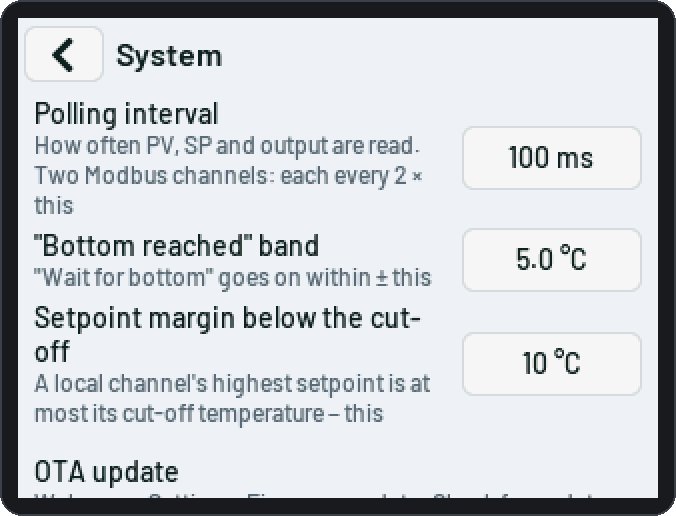
docs/wiki/img/touch/cyd-14-system-light.png
