justr0st/TempCtl-Duo/docs/wiki/img/touch/cyd-14d-system-safety-dark.png

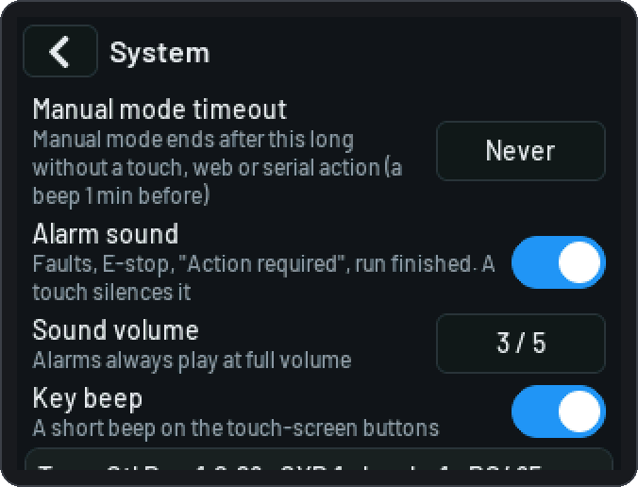
docs/wiki/img/touch/cyd-14d-system-safety-dark.png
