justr0st/TempCtl-Duo/docs/wiki/img/touch/cyd-14d-system-safety-light.png

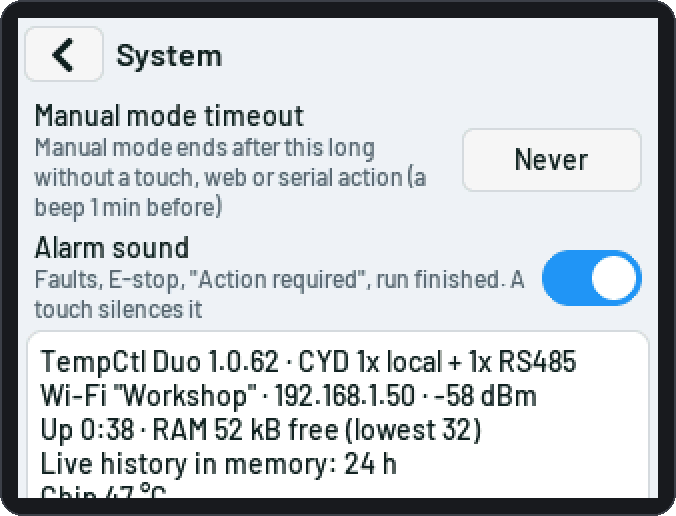
docs/wiki/img/touch/cyd-14d-system-safety-light.png
