justr0st/TempCtl-Duo/docs/wiki/img/touch/cyd-14e0-system-online-dark.png

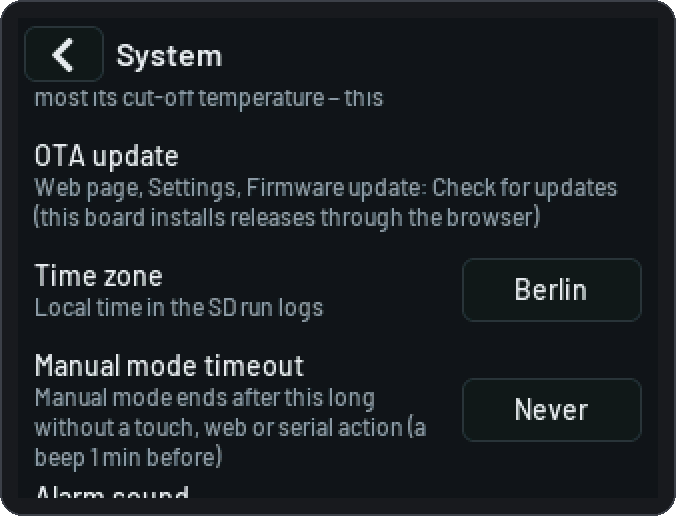
docs/wiki/img/touch/cyd-14e0-system-online-dark.png
