justr0st/TempCtl-Duo/docs/wiki/img/touch/cyd-15-log-light.png

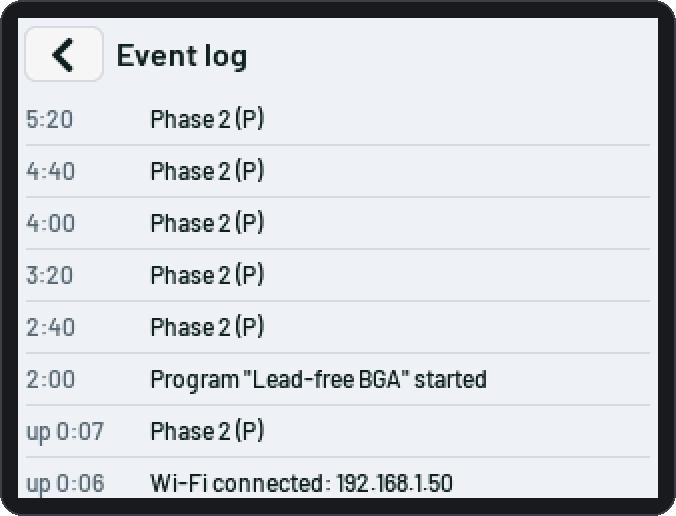
docs/wiki/img/touch/cyd-15-log-light.png
