justr0st/TempCtl-Duo/docs/wiki/img/touch/cyd-16-keyboard-light.png

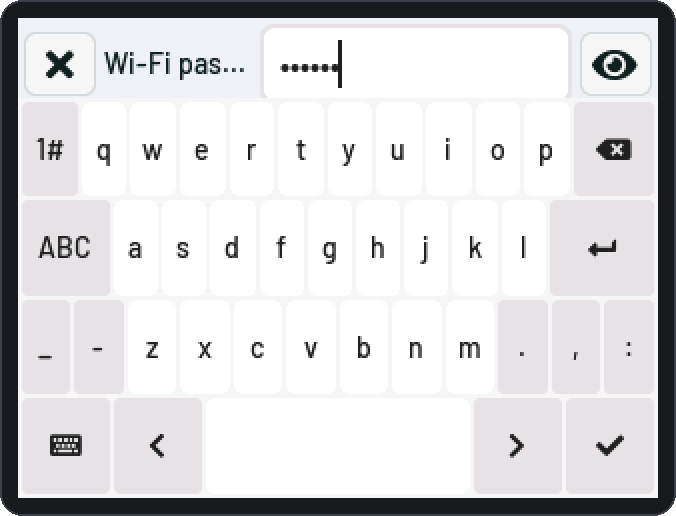
docs/wiki/img/touch/cyd-16-keyboard-light.png
