justr0st/TempCtl-Duo/docs/wiki/img/touch/cyd-19-programs-dark.png

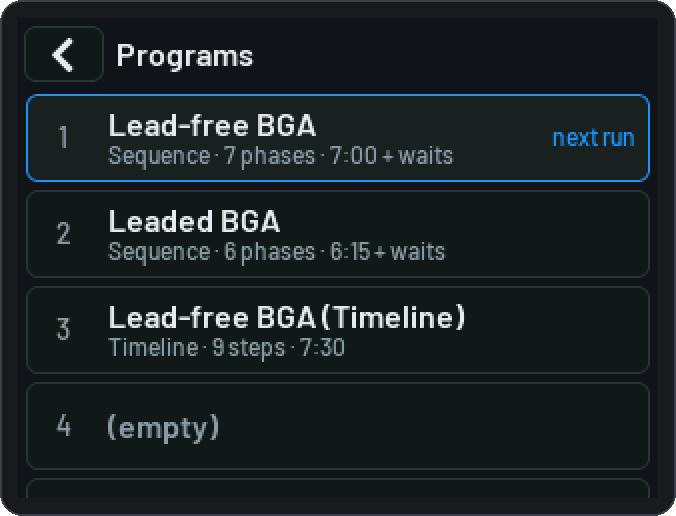
docs/wiki/img/touch/cyd-19-programs-dark.png
