justr0st/TempCtl-Duo/docs/wiki/img/touch/cyd-19-programs-light.png

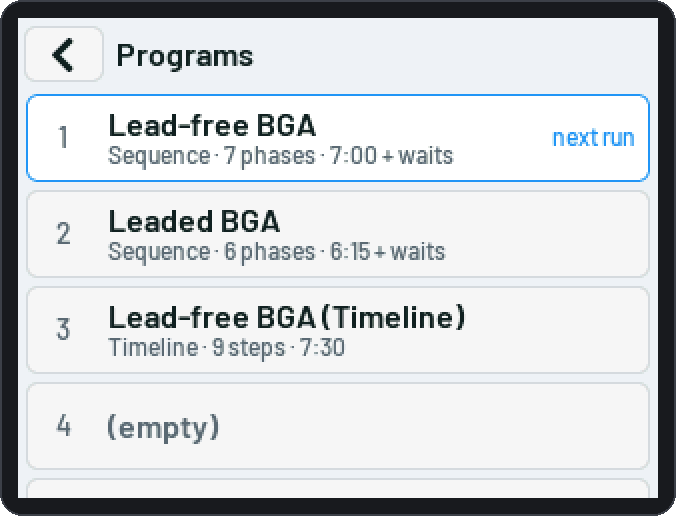
docs/wiki/img/touch/cyd-19-programs-light.png
