justr0st/TempCtl-Duo/docs/wiki/img/touch/cyd-20-edit-seq-dark.png

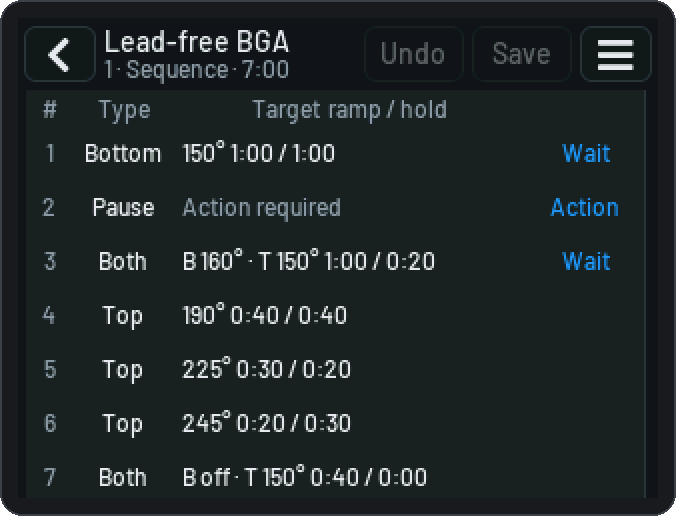
docs/wiki/img/touch/cyd-20-edit-seq-dark.png
