justr0st/TempCtl-Duo/docs/wiki/img/touch/cyd-21-rowmenu-light.png

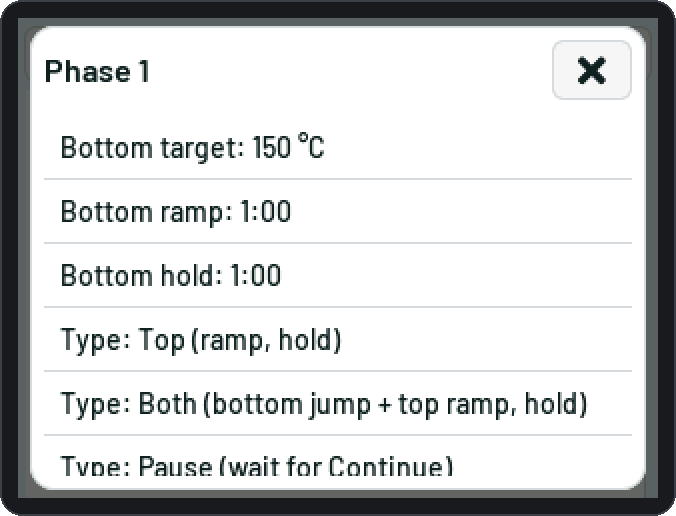
docs/wiki/img/touch/cyd-21-rowmenu-light.png
