justr0st/TempCtl-Duo/docs/wiki/img/touch/cyd-21b-phase-menu-dark.png

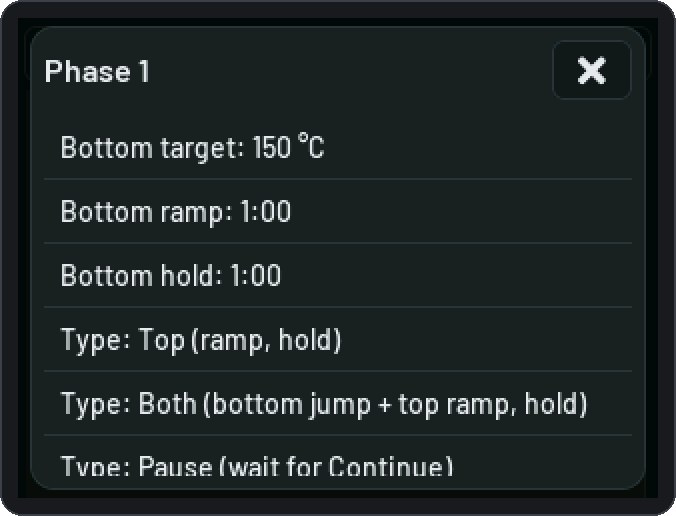
docs/wiki/img/touch/cyd-21b-phase-menu-dark.png
