justr0st/TempCtl-Duo/docs/wiki/img/touch/cyd-22-edit-tl-dark.png

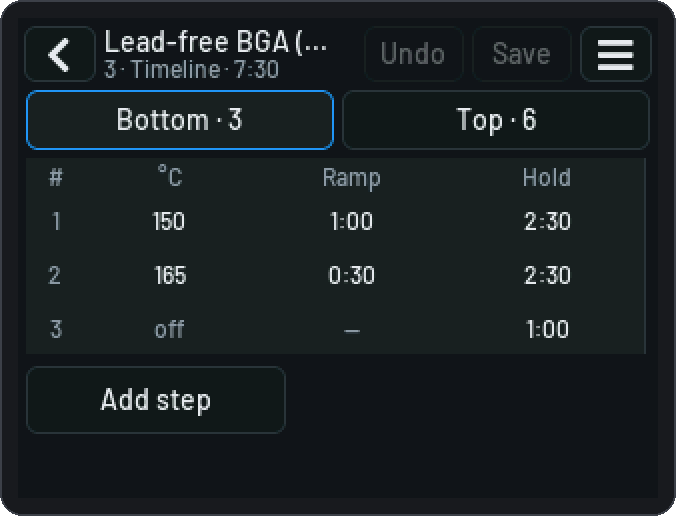
docs/wiki/img/touch/cyd-22-edit-tl-dark.png
