justr0st/TempCtl-Duo/docs/wiki/img/touch/cyd-24-chan-local-dark.png

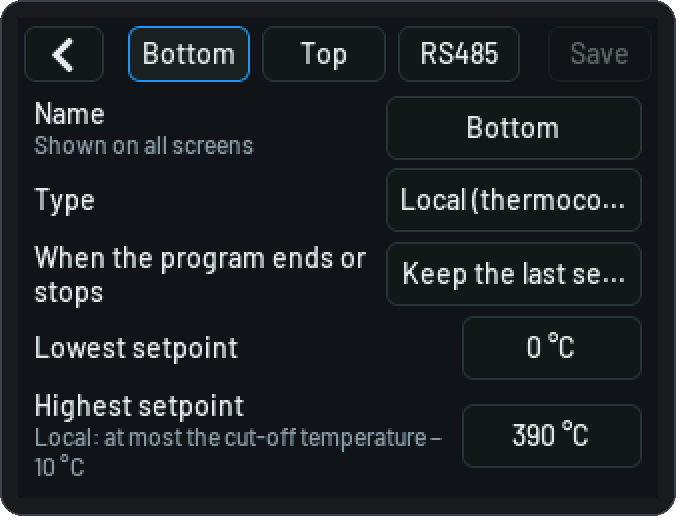
docs/wiki/img/touch/cyd-24-chan-local-dark.png
