justr0st/TempCtl-Duo/docs/wiki/img/touch/cyd-25-chan-modbus-dark.png

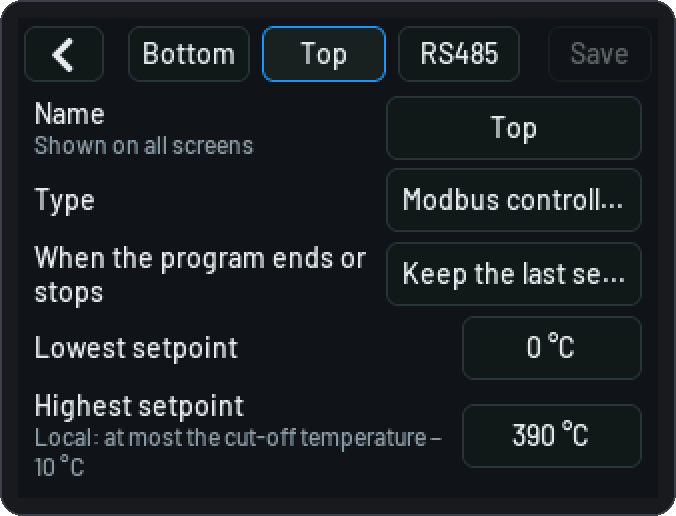
docs/wiki/img/touch/cyd-25-chan-modbus-dark.png
