justr0st/TempCtl-Duo/docs/wiki/img/touch/cyd-26-chan-bus-light.png

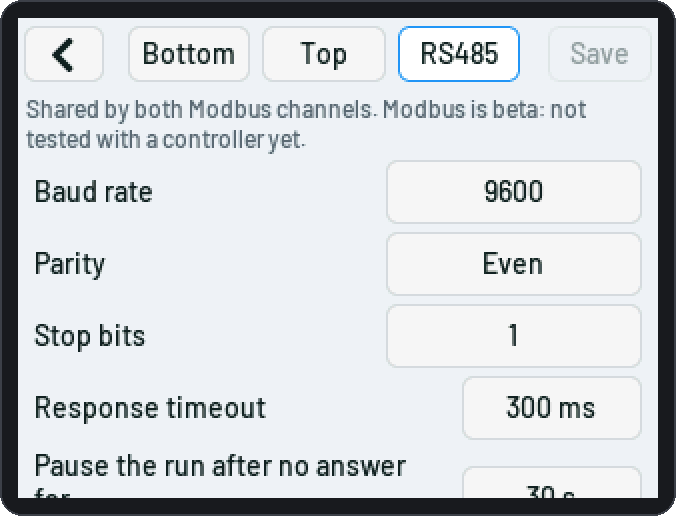
docs/wiki/img/touch/cyd-26-chan-bus-light.png
