justr0st/TempCtl-Duo/docs/wiki/img/touch/cyd-27-chan-pid-light.png

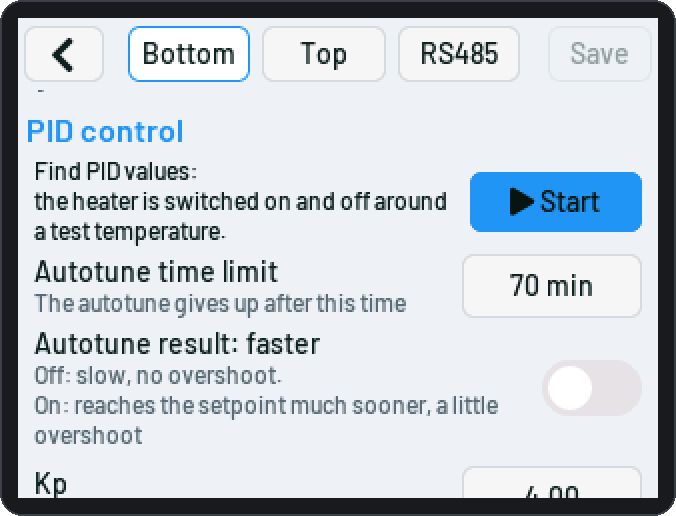
docs/wiki/img/touch/cyd-27-chan-pid-light.png
