justr0st/TempCtl-Duo/docs/wiki/img/touch/cyd-28-chan-runaway-dark.png

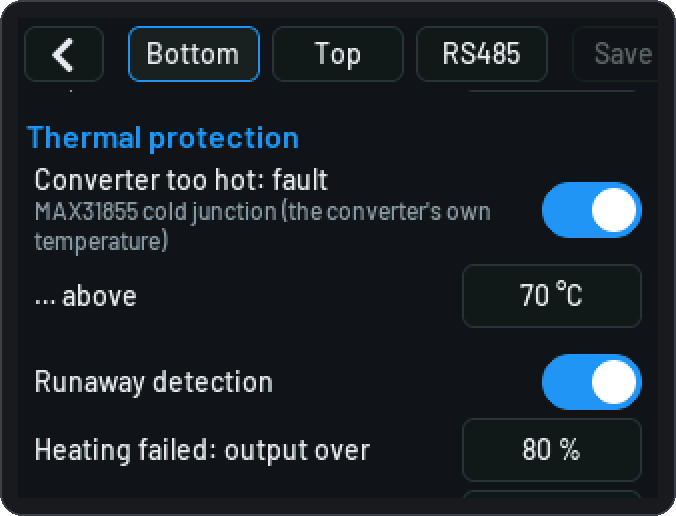
docs/wiki/img/touch/cyd-28-chan-runaway-dark.png
