justr0st/TempCtl-Duo/docs/wiki/img/touch/cyd-28-chan-runaway-light.png

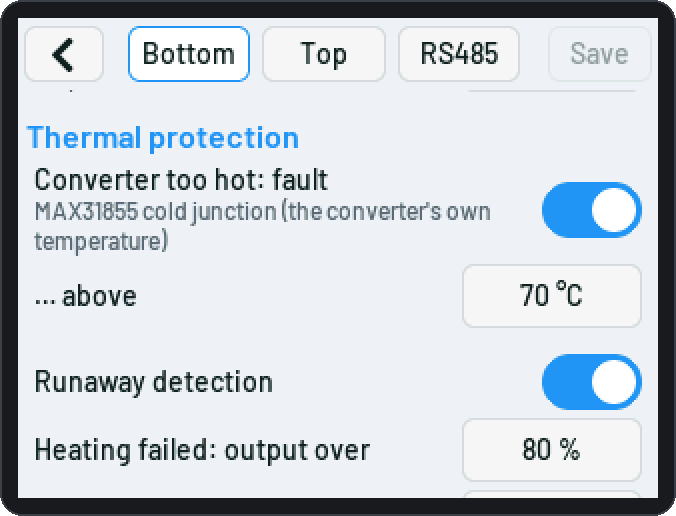
docs/wiki/img/touch/cyd-28-chan-runaway-light.png
