justr0st/TempCtl-Duo/docs/wiki/img/touch/cyd-29-touch-cal-dark.png

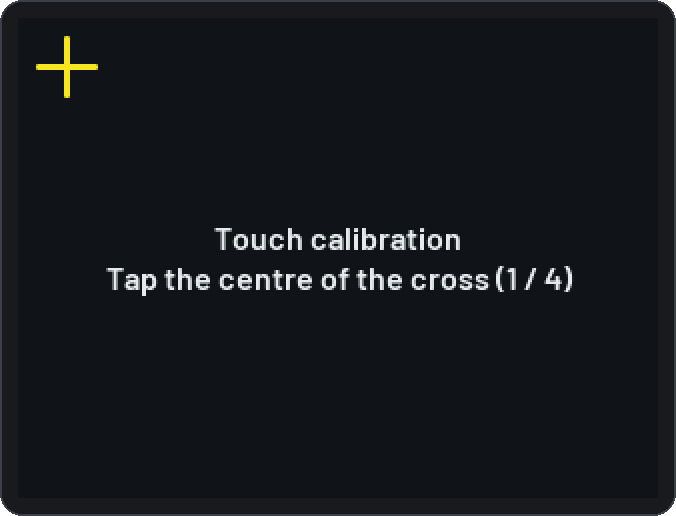
docs/wiki/img/touch/cyd-29-touch-cal-dark.png
