justr0st/TempCtl-Duo/docs/wiki/img/touch/cyd-30-ota-dark.png

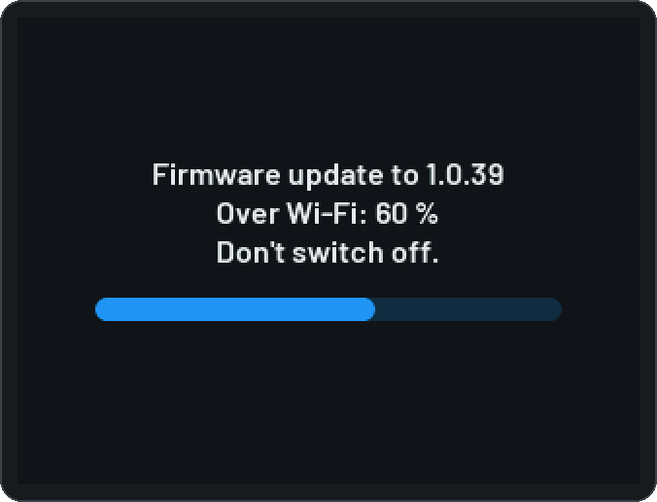
docs/wiki/img/touch/cyd-30-ota-dark.png
