justr0st/TempCtl-Duo/docs/wiki/img/touch/cyd-30-ota-light.png

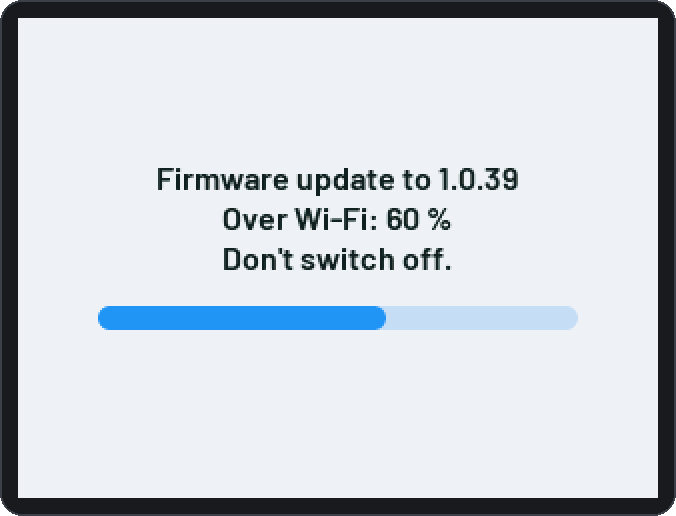
docs/wiki/img/touch/cyd-30-ota-light.png
