justr0st/TempCtl-Duo/docs/wiki/img/touch/cyd-31b-run-report-light.png

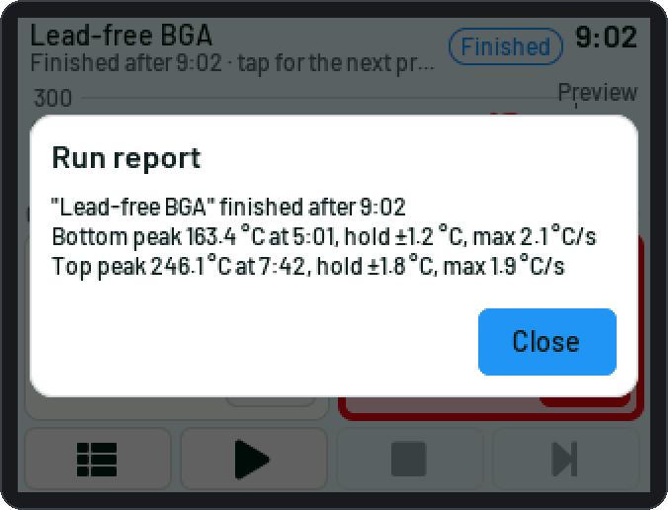
docs/wiki/img/touch/cyd-31b-run-report-light.png
