justr0st/TempCtl-Duo/docs/wiki/img/web/channels-local-dark.webp

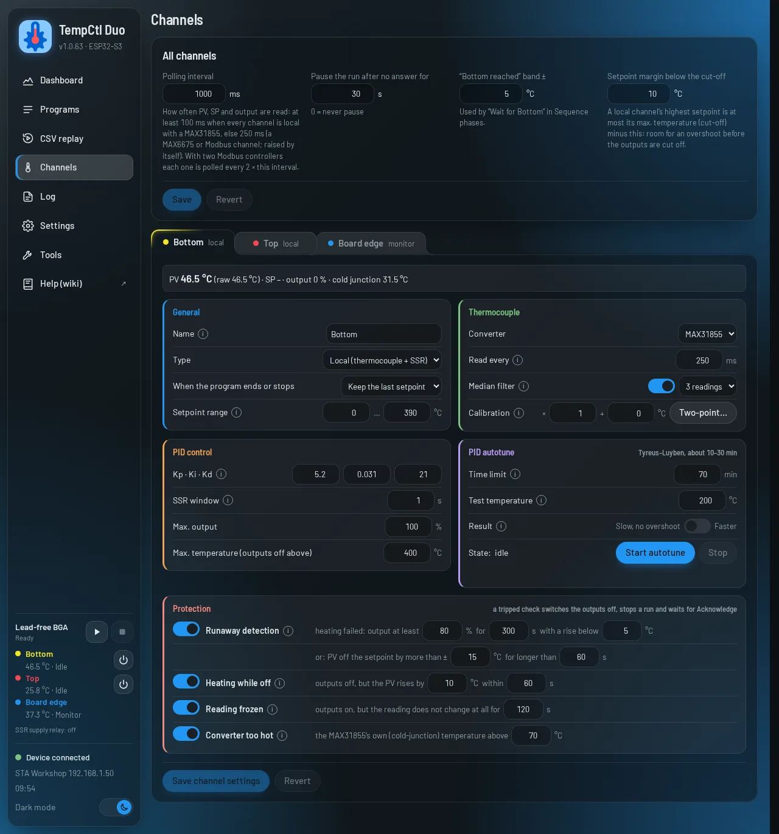
docs/wiki/img/web/channels-local-dark.webp
