justr0st/TempCtl-Duo/docs/wiki/img/web/channels-modbus-dark.webp

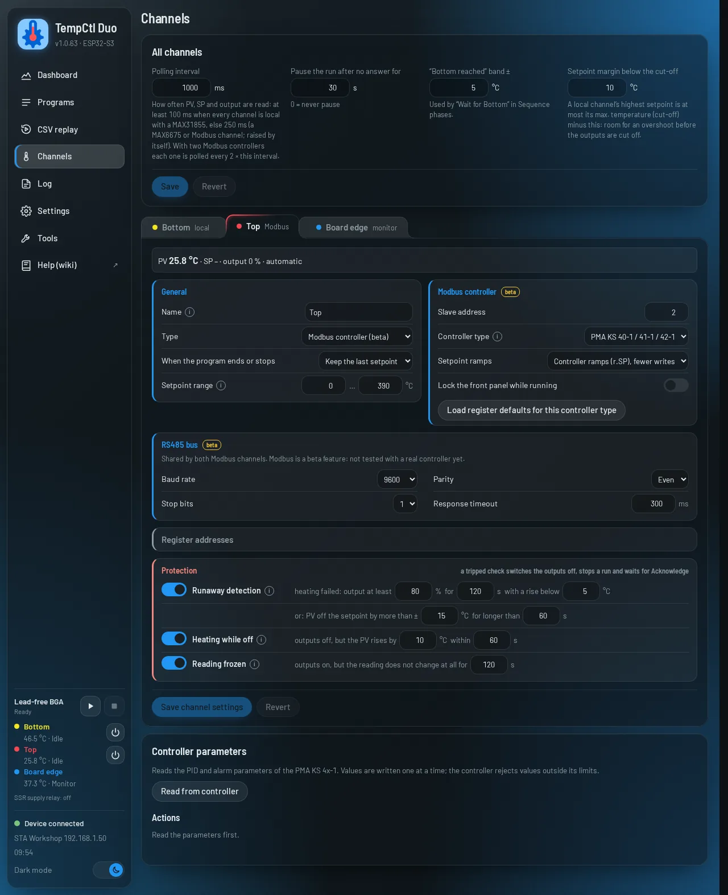
docs/wiki/img/web/channels-modbus-dark.webp
