justr0st/TempCtl-Duo/docs/wiki/img/web/channels-monitor-dark.webp

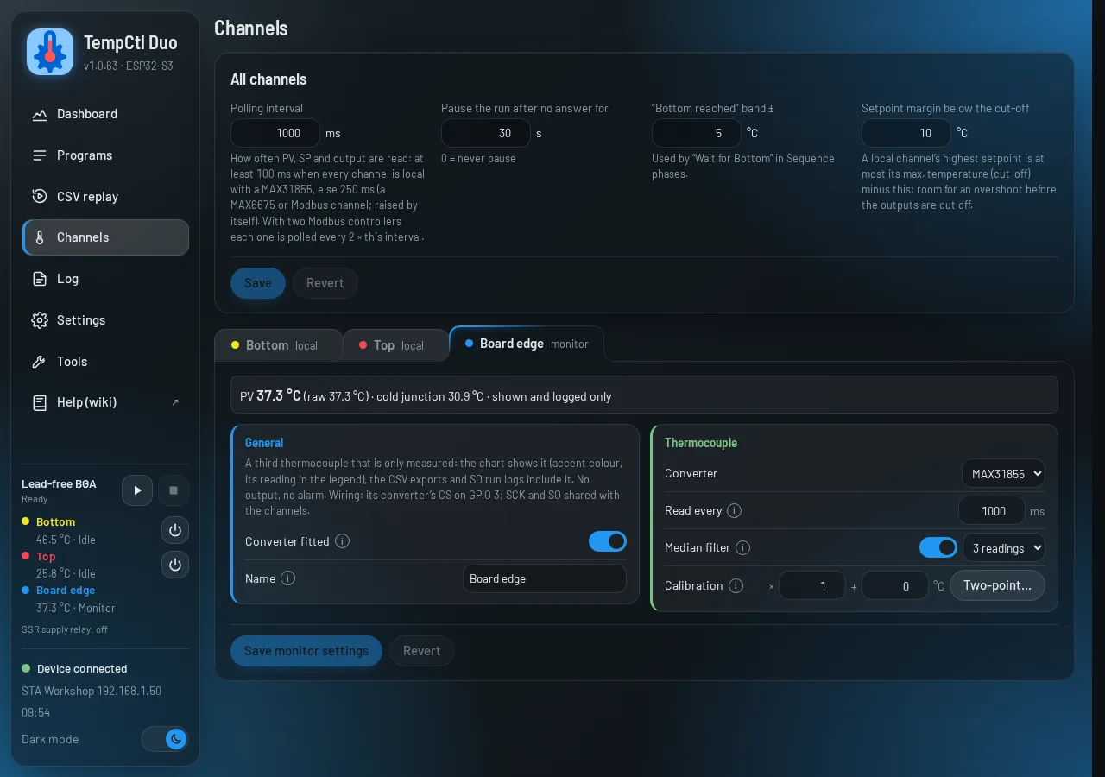
docs/wiki/img/web/channels-monitor-dark.webp
