justr0st/TempCtl-Duo/docs/wiki/img/web/connect-dark.webp

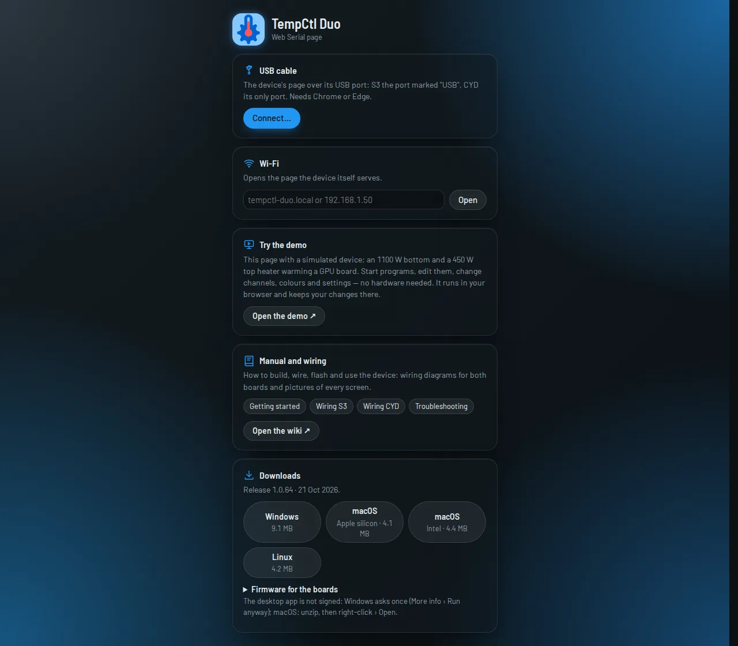
docs/wiki/img/web/connect-dark.webp
