justr0st/TempCtl-Duo/docs/wiki/img/web/dashboard-action-dark.webp

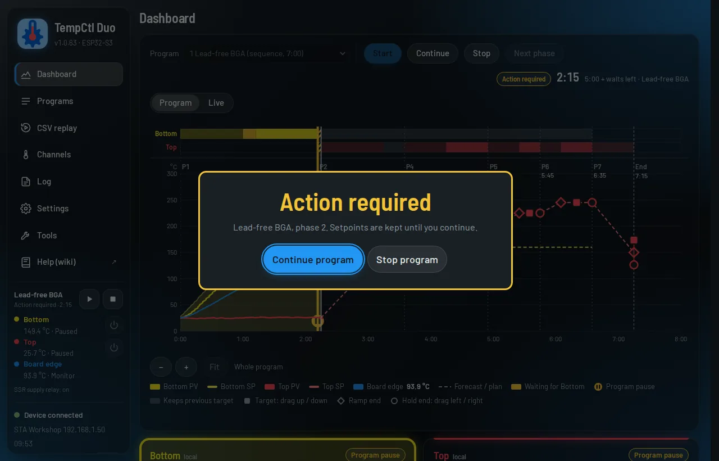
docs/wiki/img/web/dashboard-action-dark.webp
