justr0st/TempCtl-Duo/docs/wiki/img/web/dashboard-autotune-dark.webp

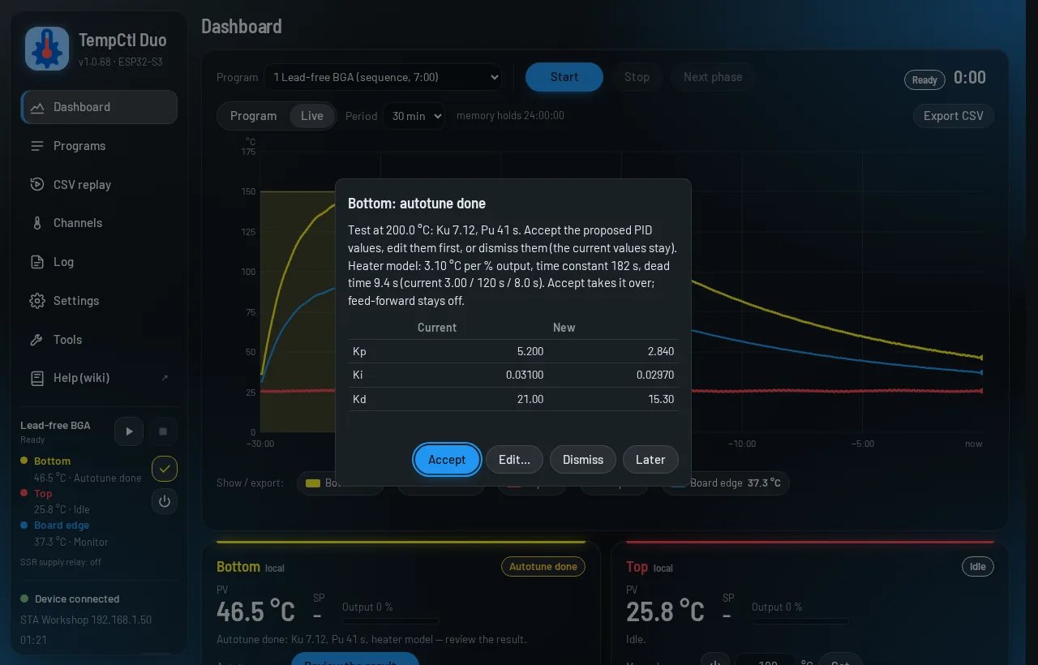
docs/wiki/img/web/dashboard-autotune-dark.webp
