justr0st/TempCtl-Duo/docs/wiki/img/web/dashboard-cards-dark.webp

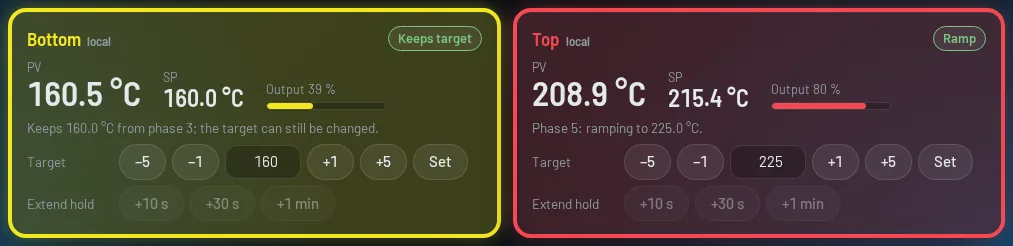
docs/wiki/img/web/dashboard-cards-dark.webp
