justr0st/TempCtl-Duo/docs/wiki/img/web/dashboard-done-dark.webp

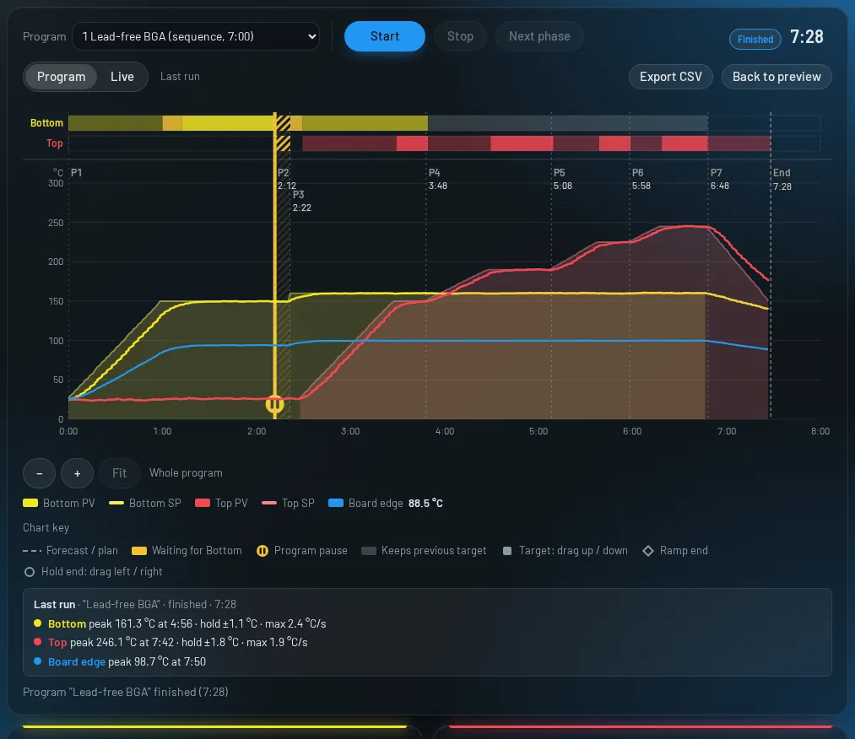
docs/wiki/img/web/dashboard-done-dark.webp
