justr0st/TempCtl-Duo/docs/wiki/img/web/dashboard-fault-dark.webp

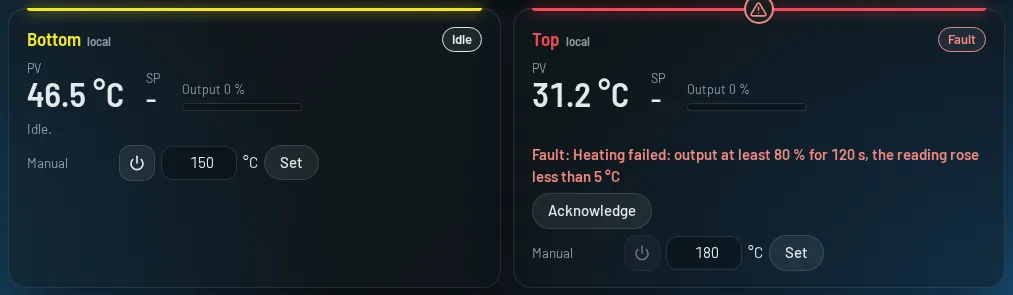
docs/wiki/img/web/dashboard-fault-dark.webp
