justr0st/TempCtl-Duo/docs/wiki/img/web/dashboard-interrupted-dark.webp

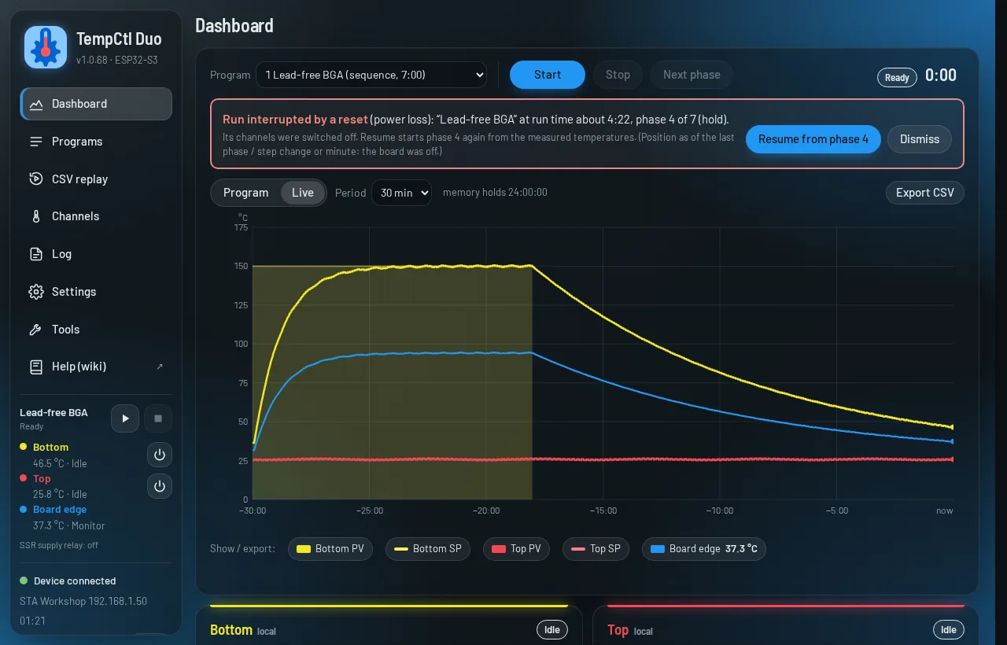
docs/wiki/img/web/dashboard-interrupted-dark.webp
