justr0st/TempCtl-Duo/docs/wiki/img/web/dashboard-run-dark.webp

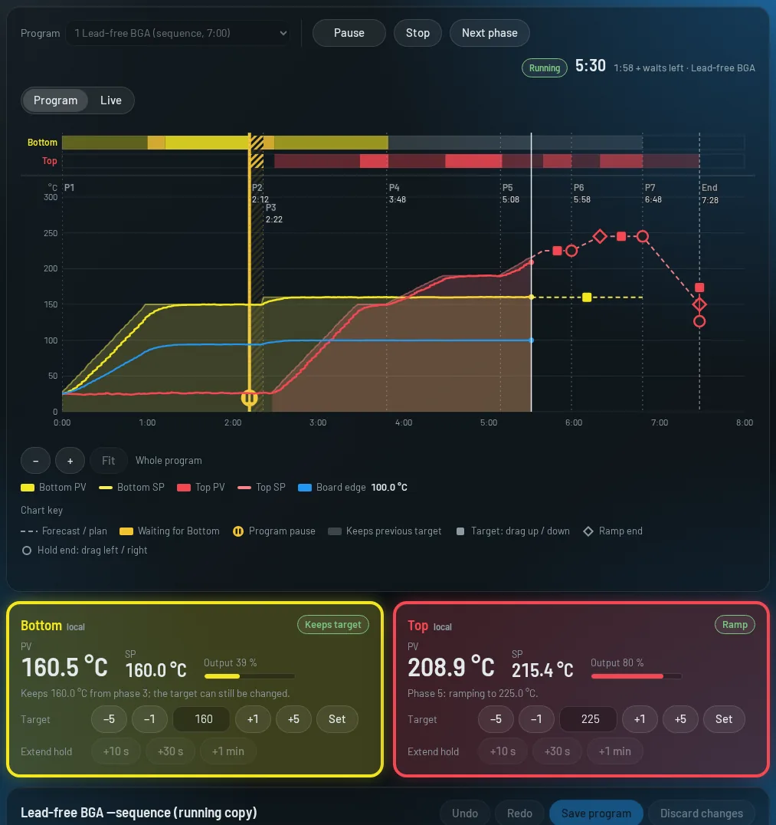
docs/wiki/img/web/dashboard-run-dark.webp
