justr0st/TempCtl-Duo/docs/wiki/img/web/dashboard-run-phone-dark.webp

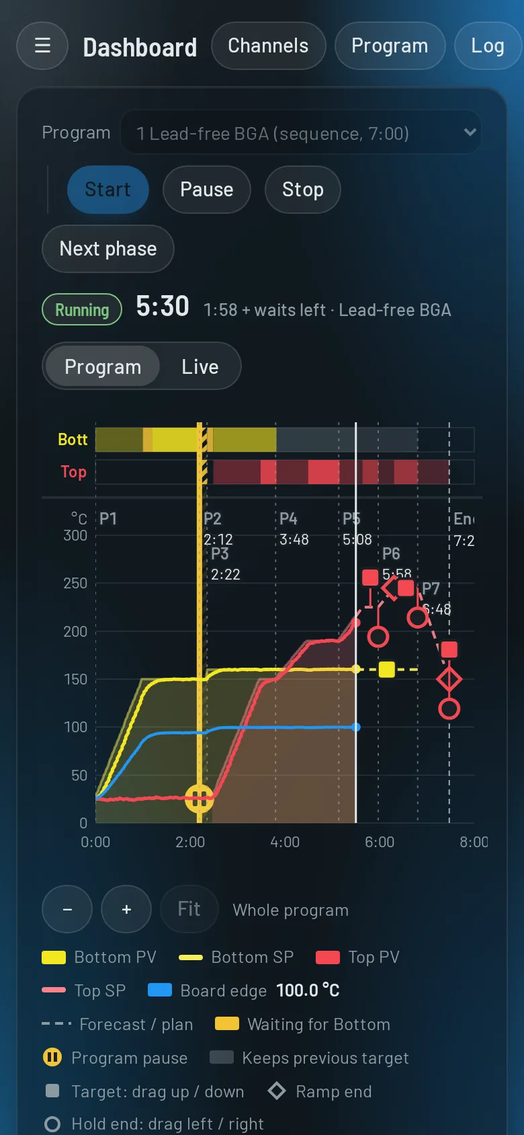
docs/wiki/img/web/dashboard-run-phone-dark.webp
