justr0st/TempCtl-Duo/docs/wiki/img/web/demo-dark.webp

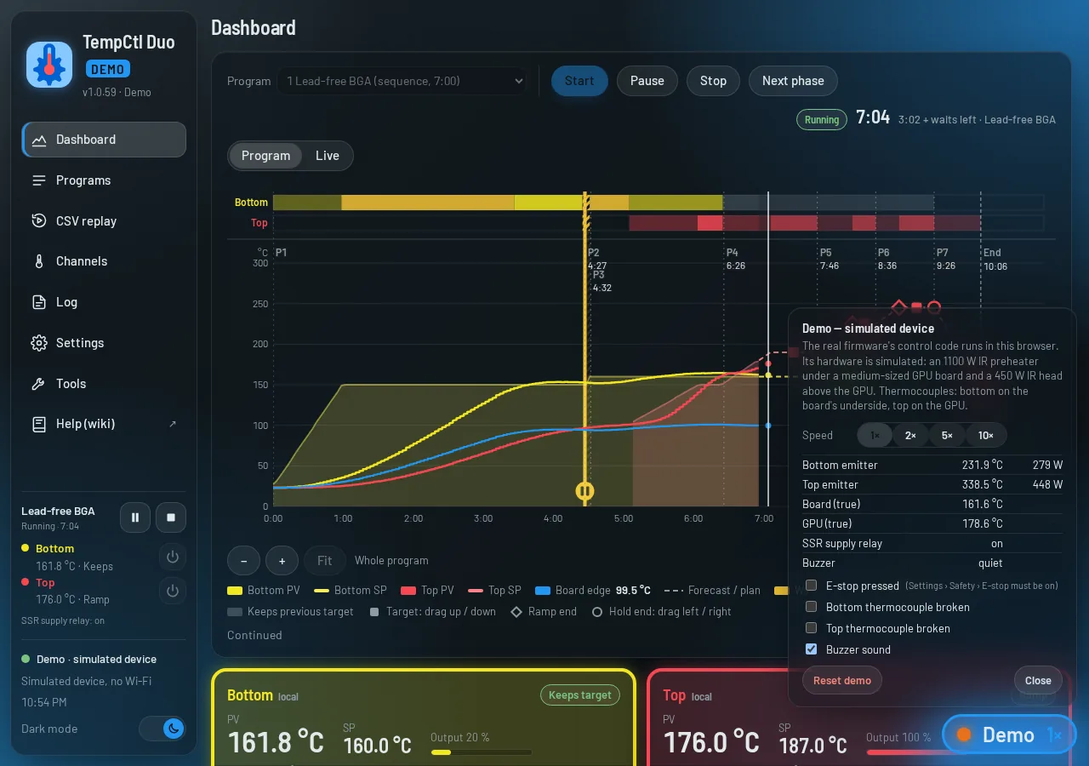
docs/wiki/img/web/demo-dark.webp
