justr0st/TempCtl-Duo/docs/wiki/img/web/editor-chart-dark.webp

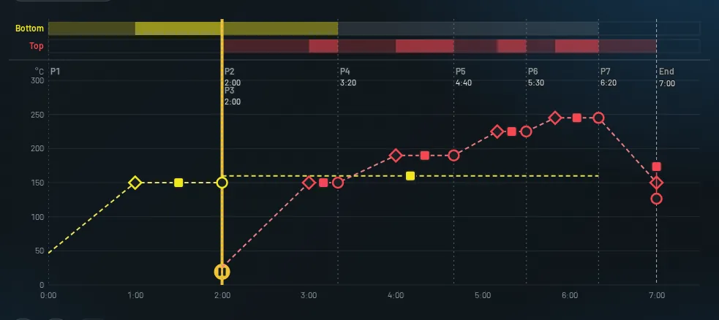
docs/wiki/img/web/editor-chart-dark.webp
