justr0st/TempCtl-Duo/docs/wiki/img/web/editor-seq-dark.webp

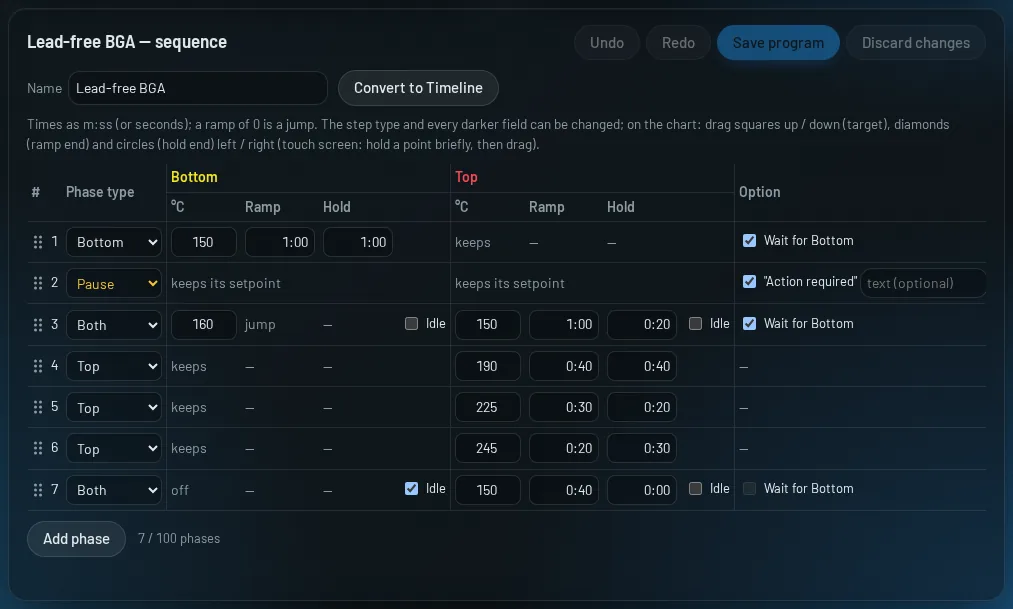
docs/wiki/img/web/editor-seq-dark.webp
