justr0st/TempCtl-Duo/docs/wiki/img/web/editor-tl-dark.webp

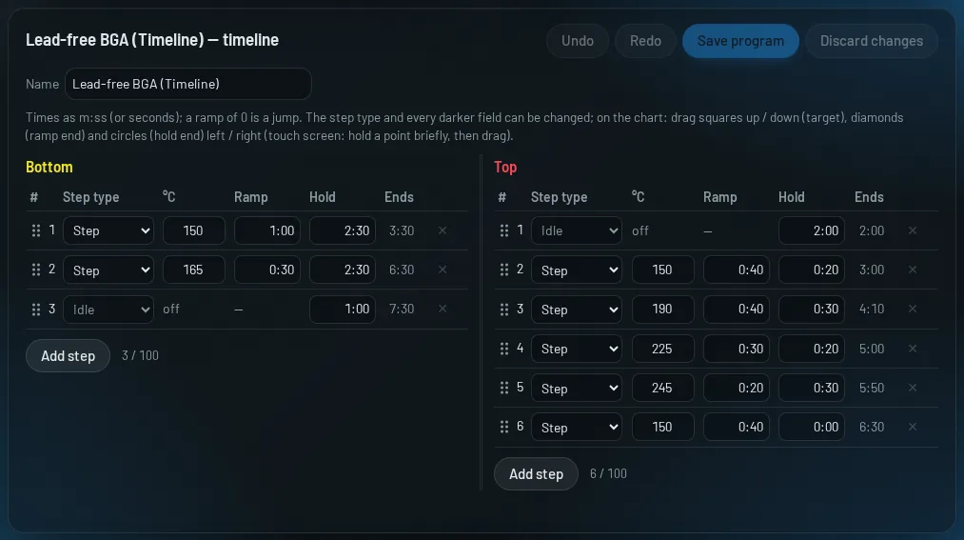
docs/wiki/img/web/editor-tl-dark.webp
