justr0st/TempCtl-Duo/docs/wiki/img/web/log-dark.webp

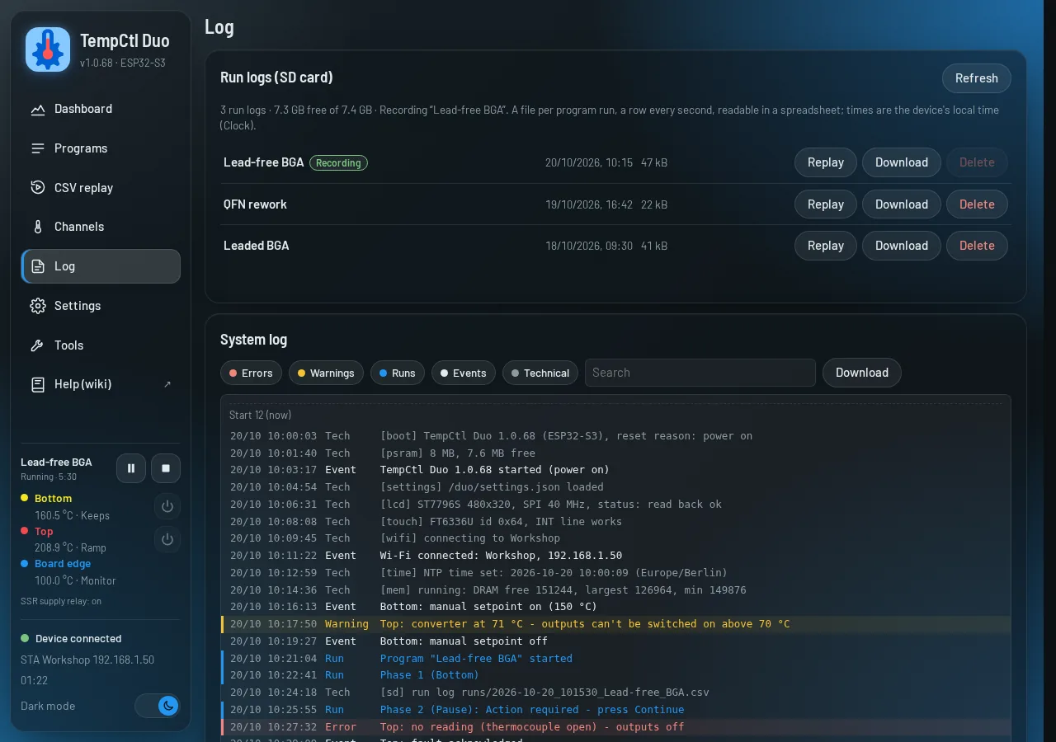
docs/wiki/img/web/log-dark.webp
