justr0st/TempCtl-Duo/docs/wiki/img/web/programs-dark.webp

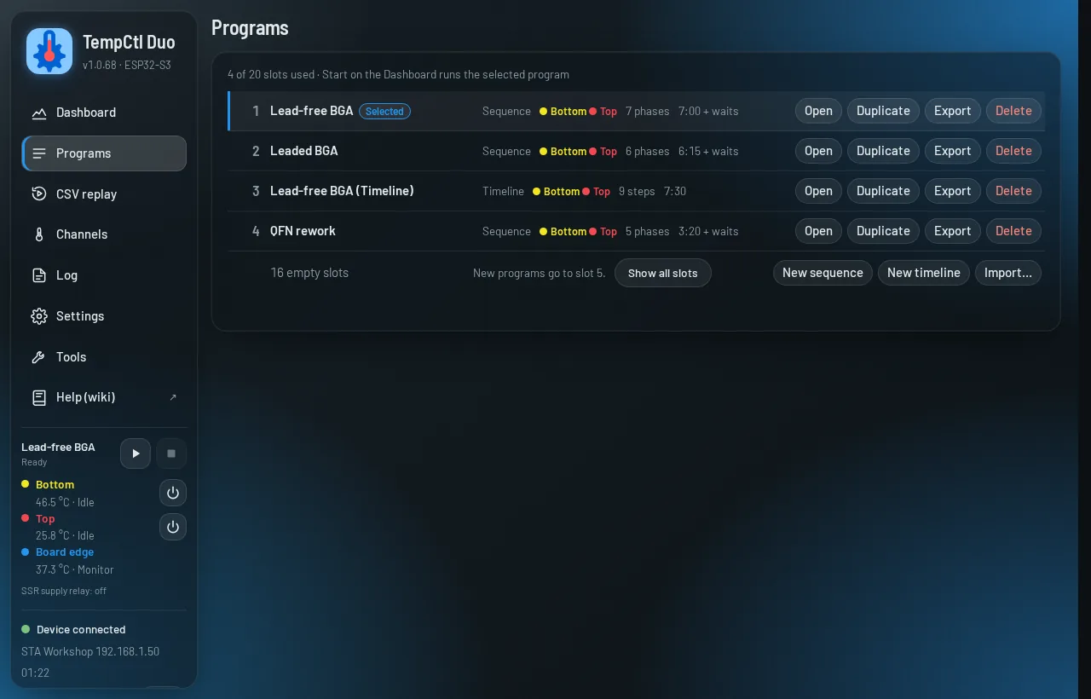
docs/wiki/img/web/programs-dark.webp
