justr0st/TempCtl-Duo/docs/wiki/img/web/replay-dark.webp

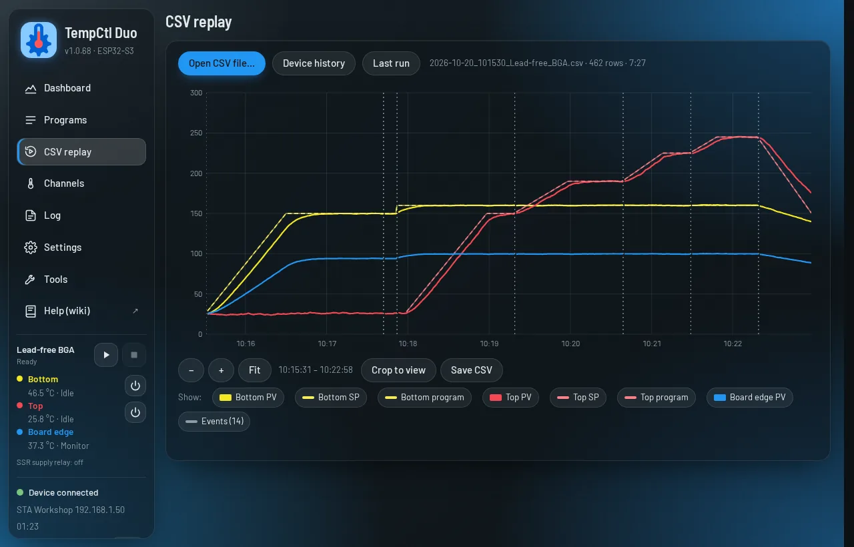
docs/wiki/img/web/replay-dark.webp
