justr0st/TempCtl-Duo/docs/wiki/img/web/settings-dark.webp

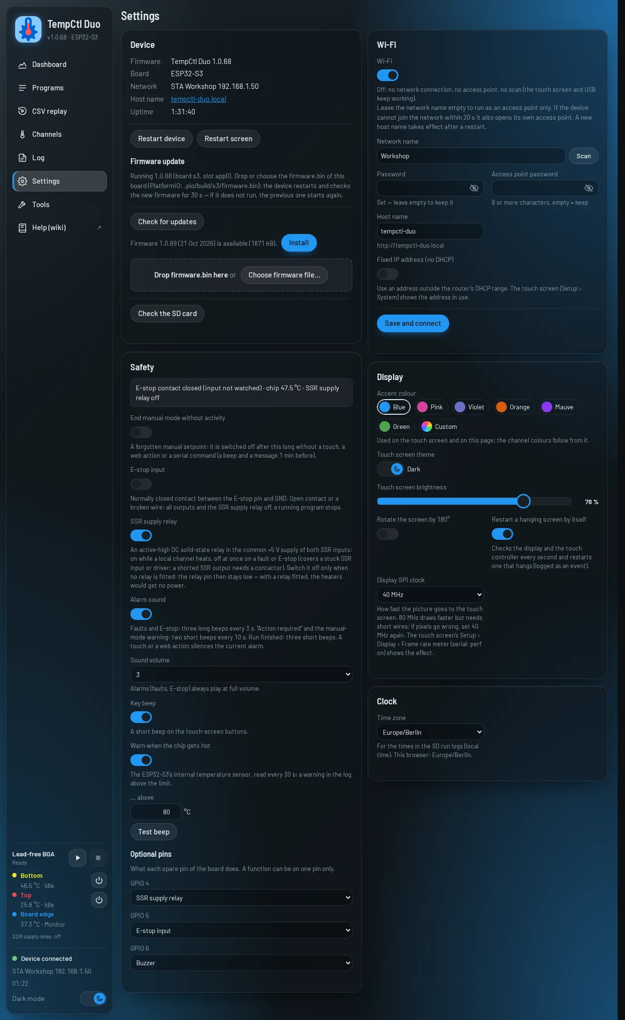
docs/wiki/img/web/settings-dark.webp
