justr0st/TempCtl-Duo/docs/wiki/img/web/settings-update-dark.webp

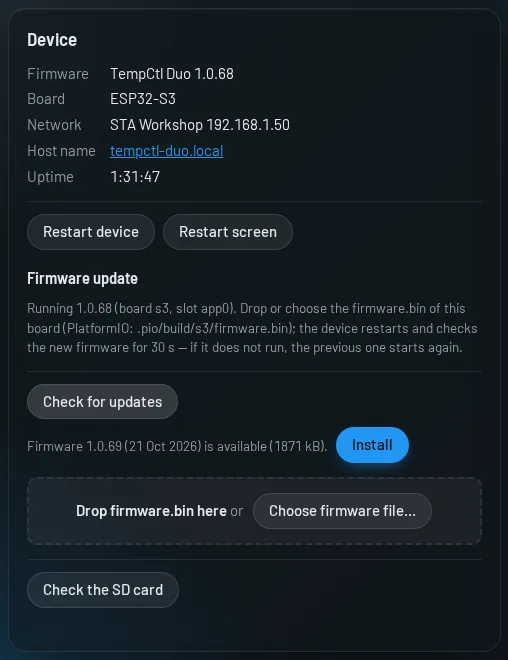
docs/wiki/img/web/settings-update-dark.webp
