justr0st/TempCtl-Duo/docs/wiki/img/web/sidebar-dark.webp

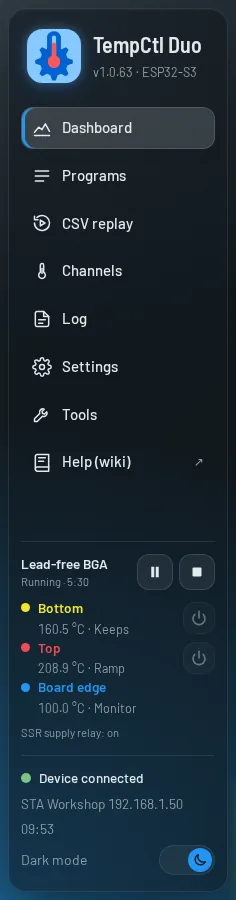
docs/wiki/img/web/sidebar-dark.webp
