justr0st/TempCtl-Duo/docs/wiki/img/web/tools-dark.webp

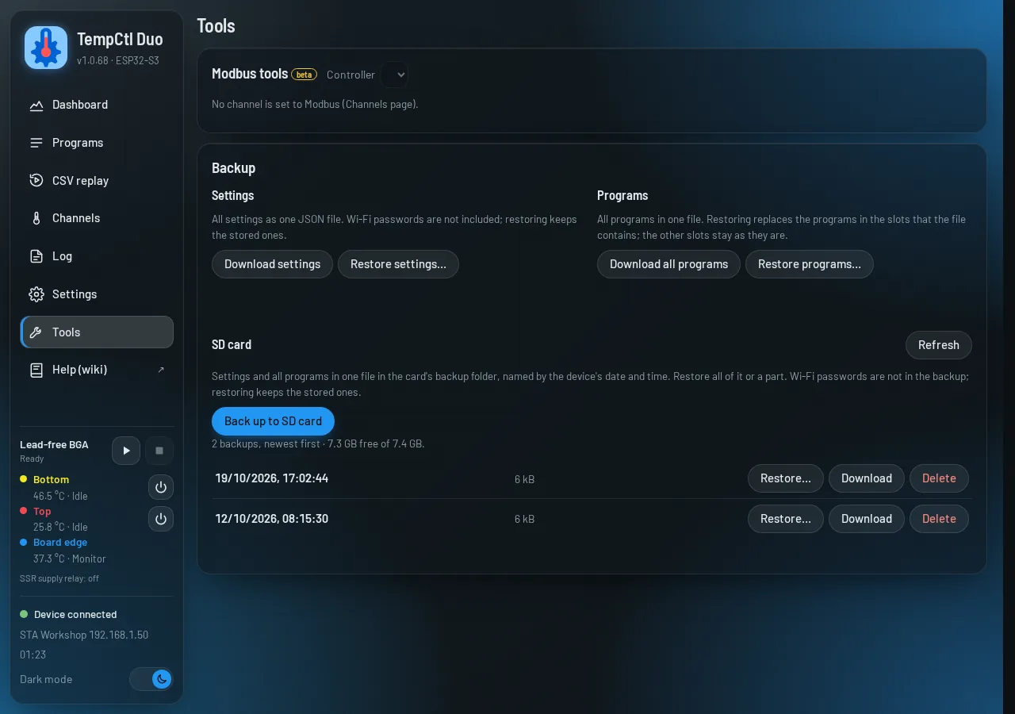
docs/wiki/img/web/tools-dark.webp
