justr0st/TempCtl-Duo/hardware/cyd-schematic/TempCtl-Duo-CYD-A.png

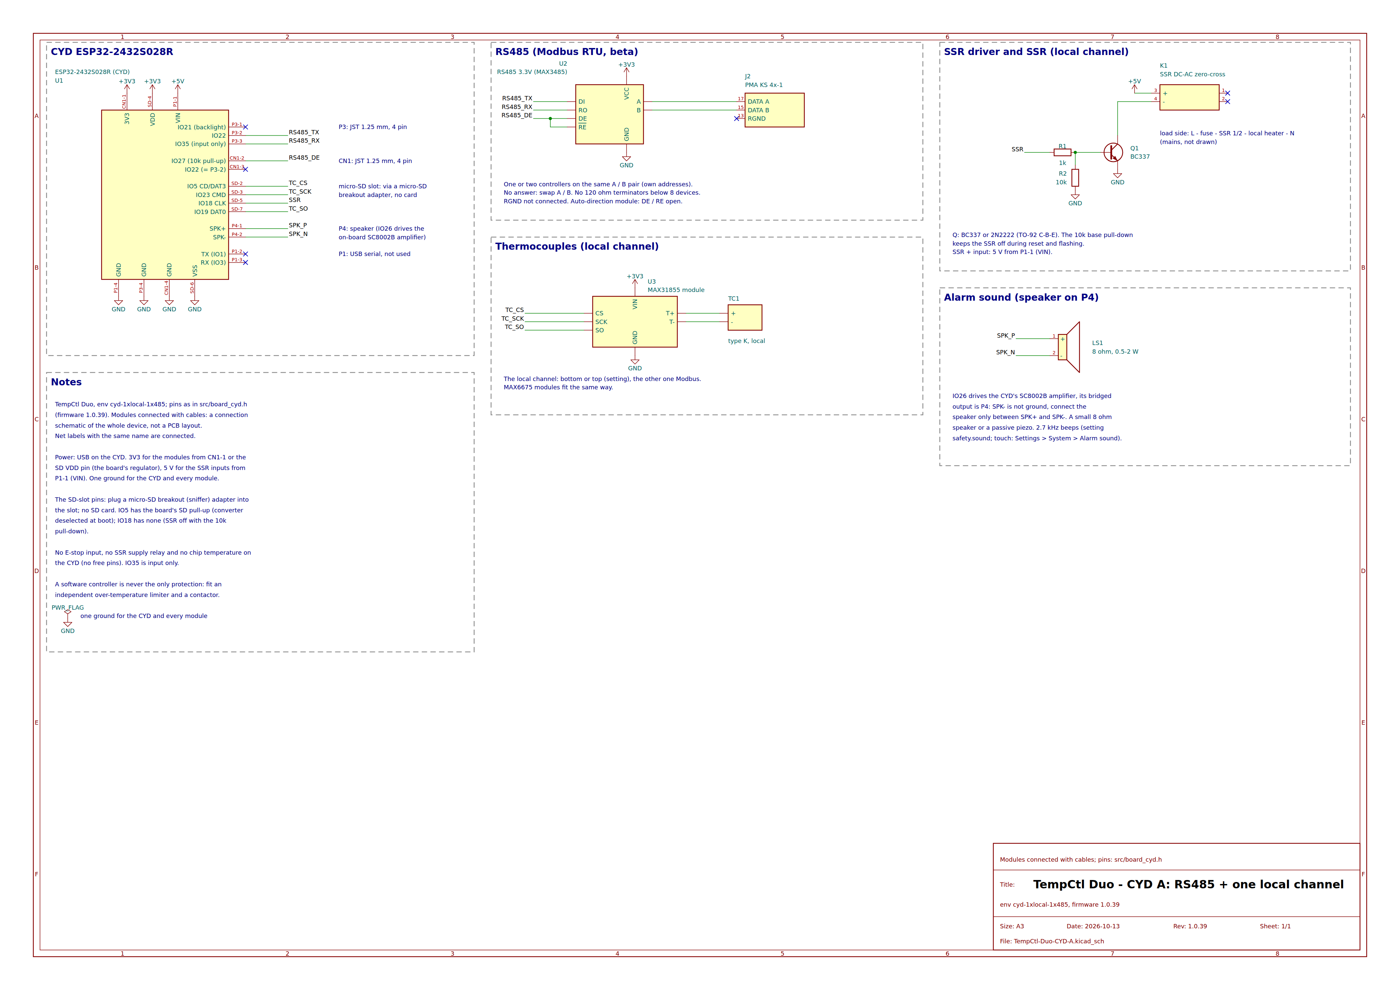
hardware/cyd-schematic/TempCtl-Duo-CYD-A.png
