justr0st/TempCtl-Duo/hardware/cyd-schematic/TempCtl-Duo-CYD-B.png

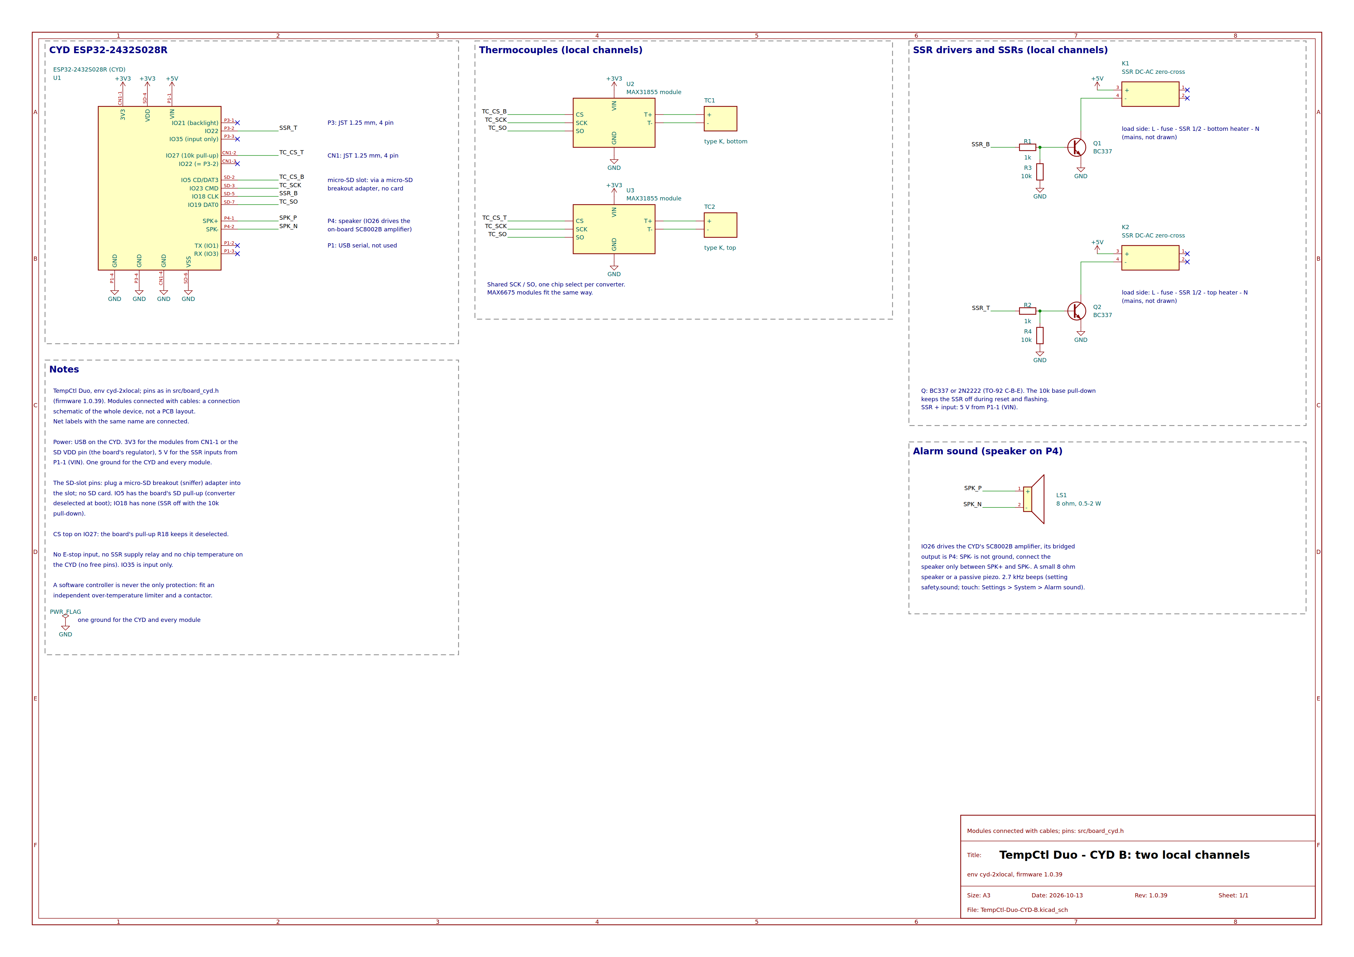
hardware/cyd-schematic/TempCtl-Duo-CYD-B.png
