justr0st/TempCtl-Duo/hardware/cyd-schematic/TempCtl-Duo-CYD-C.png

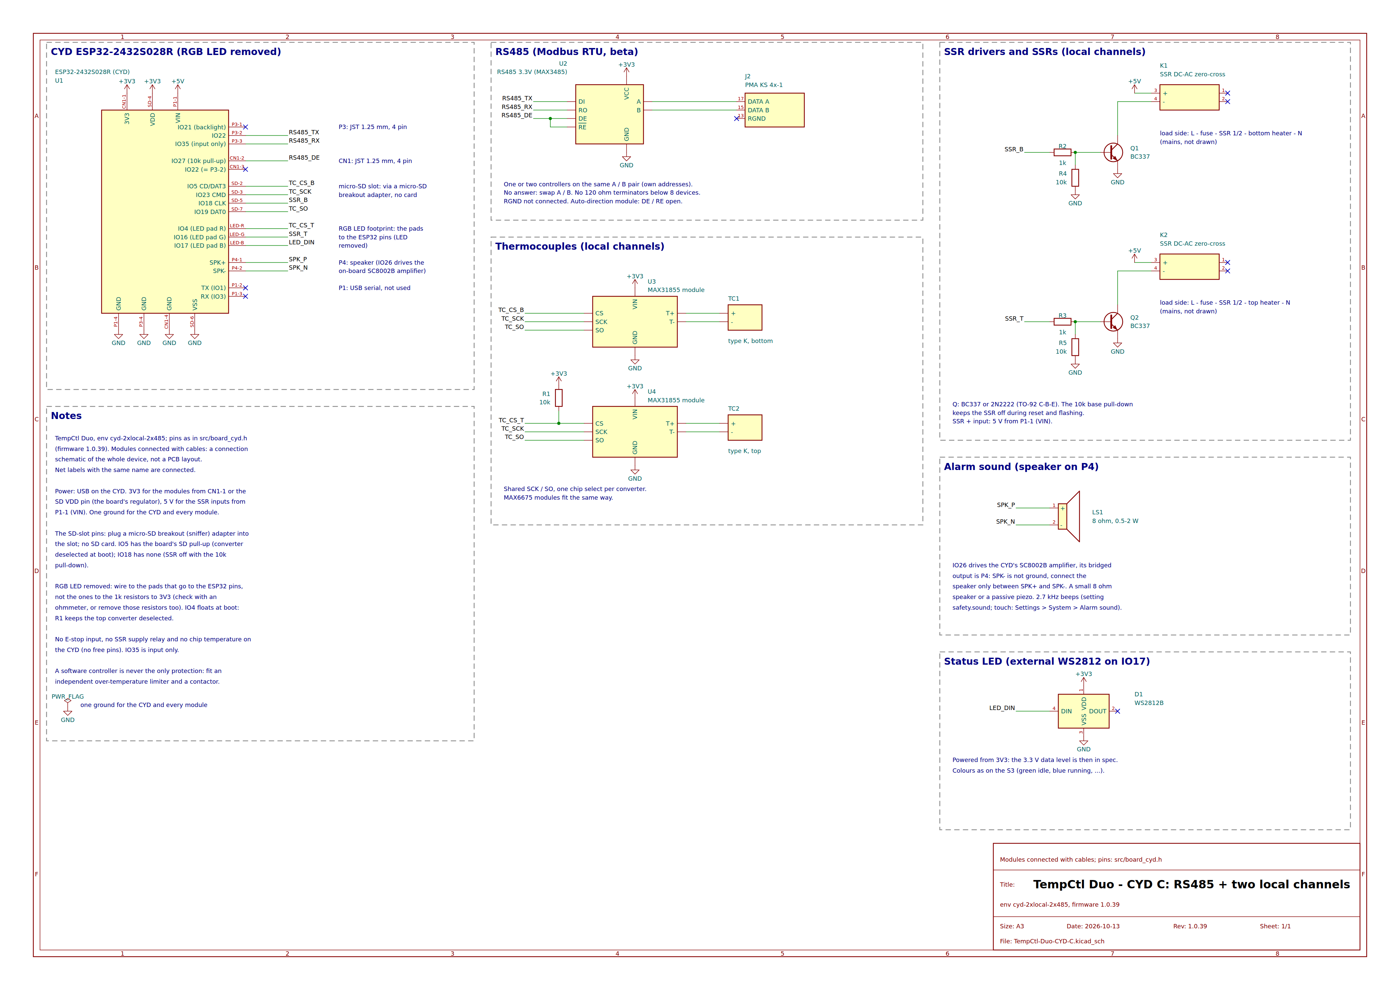
hardware/cyd-schematic/TempCtl-Duo-CYD-C.png
