justr0st/TempCtl-Duo/hardware/s3-schematic/TempCtl-Duo-S3.png

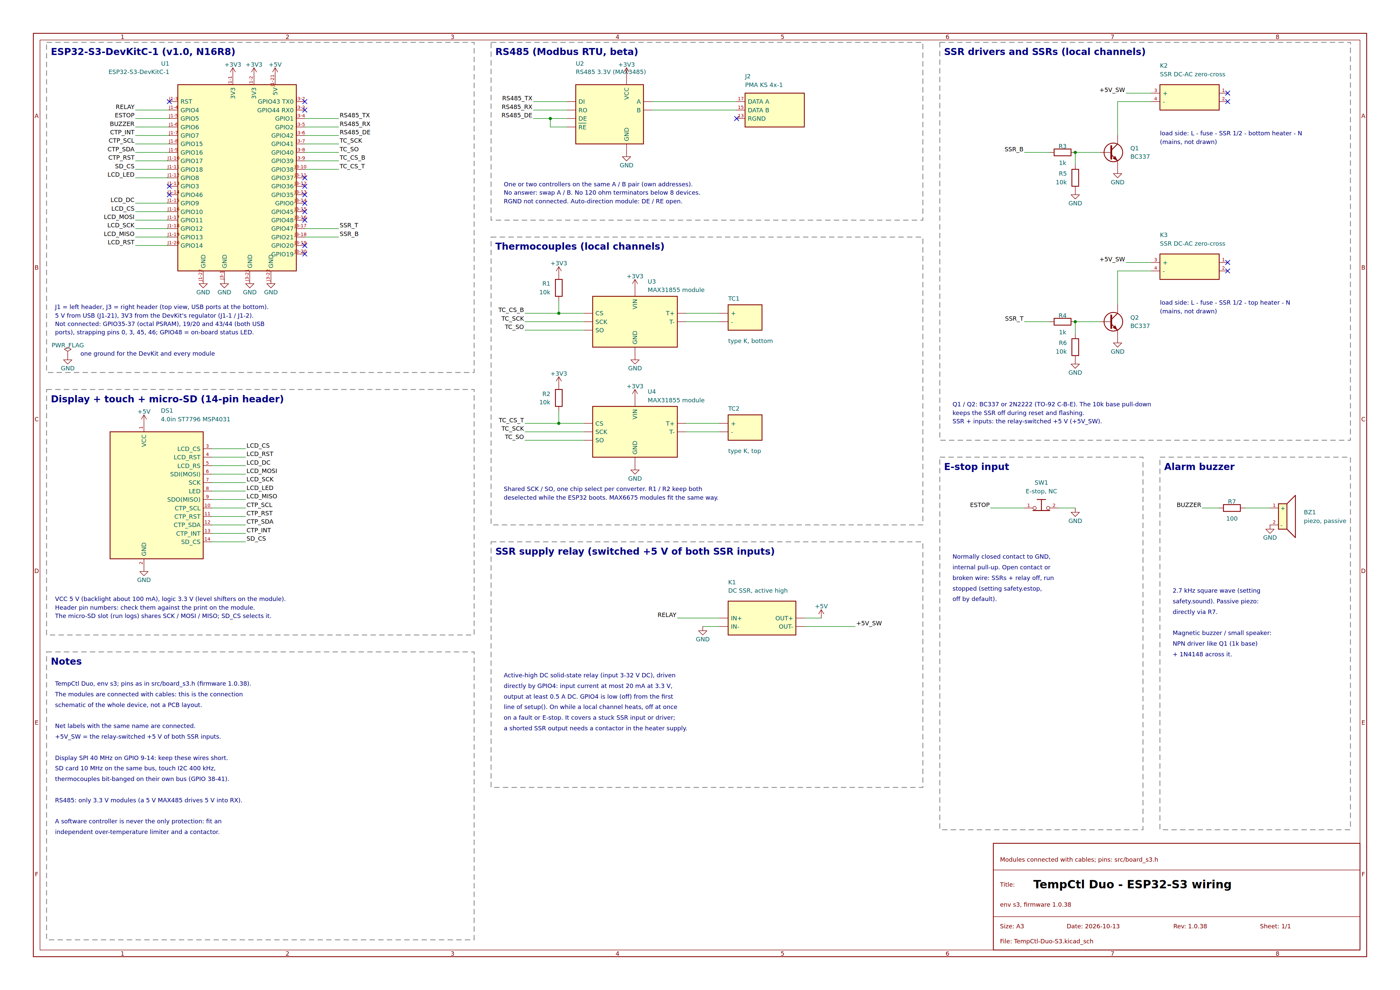
hardware/s3-schematic/TempCtl-Duo-S3.png
