justr0st/TempCtl-Duo/Claude outputs/cyd-wiring-c.png

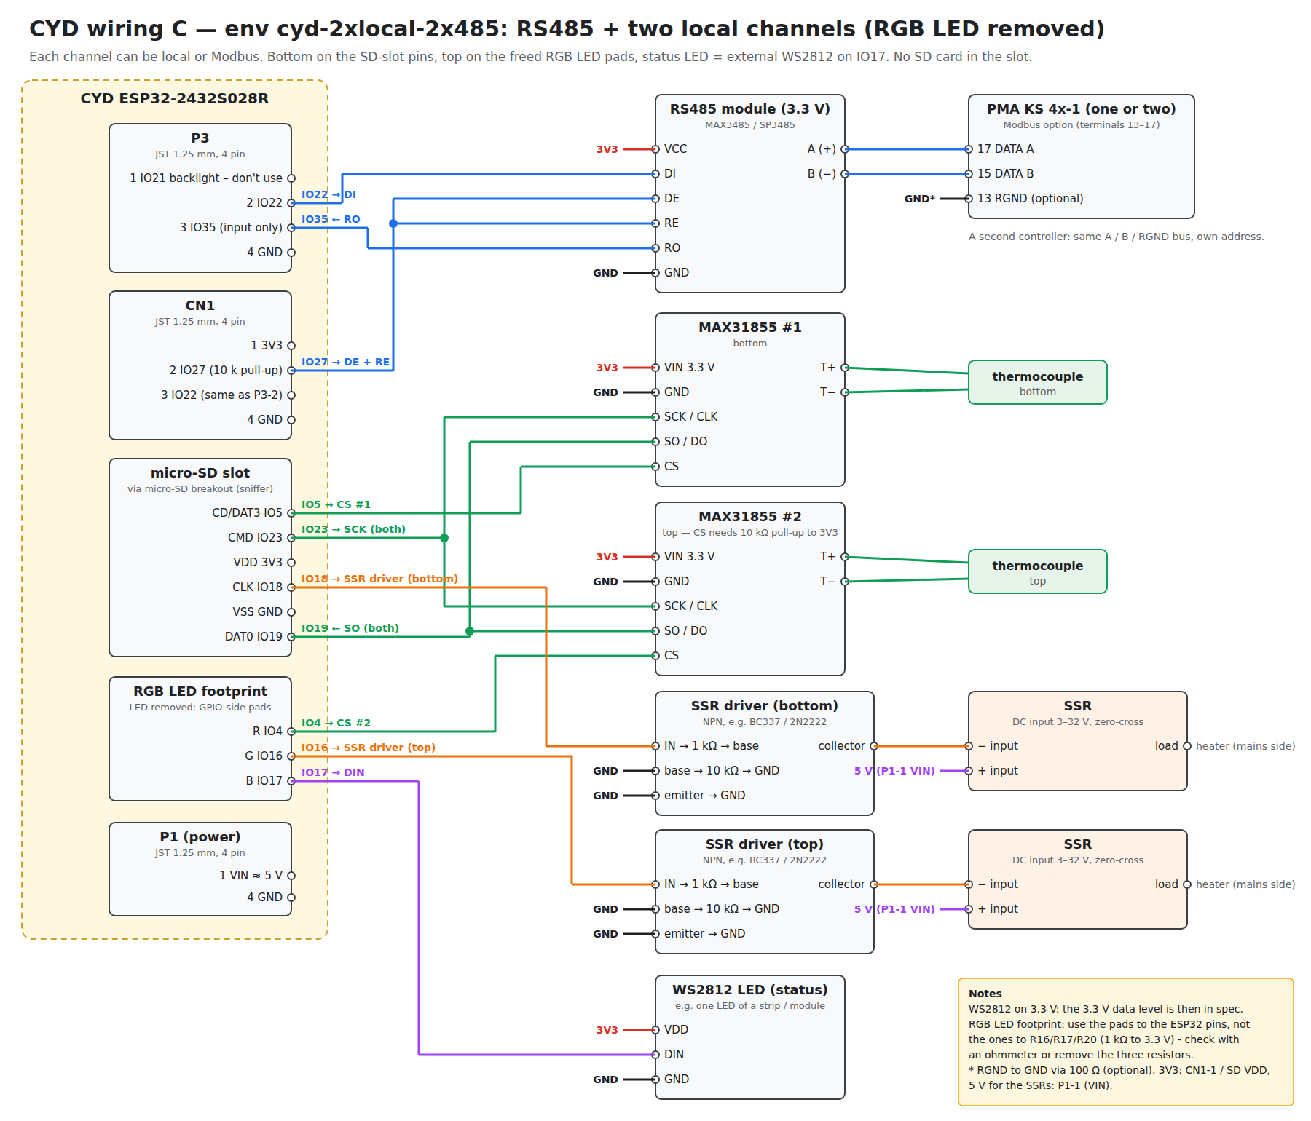
Claude outputs/cyd-wiring-c.png
