justr0st/TempCtl-Duo/Claude outputs/s3-wiring.png

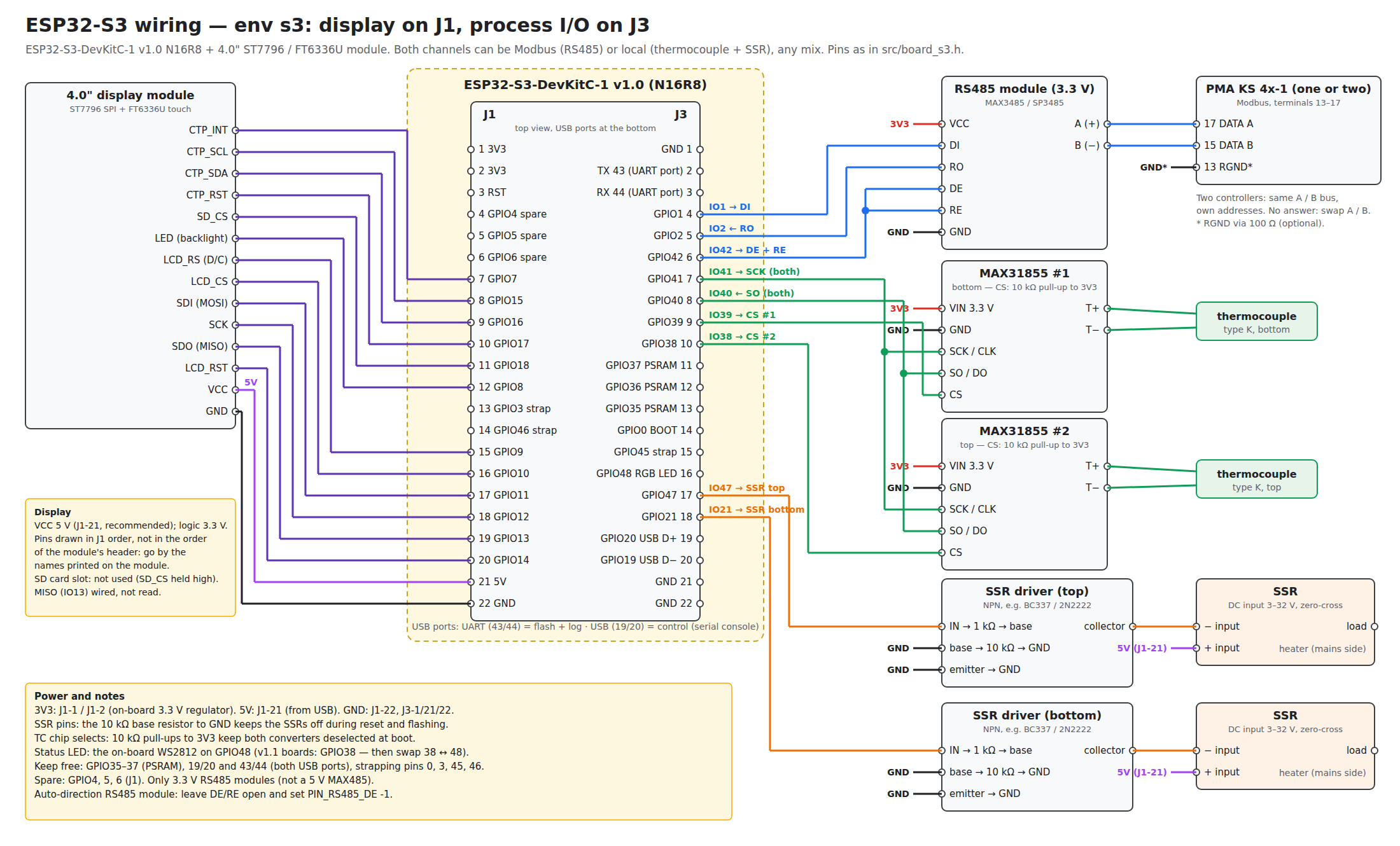
Claude outputs/s3-wiring.png
