justr0st/TempCtl-Duo/Claude outputs/ui-screens/01_main_manual.png

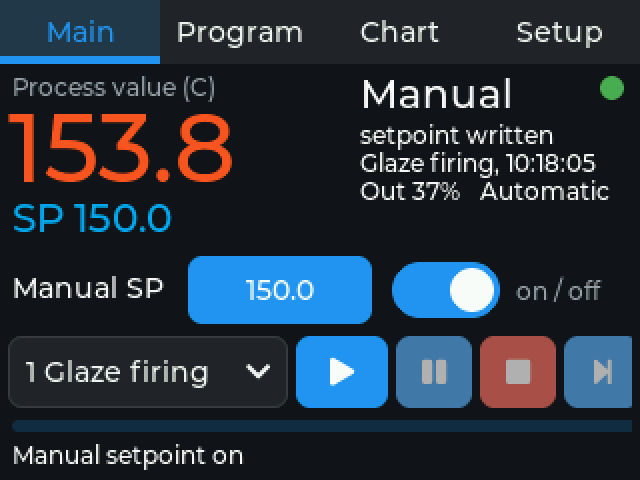
Claude outputs/ui-screens/01_main_manual.png
