justr0st/TempCtl-Duo/Claude outputs/ui-screens/10_setup_system.png

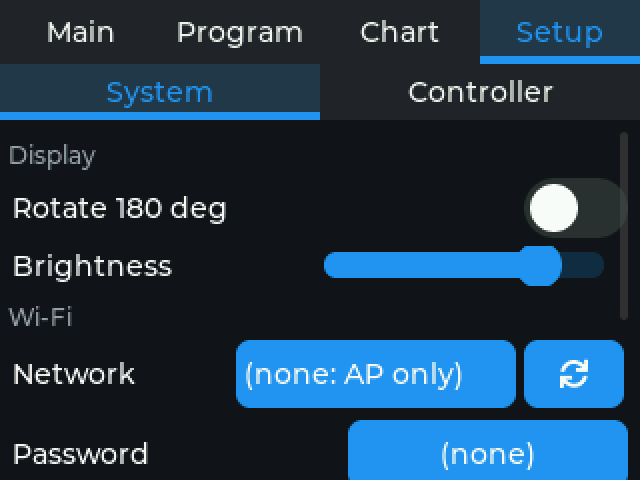
Claude outputs/ui-screens/10_setup_system.png
