justr0st/TempCtl-Duo/Claude outputs/ui-screens/11_setup_controller.png

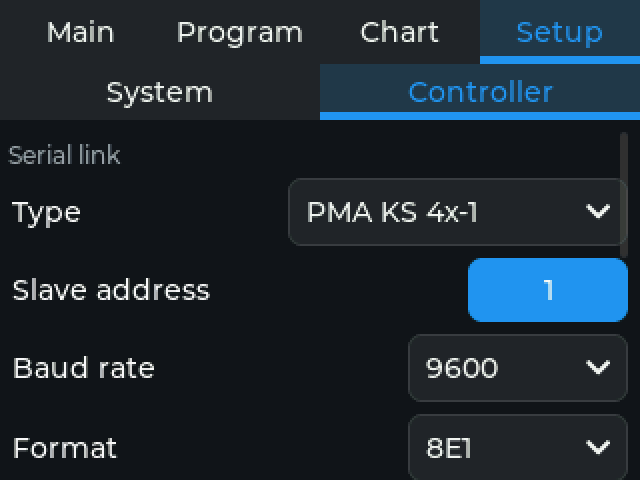
Claude outputs/ui-screens/11_setup_controller.png
