justr0st/TempCtl-Duo/claude/wiring/cyd-wiring-a.png

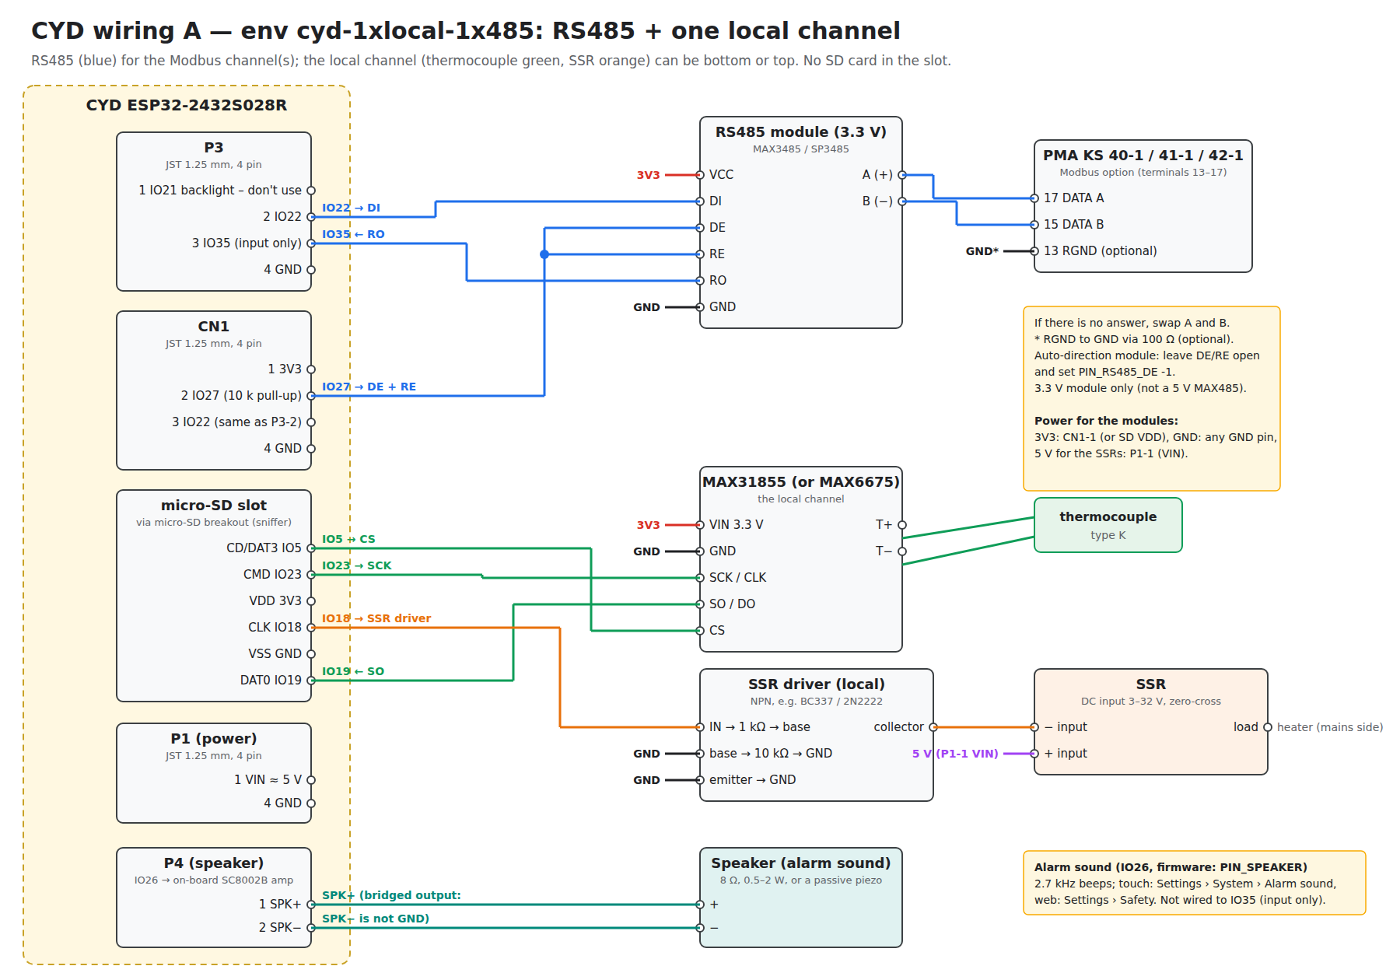
claude/wiring/cyd-wiring-a.png
