justr0st/TempCtl-Duo/claude/wiring/cyd-wiring-b.png

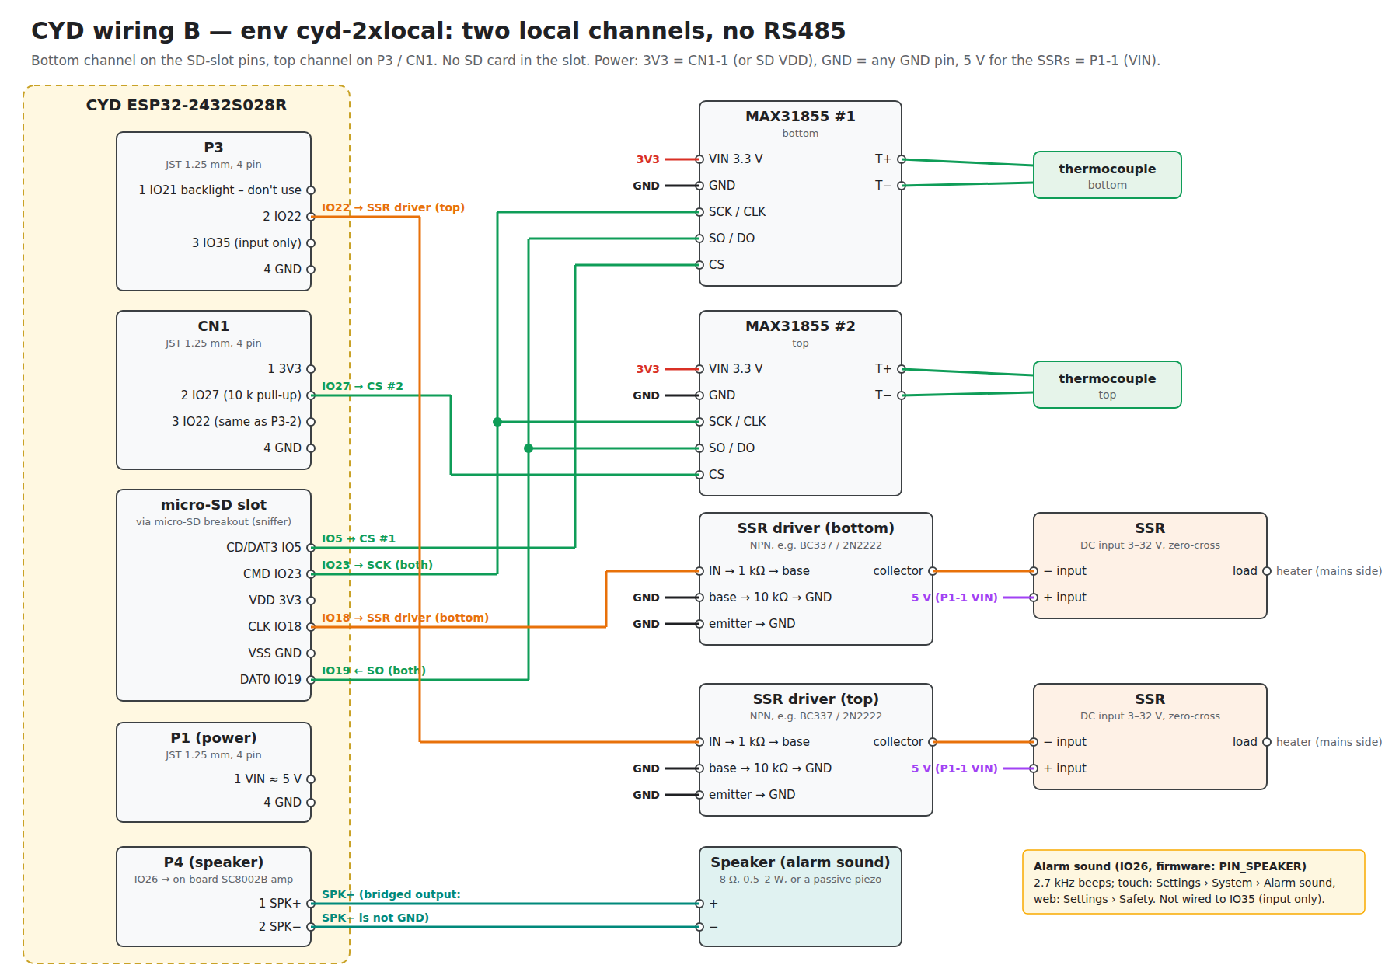
claude/wiring/cyd-wiring-b.png
