justr0st/TempCtl-Duo/claude/wiring/cyd-wiring-c.png

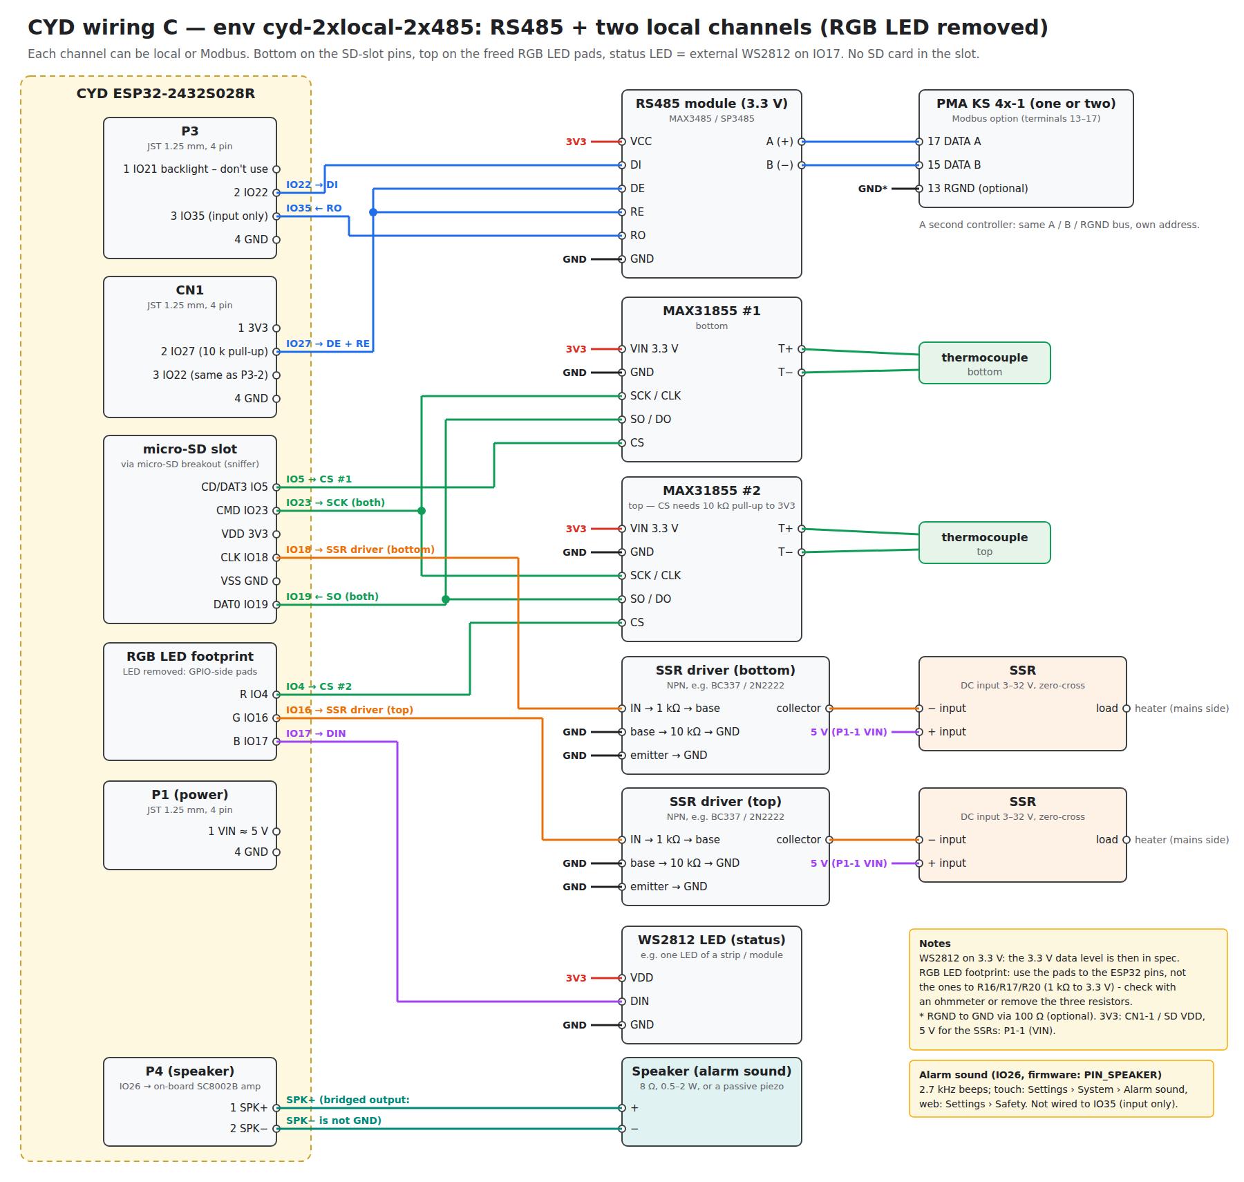
claude/wiring/cyd-wiring-c.png
