justr0st/TempCtl-Duo/claude/wiring/s3-wiring.png

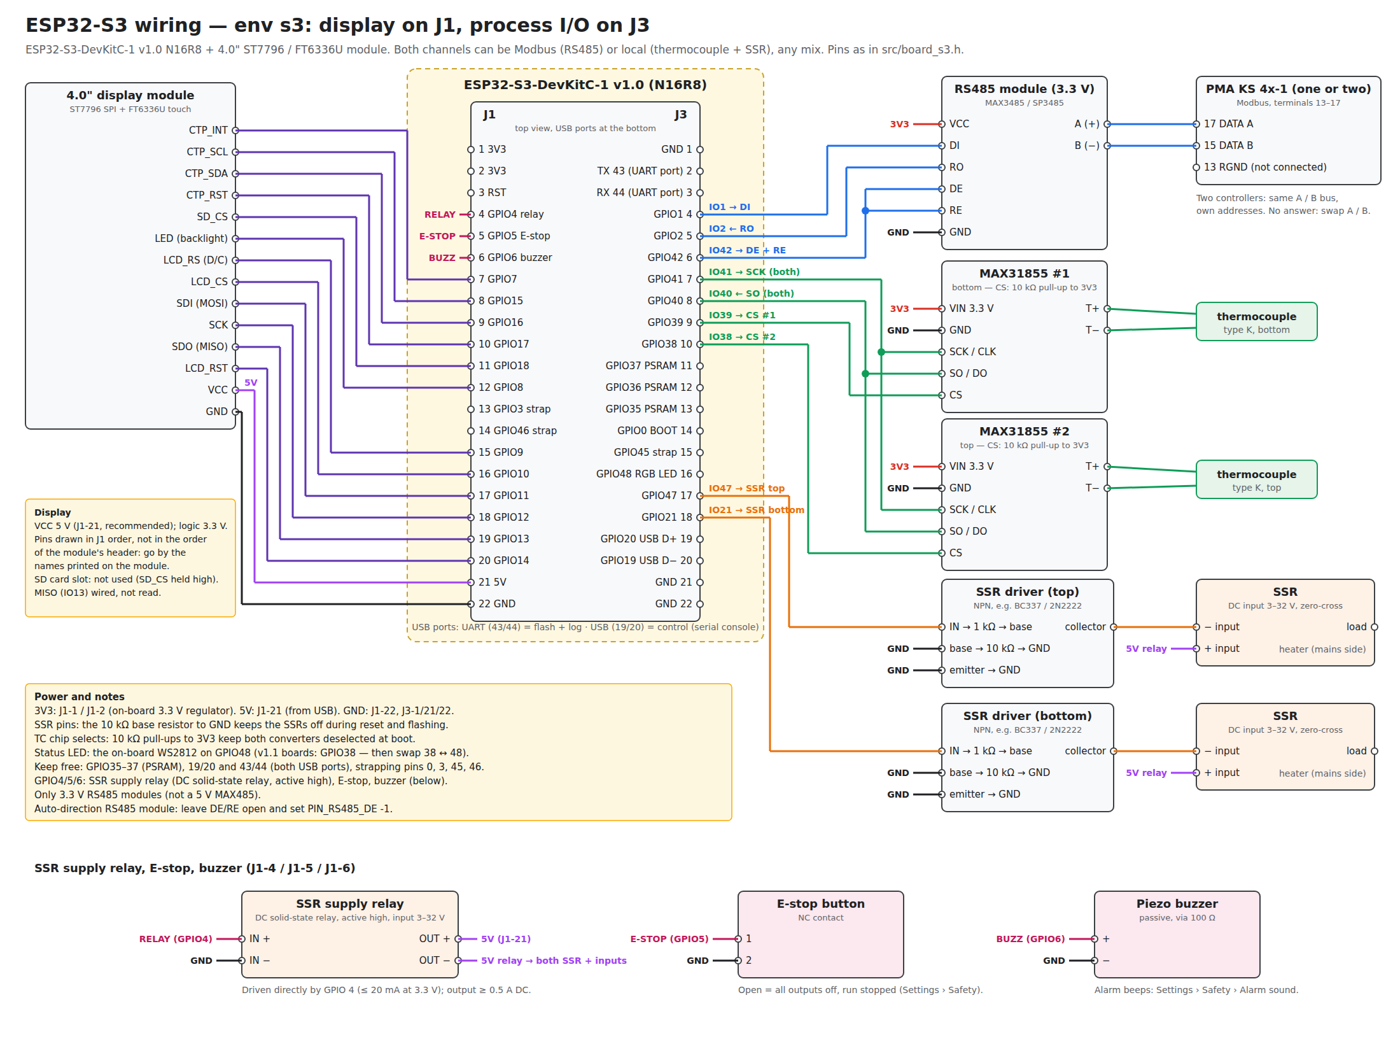
claude/wiring/s3-wiring.png
