justr0st/TempCtl-Duo/docs/wiki/img/touch/cyd-22c-step-menu-dark.png

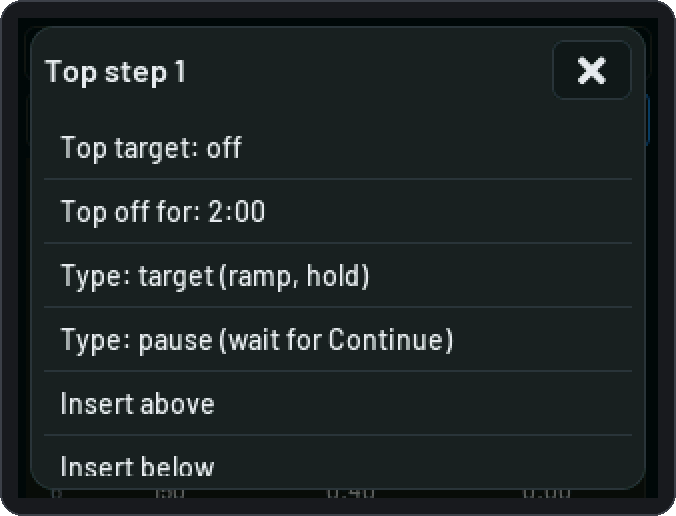
docs/wiki/img/touch/cyd-22c-step-menu-dark.png
