justr0st/TempCtl-Duo/docs/wiki/img/touch/cyd-22c-step-menu-light.png

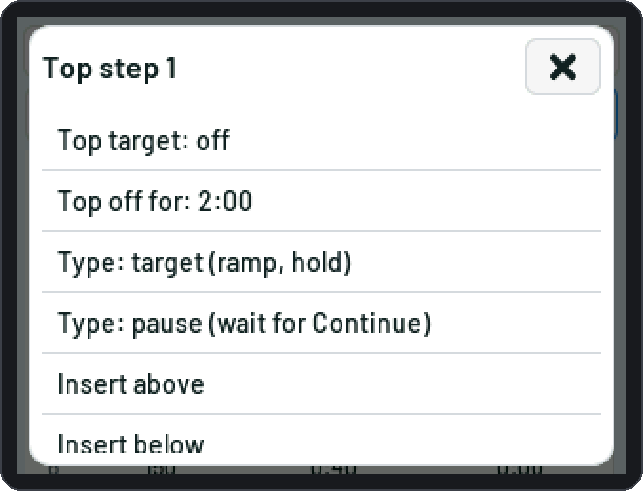
docs/wiki/img/touch/cyd-22c-step-menu-light.png
