justr0st/TempCtl-Duo/docs/wiki/img/web/dashboard-manual-dark.webp

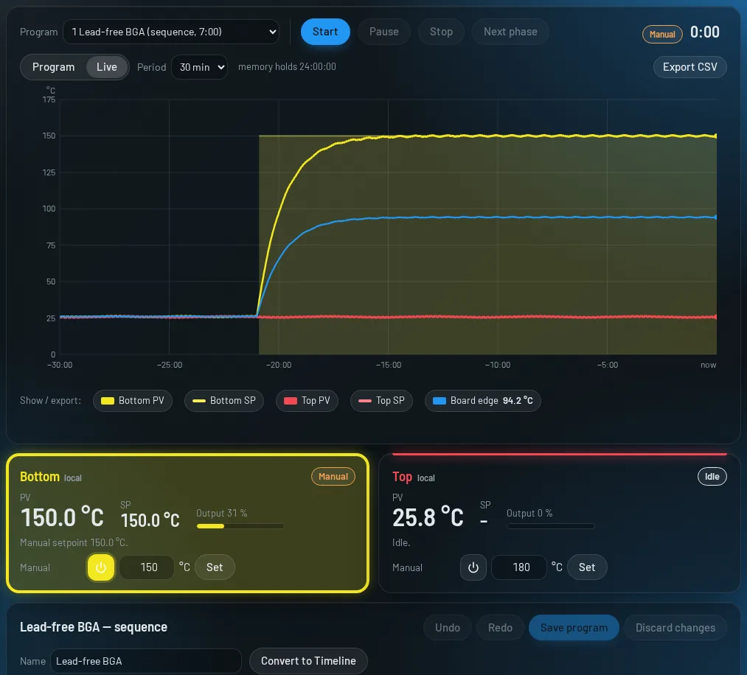
docs/wiki/img/web/dashboard-manual-dark.webp
