justr0st/TempCtl-Duo/docs/wiki/img/touch/cyd-01b-tune-toast-dark.png

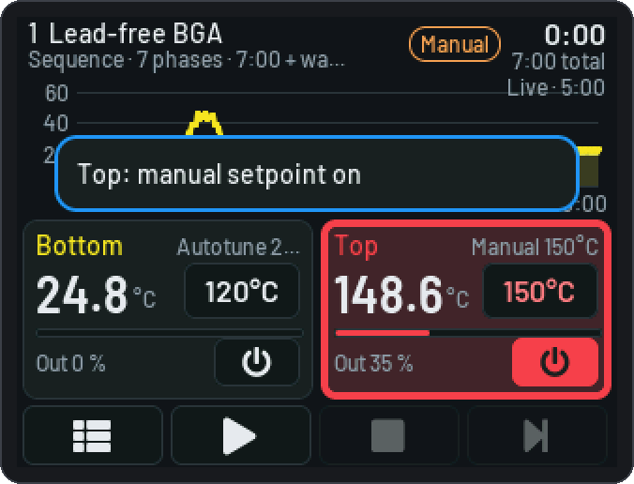
docs/wiki/img/touch/cyd-01b-tune-toast-dark.png
