justr0st/TempCtl-Duo/docs/wiki/img/touch/cyd-01b-tune-toast-light.png

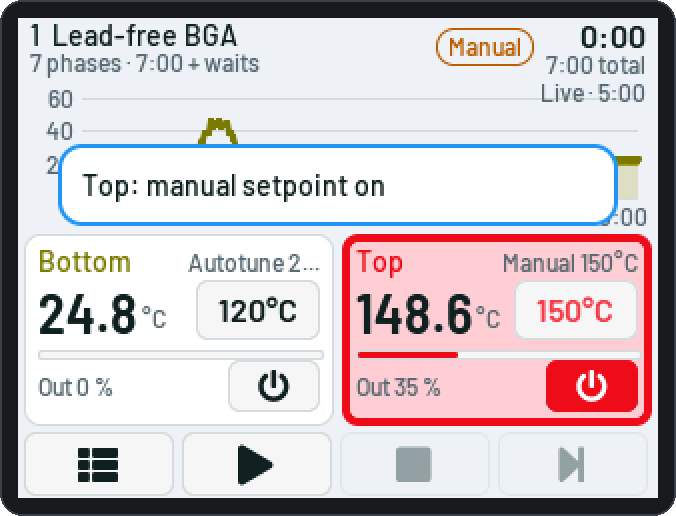
docs/wiki/img/touch/cyd-01b-tune-toast-light.png
