justr0st/TempCtl-Duo/hardware/cyd-schematic/TempCtl-Duo-CYD-A.kicad_sch

## KiCad design hardware/cyd-schematic/TempCtl-Duo-CYD-A.kicad_sch (2026-10-14)

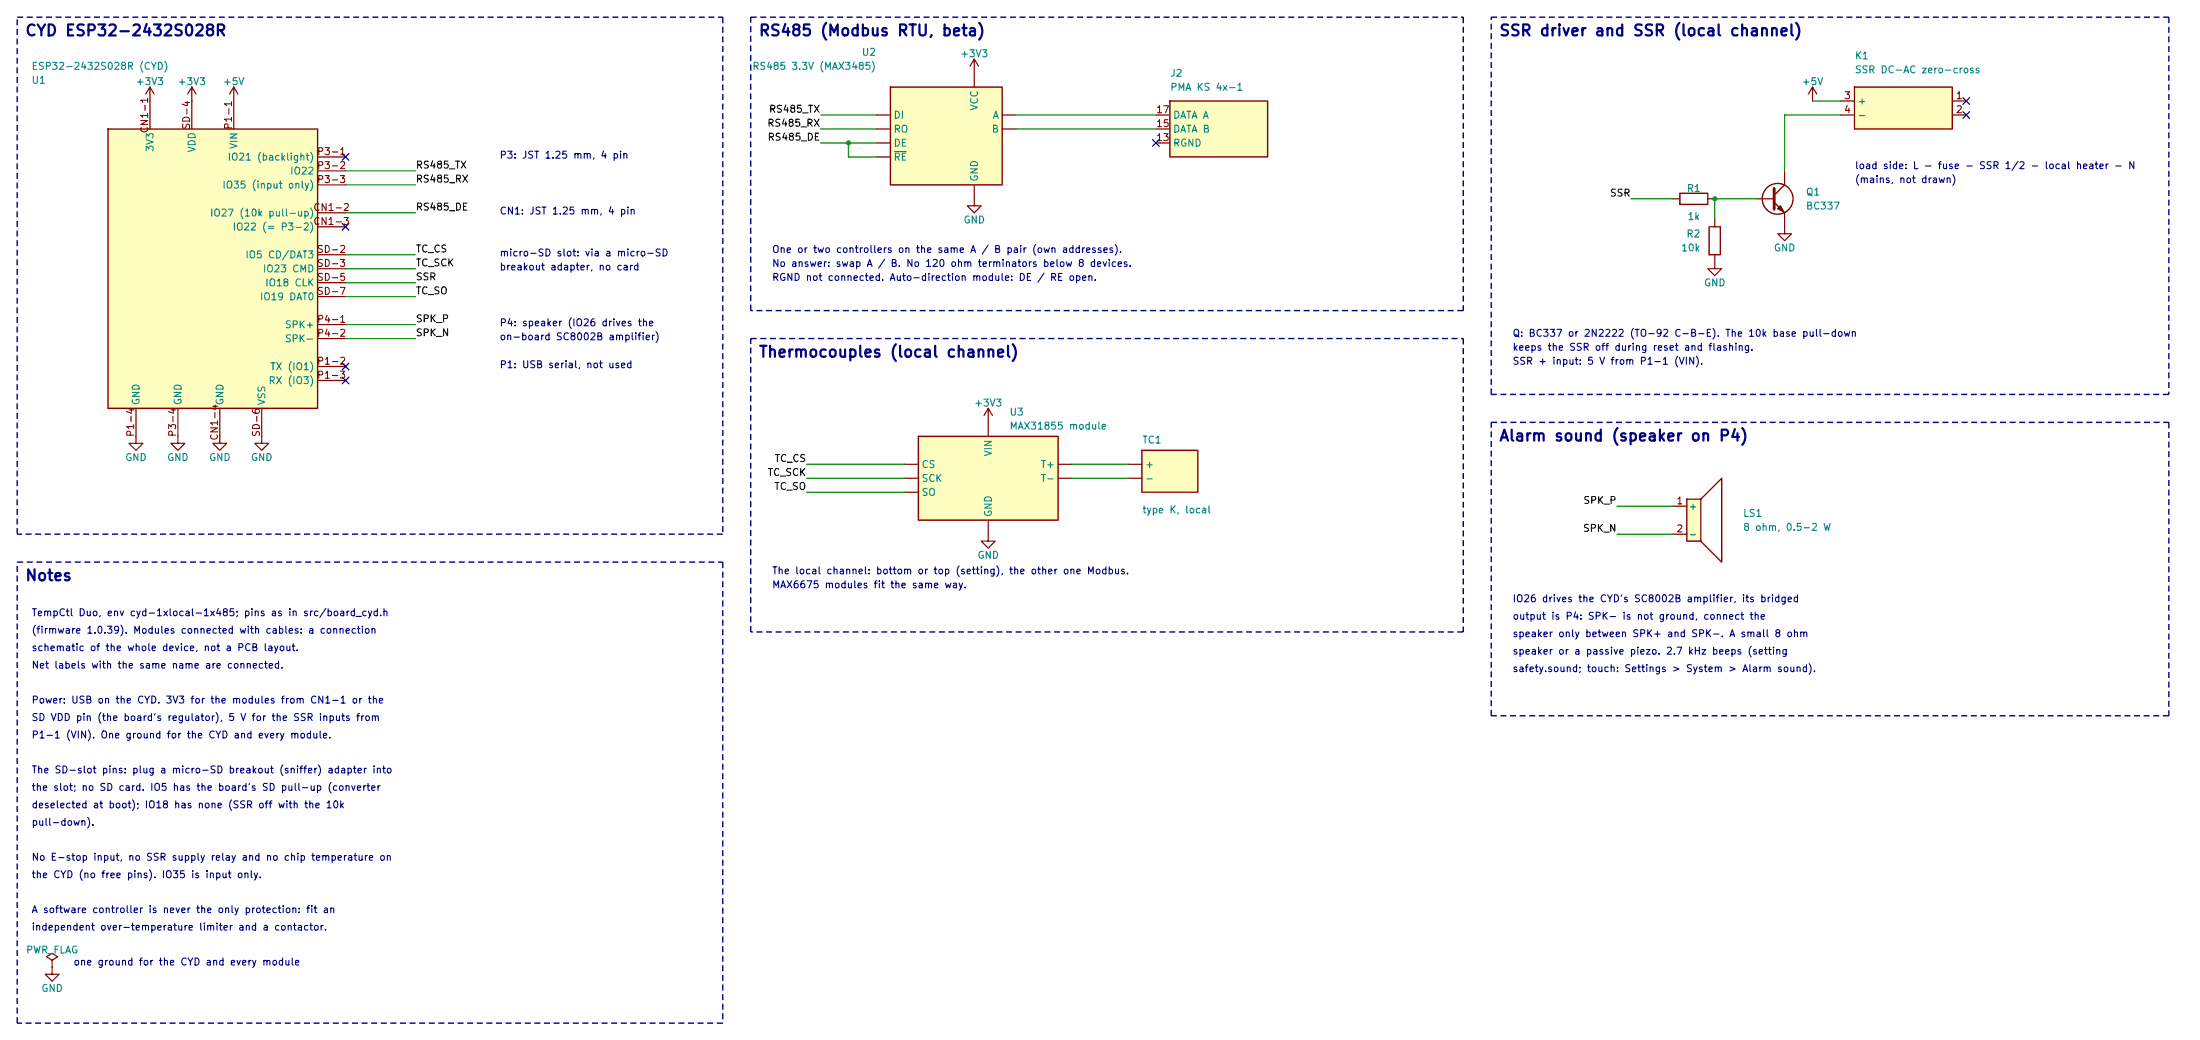
[picture p232: schematic TempCtl-Duo-CYD-A.kicad_sch]

Parts:
J2: PMA KS 4x-1
K1: SSR DC-AC zero-cross
LS1: 8 ohm, 0.5-2 W
Q1: BC337
R1: 1k
R2: 10k
TC1: type K, local
U1: ESP32-2432S028R (CYD)
U2: RS485 3.3V (MAX3485)
U3: MAX31855 module

Connections:
+3V3: U1.CN1-1 (3V3), U1.SD-4 (VDD), U2.5 (VCC), U3.1 (VIN)
+5V: K1.3 (+), U1.P1-1 (VIN)
GND: Q1.3 (E), R2.2, U1.CN1-4 (GND), U1.P1-4 (GND), U1.P3-4 (GND), U1.SD-6 (VSS), U2.8 (GND), U3.2 (GND)
unnamed: J2.15 (DATA B), U2.7 (B)
unnamed: J2.17 (DATA A), U2.6 (A)
unnamed: K1.4 (-), Q1.1 (C)
unnamed: Q1.2 (B), R1.2, R2.1
unnamed: TC1.1 (+), U3.6 (T+)
unnamed: TC1.2 (-), U3.7 (T-)
RS485_DE: U1.CN1-2 (IO27 (10k pull-up)), U2.3 (DE), U2.4 (~RE)
RS485_RX: U1.P3-3 (IO35 (input only)), U2.2 (RO)
RS485_TX: U1.P3-2 (IO22), U2.1 (DI)
SPK_N: LS1.2 (-), U1.P4-2 (SPK-)
SPK_P: LS1.1 (+), U1.P4-1 (SPK+)
SSR: R1.1, U1.SD-5 (IO18 CLK)
TC_CS: U1.SD-2 (IO5 CD/DAT3), U3.3 (CS)
TC_SCK: U1.SD-3 (IO23 CMD), U3.4 (SCK)
TC_SO: U1.SD-7 (IO19 DAT0), U3.5 (SO)

Notes on the sheet:
CYD ESP32-2432S028R
Notes
RS485 (Modbus RTU, beta)
Thermocouples (local channel)
SSR driver and SSR (local channel)
Alarm sound (speaker on P4)
P3: JST 1.25 mm, 4 pin
CN1: JST 1.25 mm, 4 pin
micro-SD slot: via a micro-SD
breakout adapter, no card
P4: speaker (IO26 drives the
on-board SC8002B amplifier)
P1: USB serial, not used
TempCtl Duo, env cyd-1xlocal-1x485; pins as in src/board_cyd.h
(firmware 1.0.39). Modules connected with cables: a connection
schematic of the whole device, not a PCB layout.
Net labels with the same name are connected.
Power: USB on the CYD. 3V3 for the modules from CN1-1 or the
SD VDD pin (the board's regulator), 5 V for the SSR inputs from
P1-1 (VIN). One ground for the CYD and every module.
The SD-slot pins: plug a micro-SD breakout (sniffer) adapter into
the slot; no SD card. IO5 has the board's SD pull-up (converter
deselected at boot); IO18 has none (SSR off with the 10k
pull-down).
No E-stop input, no SSR supply relay and no chip temperature on
the CYD (no free pins). IO35 is input only.
A software controller is never the only protection: fit an
independent over-temperature limiter and a contactor.
one ground for the CYD and every module
One or two controllers on the same A / B pair (own addresses).
No answer: swap A / B. No 120 ohm terminators below 8 devices.
RGND not connected. Auto-direction module: DE / RE open.
The local channel: bottom or top (setting), the other one Modbus.
MAX6675 modules fit the same way.
load side: L - fuse - SSR 1/2 - local heater - N
(mains, not drawn)
Q: BC337 or 2N2222 (TO-92 C-B-E). The 10k base pull-down
keeps the SSR off during reset and flashing.
SSR + input: 5 V from P1-1 (VIN).
IO26 drives the CYD's SC8002B amplifier, its bridged
output is P4: SPK- is not ground, connect the
speaker only between SPK+ and SPK-. A small 8 ohm
speaker or a passive piezo. 2.7 kHz beeps (setting
safety.sound; touch: Settings > System > Alarm sound).
