justr0st/TempCtl-Duo/hardware/cyd-schematic/TempCtl-Duo-CYD-B.kicad_sch

## KiCad design hardware/cyd-schematic/TempCtl-Duo-CYD-B.kicad_sch (2026-10-14)

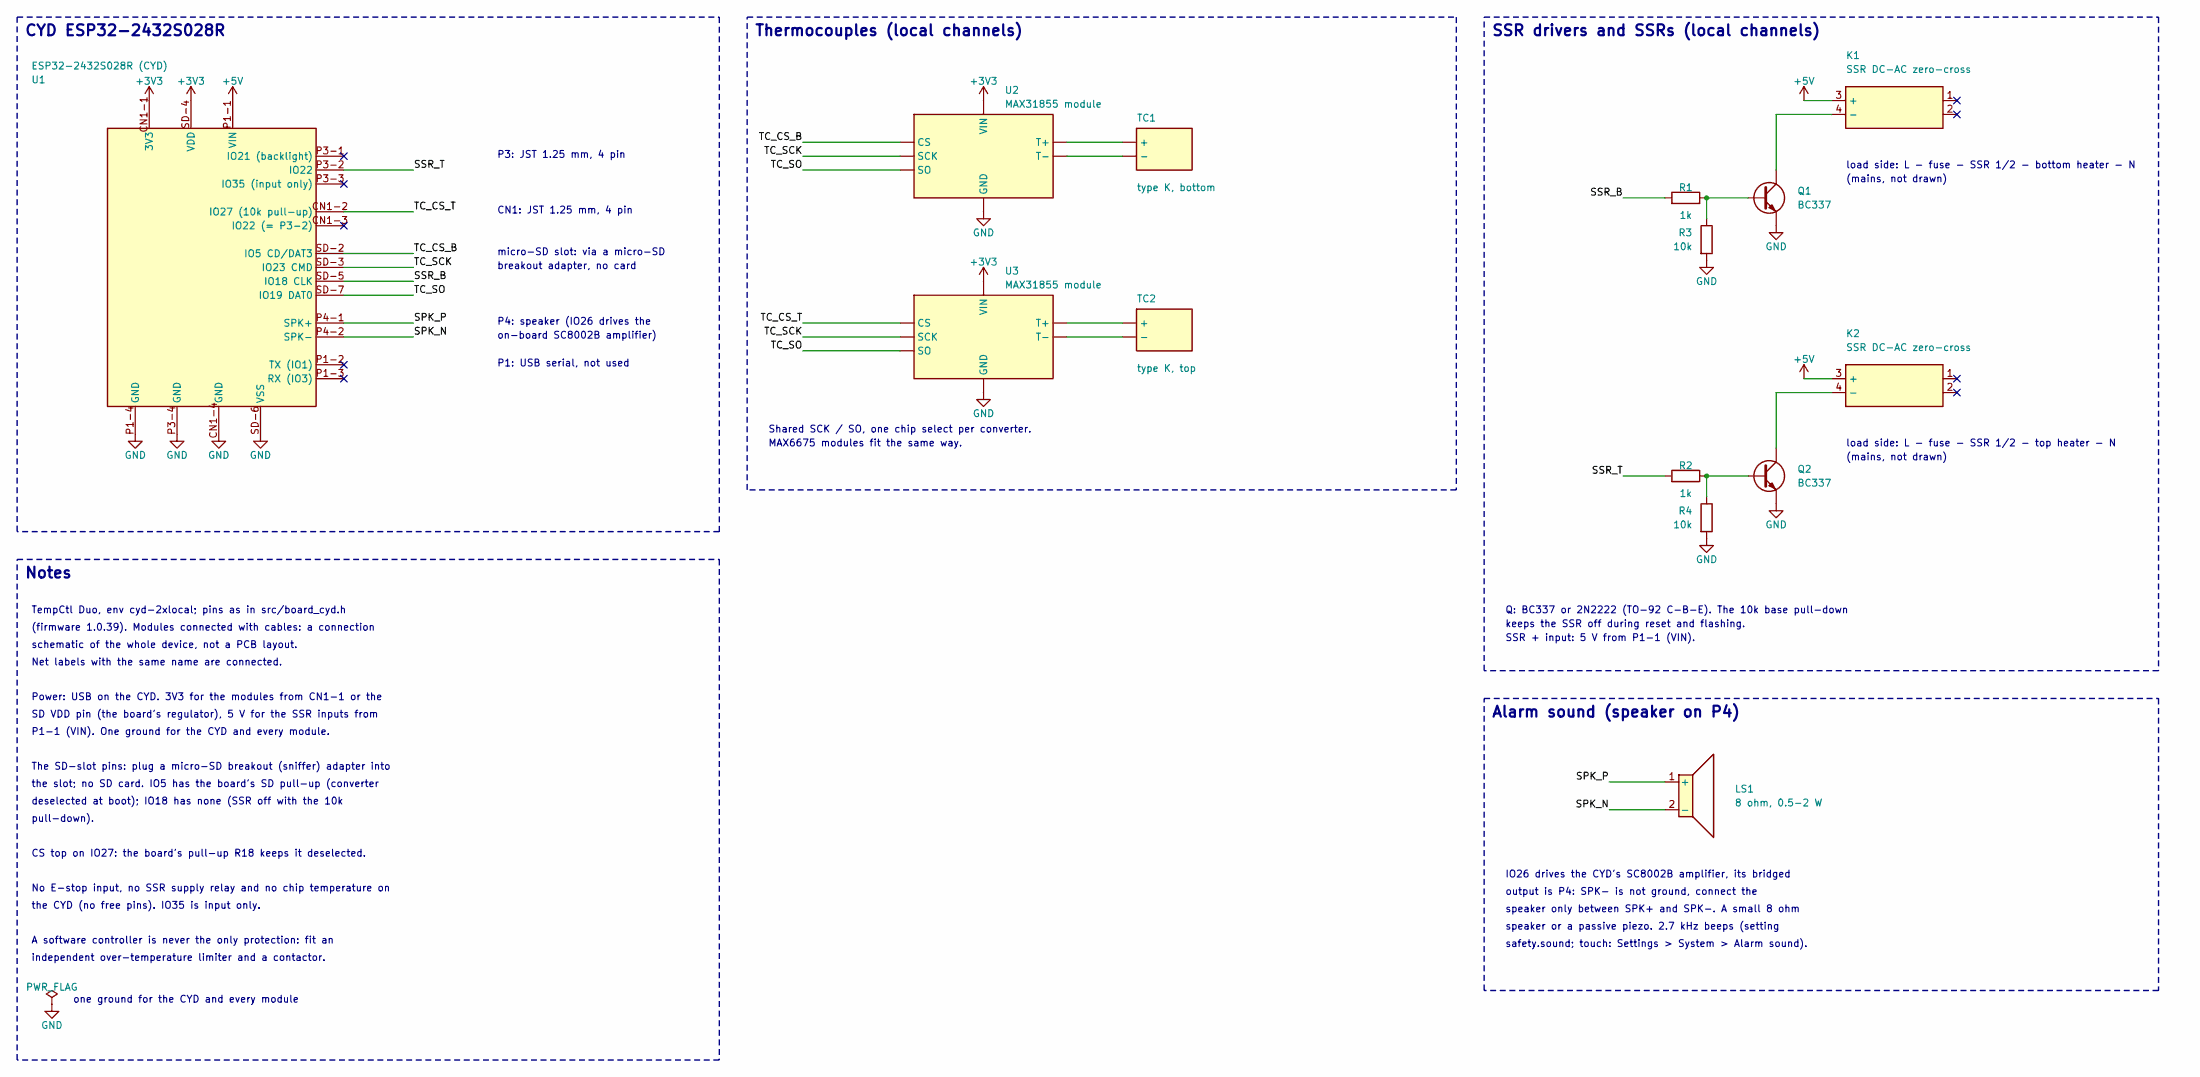
[picture p233: schematic TempCtl-Duo-CYD-B.kicad_sch]

Parts:
K1, K2: SSR DC-AC zero-cross
LS1: 8 ohm, 0.5-2 W
Q1, Q2: BC337
R1, R2: 1k
R3, R4: 10k
TC1: type K, bottom
TC2: type K, top
U1: ESP32-2432S028R (CYD)
U2, U3: MAX31855 module

Connections:
+3V3: U1.CN1-1 (3V3), U1.SD-4 (VDD), U2.1 (VIN), U3.1 (VIN)
+5V: K1.3 (+), K2.3 (+), U1.P1-1 (VIN)
GND: Q1.3 (E), Q2.3 (E), R3.2, R4.2, U1.CN1-4 (GND), U1.P1-4 (GND), U1.P3-4 (GND), U1.SD-6 (VSS), U2.2 (GND), U3.2 (GND)
unnamed: K1.4 (-), Q1.1 (C)
unnamed: K2.4 (-), Q2.1 (C)
unnamed: Q1.2 (B), R1.2, R3.1
unnamed: Q2.2 (B), R2.2, R4.1
unnamed: TC1.1 (+), U2.6 (T+)
unnamed: TC1.2 (-), U2.7 (T-)
unnamed: TC2.1 (+), U3.6 (T+)
unnamed: TC2.2 (-), U3.7 (T-)
SPK_N: LS1.2 (-), U1.P4-2 (SPK-)
SPK_P: LS1.1 (+), U1.P4-1 (SPK+)
SSR_B: R1.1, U1.SD-5 (IO18 CLK)
SSR_T: R2.1, U1.P3-2 (IO22)
TC_CS_B: U1.SD-2 (IO5 CD/DAT3), U2.3 (CS)
TC_CS_T: U1.CN1-2 (IO27 (10k pull-up)), U3.3 (CS)
TC_SCK: U1.SD-3 (IO23 CMD), U2.4 (SCK), U3.4 (SCK)
TC_SO: U1.SD-7 (IO19 DAT0), U2.5 (SO), U3.5 (SO)

Notes on the sheet:
CYD ESP32-2432S028R
Notes
Thermocouples (local channels)
SSR drivers and SSRs (local channels)
Alarm sound (speaker on P4)
P3: JST 1.25 mm, 4 pin
CN1: JST 1.25 mm, 4 pin
micro-SD slot: via a micro-SD
breakout adapter, no card
P4: speaker (IO26 drives the
on-board SC8002B amplifier)
P1: USB serial, not used
TempCtl Duo, env cyd-2xlocal; pins as in src/board_cyd.h
(firmware 1.0.39). Modules connected with cables: a connection
schematic of the whole device, not a PCB layout.
Net labels with the same name are connected.
Power: USB on the CYD. 3V3 for the modules from CN1-1 or the
SD VDD pin (the board's regulator), 5 V for the SSR inputs from
P1-1 (VIN). One ground for the CYD and every module.
The SD-slot pins: plug a micro-SD breakout (sniffer) adapter into
the slot; no SD card. IO5 has the board's SD pull-up (converter
deselected at boot); IO18 has none (SSR off with the 10k
pull-down).
CS top on IO27: the board's pull-up R18 keeps it deselected.
No E-stop input, no SSR supply relay and no chip temperature on
the CYD (no free pins). IO35 is input only.
A software controller is never the only protection: fit an
independent over-temperature limiter and a contactor.
one ground for the CYD and every module
Shared SCK / SO, one chip select per converter.
MAX6675 modules fit the same way.
load side: L - fuse - SSR 1/2 - bottom heater - N
(mains, not drawn)
load side: L - fuse - SSR 1/2 - top heater - N
Q: BC337 or 2N2222 (TO-92 C-B-E). The 10k base pull-down
keeps the SSR off during reset and flashing.
SSR + input: 5 V from P1-1 (VIN).
IO26 drives the CYD's SC8002B amplifier, its bridged
output is P4: SPK- is not ground, connect the
speaker only between SPK+ and SPK-. A small 8 ohm
speaker or a passive piezo. 2.7 kHz beeps (setting
safety.sound; touch: Settings > System > Alarm sound).
