justr0st/TempCtl-Duo/hardware/s3-schematic/TempCtl-Duo-S3.kicad_sch

## KiCad design hardware/s3-schematic/TempCtl-Duo-S3.kicad_sch (2026-10-14)

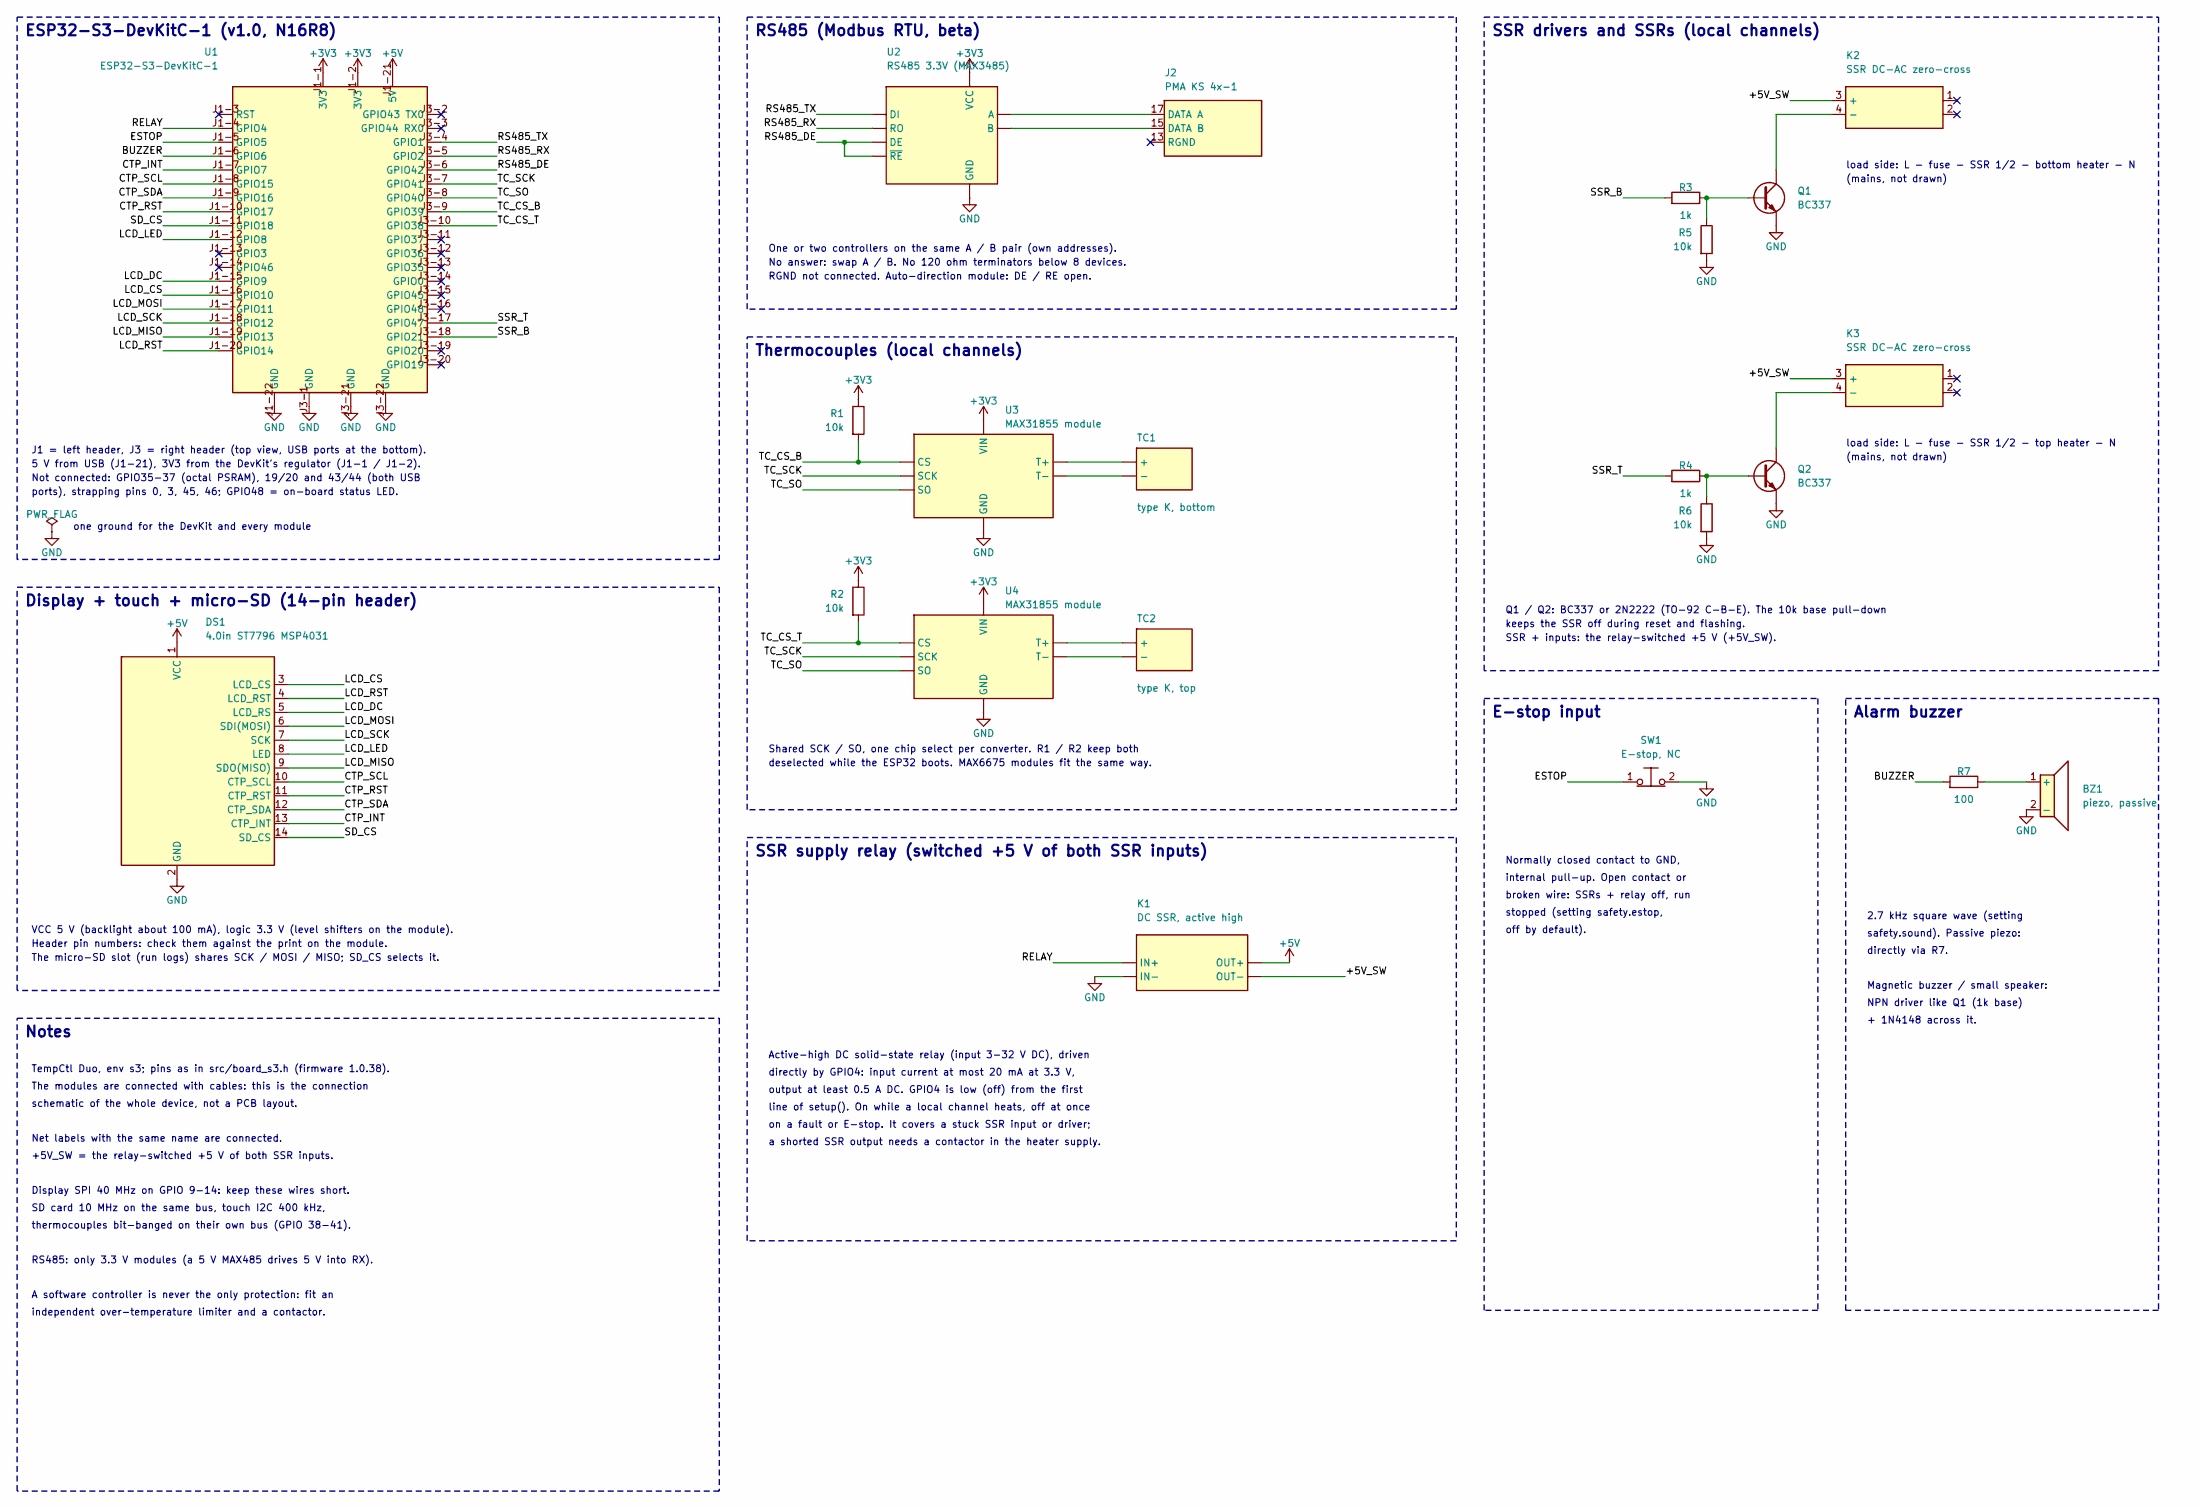
[picture p235: schematic TempCtl-Duo-S3.kicad_sch]

Parts:
BZ1: piezo, passive
DS1: 4.0in ST7796 MSP4031
J2: PMA KS 4x-1
K1: DC SSR, active high
K2, K3: SSR DC-AC zero-cross
Q1, Q2: BC337
R1, R2, R5, R6: 10k
R3, R4: 1k
R7: 100
SW1: E-stop, NC
TC1: type K, bottom
TC2: type K, top
U1: ESP32-S3-DevKitC-1
U2: RS485 3.3V (MAX3485)
U3, U4: MAX31855 module

Connections:
+3V3: R1.1, R2.1, U1.J1-1 (3V3), U1.J1-2 (3V3), U2.5 (VCC), U3.1 (VIN), U4.1 (VIN)
+5V: DS1.1 (VCC), K1.1 (OUT+), U1.J1-21 (5V)
+5V_SW: K1.2 (OUT-), K2.3 (+), K3.3 (+)
BUZZER: R7.1, U1.J1-6 (GPIO6)
CTP_INT: DS1.13 (CTP_INT), U1.J1-7 (GPIO7)
CTP_RST: DS1.11 (CTP_RST), U1.J1-10 (GPIO17)
CTP_SCL: DS1.10 (CTP_SCL), U1.J1-8 (GPIO15)
CTP_SDA: DS1.12 (CTP_SDA), U1.J1-9 (GPIO16)
ESTOP: SW1.1, U1.J1-5 (GPIO5)
GND: BZ1.2 (-), DS1.2 (GND), K1.4 (IN-), Q1.3 (E), Q2.3 (E), R5.2, R6.2, SW1.2, U1.J1-22 (GND), U1.J3-1 (GND), U1.J3-21 (GND), U1.J3-22 (GND), U2.8 (GND), U3.2 (GND), U4.2 (GND)
LCD_CS: DS1.3 (LCD_CS), U1.J1-16 (GPIO10)
LCD_DC: DS1.5 (LCD_RS), U1.J1-15 (GPIO9)
LCD_LED: DS1.8 (LED), U1.J1-12 (GPIO8)
LCD_MISO: DS1.9 (SDO(MISO)), U1.J1-19 (GPIO13)
LCD_MOSI: DS1.6 (SDI(MOSI)), U1.J1-17 (GPIO11)
LCD_RST: DS1.4 (LCD_RST), U1.J1-20 (GPIO14)
LCD_SCK: DS1.7 (SCK), U1.J1-18 (GPIO12)
unnamed: BZ1.1 (+), R7.2
unnamed: J2.15 (DATA B), U2.7 (B)
unnamed: J2.17 (DATA A), U2.6 (A)
unnamed: K2.4 (-), Q1.1 (C)
unnamed: K3.4 (-), Q2.1 (C)
unnamed: Q1.2 (B), R3.2, R5.1
unnamed: Q2.2 (B), R4.2, R6.1
unnamed: TC1.1 (+), U3.6 (T+)
unnamed: TC1.2 (-), U3.7 (T-)
unnamed: TC2.1 (+), U4.6 (T+)
unnamed: TC2.2 (-), U4.7 (T-)
RELAY: K1.3 (IN+), U1.J1-4 (GPIO4)
RS485_DE: U1.J3-6 (GPIO42), U2.3 (DE), U2.4 (~RE)
RS485_RX: U1.J3-5 (GPIO2), U2.2 (RO)
RS485_TX: U1.J3-4 (GPIO1), U2.1 (DI)
SD_CS: DS1.14 (SD_CS), U1.J1-11 (GPIO18)
SSR_B: R3.1, U1.J3-18 (GPIO21)
SSR_T: R4.1, U1.J3-17 (GPIO47)
TC_CS_B: R1.2, U1.J3-9 (GPIO39), U3.3 (CS)
TC_CS_T: R2.2, U1.J3-10 (GPIO38), U4.3 (CS)
TC_SCK: U1.J3-7 (GPIO41), U3.4 (SCK), U4.4 (SCK)
TC_SO: U1.J3-8 (GPIO40), U3.5 (SO), U4.5 (SO)

Notes on the sheet:
ESP32-S3-DevKitC-1 (v1.0, N16R8)
Display + touch + micro-SD (14-pin header)
Notes
RS485 (Modbus RTU, beta)
Thermocouples (local channels)
SSR supply relay (switched +5 V of both SSR inputs)
SSR drivers and SSRs (local channels)
E-stop input
Alarm buzzer
J1 = left header, J3 = right header (top view, USB ports at the bottom).
5 V from USB (J1-21), 3V3 from the DevKit's regulator (J1-1 / J1-2).
Not connected: GPIO35-37 (octal PSRAM), 19/20 and 43/44 (both USB
ports), strapping pins 0, 3, 45, 46; GPIO48 = on-board status LED.
one ground for the DevKit and every module
VCC 5 V (backlight about 100 mA), logic 3.3 V (level shifters on the module).
Header pin numbers: check them against the print on the module.
The micro-SD slot (run logs) shares SCK / MOSI / MISO; SD_CS selects it.
TempCtl Duo, env s3; pins as in src/board_s3.h (firmware 1.0.38).
The modules are connected with cables: this is the connection
schematic of the whole device, not a PCB layout.
Net labels with the same name are connected.
+5V_SW = the relay-switched +5 V of both SSR inputs.
Display SPI 40 MHz on GPIO 9-14: keep these wires short.
SD card 10 MHz on the same bus, touch I2C 400 kHz,
thermocouples bit-banged on their own bus (GPIO 38-41).
RS485: only 3.3 V modules (a 5 V MAX485 drives 5 V into RX).
A software controller is never the only protection: fit an
independent over-temperature limiter and a contactor.
One or two controllers on the same A / B pair (own addresses).
No answer: swap A / B. No 120 ohm terminators below 8 devices.
RGND not connected. Auto-direction module: DE / RE open.
Shared SCK / SO, one chip select per converter. R1 / R2 keep both
deselected while the ESP32 boots. MAX6675 modules fit the same way.
Active-high DC solid-state relay (input 3-32 V DC), driven
directly by GPIO4: input current at most 20 mA at 3.3 V,
output at least 0.5 A DC. GPIO4 is low (off) from the first
line of setup(). On while a local channel heats, off at once
on a fault or E-stop. It covers a stuck SSR input or driver;
a shorted SSR output needs a contactor in the heater supply.
load side: L - fuse - SSR 1/2 - bottom heater - N
(mains, not drawn)
load side: L - fuse - SSR 1/2 - top heater - N
Q1 / Q2: BC337 or 2N2222 (TO-92 C-B-E). The 10k base pull-down
keeps the SSR off during reset and flashing.
SSR + inputs: the relay-switched +5 V (+5V_SW).
Normally closed contact to GND,
internal pull-up. Open contact or
broken wire: SSRs + relay off, run
stopped (setting safety.estop,
off by default).
2.7 kHz square wave (setting
safety.sound). Passive piezo:
directly via R7.
Magnetic buzzer / small speaker:
NPN driver like Q1 (1k base)
+ 1N4148 across it.
