justr0st/TempCtl-Duo/src/app_state.h

// Shared state between the control task (channels + run engine), the LVGL
// UI and the web server. Everything in here is protected by gLock.
#pragma once
#include <Arduino.h>
#include <new>
#include "config.h"
#include "channel.h"
#include "duo_program.h"
#include "run_engine.h"
#include "program_store.h"
#include "settings.h"
#include "syslog.h"

// The channel the run engine's Sequence and the old /api/status flat fields refer to (the bottom).
// Both channels are in LiveData::ch, the run in the run fields.
constexpr int ENGINE_CH = CH_BOTTOM;
// Chart history rows: the channels, plus the monitor channel (a third thermocouple, shown and logged only)
// on boards that have it (HAS_MONITOR); CH_MON is its index there.
constexpr int HIST_CH = NUM_CHANNELS + HAS_MONITOR;
constexpr int CH_MON = NUM_CHANNELS;

// Published values of the monitor channel (LiveData::mon)
struct MonLive {
  bool on;                  // switched on in the settings (and the board has it)
  char name[CH_NAME_LEN];
  bool valid;               // a current reading
  float pv, rawC, coldC;    // calibrated, before calibration, cold junction (MAX31855)
  uint8_t tcFault;          // TcFault of the last reading
};

struct LiveData {
  ChannelLive ch[NUM_CHANNELS];
  MonLive mon;        // monitor channel (HAS_MONITOR; else always off)
  // ---- run (both channels) ----
  RunState state;
  uint8_t progType;   // PROG_SEQ / PROG_TL of the running / last program
  int8_t runProg;     // slot of the running / last program, -1 = none
  char runName[PROG_NAME_LEN];
  StageInfo seq;                    // Sequence: phase + stage
  StageInfo lane[NUM_CHANNELS];     // Timeline: step + stage per channel
  uint16_t phases;                  // Sequence: number of phases
  uint16_t steps[NUM_CHANNELS];     // Timeline: steps per channel
  bool waiting;       // waiting for the bottom to reach its target
  bool progPause;     // Pause phase / step: waiting for Continue
  bool pauseMsg;      // ... with "Action required"
  char pauseText[PROG_TEXT_LEN];
  bool runEdited;     // the running copy has unsaved run edits
  float elapsed;      // run time (s)
  float remaining;    // forecast (s), waits and pauses not counted
  ChOut run[NUM_CHANNELS];          // what the run does with each channel
  uint8_t chSt[NUM_CHANNELS];       // ChState
  bool canExt[NUM_CHANNELS];        // a hold of this channel is running ("Extend hold")
  int16_t kept[NUM_CHANNELS];       // phase/step whose target the channel has (-1 none)
  bool spSyncedCh[NUM_CHANNELS];    // last setpoint write succeeded
  uint32_t spWritesCh[NUM_CHANNELS];

  char runMsg[128];

  // ---- "Run interrupted by a reset" offer (spec 9.3.5); the program is runProg / runName ----
  bool intrValid;
  bool intrExact;     // exact position (RTC memory) - else as of the last phase / step change or minute
  RunPos intrPos;
  char intrReason[20];

  // safety (spec 9.2a)
  bool estop;         // E-stop active (outputs forced off)
  bool estopRaw;      // E-stop contact open (also when the input is not enabled)
  float chipC;        // S3 chip temperature, NAN unknown
  bool chipHot;       // above the warning limit
  bool soundMuted;    // the current alarm was silenced

  // cooling fan (spec 9.25, fan.h)
  bool fanWired;      // an optional pin is the fan output (on / off or PWM)
  bool fanOn;         // switched on (a phase asks for it, cooling after a run)
  int16_t fanRpm;     // speed, -1 = no tach pin
};

// Report of the last program run (run_stats.h): index 0 bottom, 1 top, 2 the monitor channel. NaN = not
// measured. A resumed run's report covers only the part after the resume.
struct RunReport {
  bool valid;      // a run has ended since the boot (cleared when a new run starts)
  bool finished;   // true: to its end; false: stopped (user, fault)
  char name[PROG_NAME_LEN];
  float dur;       // run time at the end (s)
  float peak[3], peakT[3];  // highest PV (degC) and the run time it happened (s)
  float dev[2];    // largest |PV - SP| in the holds (from 5 s into each hold), degC
  float rate[2];   // steepest rise over 5 s, degC/s
};
bool runReportGet(RunReport& out);  // copy under gLock (takes it itself); false (out.valid false) if none

// m:ss of a run time
inline void reportMmss(char* b, size_t n, float t) {
  const int s = t > 0 ? (int)t : 0;
  snprintf(b, n, "%d:%02d", s / 60, s % 60);
}

// "<name> peak 162.3 °C at 3:10, hold ±1.8 °C, max 1.9 °C/s" (parts that were not measured left out; i = 0, 1 the
// channels, 2 the monitor channel which has only the peak); "" if the channel measured nothing
inline void reportPart(char* b, size_t n, const char* name, const RunReport& r, int i) {
  b[0] = 0;
  if (isnan(r.peak[i])) return;
  char tm[12];
  reportMmss(tm, sizeof(tm), r.peakT[i]);
  int k = snprintf(b, n, "%s peak %.1f \xC2\xB0" "C at %s", name, r.peak[i], tm);
  if (i < NUM_CHANNELS && !isnan(r.dev[i]) && k > 0 && (size_t)k < n)
    k += snprintf(b + k, n - k, ", hold \xC2\xB1%.1f \xC2\xB0" "C", r.dev[i]);
  if (i < NUM_CHANNELS && !isnan(r.rate[i]) && k > 0 && (size_t)k < n)
    snprintf(b + k, n - k, ", max %.1f \xC2\xB0" "C/s", r.rate[i]);
}

// The report as lines separated by '\n' (touch dialog, serial console): the run, then a line per channel that
// measured something; mon = the monitor channel's name or nullptr
inline void reportText(char* b, size_t n, const RunReport& r, const char* n0, const char* n1, const char* mon) {
  char tm[12];
  reportMmss(tm, sizeof(tm), r.dur);
  int k = snprintf(b, n, "\"%s\" %s after %s", r.name, r.finished ? "finished" : "stopped", tm);
  for (int i = 0; i < (mon ? 3 : 2); ++i) {
    char p[128];
    reportPart(p, sizeof(p), i == 0 ? n0 : i == 1 ? n1 : mon, r, i);
    if (p[0] && k > 0 && (size_t)k < n) k += snprintf(b + k, n - k, "\n%s", p);
  }
}

constexpr float START_WARN_BAND = 10;  // start warning: PV within this of (or above) the first target

constexpr int RUN_EV_MAX = 400;

// Event log (web, serial, touch): the last LOG_N messages; also in the system log (syslog.h) and saved
// to flash from there
#ifdef BOARD_HAS_PSRAM
constexpr int LOG_N = 48;
#else
constexpr int LOG_N = 32;  // CYD: DRAM is short
#endif
constexpr size_t LOG_LEN = 120;
struct LogEntry {
  uint32_t seq;
  uint32_t upSec;   // uptime
  uint32_t epoch;   // UTC seconds, 0 = the clock was not known yet
  float runT;       // run time, NaN outside a run
  uint8_t kind;     // LogKind (syslog.h): event, run, warning, error
  char msg[LOG_LEN];
};
// any task; the kind comes from the words (errors, warnings), else "event" / "run"
// The kind is given by the caller (the colour in the logs), not guessed from the text
void logEvent(const char* fmt, ...) __attribute__((format(printf, 1, 2)));
void logRun(const char* fmt, ...) __attribute__((format(printf, 1, 2)));  // run records (start, phases, end)
void logWarn(const char* fmt, ...) __attribute__((format(printf, 1, 2)));
void logError(const char* fmt, ...) __attribute__((format(printf, 1, 2)));
void logKind(LogKind k, const char* fmt, ...) __attribute__((format(printf, 2, 3)));
// warning / error by the words of the text, else def: only for texts without user names (reset reasons)
void logAuto(LogKind def, const char* fmt, ...) __attribute__((format(printf, 2, 3)));
uint32_t logSeq();                                        // newest entry
int logSince(uint32_t seq, LogEntry* out, int max);       // entries after seq, oldest first

// Chart value in 0.1 degC, assigned / read as float; NaN (no value) = the type's minimum.
// Tenth (32 bit) is only ever accessed as a whole word, so the chart history can live in the
// ESP32's IRAM heap (32-bit access only) on the CYD, which has no PSRAM and little DRAM left.
// Tenth16 halves the RAM of the touch chart's copy (DRAM).
struct Tenth {
  int32_t v;
  Tenth& operator=(float f) {
    v = (isnan(f) || f > 3.0e5f || f < -3.0e5f) ? INT32_MIN : (int32_t)lroundf(f * 10.0f);
    return *this;
  }
  operator float() const { return v == INT32_MIN ? NAN : v * 0.1f; }
};
struct Tenth16 {
  int16_t v;
  Tenth16& operator=(float f) {
    v = (isnan(f) || f > 3276.0f || f < -3276.0f) ? (int16_t)INT16_MIN : (int16_t)lroundf(f * 10.0f);
    return *this;
  }
  operator float() const { return v == INT16_MIN ? NAN : v * 0.1f; }
};
typedef Tenth TenthRow[CHART_N];

// Chart history, both channels.
struct History {
  // Live history: a ring of liveCap slots (one per LIVE_SAMPLE_SEC, 3 words each, see
  // SLOT_W in app_internal.h); slot s (counted since boot) is at s % liveCap.
  uint32_t* liveRing;
  uint32_t liveCap, liveTotal;
  // The live view: CHART_N bins of the ring (rebuilt on demand, liveView()), newest at the end.
  // (the value arrays are pointers into one block, see appInit(): IRAM on the CYD)
  TenthRow *livePv, *liveSp;  // [NUM_CHANNELS]; PV = the last reading of the bin
  TenthRow *liveLo, *liveHi;  // lowest / highest PV reading within each bin (every poll counts)
  // Current / last program run: run time 0..runSpan in CHART_N bins (the
  // span doubles when the run gets longer than planned).
  bool runValid;
  float runBin, runSpan;
  TenthRow *runPv, *runSp;
  TenthRow *runLo, *runHi;    // lowest / highest PV reading within each run bin
  // run's program curve: its setpoints so far + the forecast (kept after the run for the CSV)
  TenthRow* runPlan;
  float runTotal;     // elapsed + remaining
  char runName[PROG_NAME_LEN];
  char runSt[NUM_CHANNELS][CHART_N];  // channel state per bin (chart lanes): "-orhwjkxpd" = ChState, 'm' manual, ' ' none
  int16_t runStLast;
  PlanEv runEv[RUN_EV_MAX];           // phase starts, hold ends, pauses, end (t = run time)
  uint16_t runEvN;
  uint32_t runGen;                    // changes when a new run starts
  // preview of the selected program on its own time axis (no run active)
  TenthRow* plan;
  float planBin, planSpan, planTotal;
  char planName[PROG_NAME_LEN];
};

// What the chart shows (touch screen and web use the same data).
struct ChartData {
  bool run;             // true: program timeline, false: rolling live window
  bool planActive;      // program running/paused -> solid, else broken line
  bool spActive;        // setpoint driven (program or manual on) -> solid
  float binSec;         // x axis seconds per point
  float span;           // seconds covered by the x axis
  float planSpan;       // seconds covered by the program curve (preview has its own)
  float planTotal;      // program duration (run: elapsed + remaining)
  float elapsed;        // run: program time
  char progName[PROG_NAME_LEN];
  Tenth16 pv[CHART_N], sp[CHART_N], plan[CHART_N];     // bottom (ENGINE_CH)
  Tenth16 pvT[CHART_N], spT[CHART_N], planT[CHART_N];  // top
#ifdef CHART_LOHI
  Tenth16 lo[CHART_N], hi[CHART_N], loT[CHART_N], hiT[CHART_N];  // lowest / highest PV within each point
#endif
};

enum CmdType : uint8_t {
  CMD_START,        // arg = program slot (-1 = selected program), sub 1 = the draft from startDraft()
  CMD_PAUSE,
  CMD_RESUME,
  CMD_STOP,
  CMD_NEXT,         // "Next phase" (Sequence); Continue in a program pause
  CMD_CONTINUE,     // Continue after a Pause phase / step
  CMD_SETTINGS_CHANGED,
  CMD_MANUAL_ON,    // arg = channel
  CMD_MANUAL_OFF,   // arg = channel
  CMD_MANUAL_SP,    // arg = channel, value = new manual setpoint
  CMD_ACK_FAULT,    // arg = channel: acknowledge a latched fault
  CMD_TUNE_START,   // arg = channel (local), value = test temperature
  CMD_TUNE_STOP,    // arg = channel
  CMD_RUN_EDIT,     // sub = RunEdit, arg = channel, idx = phase/step (-1 current), value
  CMD_SAVE_RUN,     // store the running copy (with its run edits) into its slot
  CMD_DISCARD_RUN,  // keep the stored program (the run edits are dropped): the question is answered
  CMD_RUN_RECOVER,  // "Resume from the interrupted phase" (run interrupted by a reset)
  CMD_RUN_DISMISS,  // dismiss the interrupted run
};

enum RunEdit : uint8_t {
  EDIT_HOLD,        // value = hold seconds
  EDIT_EXTEND,      // value = seconds added to the current hold (may be negative)
  EDIT_RAMP,        // value = ramp seconds (later ramps only)
  EDIT_TARGET,      // value = degC
};

struct Cmd {
  CmdType type;
  uint8_t sub;
  int16_t arg;
  int16_t idx;
  float value;
};

enum BusOp : uint8_t { BUS_READ, BUS_WRITE, BUS_FINDSP };

struct BusRequest {
  BusOp op;
  uint8_t ch;        // channel whose controller (address, register map) is used
  uint8_t fn;        // 0 = default from settings
  uint16_t addr;
  uint16_t count;    // read
  int16_t value;     // write (raw)
  uint16_t from, to; // findsp
  // results
  bool ok;
  char err[80];
  uint16_t n;
  int16_t values[64];     // read values or found addresses (cast)
  float refValue;         // findsp: SP.EF used as reference
};

extern Settings gSettings;
extern LiveData gLive;
extern History* gHist;       // heap-allocated in appInit()
extern SemaphoreHandle_t gLock;

struct Guard {
  Guard() { xSemaphoreTake(gLock, portMAX_DELAY); }
  ~Guard() { xSemaphoreGive(gLock); }
};

void appInit();                  // create locks/queues, load settings and programs
void controlTaskStart();
void controlTaskBegin();  // (the task's start and one 10 ms pass: the browser demo runs them itself)
void controlTaskStep();
// Restart on request (touch, web): noted in RTC memory (the next boot logs "restart from ..."),
// local outputs off, then the main loop restarts once the display has finished drawing.
void appRequestRestart(const char* from);
bool appRestartPending();
uint32_t controlCycles();  // control cycles since the start (alive check: firmware update probation)
unsigned controlTaskStackFree();  // bytes of the control task's stack never used so far
bool sendCmd(CmdType c, int arg = 0, float value = 0, int idx = -1, uint8_t sub = 0);
bool busRequest(BusRequest& r, uint32_t timeoutMs = 20000);  // blocks until done
// The same without waiting (loop task): busStart() hands the request over (false: another one runs);
// busCheck() is 0 while it runs, then 1 with the answer in r (r.ok; r.err also after timeoutMs), -1 if
// none was started
bool busStart(const BusRequest& r, uint32_t timeoutMs);
int busCheck(BusRequest& r);
void saveSettingsAndNotify();    // persist gSettings and tell the control task (reopens the link)
void saveSettingsQuiet();        // persist gSettings only (display, selection, manual SP)
// A temporary program buffer (≈ 3.9 kB, heap) for the loop task (UI, web), freed at the end of the scope
struct ScratchProg {
  DuoProgram* p;
  ScratchProg() : p((DuoProgram*)malloc(sizeof(DuoProgram))) {}
  ~ScratchProg() { free(p); }
  ScratchProg(const ScratchProg&) = delete;
  ScratchProg& operator=(const ScratchProg&) = delete;
  explicit operator bool() const { return p != nullptr; }
  DuoProgram& operator*() { return *p; }
};
// A Settings copy on the heap for the time it is used (instead of a static or stack copy: the struct is
// large and the CYD has little RAM). Check it like ScratchProg.
struct ScratchSettings {
  Settings* p;
  ScratchSettings() : p((Settings*)malloc(sizeof(Settings))) {
    if (p) new (p) Settings();
  }
  ~ScratchSettings() { free(p); }
  ScratchSettings(const ScratchSettings&) = delete;
  ScratchSettings& operator=(const ScratchSettings&) = delete;
  explicit operator bool() const { return p != nullptr; }
  Settings& operator*() { return *p; }
  Settings* operator->() { return p; }
};
// "Start without saving" (web): starts program slot idx with this content instead of the stored one
bool startDraft(int idx, const DuoProgram& p);
// Running copy of the program as JSON (under gLock); false if there was no run
bool runProgramJson(JsonObject o);
bool runProgramCopy(DuoProgram& out);  // the running copy (false if there was no run)
void selectProgram(int idx);     // select + persist
void setManualSp(float v, int ch = ENGINE_CH);  // clamp, persist and send to the control task
float runSpanFor(float total);   // x axis length for a program: total + spare
void chartSnapshot(ChartData& d, bool live = false);  // live: the live view even during a run
// Live history as CSV: rows from slot `from` (counted since boot; the oldest kept slot if older) on,
// as many as fit into buf. Returns the length (0 = done) and the next slot in `from`.
// pvMask / spMask: channels (bit 0 bottom, bit 1 top; pvMask bit 2 the monitor channel, HAS_MONITOR) whose PV
// (+ lowest, highest) / setpoint are written
size_t liveCsv(uint32_t& from, char* buf, size_t n, uint8_t pvMask = 3, uint8_t spMask = 3);
// Every PV reading (raw_hist.h) for GET /api/raw: rawPlan() picks the readings after `after[ch]` (millis,
// HIST_CH: the monitor last), at most winMs old and maxN per channel (under gLock); rawCopy() then copies them.
struct RawPlan {
  uint32_t nowMs;
  uint32_t from[HIST_CH], n[HIST_CH];  // the channels, then the monitor (HIST_CH)
};
void rawPlan(const uint32_t* after, uint32_t winMs, uint32_t maxN, RawPlan& p);
uint32_t rawCopy(int ch, uint32_t k, uint32_t n, uint8_t* out);
uint32_t rawCap();  // readings kept per channel (0: none)
uint32_t liveHistSec();          // seconds the live history can hold
// Live chart periods (minutes) to choose from, up to what the history holds; the one in effect:
// display.liveMin, at most the longest that fits (both under gLock / from the UI task)
constexpr int LIVE_PERIODS_N = 11;
extern const uint16_t LIVE_PERIODS[LIVE_PERIODS_N];
uint32_t liveMinEff();
uint32_t iramPureFree();         // free IRAM-only heap (32-bit access only, not usable as DRAM)
// /api/chart: v = "run" (current / last run with its forecast) or "live" (rolling window)
bool chartJson(String& out, bool run);  // false: out of memory
