justr0st/TempCtl-Duo/src/controller.h

#pragma once
#include "modbus_rtu.h"
#include "settings.h"

// Raw special values defined by PMA (also common on other controllers)
enum ValueFlag : uint8_t { VAL_OK = 0, VAL_SENSOR_FAULT, VAL_OFF, VAL_UNDEFINED, VAL_OVERFLOW };

struct ParamDef {
  const char* name;
  uint16_t addr;
  uint8_t scaled;   // 1 = value / scale
  const char* desc;
};

struct ActionDef {
  const char* label;
  uint16_t addr;
  int16_t value;
};

// Register access to one Modbus controller (slave address + register map) on
// the shared RS485 bus. Used by ModbusChannel (channel.h) and the bus tools.
class Controller {
 public:
  void attach(ModbusMaster* bus, const ModbusChannelSettings& m) {
    bus_ = bus;
    m_ = m;
  }

  MbResult readRaw(uint16_t addr, int16_t& v);
  MbResult readScaled(uint16_t addr, float& v, uint8_t& flag);
  MbResult writeRaw(uint16_t addr, int16_t v);
  MbResult writeScaled(uint16_t addr, float v);
  MbResult readBlock(uint16_t addr, uint16_t n, int16_t* out, uint8_t fn = 0);

  uint8_t lastException() const { return bus_ ? bus_->lastException() : 0; }
  const ModbusChannelSettings& settings() const { return m_; }
  const RegMap& reg() const { return m_.reg; }

  static ValueFlag classify(int16_t raw);
  // a raw register value as readScaled() gives it (NaN unless the flag is VAL_OK)
  void scaled(int16_t raw, float& v, uint8_t& flag) const {
    flag = classify(raw);
    v = (flag == VAL_OK) ? raw / (m_.reg.scale > 0 ? m_.reg.scale : 1.0f) : NAN;
  }
  static const char* flagName(uint8_t f);

 private:
  ModbusMaster* bus_ = nullptr;
  ModbusChannelSettings m_{};
};

// Opens (or reopens) the RS485 bus with the common settings; no-op on a board
// without RS485 (every request then fails at once: "no answer").
void modbusBusBegin(ModbusMaster& bus, const Settings& s);

// Profile-specific extras (PMA KS 4x-1)
const ParamDef* pmaParams(int& count);
const ActionDef* pmaActions(int& count);
const char* pmaModeText(uint16_t stCntr);
