justr0st/TempCtl-Duo/src/tui_chan.cpp

// Touch UI channel settings: one tab per channel (general, Modbus controller or thermocouple +
// PID + autotune, runaway protection), the RS485 bus and (HAS_MONITOR) the monitor channel. Edits go to a copy; Save validates and
// stores it (the same rules as the web page). Register addresses and the two-point calibration
// are on the web page.
#include "tui.h"
#include "psram.h"
#include <math.h>
#include <stdio.h>
#include <string.h>
#include "local_ctrl.h"
#include "settings_store.h"

static PSRAM_VAR(Settings, E);  // edited copy
static bool eDirty = false;
static uint32_t eGen = 0;  // settingsGen() of the copy in E (a save elsewhere - web, serial - reloads it)
// control sizes (480x320 / 320x240)
// (with the monitor channel's tab four tabs share the header: narrower)
constexpr int CW = TUI_SMALL ? 128 : 200, CW2 = TUI_SMALL ? 90 : 110, BH = TUI_SMALL ? 32 : 36,
              TAB_W = TUI_SMALL ? 66 : HAS_MONITOR ? 76 : 104;
constexpr int TAB_BUS = 2, TAB_MON = 3;
static int tab = 0;  // 0, 1 = channel, 2 = bus, 3 = monitor channel
static lv_obj_t *cScr, *cTabs[4], *cBody, *cSave, *tuneLbl, *tuneRow, *tuneSw;  // (tuneSw: rule, off while tuning)

enum FKind : uint8_t { F_NUM, F_SEL, F_SW, F_HEAD, F_NOTE };
struct Field {
  FKind k;
  const char* label;
  const char* hint;
  float lo, hi;
  uint8_t dec;
  const char* unit;
  const char* opts;  // F_SEL: '\n'-separated
  float (*get)(const Settings&, int);
  void (*set)(Settings&, int, float);
  bool (*show)(const Settings&, int);
  // layout (left out: 0 / nullptr). On the 480 px screen related values share a row; the 320 px
  // screen keeps one value per row (label / hint), only the spacing applies there too.
  uint8_t lay;     // L_* below
  uint8_t w;       // 480 px: control width (0: the default)
  const char* rl;  // 480 px: row label instead of label (the first value of a shared row)
  const char* rh;  // 480 px: row hint instead of hint
  const char* pre;  // 480 px: small text right before the control (a joined value: default its label)
  bool (*en)(const Settings&, int);  // false: shown, but greyed out
};
enum : uint8_t {
  L_JOIN = 1,     // 480 px: into the row above, after its control
  L_BEFORE = 2,   // ... before its control instead
  L_GAP10 = 4,    // space above (10 px; 320 px: 5)
  L_GAP20 = 8,    // (20 px; 320 px: 10)
  L_TRIM = 16,    // whole values without ".0"
  L_COL = 32,     // 480 px: label + hint as a right-aligned column before the control (Kp, Ki, Kd)
};

static Runaway& ra(Settings& s, int c) { return s.ch[c].type == CH_LOCAL ? s.ch[c].loc.runaway : s.ch[c].mb.runaway; }
static const Runaway& ra(const Settings& s, int c) {
  return s.ch[c].type == CH_LOCAL ? s.ch[c].loc.runaway : s.ch[c].mb.runaway;
}
static bool isOn(const Settings& s, int c) { return s.ch[c].type != CH_OFF; }
static bool isMb(const Settings& s, int c) { return s.ch[c].type == CH_MODBUS; }
static bool isLoc(const Settings& s, int c) { return s.ch[c].type == CH_LOCAL; }
static bool isHostRamp(const Settings& s, int c) { return isMb(s, c) && s.ch[c].mb.rampMode == RAMP_HOST; }
static bool raOn(const Settings& s, int c) { return isOn(s, c) && ra(s, c).enable; }
static bool offOn(const Settings& s, int c) { return isOn(s, c) && ra(s, c).offEnable; }
static bool frozenOn(const Settings& s, int c) { return isOn(s, c) && ra(s, c).frozenEnable; }
static bool cjOn(const Settings& s, int c) { return isLoc(s, c) && s.ch[c].loc.cjEnable; }
static bool medOn(const Settings& s, int c) { return isLoc(s, c) && s.ch[c].loc.median; }
// local: read interval, median filter, autotune time limit
static float gReadMs(const Settings& s, int c) { return s.ch[c].loc.readMs; }
static void sReadMs(Settings& s, int c, float v) { s.ch[c].loc.readMs = (uint16_t)v; }
static float gMedian(const Settings& s, int c) { return s.ch[c].loc.median; }
static void sMedian(Settings& s, int c, float v) { s.ch[c].loc.median = v != 0; }
static float gMedianN(const Settings& s, int c) { return (s.ch[c].loc.medianN - 3) / 2; }  // 3, 5, 7, 9 -> 0 ... 3
static void sMedianN(Settings& s, int c, float v) { s.ch[c].loc.medianN = (uint8_t)(3 + 2 * (int)v); }
static float gTuneMax(const Settings& s, int c) { return s.ch[c].loc.tuneMaxMin; }
static void sTuneMax(Settings& s, int c, float v) { s.ch[c].loc.tuneMaxMin = (uint16_t)v; }
static float gTuneFast(const Settings& s, int c) { return s.ch[c].loc.tuneFast; }
static void sTuneFast(Settings& s, int c, float v) { s.ch[c].loc.tuneFast = v != 0; }

static const uint32_t BAUDS[] = {2400, 4800, 9600, 19200, 38400};

// field accessors (named functions, not lambdas: with C++11 the table could then not be a constant and
// would be built in RAM at start)
static float fg1(const Settings& s, int c) {
  (void)c;
  return (float)(s.ch[c].type);
}
static void fs2(Settings& s, int c, float v) {
  (void)c;
  s.ch[c].type = (uint8_t)v;
}
static float fg3(const Settings& s, int c) {
  (void)c;
  return (float)(s.ch[c].endAction);
}
static void fs4(Settings& s, int c, float v) {
  (void)c;
  s.ch[c].endAction = (uint8_t)v;
}
static float fg5(const Settings& s, int c) {
  (void)c;
  return (float)(s.ch[c].endSp);
}
static void fs6(Settings& s, int c, float v) {
  (void)c;
  s.ch[c].endSp = (float)v;
}
static bool fl7(const Settings& s, int c) { return isOn(s, c) && s.ch[c].endAction == END_SET_SP; }
static float fg8(const Settings& s, int c) {
  (void)c;
  return (float)(s.ch[c].spMin);
}
static void fs9(Settings& s, int c, float v) {
  (void)c;
  s.ch[c].spMin = (float)v;
}
static float fg10(const Settings& s, int c) {
  (void)c;
  return (float)(s.ch[c].spMax);
}
static void fs11(Settings& s, int c, float v) {
  (void)c;
  s.ch[c].spMax = (float)v;
}
static float fg12(const Settings& s, int c) {
  (void)c;
  return (float)(s.ch[c].mb.slaveId);
}
static void fs13(Settings& s, int c, float v) {
  (void)c;
  s.ch[c].mb.slaveId = (uint8_t)v;
}
static float fg14(const Settings& s, int c) {
  (void)c;
  return (float)(s.ch[c].mb.profile);
}
static void fl15(Settings& s, int c, float v) {  // a new type loads its register defaults
  if ((uint8_t)v != s.ch[c].mb.profile) regMapDefaults(s.ch[c].mb.reg, (uint8_t)v);
  s.ch[c].mb.profile = (uint8_t)v;
}
static float fg16(const Settings& s, int c) {
  (void)c;
  return (float)(s.ch[c].mb.rampMode);
}
static void fs17(Settings& s, int c, float v) {
  (void)c;
  s.ch[c].mb.rampMode = (uint8_t)v;
}
static float fg18(const Settings& s, int c) {
  (void)c;
  return (float)(s.ch[c].mb.minStep);
}
static void fs19(Settings& s, int c, float v) {
  (void)c;
  s.ch[c].mb.minStep = (float)v;
}
static float fg20(const Settings& s, int c) {
  (void)c;
  return (float)(s.ch[c].mb.minWriteSec);
}
static void fs21(Settings& s, int c, float v) {
  (void)c;
  s.ch[c].mb.minWriteSec = (uint16_t)v;
}
static float fg22(const Settings& s, int c) {
  (void)c;
  return (float)(s.ch[c].mb.lockFront);
}
static void fs23(Settings& s, int c, float v) {
  (void)c;
  s.ch[c].mb.lockFront = (uint8_t)v;
}
static float fg24(const Settings& s, int c) {
  (void)c;
  return (float)(s.ch[c].loc.sensor);
}
static void fs25(Settings& s, int c, float v) {
  (void)c;
  s.ch[c].loc.sensor = (uint8_t)v;
}
static float fg26(const Settings& s, int c) {
  (void)c;
  return (float)(s.ch[c].loc.calOffset);
}
static void fs27(Settings& s, int c, float v) {
  (void)c;
  s.ch[c].loc.calOffset = (float)v;
}
static float fg28(const Settings& s, int c) {
  (void)c;
  return (float)(s.ch[c].loc.calGain);
}
static void fs29(Settings& s, int c, float v) {
  (void)c;
  s.ch[c].loc.calGain = (float)v;
}
static float fg30(const Settings& s, int c) {
  (void)c;
  return (float)(s.ch[c].loc.kp);
}
static void fs31(Settings& s, int c, float v) {
  (void)c;
  s.ch[c].loc.kp = (float)v;
}
static float fg32(const Settings& s, int c) {
  (void)c;
  return (float)(s.ch[c].loc.ki);
}
static void fs33(Settings& s, int c, float v) {
  (void)c;
  s.ch[c].loc.ki = (float)v;
}
static float fg34(const Settings& s, int c) {
  (void)c;
  return (float)(s.ch[c].loc.kd);
}
static void fs35(Settings& s, int c, float v) {
  (void)c;
  s.ch[c].loc.kd = (float)v;
}
static float fg36(const Settings& s, int c) {
  (void)c;
  return (float)(s.ch[c].loc.windowSec);
}
static void fs37(Settings& s, int c, float v) {
  (void)c;
  s.ch[c].loc.windowSec = (float)v;
}
static float fg38(const Settings& s, int c) {
  (void)c;
  return (float)(s.ch[c].loc.maxOut);
}
static void fs39(Settings& s, int c, float v) {
  (void)c;
  s.ch[c].loc.maxOut = (float)v;
}
static float fg40(const Settings& s, int c) {
  (void)c;
  return (float)(s.ch[c].loc.maxTemp);
}
static void fs41(Settings& s, int c, float v) {
  (void)c;
  s.ch[c].loc.maxTemp = (float)v;
}
static float fg42(const Settings& s, int c) {
  (void)c;
  return (float)(s.ch[c].loc.cjEnable);
}
static void fs43(Settings& s, int c, float v) {
  (void)c;
  s.ch[c].loc.cjEnable = (uint8_t)v;
}
static float fg44(const Settings& s, int c) {
  (void)c;
  return (float)(s.ch[c].loc.cjMax);
}
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
