justr0st/TempCtl-Duo/(commit log)

2026-09-26 v1.2: touch UI as LVGL Pro project (LVGL 9.4), Wi-Fi popup auto-close
    - Move the touch UI to LVGL 9.4; layout is now an LVGL Pro Editor project in ui/
    - Firmware embeds ui/*.xml at build time (scripts/embed_ui_xml.py) and loads it
    with LV_USE_XML; no code export needed
    - ui.cpp: drivers, event callbacks and dialogs ported to LVGL 9
    - "Connecting" popup closes automatically once Wi-Fi has an IP
    - Round chart axis labels; boot log shows free heap
    Claude-Session: https://claude.ai/code/session_01GWrqXwfsSRtDc4faBwL8MU
2026-09-26 LVGL Pro Editor fixes: icon font, events in C, chart page preview
    - Icon font is now FontAwesome5.ttf (the editor can't load .woff);
    unused font_icons_20 removed
    - Event handlers are attached in C (UI_EVENTS table) instead of
    event_cb in the XML, so the editor no longer warns about callbacks
    - Removed send_draw_task_events / update_mode from the XML (set in C)
    - Chart page: axis numbers are switched on by the firmware; the editor
    preview aborted when scale numbers and labels were drawn together.
    Added a 320x208 editor preview size, literal series colors,
    scale main line hidden with line_opa
    Claude-Session: https://claude.ai/c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
2026-09-27 UI popups, texts and colours in XML; fix LVGL 9.4 start-up crash
    - Popups (number/text entry, dialogs, Wi-Fi list) are LVGL Pro components
    in ui/components/popups
    - All UI texts in ui/translations.xml, colours and theme in ui/globals.xml
    - scripts/patch_lvgl.py fixes an LVGL 9.4.0 bug that crashed the board at
    start-up (uninitialised parser state when registering globals.xml)
    - Arduino loop task stack raised to 24 kB for the XML UI
    - Screen renamed to ui/screens/gui.xml
    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
2026-09-27 UI popups, texts and colours in XML; fix LVGL 9.4 start-up crash
    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
2026-09-28 Colour themes, MoldControl-style web UI, Wi-Fi scan spinner
    - Touch UI colour themes: 6 palettes (Default, Dracula, Solarized, Gruvbox,
    Catppuccin, One), each dark and light, defined in ui/globals.xml and
    switchable at runtime in Setup > System (and on the web System page);
    widget colours only through named styles, recoloured by src/ui_gen.c.
    Settings v4 (theme fields), v3 settings are migrated.
    - Web UI redesigned (dark HMI style): page tiles in a sidebar (slide-in
    menu on phones), run controls on the status page, state cell and manual
    setpoint tile change colour, in-page dialogs, switches.
    - Wi-Fi scan popup opens at once with a spinner until the list is ready.
    - LVGL asserts a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
2026-09-29 TempCtl Duo 1.0.0: S3 + CYD boards, two channels, local channels
    - ESP32-S3 board (env s3): ST7796 via LVGL + DMA, own FT6336U touch driver,
    RS485 on UART1, WS2812 status LED; 1.2 UI in a corner with a bring-up panel
    - CYD variants cyd-1xlocal-1x485, cyd-2xlocal, cyd-2xlocal-2x485 (ILI9341 via
    LVGL, RGB or WS2812 status LED); pins in src/board_*.h
    - Identity TempCtl Duo 1.0.0 (src/version.h), host tempctl-duo
    - Channel interface: two Modbus channels on one bus, local channels
    (MAX31855/MAX6675, PID, SSR time proportioning, safety cut-offs, runaway
    checks), settings in /duo/settings.json, /api/config and /api/ack
    - Host tests for settings, thermocouple frames, PID and runaway
    Co-Auth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
2026-09-29 TempCtl Duo 1.0.1: PID autotune for local channels
    - Relay autotune (bias re-centring, Tyreus-Luyben rule), host-tested on
    simulated heaters
    - /api/autotune start / stop / accept / discard, progress in /api/status
    Claude-Session: https://claude.ai/code/session_015tXiaa5wiuopGBjK8Cf4Np
2026-09-30 TempCtl Duo 1.0.2: Sequence and Timeline programs, one run engine for both channels
    - Programs as JSON (/duo/progN.json, 20 slots, 3 examples), Sequence
    (B/T/BT/P phases, wait for bottom) and Timeline (two step lists)
    - Run engine for both channels: pauses, Next phase, run edits (hold,
    ramp, target), plan forecast; host-tested
    - Web API: /api/programs, /api/program (Duo JSON), /api/run
    - Old touch/web program editors read-only; guaranteed soak removed
    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
2026-09-30 TempCtl Duo 1.0.3: new web Status page for both channels (step 7a)
    - New page at / from the 9.3 simulator: run panel, chart with state
    lanes, events and forecast, channel cards, Action required, event log
    - Barlow fonts served by the device; page gzipped into the firmware
    (tools/web_embed.py runs before each build)
    - API: /api/live, /api/chart, /api/log; run engine reports transitions
    - TempCtl 1.2 page moved to /old
    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
2026-09-30 TempCtl Duo 1.0.4: fix missing numbers in the web API, thermocouple spike filter
    - Numbers set through setNum() were dropped from /api/live and
    /api/status (ArduinoJson member proxy); PV, SP and output show again
    - Local channels: median of the last 3 thermocouple readings
    - Event log: boot entry with reset reason, link changes, autotune results
    - S3 wiring diagram (claude/wiring/s3-wiring.png)
    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
2026-10-01 TempCtl Duo 1.0.5: program editor on the web page (step 7b)
    - Sequence / Timeline tables and drag handles on the chart (target,
    ramp end, hold end); drafts with Save / Discard / Undo / Redo
    - Start with unsaved changes: save and start or start without saving
    - Edits during a run go to the running copy (targets, ramps, holds)
    - Spec: polling interval as a touch / web setting
    - Status LED: fault breathes magenta for now
    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
2026-10-01 TempCtl Duo 1.0.6: fault LED back to red blinking
    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
2026-10-01 TempCtl Duo 1.0.7: build fix for ArduinoJson 7.4
    The JSON number helper in the web server took ArduinoJson member proxies
    by value; ArduinoJson 7.4 makes them non-copyable. It now takes them by
    reference and writes with set().
    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
2026-10-01 TempCtl Duo 1.0.8: Programs, Channels, System and Tools web pages (step 7c)
    - Programs: slot list with open, new, duplicate, export, import, delete
    - Channels: polling interval and bus, per-channel settings (Modbus incl.
    register map and PMA parameters; local incl. two-point calibration,
    PID and autotune), runaway limits
    - System: device info, restart, Wi-Fi with network scan, display/accent
    - Tools: Modbus register tools, settings and programs backup/restore
    - API: /api/wifiscan, /api/restart, config limits + loadDefaults,
    cfgGen and autotune details in /api/live
    - TempCtl 1.2 page (/old) and /api/settings removed
    Claude-Session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
2026-10-01 TempCtl Duo 1.0.9: program list names, faster page refresh, Wi-Fi reconnect
    - Program dropdown shows the names of all stored programs (not only the
    ones opened before)
    - The page polls at the polling interval (250 ms .. 1 s) and draws the
    newest temperature at the end of the chart
    - A new Wi-Fi network / password is joined without a restart (connect a
    moment after the disconnect; retry while not connected)
    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
2026-10-01 TempCtl Duo 1.0.10: fixed IP address, show password button
    - Wi-Fi: optional fixed IP address (IP, subnet mask, gateway, DNS) on
    the System page; invalid combinations are rejected (back to DHCP)
    - Show / hide button in the Wi-Fi and access point password fields
    - ArduinoJson pinned to 7.3 or newer
    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
2026-10-01 TempCtl Duo 1.0.12: updated logo, clearer chart state lanes
    - Logo files updated; web icons regenerated from them
    - Chart: state-lane names in the channel colours, separator line below
    the lanes, more space above the temperature axis
    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
2026-10-01 TempCtl Duo 1.0.13: theme switch, brightness slider, tile layout
    - Light/dark switch with sun/moon knob for the web page (sidebar) and the
    touch screen theme; theme changes fade
    - Thick brightness slider on the System page
    - Settings tiles fill the free space next to taller tiles
    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
2026-10-01 TempCtl Duo 1.0.14: display settings apply instantly
    - System page display settings (accent, theme, brightness, rotation) are
    saved and applied on change; no Save button
    - Touch screen brightness follows the web slider while it is dragged
    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
2026-10-01 TempCtl Duo 1.0.15: CYD runs again (RAM), touch fix
    - CYD (no PSRAM) ran out of RAM: boot crash, stalled web answers,
    Wi-Fi scan crash. Less RAM use: chart history as 0.1 degC values (IRAM
    heap on the CYD), program buffers only while needed, smaller loop and
    control stacks, one draw buffer, shorter event log, page without web
    fonts on the CYD; RS485 starts before UI and Wi-Fi
    - Web answers written non-blocking; a stuck connection is dropped after
    5 s instead of blocking the loop
    - Touch: points were rotated twice by LVGL (off screen on the CYD)
    - Wi-Fi modem sleep off; Wi-Fi events, DRAM and stack figures in the log
    - /api/history removed (old page only)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
2026-10-01 TempCtl Duo 1.0.16: chart shows every reading's peaks and dips
    - Each chart slot keeps the lowest and highest reading (live and run);
    the line passes through both, so short peaks and dips are visible
    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
2026-10-02 TempCtl Duo 1.0.18: run interrupted by a reset, live chart series switches
    - "Run interrupted by a reset": running copy and position kept in flash and
    RTC memory; after a restart the channels stay off and the web page offers
    Resume (Sequence: the interrupted phase again; Timeline: at the run time)
    or Dismiss
    - History and chart record a setpoint only while it is active
    - Live chart: PV / SP per channel can be switched off (chart, scale, CSV
    export with only those columns)
    - Event log on the page reloads after a device restart
    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
2026-10-08 1.0.19: new touch UI for the S3 (step 6)
    - Hand-written LVGL screens: main screen with chart, channel tiles, stepper,
    manual button and run controls; overlays on every screen
    - Program list and table editor (Sequence / Timeline, undo, run edits)
    - Channels, Network, Display, System and Event log settings on touch
    - Barlow fonts generated by tools/lv_font_gen.py
    - Touch chart keeps every point (per-pixel min/max) and shows PV peaks
    - PC host harness in test/ui_host for screenshots and random-tap tests
    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
2026-10-08 1.0.20: end action to manual mode, resume keeps ramp speed, LVGL in PSRAM
    - Keep / end setpoint at program end continues as manual mode
    - Resumed ramps keep their planned speed; Timeline holds absorb the difference
    - Orderly restart with its reason logged (touch / web)
    - Touch fixes: title after a run, stepper 5 degC steps when held, dialogs,
    message position, autotune status, keyboard close, Display follows web
    - Charts: SP filled and at half strength, 1 min live period
    - Modbus marked as beta
    - S3: LVGL memory and the touch chart data in PSRAM
    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
2026-10-08 1.0.21: new touch UI on the CYD (step 6, 320x240)
    - One touch UI code for both boards; compact 320x240 set on the CYD:
    SP button per channel, run buttons and menu in a bottom bar
    - Sequence editor: one line per phase, tap opens its values and actions;
    Timeline editor: one table with a channel switch
    - CYD RAM: only the main screen stays built, editor memory freed on leave,
    2 undo steps; the old exported UI is no longer built
    - System info shows internal RAM free and its lowest point
    - PC harness: CYD build, screenshot sheets, heap per screen
    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
2026-10-09 1.0.22: serial console (step 8, part 1), CYD colour order
    - Serial commands: status, manual setpoint, Wi-Fi scan/connect/AP,
    programs, run control, run edits, reboot (S3: native USB port, CYD:
    shared with the log; log lines don't break typed input)
    - CYD panel is RGB: red and blue were swapped on the touch screen
    - Restart delay and touch UI timers could fire early (time stamp 1 ms ahead)
    - PC test for the console (test/console_host)
    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
2026-10-09 1.0.23: serial console commands, touch calibration
    - help in sections, help settings with all settings and examples
    - get / set for all settings (API keys, b. / t. channels), factory reset
    - watch, info, log, ack, tune (autotune), wifi forget
    - touch cal: 4-point touch calibration on the CYD
    - full restart reason kept (was cut to 19 characters)
    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
2026-10-09 1.0.24: custom accent colour, screen restart, console history
    - custom accent colour: colour picker on the web page, hue / saturation /
    brightness dialog on the touch screen
    - restart of the display and touch controller without a device restart
    (web System page, serial "screen restart")
    - serial console: Up / Down keys recall the last commands
    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
2026-10-09 1.0.25: automatic screen check
    - display state read back over MISO every second (power, MADCTL, pixel
    format); a display that lost its setup is set up again by itself
    - S3 touch controller asked every second, restarted when it does not answer
    - touch press stuck in one place for a minute: touch controller restarted
    - setting "Screen check" (web, touch screen, display.screenCheck), on by
    default; serial "screen check" shows the state
    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
2026-10-10 1.0.27: Web Serial page and local app with tabs
    - the page works over USB (Web Serial, serial api mode) with a connect
    screen when it is not served by a device; reconnects by itself
    - local app (tools/launcher, Go): serves the page on localhost:8765 and
    opens it as an app window; tabs with one device each (USB or Wi-Fi),
    restored at the next start
    - device search on the network (mDNS); devices announce _tempctl._tcp
    - Disconnect for a device opened over Wi-Fi in a tab
    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
2026-10-10 1.0.28: old touch UI removed
    - the LVGL Pro Editor project (ui/), src/ui.cpp, src/ui_gen.* and the
    legacy program view (src/program.*): unused since 1.0.21
    - UI_V2 switch and the old palette functions gone; README cleaned up
    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
2026-10-11 1.0.30: system log on the web System page, stricter screen check
    - Full scrollable System log: every event and serial log line, colour-coded
    (technical, event, program run, warning, error), with filters, search and
    download. Events are saved to flash and survive restarts.
    - Wall clock via NTP (or set by the web page) for log timestamps.
    - Screen check compares more display registers with their values after init;
    manual screen restarts are logged with the display/touch state before.
    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
2026-10-12 1.0.31: highlight channel tiles while the outputs are on
    - Touch main screen and web channel cards: 4 px border and a 20 % tint in
    the channel colour while the channel's outputs are on (outOn in the API).
    - Web: the manual switch turns manual mode off at once (no question); the
    orange manual ring on the card is gone.
    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
2026-10-12 1.0.36: SD run logs, Convert to Timeline, time zone, crash breadcrumbs
    - S3: one CSV per program run on the display's SD card (1 s rows + events),
    list / download / delete on the System page. All card work in its own
    task; rows are kept until written (retries), card mounted only while used.
    - Web editor: Convert to Timeline (replace or new program, waits dropped).
    - Time zone (from the browser, settable on web, touch, serial): local time
    in the run logs.
    - "Run changed" question closes everywhere when answered anywhere; web SP
    chart follows every poll.
    - Breadcrumbs in RTC memory: after a watchdog / crash the log tells what the
    loop, control task and SD card were doing.
    Co-Authore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
2026-10-13 1.0.37: SSR supply relay, sidebar run controls, Log and Settings pages
    - S3: relay on GPIO 4 in the common +5 V supply of the SSRs: on while local
    outputs are on, off at once on any local fault; level selectable.
    - Web: run and channel controls in the sidebar on every page; Log page (SD
    run logs, system log); System renamed Settings; export / back buttons for
    the last run; jump buttons only in the one-column layout.
    - Blinking fault badge on channel tiles (touch) and cards (web) until the
    fault is acknowledged.
    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
2026-10-13 1.0.38: protections, safety settings, Dashboard / Channels page rework, S3 schematic
    - Protections: heating while off, frozen reading, converter too hot (per channel), manual-mode
    timeout, E-stop input (GPIO5), alarm sound (S3 GPIO6, CYD speaker), S3 chip temperature
    warning, start temperature warning; settings on web, touch and serial
    - SSR supply relay: only an active-high DC SSR driven directly by GPIO4 (level setting removed)
    - Web: Status renamed Dashboard, Settings jump buttons and Safety tile, Channels page with
    channel tabs, section lines, autotune in PID control, RS485 bus in the Modbus channel tile
    - S3 wiring updated (relay, E-stop, buzzer); KiCad schematic in hardware/s3-sc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
2026-10-13 1.0.39: firmware update without USB, SSR supply relay switch, CYD schematics
    - Firmware update: web upload (S3 + CYD, drag and drop), firmware.bin from the SD card (S3),
    image check (board / chip / version) and rollback if the new firmware does not run
    - CYD: OTA partition table (two firmware slots; erases settings and programs once)
    - SSR supply relay: on / off switch in the safety settings, removed from the Channels page
    - CYD KiCad schematics for the three wirings, speaker on P4 in the wiring pictures;
    shared schematic generator in hardware/gen
    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
2026-10-14 1.0.41: web chart draws every reading
    - The device keeps every PV reading of the polling (S3: 131 072 per channel in PSRAM,
    CYD: 600) and serves them over GET /api/raw; run time anchors map them onto the run chart
    - The web page fetches only new readings each poll and draws each one, live view and run;
    more readings than pixels: first / lowest / highest / last per pixel column
    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
2026-10-14 1.0.43: fast SD firmware check, touch gap filter, schematic ERC fixes
    - Firmware check on the SD card runs in the background; the image id now
    sits near the start of the file, so the check reads only the first block
    - Touch (S3): short "no point" gaps in a held touch are bridged; INT line used
    - Schematics: tri-state MAX31855 SO / display SDO, power symbols in the
    project library (KiCad 10 ERC clean)
    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
2026-10-14 1.0.46: backlight PWM 20 kHz, current spec in the repo
    - Backlight (and the CYD's status LED, same LEDC timer) at 20 kHz instead of 5 kHz
    - claude/tempctl-duo-spec.md is the current spec again; docs/SPEC.md points to it
    - .old/ for old local files (ignored)
    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
2026-10-14 1.0.48: code review fixes - POST header and Host check, atomic saves, less RAM
    - Every POST needs the header X-TempCtl: 1 and the Host header must be
    the device (IP, host name, local suffixes): other web pages can no
    longer switch anything (CSRF, DNS rebinding)
    - Programs, run file and settings are replaced by rename; a .tmp left by
    a cut-off save is restored at boot
    - Modbus tool waits feed the watchdog; find-SP scans at most 20 s
    - CYD: about 6 kB less static RAM (shared UI snapshot, heap copies of
    the settings while a web handler runs)
    - Charts: S3 24 h live view kept incrementally, live chart JSON built
    outside the lock, integer number formatting
    - System log reads keep their p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
2026-10-15 1.0.49: settings page fix, background Modbus tools, touch setpoint stepper
    - Fix: the web settings and backups could show scrambled texts: texts
    are copied into JSON answers (ArduinoJson keeps const char arrays as
    pointers); SD backups no longer give every program the last one's name
    - Touch +/- keeps the new setpoint until the device has it (no jump back,
    no lost presses)
    - Dashboard chart: "Last run" button on the program preview
    - Find-setpoint and PMA parameter reads run in the background, the page
    polls; Modbus waits yield; PV, SP and output read in one request
    - Live poll carries the new PV readings (one request per poll); the web
    chart redraws only the parts that changed
    - L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
2026-10-19 1.0.50: touch Channels screen follows web saves, SD mount retry
    - Touch Channels screen: shows settings saved on the web or serial while
    nothing is edited, keeps its scroll position after a change, and shows
    the RS485 tab only while a channel is a Modbus channel
    - SD card: the mount is tried once more after any failure
    - Web Channels page: the sticky Save / Revert bar reaches the card edges
    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
2026-10-19 1.0.51: read interval, median filter and autotune limit settings, autotune controls, live view first, chart hover, CSV replay page
    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
2026-10-20 1.0.54: faster touch drawing (chart as a cached picture with own raster, S3 SIMD fills), frame rate meter, display SPI clock setting
    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
2026-10-21 1.0.56: README rewritten for the current state
    Reordered sections; intro with both boards and channel types (local tested,
    Modbus beta); full-image flashing from the release page; touch paths as in
    the menus; manual setpoint for both channel types; project layout with the
    new files; status section.
    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
2026-10-21 1.0.57: wiki with wiring diagrams and screenshots
    docs/wiki: 15 pages (getting started, S3 / CYD hardware, touch screen, web
    page, programs, channels, safety, updates, desktop app, serial console,
    troubleshooting, Modbus, development). Wiring SVGs and dark / light
    screenshots made by tools/wiki/make_shots.sh (UI host, Playwright against a
    demo device driven by the firmware's run engine). The hosted page renders
    the wiki under /wiki/ (tools/wiki_site.py); the web page and README link it.
    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
2026-10-22 1.0.59: browser demo, glass flicker fix, touch check retries
    - Browser demo (/demo/ on the release page): the firmware's control code built
    for WebAssembly with simulated hardware (1100 W bottom, 450 W top heater, GPU
    board); speed 1x-10x, faults, settings kept in the browser. "Try the demo"
    card on the connect screen, wiki page, release workflow builds it (demo/).
    - Web page: no more flickering bands in the sidebar and channel cards.
    - Touch screen check: retries before a restart, failed reads logged with reason.
    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
2026-10-27 1.0.60: monitor channel, top Idle in Both phases, autotune rule switch
    - Monitor channel (S3, CS GPIO 3): a third thermocouple, measured and logged
    only - chart line and legend value, sidebar row, Channels tab, touch chart
    value and tab, CSV / SD logs, monitor.* settings; demo "Board edge"
    - Program editor: the top channel can be Idle in a Both phase
    - Autotune: "Slow, no overshoot" / "Faster" rule switch (local.tuneFast)
    - Web: channel tabs without gaps, no reflow when the scrollbar comes and
    goes, desktop glass without live blur (no flicker), pause text saved
    - Demo: "TempCtl Duo DEMO" title and badge, Demo button outline and glow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
2026-10-27 1.0.61: both channels Idle, Wi-Fi off, touch settings from Rost's design
    - Both phase can switch both channels off for the hold time
    - Wi-Fi can be switched off completely (no AP, no connection, no scan)
    - Touch Channels / System screens reorganized after the Claude Design
    - Web page no longer jumps while editing a program; touch editor: 0 degC = off
    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
2026-10-28 1.0.62: CYD Channels page no longer runs out of memory
    - The page being left is deleted before the next one is built
    - Channels page 51 -> 38 kB on the CYD (shared styles, single-label value buttons, no row objects)
    - A page is only built with enough free RAM, otherwise a message instead of a crash
    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
2026-10-28 1.0.63: setpoint margin below the cut-off as a setting, cleared number entry is 0
    - Setpoint margin below the cut-off (default 10 degC) is a general setting: touch, web, serial
    - A cleared number pad entry is accepted as 0
    - Modbus write limits share one row on the S3
    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
2026-10-28 1.0.65: MIT License, shorter README, developer reference in the wiki
    - MIT License with third-party notices
    - README rewritten: main features, screenshots, wiring; reference parts moved to the wiki (Web API, How it works inside)
    - Schematic PDFs linked from the wiki hardware pages
    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
2026-10-28 1.0.66: release page on GitHub Pages, GitHub releases
    - Release page moves to https://justr0st.github.io/TempCtl-Duo/ (page, wiki and demo work from a subfolder)
    - Each new version also becomes a GitHub release with the firmware images and desktop apps
    - Firmware and web page look for updates there; Cloudflare stays updated for older devices
    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
2026-11-12 1.0.67: feed-forward on the local channels (ramp tracking, phase A)
    Setpoint preview from the run engine, heater model (K, tau, dead time) from the
    autotune, settings local.ff / ffK / ffTau / ffDead on touch, web and serial.
2026-11-13 1.0.68: optional pins with a cooling fan, buzzer tones, bad-reading filter, run report, Wi-Fi fixes
    - Optional pins GPIO 4/5/6 on the S3 (relay, E-stop, buzzer, fan, fan PWM, fan speed); fan option per phase / step
    - Buzzer tones, volume, key beep; run report; QR codes on the touch Network page
    - Bad-reading filter (jumps, converter faults) and a control-task heartbeat
    - Wi-Fi off no longer crashes at boot; the access point closes after the station connects
    - Tests and flash size gate in GitHub Actions; app_state.cpp and the web page split into parts
